Zykbyk/VACLAV/1. Zawieszenie/11. Kinematyka/Informacje/Zalety i wady większych felg i opon.jpg

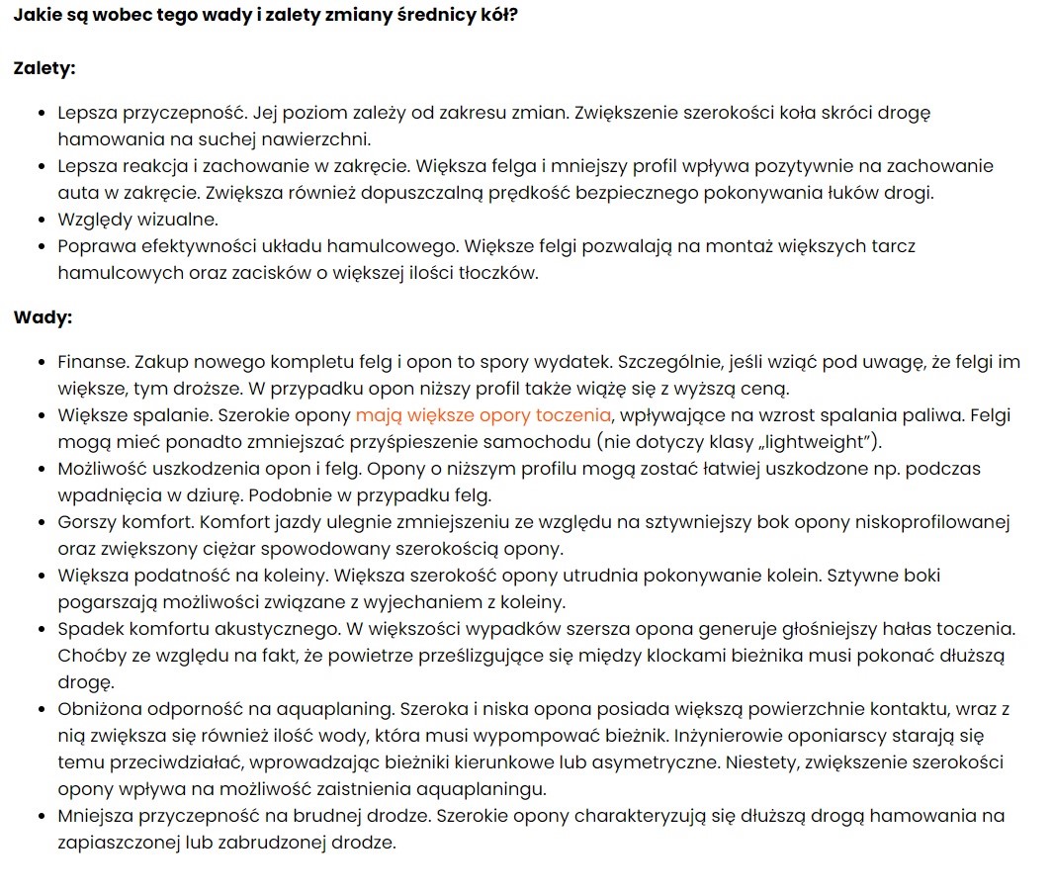
1. Zawieszenie/11. Kinematyka/Informacje/Zalety i wady większych felg i opon.jpg
