Zykbyk/VACLAV/1. Zawieszenie/11. Kinematyka/Informacje/Zbieżność.jpg

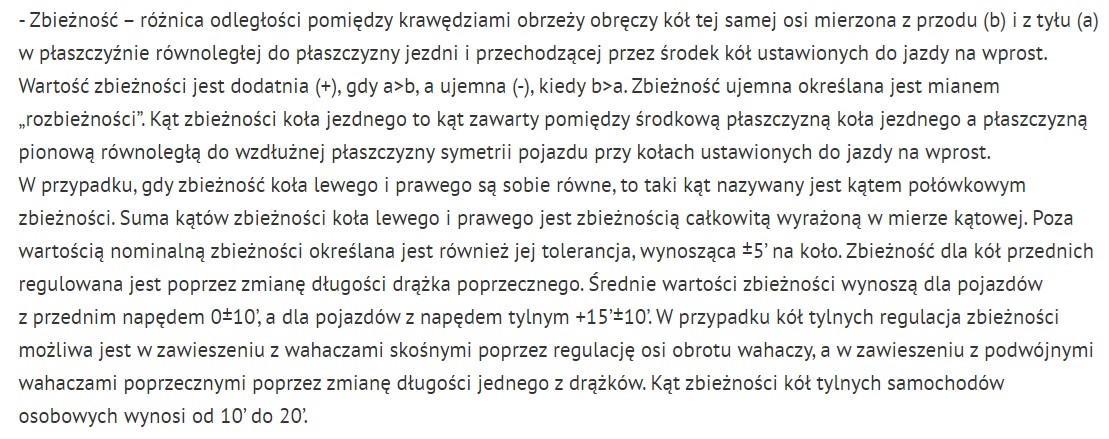
1. Zawieszenie/11. Kinematyka/Informacje/Zbieżność.jpg
