Zykbyk/VACLAV/10. Zgredek/_Archiwum/stara wersja (wahacze)/2023_10_04_Zawieszenie przód/Zawieszenie/Notatka.docx

https://allegro.pl/oferta/wahacz-przedni-dolny-gorny-prawy-lewy-quad-bashan-11277689814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

https://maxmoto.pl/produkt/61777-amortyzator-do-quada-atv-110cc-270mm-7mm
