Zykbyk/VACLAV/0. Instrukcje i inne ważne pliki/Dokumentacja KLARA/Załączniki/Podzespoły elektryczne/BatteryTechReport.pdf

# Battery Technical Report

Manufacturer’s battery specification sheet and Material Safety Data Sheet are in document: samsung-35e-datasheet-inr18650-35e.pdf

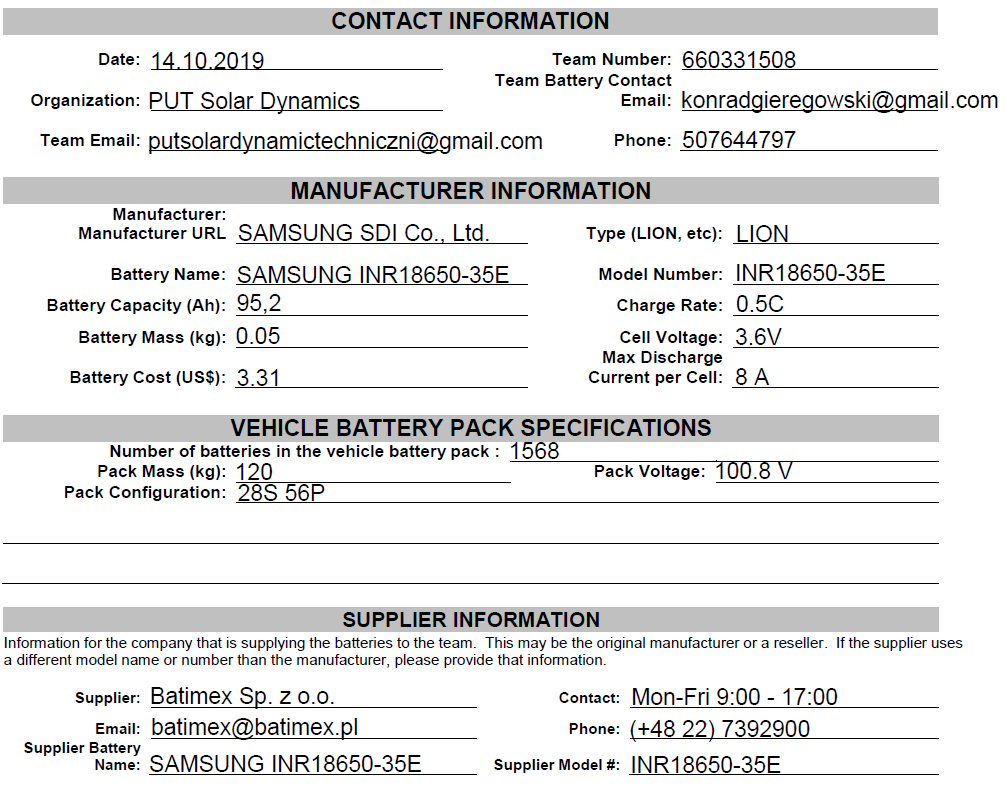
[picture p7: figure]

External layer made of steel, inner layer is a 1,5 cm thickness non-flammable and chemical resistive rubber protecting battery from each side. This rubber is hard material and will not flex under the pressure of the battery.

Car body is made from composite which is insulator so mounting metal battery enclosure to it with screws and nuts is safe.

Supplemental Battery is 12 V VRLA battery.

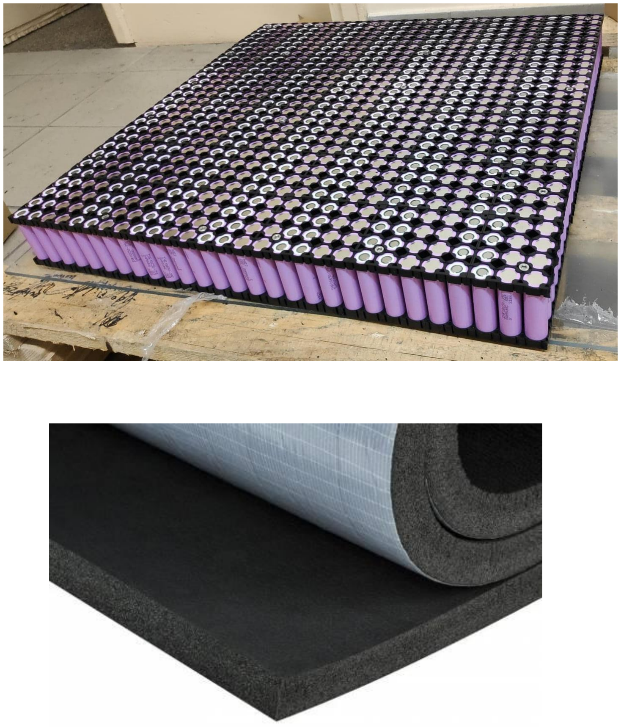
[picture p8: page 2]

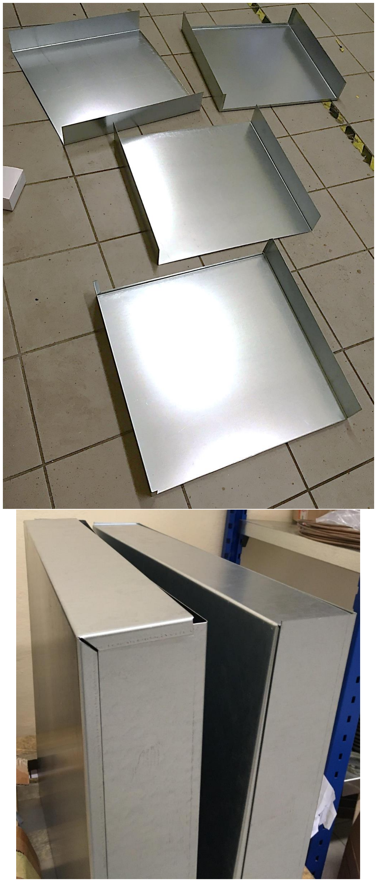
[picture p9: figure]
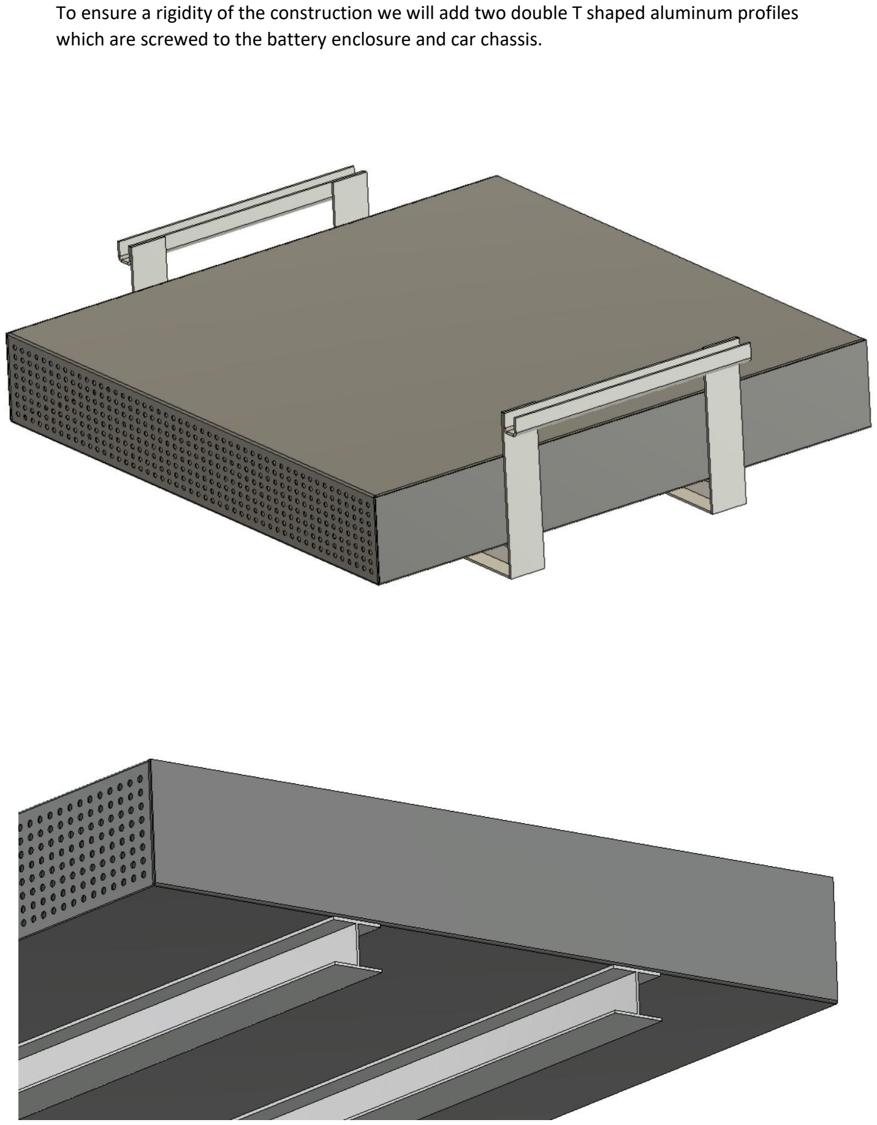
[picture p10: page 4]

To ensure a rigidity of the construction we will add two double T shaped aluminum profiles which are screwed to the battery enclosure and car chassis.
