Zykbyk/VACLAV/0. Instrukcje i inne ważne pliki/Tematy na prezentacje.pdf

Tematy do opracowania:

- Racing car basics:
- Środek masy
- Przeniesienie obciążenia
- Przypadek hamowania
- Omówić jakiś przykład obliczeń
- Skręcanie, siła dośrodkowa
- Racing car design issues
- Tyres:
- Rodzaje opon
- Budowa opony
- Nadsterowność
- Podsterowność
- Co to camber
- Brakes:
- Budowa układu hamulcowego
- Działanie układu hamulcowego
- Procedura projektowania
- Omówić przykład obliczeń
- Co to dive
