Zykbyk/VACLAV/1. Zawieszenie/11. Kinematyka/Kinematyka - obliczenia 31.xlsx

Sheet: 40%-60%
 | DANE
 | MASA AUTA [kg] | ROZSTAW OSI [m] | DŁUGOŚĆ AUTA [m] | ROZSTAW KÓŁ [m] | SZEROKOŚĆ AUTA [m] | PROMIEŃ SKRĘTU [m] | PRZEŚWIT MIĘDZY BRZUCHEM A ZIEMIĄ [m]
 | 400 | 2.6 | 4.2 | 1.5 | 1.75 | 7 | 0.125
 | KĄT ACKERMANA
Promień zawracania | R s [m] | 7 |  | 7.5 | 6.5 | 6 | 5.5 | 5
Średnica zawracania | D s [m] | 14 |  | 15 | 13 | 12 | 11 | 10
Promień zataczania -10mm | rσ [m] | -0.01 |  | -0.01 | -0.01 | -0.01 | -0.01 | -0.01
 | R s - rσ [m] | 7.01 |  | 7.51 | 6.51 | 6.01 | 5.51 | 5.01
 | sin δA,o | 0.37 |  | 0.35 | 0.40 | 0.43 | 0.47 | 0.52
 | δA,o [rad] | 0.38 |  | 0.35 | 0.41 | 0.45 | 0.49 | 0.55
Kąt Ackermana | δA,o [st] | 21.77 |  | 20.26 | 23.54 | 25.63 | 28.16 | 31.26
 | ctg δA,o | 2.50 |  | 2.71 | 2.30 | 2.08 | 1.87 | 1.65
 | ctg δi | 1.92 |  | 2.13 | 1.71 | 1.50 | 1.28 | 1.06
 | δi [rad] | 0.48 |  | 0.44 | 0.53 | 0.59 | 0.66 | 0.76
Kąt skrętu koła wewnętrznego | δi [st] | 27.52 |  | 25.20 | 30.31 | 33.70 | 37.92 | 43.26
Różnica kątów | ΔδA [st] | 5.75 |  | 4.94 | 6.77 | 8.07 | 9.76 | 12.00
Szerokość opony | B [m] | 0.185 |  | 0.185 | 0.185 | 0.185 | 0.185 | 0.185
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
