Zykbyk/VACLAV/1. Zawieszenie/11. Kinematyka/Informacje/Zużycie opon.pdf

# ZUŻYCIE OPON

NORMALNE

Występuje, gdy guma zużywa się w sposób jednolity, na całej szerokości i obwodzie.

NIESYMETRYCZNE (JEDNOSTRONNE)

Obserwuje się, gdy jedna strona bieżnika ściera się bardziej od drugiej, co wynika z nieprawidłowej zbieżności kół. Z biegiem czasu mogą narastać odchylenia od standardowych wartości, na przykład na skutek agresywnego wjeżdżania na krawężniki.

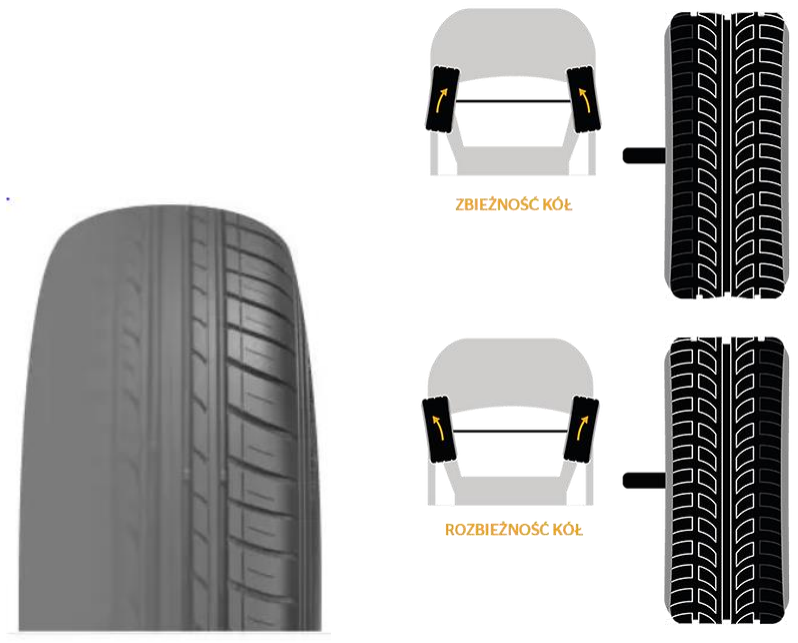
[picture p21: figure]

WKLĘSŁE

Dotyczy środka bieżnika, jest efektem jazdy na oponach ze zbyt dużym ciśnieniem. (https://www.opony.com.pl/artykul/zbyt-wysokie-cisnienie-w-oponach-szkodzi/?id=1139) Strefa kontaktu ograniczona jest do środkowej części bieżnika, co powoduje szybkie zużycie tej strefy. Może być to spowodowane np. nagłym hamowaniem na zablokowanych kołach w przypadku samochodów niewyposażonych w ABS (https://www.oponeo.pl/artykul/co-to-jest-abs) lub problemami z jakością danej opony. Taką postać zużycia spotyka się w kołach osi napędowej samochodów z mocnym silnikiem. Objawia się często przy energicznym przyspieszaniu i agresywnym stylu jazdy.

OKRĄGŁE

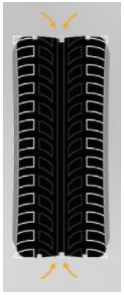
[picture p22: figure]
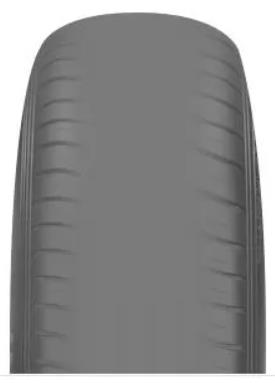
[picture p23: figure]

Okrągłe zużycie dotyczy barków i zachodzi, gdy wysokość bieżnika na środku jest wyższa, niż na barkach. Ten rodzaj zużycia wynika zazwyczaj z długiego czasu użytkowania opony, która posiadała zbyt niskie ciśnienie przy zbyt dużym obciążeniu. W takim przypadku ugina się czoło opony, a barki zaczynają przejmować obciążenie, co prowadzi do ich szybkiego starcia. Powodem takiego stanu rzeczy może być też zbyt agresywny styl jazdy, szczególnie szybkie pokonywanie zakrętów.

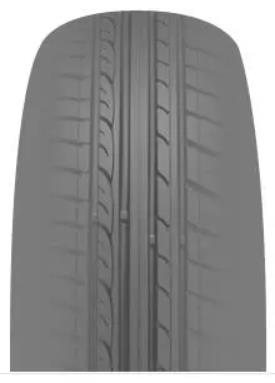
[picture p24: figure]

### Ciśnienie a zużycie opony

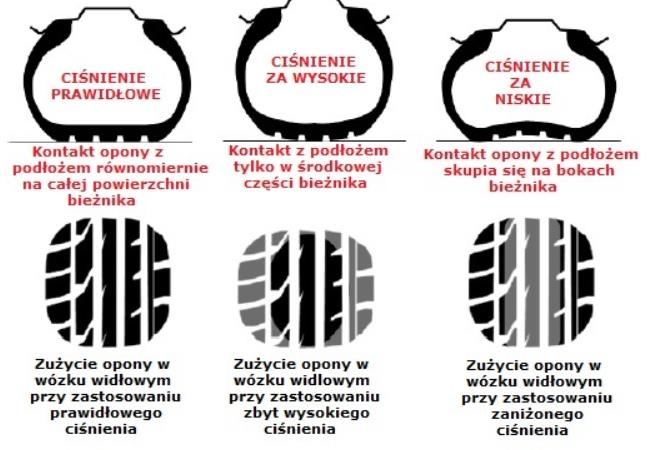
[picture p25: figure]

MIEJSCOWE

Miejscowe zużycie opony często jest efektem gwałtownych manewrów np. hamowania. W takich przypadkach szybko zużywa się fragment obwodu opony.

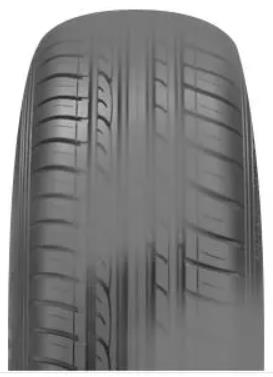
[picture p26: figure]

ZĄBKOWANE

Wiele opon nosi ślady zużycia ząbkowanego, wynikającego z nierównomiernego ścierania się klocków bieżnika. Ten rodzaj zużycia jest charakterystyczny dla tylnej osi samochodów a wynika ze zmian nacisków i pracy bieżnika w czasie jazdy oraz pokonywania zakrętów. Zajście zużycia ząbkowanego jest w zasadzie nieuniknione, ale jego natężenie zależy od kilku czynników:

- Od dopasowania opony do danego modelu samochodu o konkretnym typie zawieszenia
- Od obciążenia pojazdu i ciśnienia w oponach
- Od niekompatybilnych indeksów nośności i prędkości
- Od stanu technicznego zawieszenia
- Zbieżność i kąt pochylenia kół

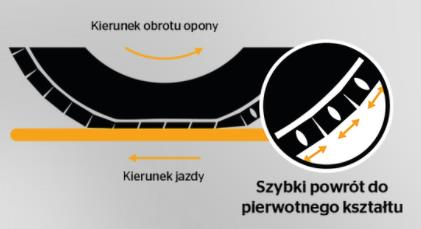
[picture p27: figure]
