Zykbyk/VACLAV/1. Zawieszenie/11. Kinematyka/Informacje/Prezentacja 2 Slip.pdf

# Vehicle Dynamics

# Modelling and Simulation

## CHAPTER 10.1

# Liniowy model jednośladowy

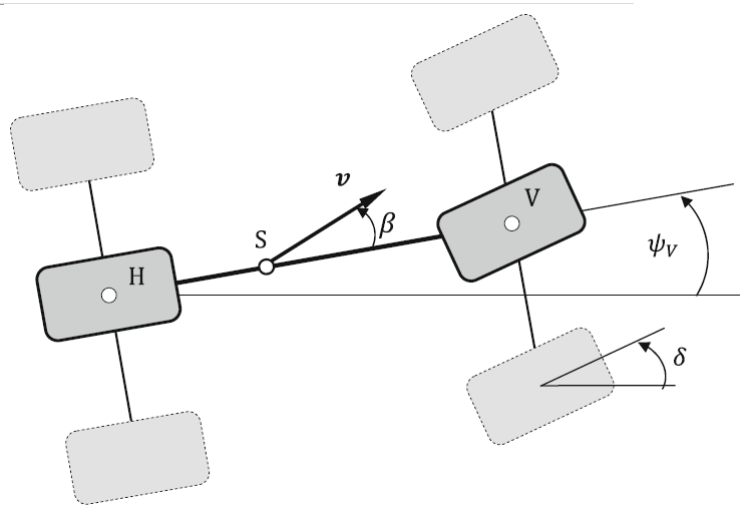
[picture p33: figure]

Stała prędkość środka ciężkości

Ruch toczny pominięty

Masa w środku ciężkości

Przednie i tyle opony jako jedna opona na środku każdej z osi

Moment obrotowy wynikający z kąta poślizgu pominięty

Siły wzdłużne w oponach pominięte

# Zależności

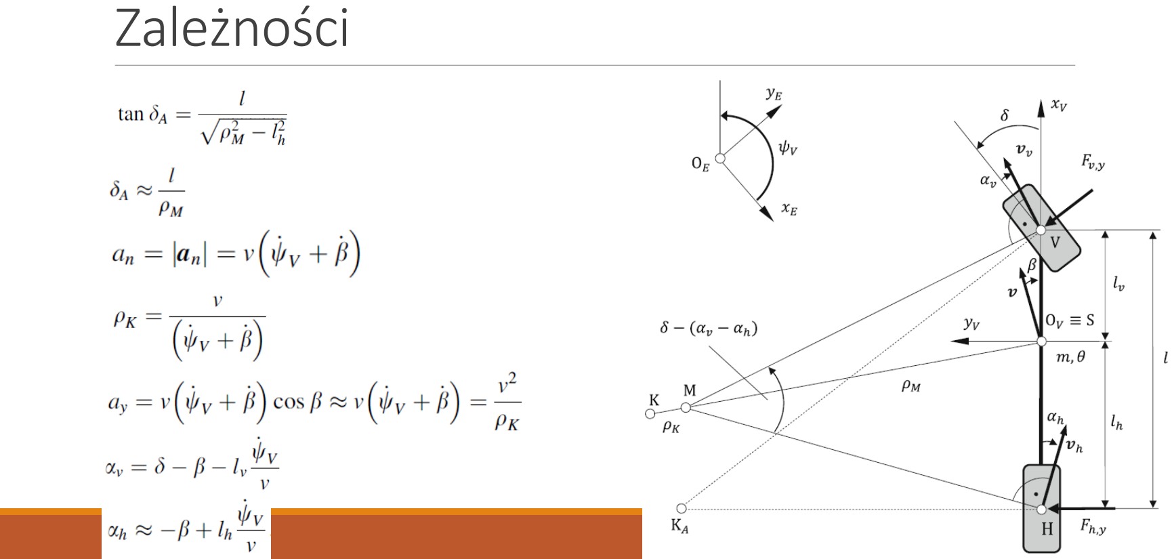
[picture p34: page 3]

# Obciążenia opon

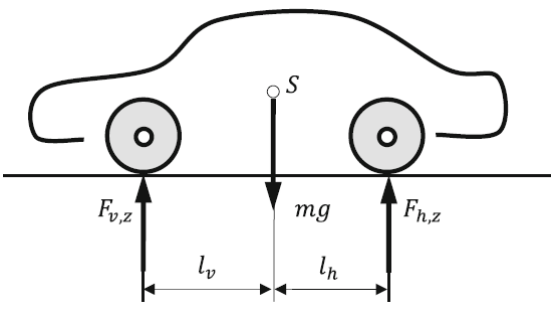
[picture p35: figure]

# Równania ruchu modelu

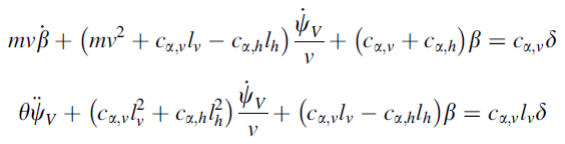
[picture p36: figure]

# Pokonywanie zakrętów

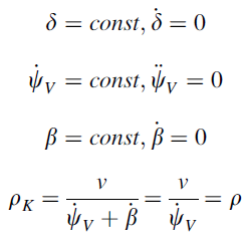
[picture p37: figure]

# Sterowność

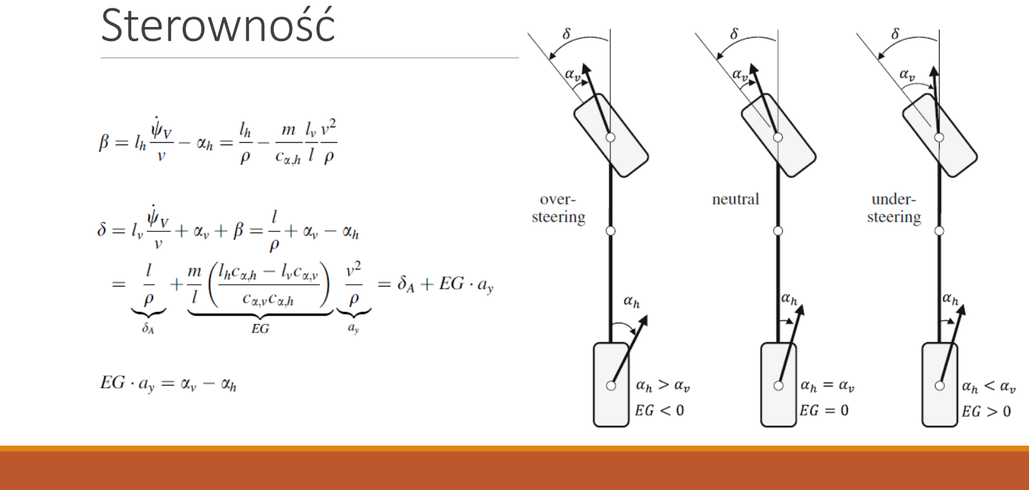
[picture p38: page 7]

# Zależności

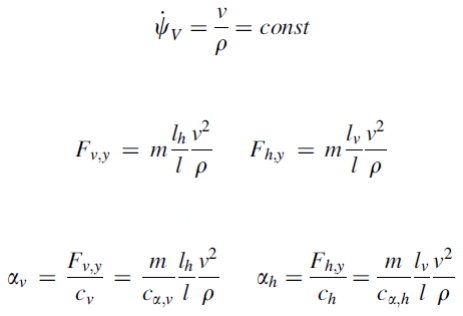
[picture p39: figure]
