Zykbyk/VACLAV/1. Zawieszenie/11. Kinematyka/Informacje/Racing car basics Prezentacja 1.pdf

# Kinematyka

Autorzy:
Tomasz Cichowski
Piotr Dzioba

# Rozstaw osi

- Mierzony od środka osi przedniej do środka osi tylnej
- Większy rozstaw osi w stosunku do długości pojazdu:

☐ więcej miejsca dla pasażerów

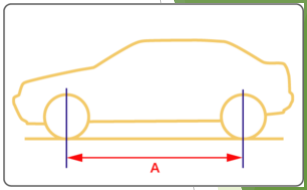
[picture p40: figure]

☐ mniejszy jest przy tym wpływ zmian obciążenia na rozkład masy przypadającej na
| poszczególne osie

☐ mniejszy jest przedni i tylny zwis nadwozia

☐ mniejsza tendencja do przechyłów wzdłużnych

☐ możliwe zastosowanie bardziej miękkiego zawieszenia w celu zwiększenia
| komfortu jazdy
- Mniejszy rozstaw osi poprawia zwrotność – przy takim samym kącie skrętu kół uzyskuje się mniejszy promień skrętu

# Rozstaw osi

- Dąży się do uzyskania większego rozstawu osi
- Zależne jest to od formy nadwozia
- Samochód o nadwoziu kombilimuzyny z pochyłą ścianą tylną – bardziej zwarta budowa i może mieć większy rozstaw osi w stosunku do swej długości niż samochód o nadwoziu sedan lub pochodnym od niego kombi
- Parametr porównawczy il

il =

rozstaw osi
długość pojazdu
- Powinien być jak największy i wynosić:

☐ 0,57 do 0,67 dla samochodów typu kombilimuzyna

☐ 0,56 do 0,61 dla samochodów typu sedan
- Dla nadwozia typu coupé il może być nawet mniejsze od 0,56
- Dla samochodów małych il osiąga wartości do 0,72
- Wartości rozstawu osi mieszczą się zwykle w przedziale l = 2160 do 3040 mm

# Rozstaw kół

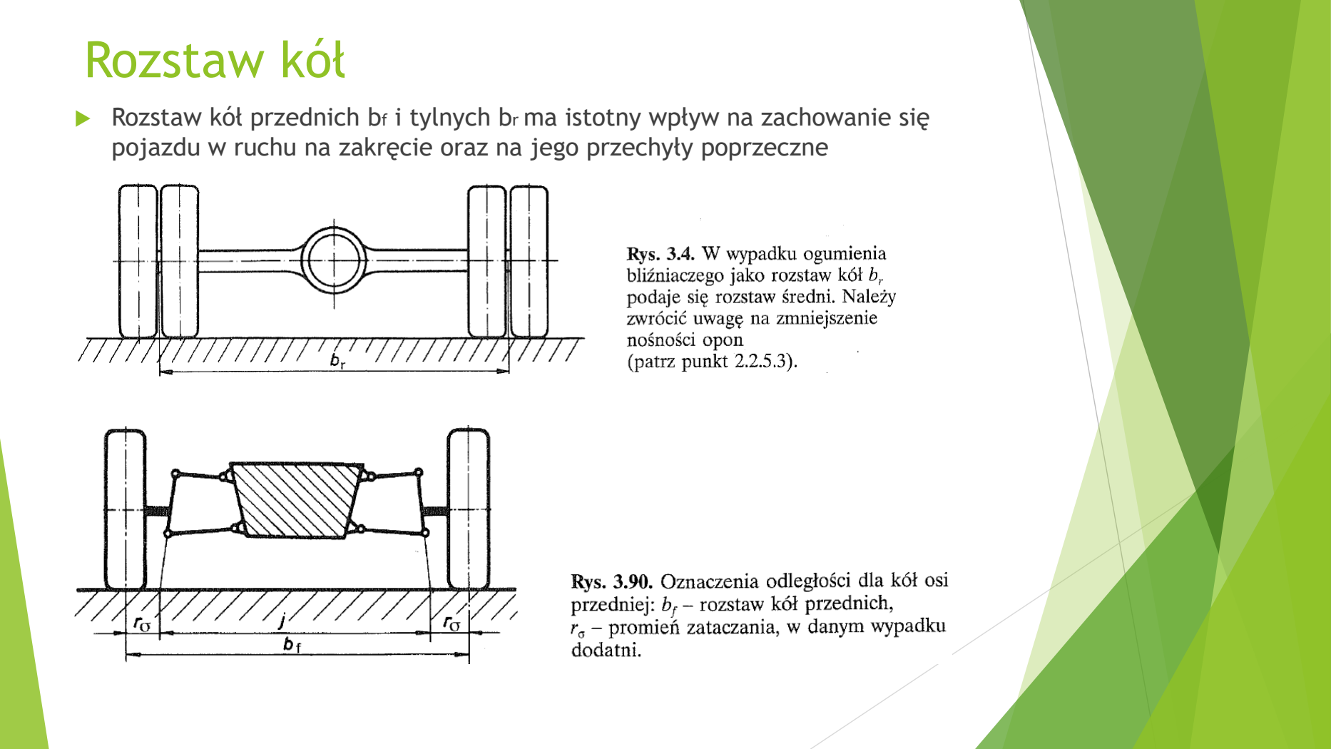
[picture p41: page 4]

- Rozstaw kół przednich bf i tylnych br ma istotny wpływ na zachowanie się pojazdu w ruchu na zakręcie oraz na jego przechyły poprzeczne

# Rozstaw kół

- Powinien być jak największy, jednak w stosunku do szerokości pojazdu nie powinien przekraczać pewnej określonej wartości
- Jeśli chodzi o koła przednie, to przy pełnym ugięciu zawieszenia i maksymalnym skręcie nie powinny one wchodzić w kolizję z błotnikami
- Rozstaw kół w samochodach osobowych wynosi zwykle bf lub r = 1210 do 1602mm
- Jako wskaźnik wykorzystania szerokości służy współczynnik ib, który powinien być jak największy

ib =

rozstaw kół
szerokość pojazdu

= 0,84 do 0,87

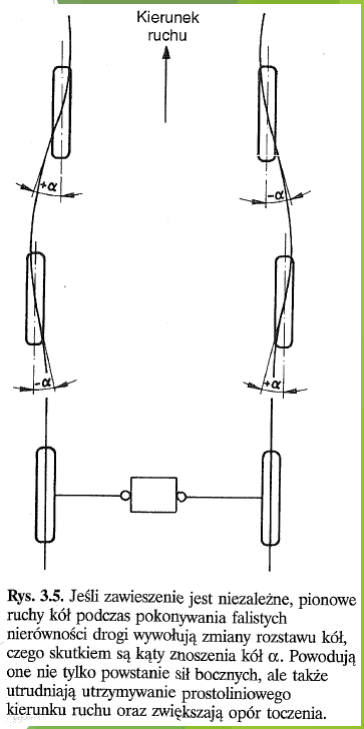
[picture p42: figure]

# Rozstaw kół

- Pionowe ruchy kół wywołują zmiany rozstawu kół w zawieszeniach niezależnych
- Zmiany te prowadzą do:

☐ bocznego znoszenia opon

☐ powstania sił bocznych, zwiększających opór toczenia, utrudniających utrzymanie prostoliniowego kierunku ruchu i wpływających na pracę układu kierowniczego

# Rozstaw kół

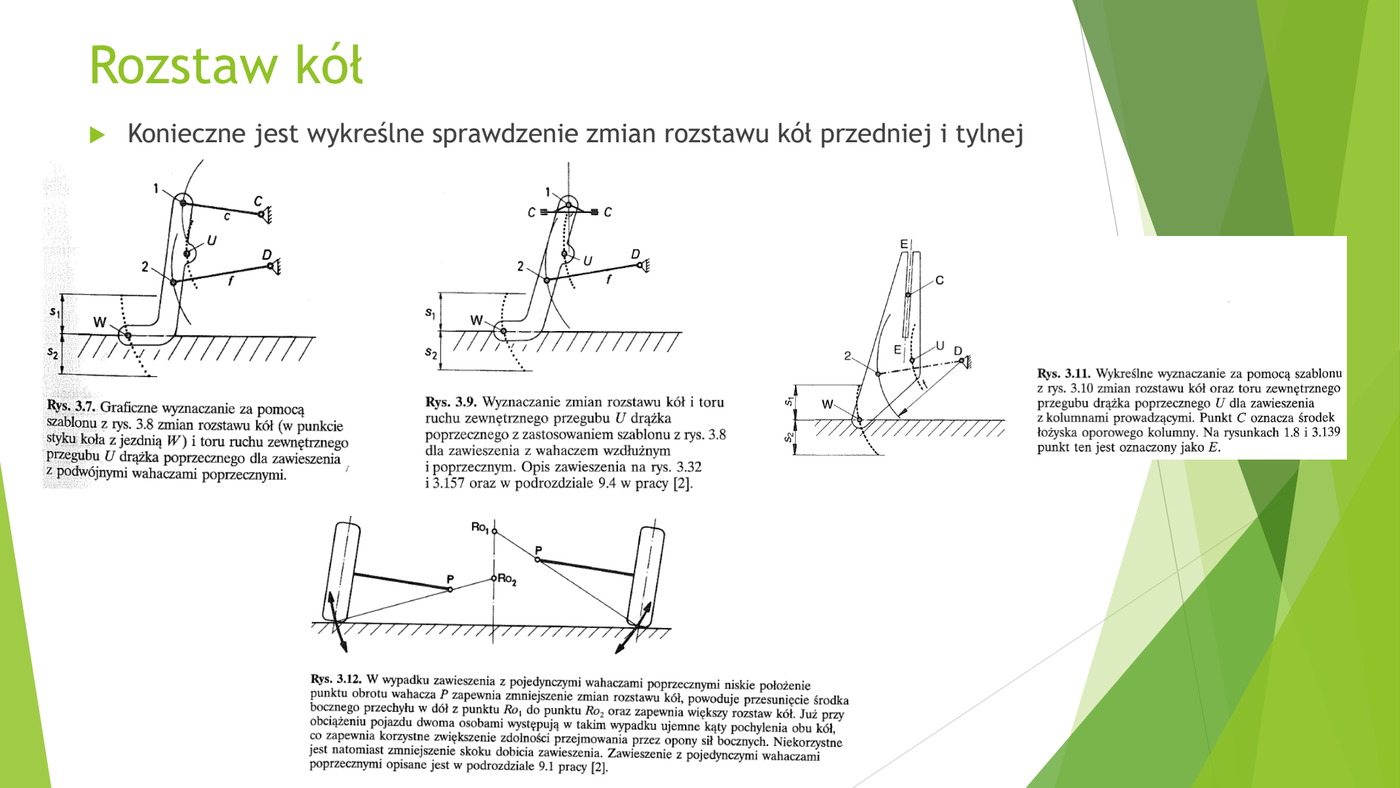
[picture p43: page 7]

- Konieczne jest wykreślne sprawdzenie zmian rozstawu kół przedniej i tylnej

# Kąt pochylenia kół

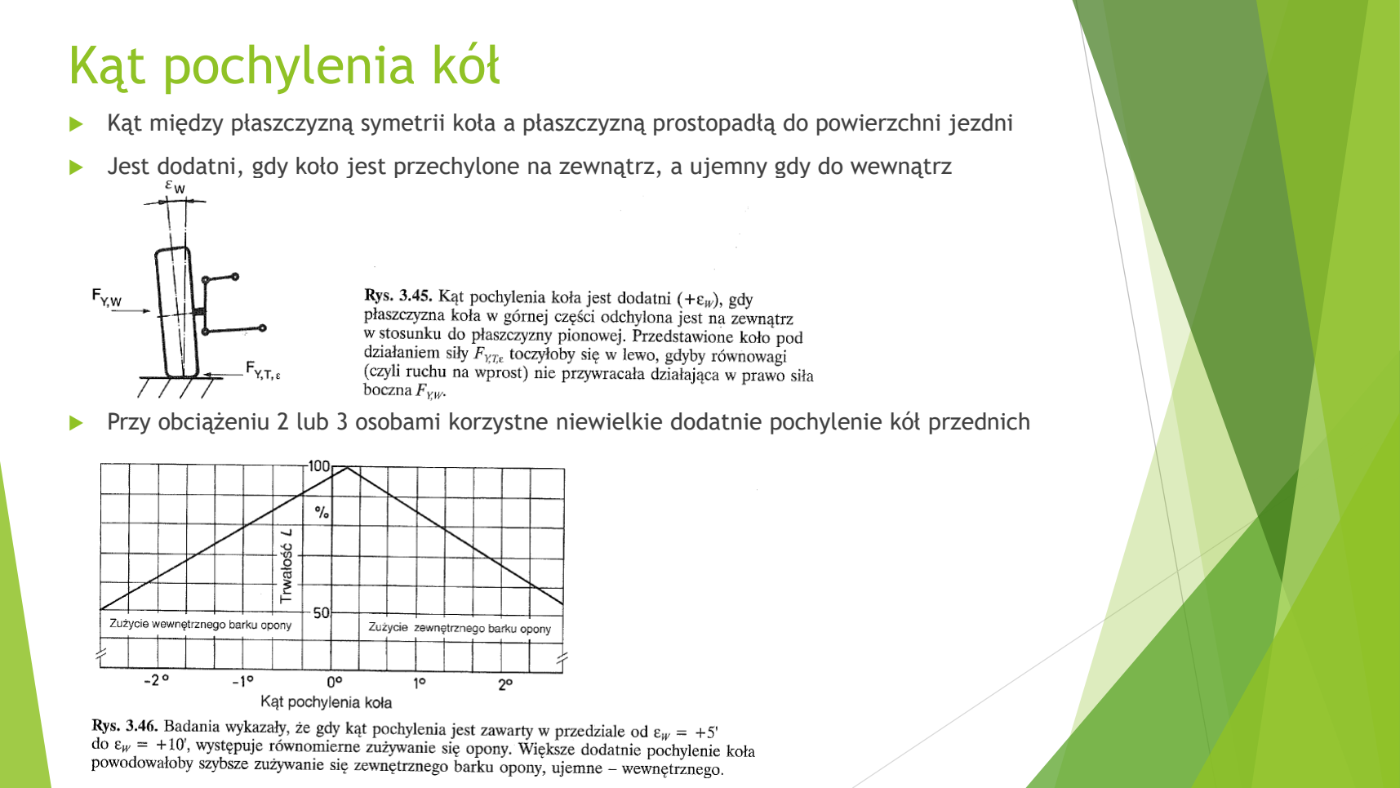
[picture p44: page 8]

- Kąt między płaszczyzną symetrii koła a płaszczyzną prostopadłą do powierzchni jezdni
- Jest dodatni, gdy koło jest przechylone na zewnątrz, a ujemny gdy do wewnątrz
- Przy obciążeniu 2 lub 3 osobami korzystne niewielkie dodatnie pochylenie kół przednich

# Kąt pochylenia koła

- W celu lepszych własności prowadzących opon na zakręcie (poprawa kierowalności) zwykle odchodzi się od tych wartości
- W samochodach osobowych nie obciążonych przewiduje się ujemne kąty pochylenia kół
- Podaje się wartość nominalną kąta pochylenia koła oraz tolerancję (dopuszczalne odchyłki od zalecanej wartości, dopuszczalna różnica między kątem pochylenia koła prawego i lewego)
- Zwykle przyjmuje się odchyłki ±30’ (pozwala na ekonomiczną produkcję części zawieszenia przedniego)
- Różnica kątów pochylenia osi zwrotnic koła lewego i prawego nie powinna być większa niż Δσ=30’ (uniknięcie ściągania w bok podczas jazdy na wprost)
- Różnica katów pochylenia kół nie powinna przekraczać 30’
- Na rysunku zespołu przedniego zawieszenia może być przykładowo podane:

kąt pochylenia koła -40’ ± 30’

maksymalna różnica między lewym i prawym kołem 30’

# Kąt pochylenia koła

- W zawieszeniach tylnych niezależnych oraz z wahaczami sprzężonymi stosuje się ujemne kąty pochylenia kół (poprawa własności prowadzących opon)
- Jako średnie wartości tych kątów w stanie nie obciążonym przyjmuje się:

kąt pochylenia koła -1º30’ ± 20’

maksymalna różnica pomiędzy lewym i prawym kołem 20’

- W tym wypadku istnieje możliwość regulacji, co pozwala na stosowanie węższych tolerancji
- W przypadku zawieszenia z wahaczami skośnymi istnieje niebezpieczeństwo wystąpienia zbyt dużych ujemnych kątów pochylenia kół w pojeździe całkowicie obciążonym
- Prowadzi to do nadmiernego nagrzewania się opon i zużywania bieżnika
- Producenci starają się zmniejszyć zmiany kątów pochylenia kół wynikające z kinematyki poprzez zmianę kątów α i β osi obrotu wahaczy

# Kąt skrętu kół

- Kąty skrętu koła przedniego wewnętrznego δi i zewnętrznego δA,o powinny być różne
- | Kąt Ackermanna: | ctgδA,o = ctgδi + j/l
| l – rozstaw osi

j – mierzona na powierzchni jezdni odległość linii będących przedłużeniami osi obrotu
| zwrotnic:
j = bf − 2rσ | (jeżeli rσ ujemne to we wzorze jest +)

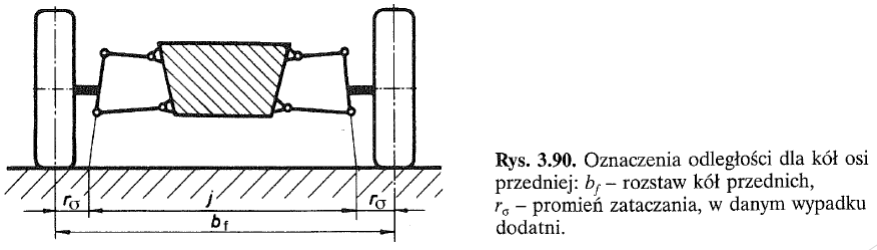
[picture p45: figure]

# Kąt skrętu kół

- Różnica kątów skrętu kół ΔδA powinna być zawsze dodatnia

ΔδA = δi − δA,o

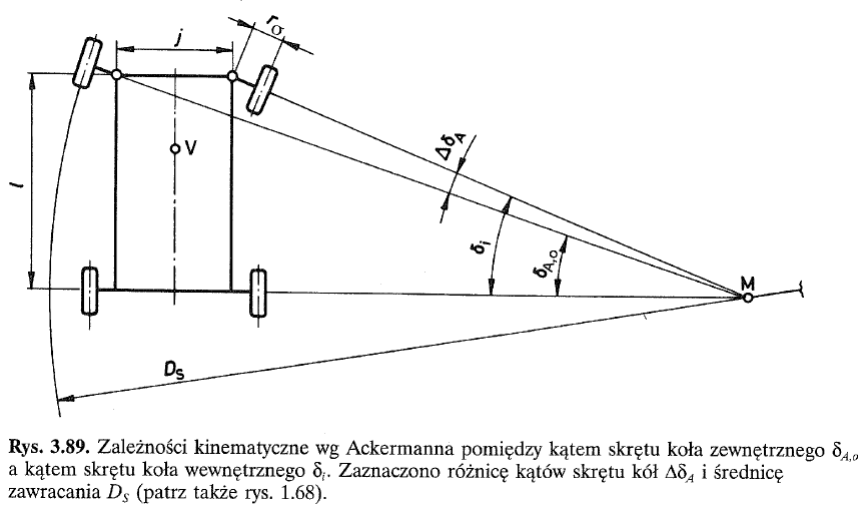
[picture p46: figure]

- Teoretyczna średnica zawracania

Ds = 2

1
sinδA,o

+ rσ

- Mniejszy okrąg zawracania – lepsza zwrotność i łatwiejsze parkowanie

# Środek przechyłu bocznego

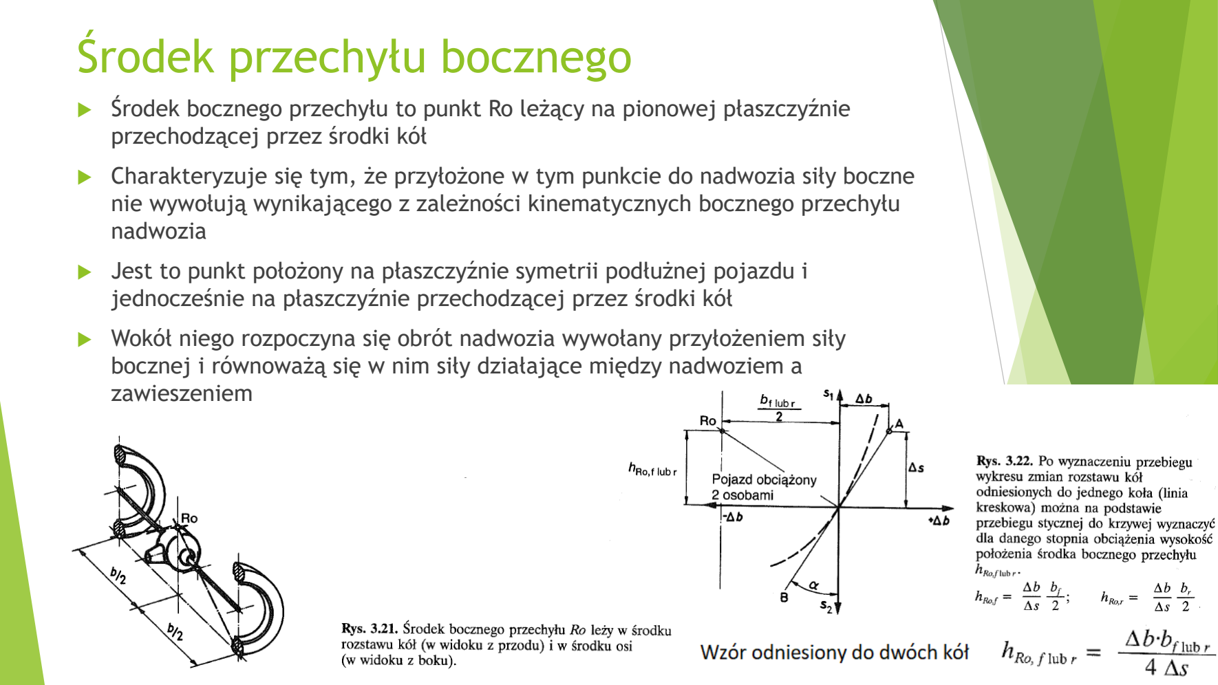
[picture p47: page 13]

- Środek bocznego przechyłu to punkt Ro leżący na pionowej płaszczyźnie przechodzącej przez środki kół
- Charakteryzuje się tym, że przyłożone w tym punkcie do nadwozia siły boczne nie wywołują wynikającego z zależności kinematycznych bocznego przechyłu nadwozia
- Jest to punkt położony na płaszczyźnie symetrii podłużnej pojazdu i jednocześnie na płaszczyźnie przechodzącej przez środki kół
- Wokół niego rozpoczyna się obrót nadwozia wywołany przyłożeniem siły bocznej i równoważą się w nim siły działające między nadwoziem a zawieszeniem

# Oś przechyłu bocznego

- Linia łącząca środki bocznego przechyłu przedniego i tylnego zawieszenia

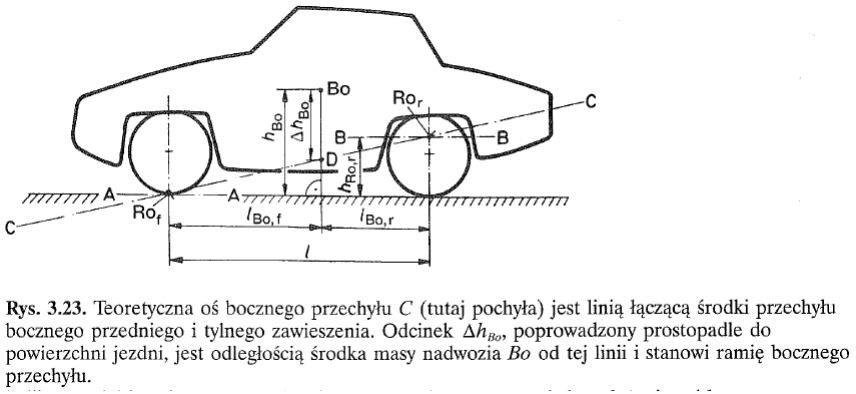
[picture p48: figure]

# Wysokość położenia środków bocznego przechyłu

- Wysokość położenia środków bocznego przechyłu i zmiany położenia tych punktów w zależności od pionowych przemieszczeń kół jest wynikiem następujących wymagań:

☐ założonych zmian pionowych obciążeń kół przy jeździe po zakręcie (uzyskanie korzystnej charakterystyki sterowności)

☐ nie wpływających niekorzystnie na dynamikę ruchu zmian rozstawu kół przy ich przemieszczeniach pionowych
☐ nie pogarszającej komfortu sztywności kątowej zawieszenia

☐ korzystnych zmian kątów pochylenia kół

☐ możliwie małych sił przekazywanych na nadwozie

☐ położenia osi bocznego przechyłu
- Oś przechyłu bocznego powinna unosić się ku tyłowi, co pozwala wykorzystać część tłumienia zawieszenia do tłumienia ruchu obrotowego pojazdu
- Wysokości położenia środków bocznego przechyłu zawieszeń niezależnych:

☐ z przodu h = 30 do 100 mm

☐ z tyłu h = 60 do 130 mm

# Skok zawieszenia

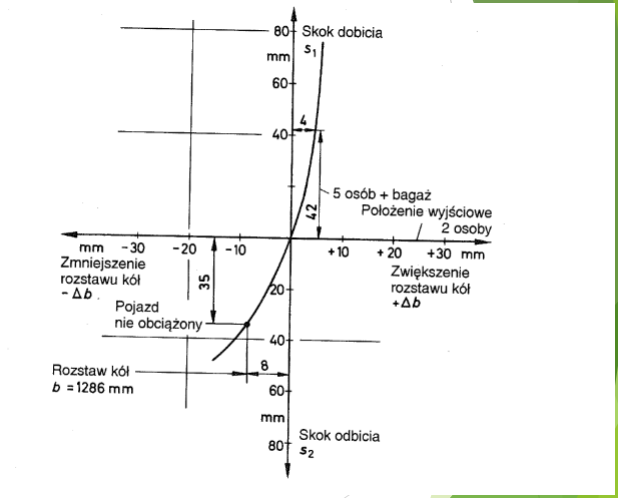
[picture p49: figure]

- Skok zawieszenia charakteryzujemy poprzez skok odbicia oraz skok dobicia zawieszenia.
- Wartości zależne są od rozstawu kół oraz od obciążenia pojazdu.
- Położenie zerowe wyznacza się dla obciążenia konstrukcyjnego.

# Kąt pochylenia osi zwrotnicy, a promień

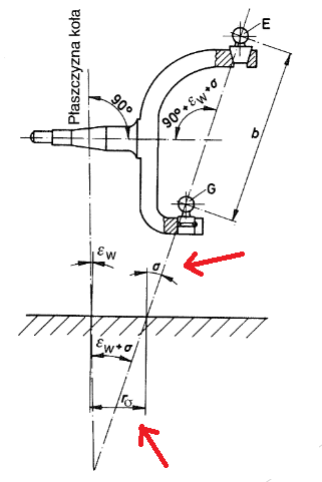
[picture p50: figure]

# zataczania

- Według normy DIN 70 000 kąt pochylenia osi zwrotnicy to kąt, który oś zwrotnicy EG tworzy z płaszczyzną prostopadłą do powierzchni jezdni.
- Promień zataczania – odległość punktu przecięcia powierzchni jezdni przez oś zwrotnicy od linii przecięcia płaszczyzny symetrii koła z powierzchnią jezdni.
- Dla nowoczesnych samochodów kąt pochylenia osi zwrotnicy wynosi od 11° do 15°30’.
- Promień oscyluje od -18 do +20mm.

# Kąt wyprzedzenia osi zwrotnicy oraz odcinek wyprzedzenia

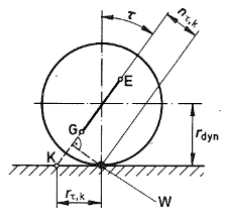
[picture p51: figure]

- Według normy DIN 70 020 oraz DIN 70 000 jest to kąt pomiędzy rzutem osi zwrotnicy EG na płaszczyznę xz oraz linią pionową poprowadzoną przez oś koła.
- Odcinek wyprzedzenia osi zwrotnicy – odcinek między punktami K oraz W na powierzchni jezdni.

# Położenie środka ciężkości

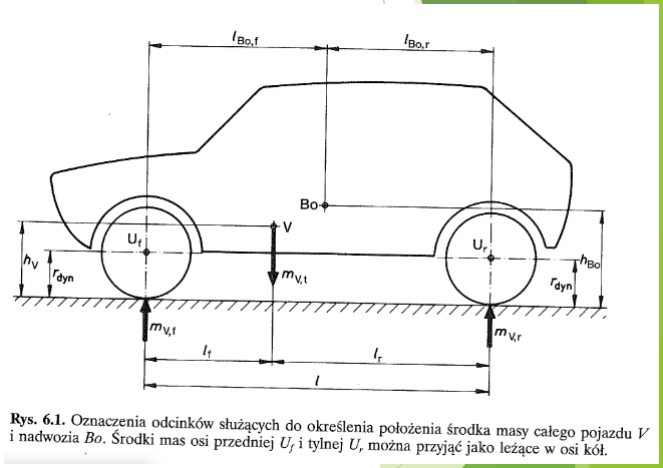
[picture p52: figure]

- Wyróżniamy: położenia środka masy pojazdu (V) oraz środka masy nadwozia (Bo).
- Obie wartości w głównej mierze zależą od obciążenia pojazdu, a ich położenie zmienia się wzdłuż pojazdu (oś x) oraz w górę (oś z).
- Przykład: zwiększenie obciążenia powoduje ugięcie zawieszenia (obniżenie położenia środka masy nadwozia Bo), natomiast środki mas pasażerów leżą znacznie wyżej niż środek masy nadwozia (zwiększenie wysokości położenia środka masy całego pojazdu - ℎv).

# Po co znać środek masy?

Znajomość odległości położenia środków masy V oraz Bo od przedniej i tylnej osi oraz ich wysokości nad powierzchnią jezdni jest konieczne do:

- oceny zachowania pojazdu podczas hamowania i przyspieszenia,
- obliczenia zdolności pokonywania wzniesień,
- projektowania układów hamulcowych i układów napędu czterech kół,
- projektowaniu zawieszeń i analizowaniu drgań,
- badaniu stateczności ruchu,
- wyznaczaniu masowych momentów bezwładności.

# Droga hamowania

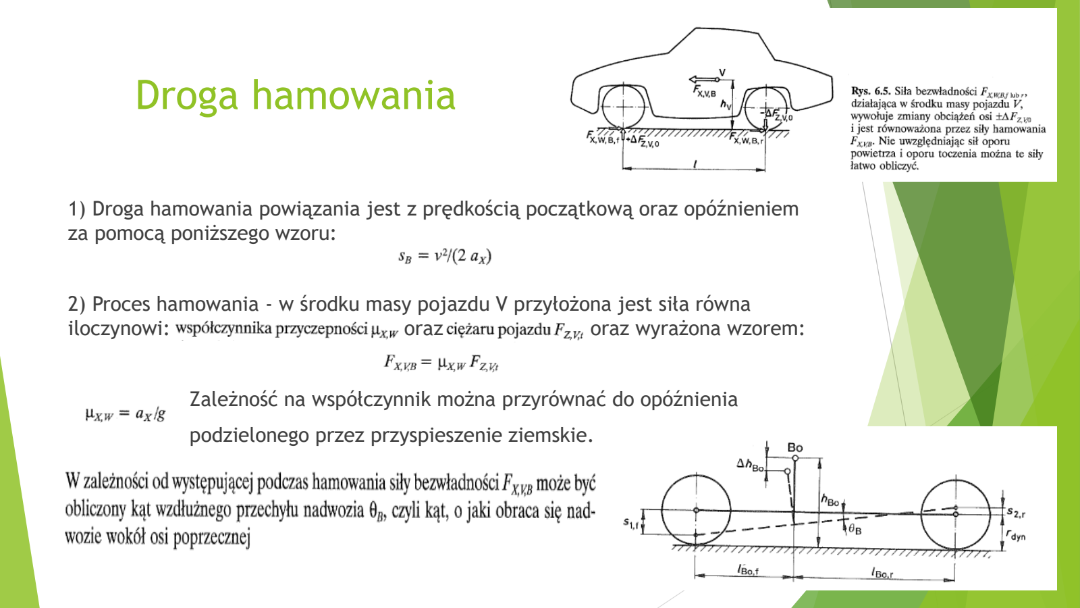
[picture p53: page 21]

1) Droga hamowania powiązania jest z prędkością początkową oraz opóźnieniem za pomocą poniższego wzoru:
2) Proces hamowania - w środku masy pojazdu V przyłożona jest siła równa
iloczynowi: | oraz | oraz wyrażona wzorem:

Zależność na współczynnik można przyrównać do opóźnienia

podzielonego przez przyspieszenie ziemskie.
