Zykbyk/VACLAV/1. Zawieszenie/11. Kinematyka/Informacje/Racing car basics Prezentacja 2.pdf

Siła tarcia

- Trakcja, przyczepność
- Siła tarcia = obciążenie normalne ∗ współczynnik tarcia

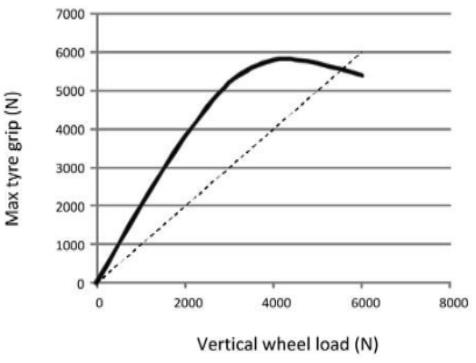
[picture p54: figure]
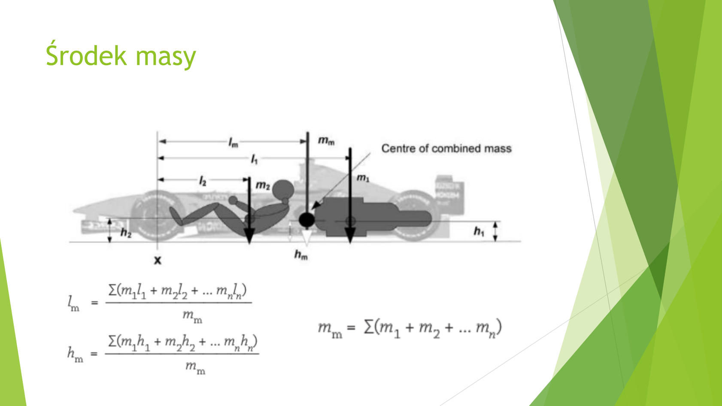
[picture p55: page 2]

Środek masy

Obciążenia statyczne kół

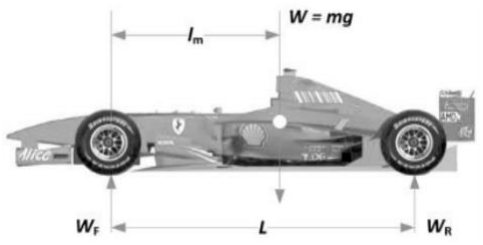
[picture p56: figure]
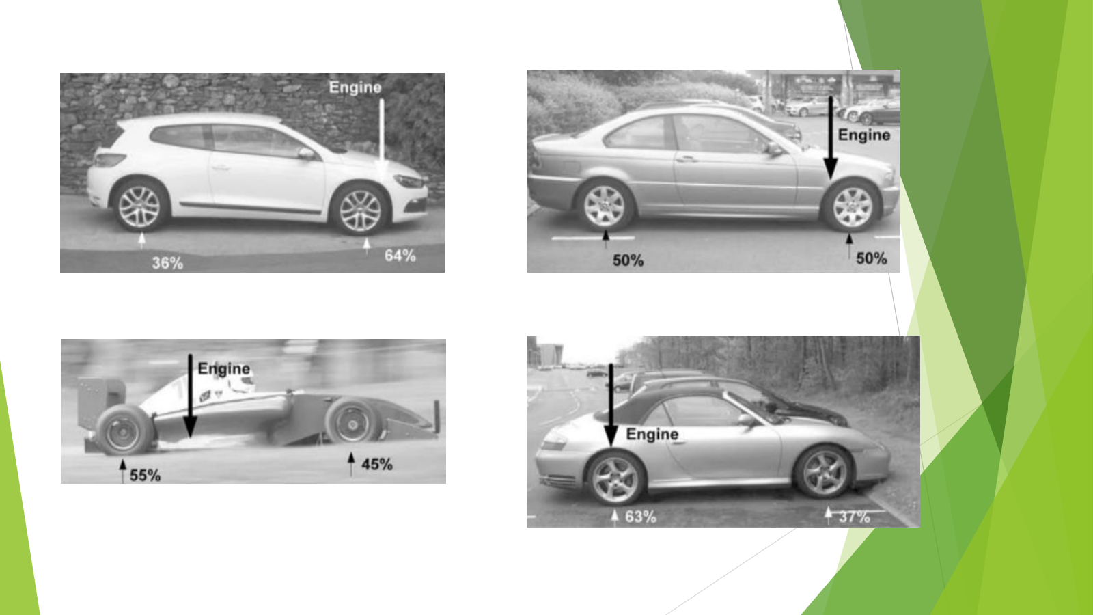
[picture p57: page 4]

Przyspieszenie liniowe i przenoszenie obciążenia wzdłużnego

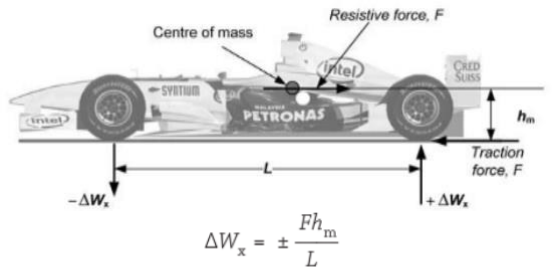
[picture p58: figure]

Przyspieszenie ograniczone przez tarcie

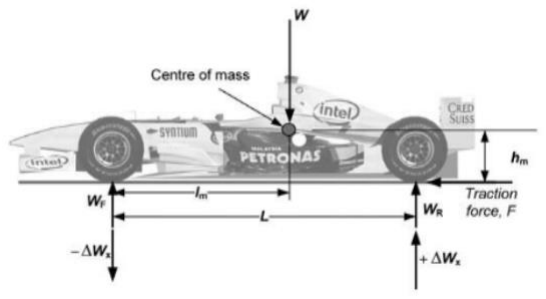
[picture p59: figure]

Przyspieszenie ograniczone mocą silnika

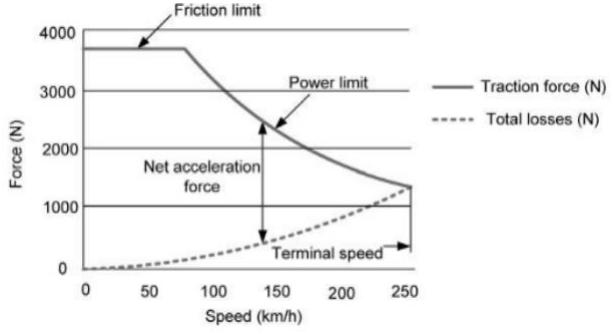
[picture p60: figure]

Hamowanie i obciążenia wzdłużne

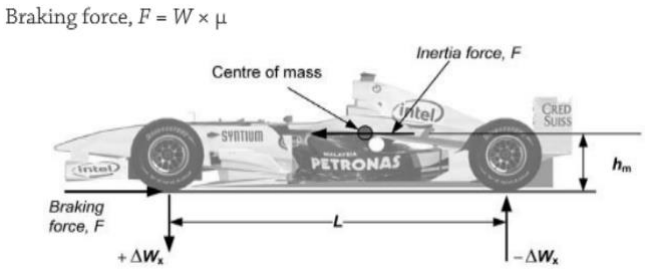
[picture p61: figure]

Pokonywanie zakrętów i obciążenia poprzeczne

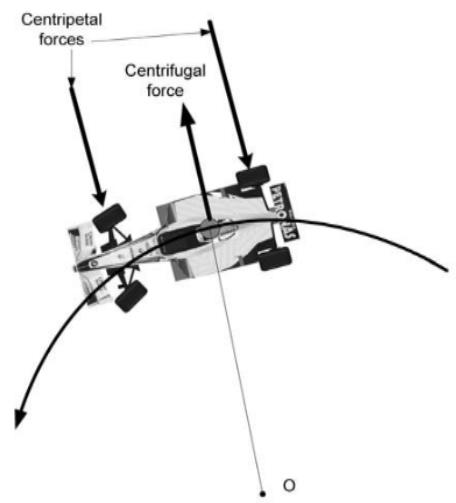
[picture p62: figure]

Pokonywanie zakrętów i obciążenia poprzeczne

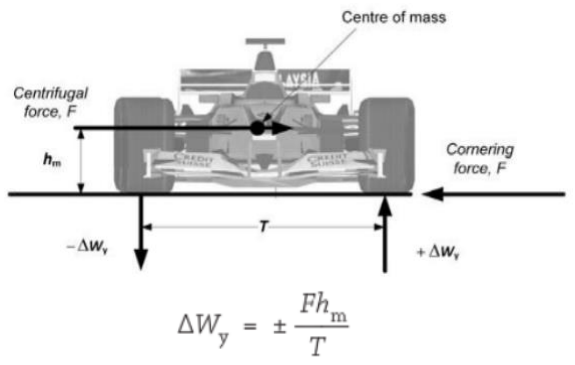
[picture p63: figure]

Docisk aerodynamiczny

- Hamowanie:

☐ Pozwala na szybsze hamowanie z dużych prędkości

☐ Powoduje większe obciążenia na kołach

- Pokonywanie zakrętów:

☐ Pozwala pokonać zakręt z większą prędkością

☐ Powoduje większe obciążenia

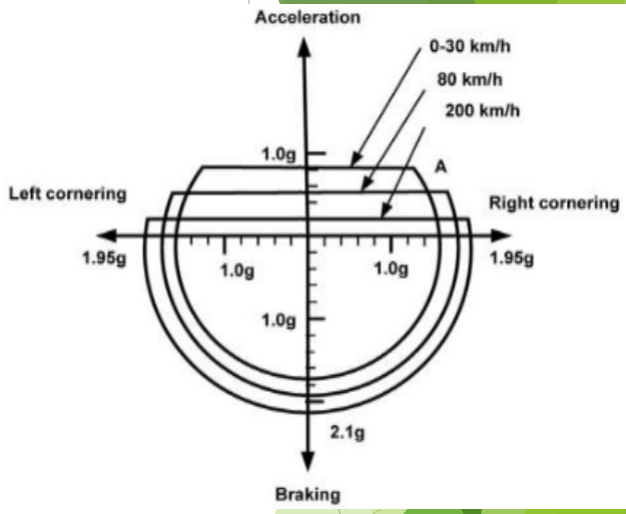
[picture p64: figure]

- Siła docisku rośnie wraz ze wzrostem prędkości, co prowadzi do powstania siły oporu, która ogranicza możliwości silnika do rozpędzania pojazdu
