Zykbyk/VACLAV/1. Zawieszenie/11. Kinematyka/Aktualne ustawienie/Anti-geometries 30.06.21.jpg

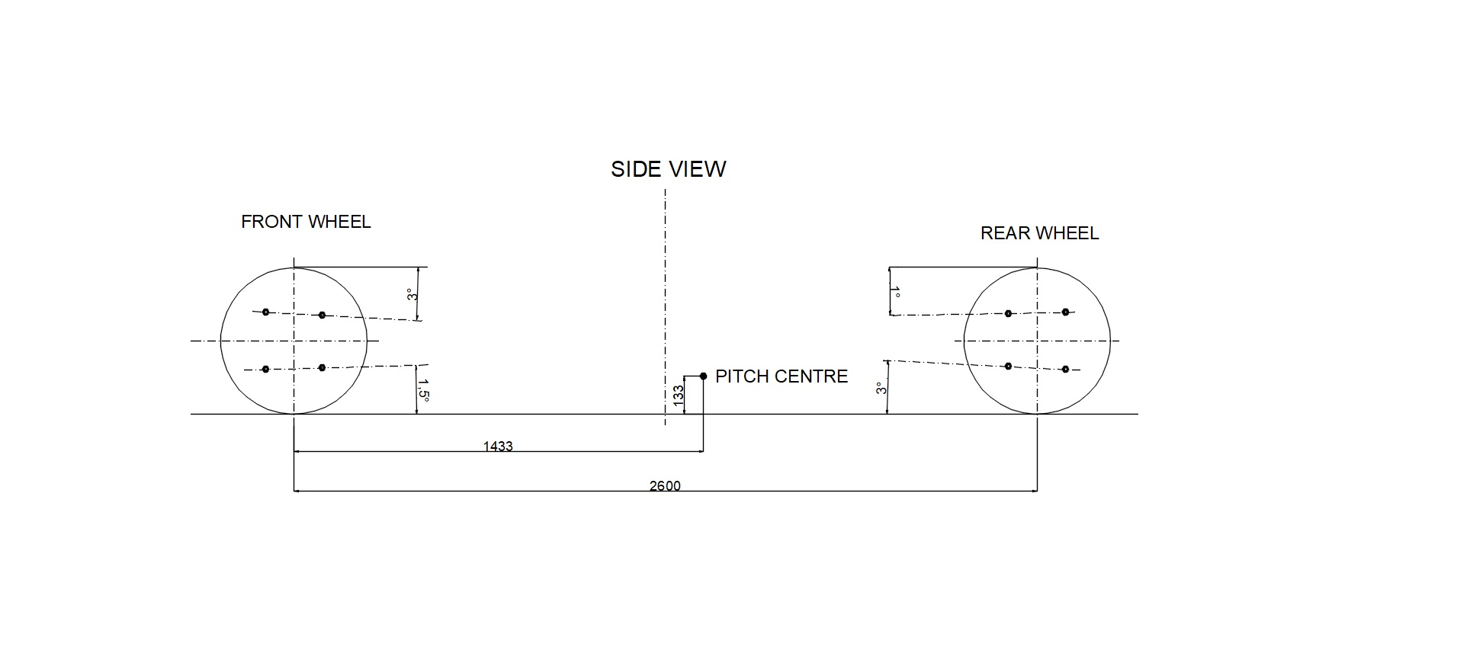
1. Zawieszenie/11. Kinematyka/Aktualne ustawienie/Anti-geometries 30.06.21.jpg
