Zykbyk/VACLAV/1. Zawieszenie/11. Kinematyka/Aktualne ustawienie/Caster angle 07.07.21.jpg

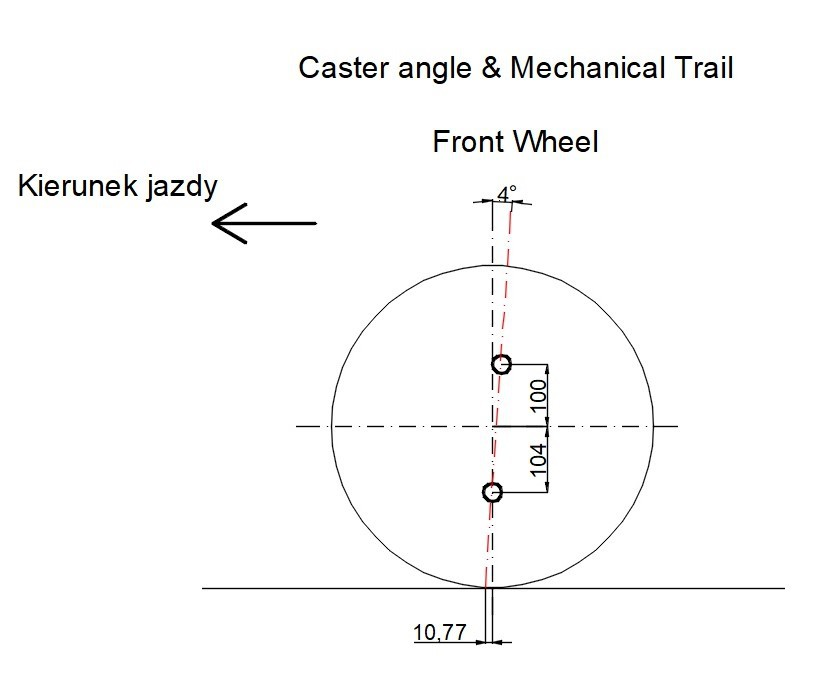
1. Zawieszenie/11. Kinematyka/Aktualne ustawienie/Caster angle 07.07.21.jpg
