Zykbyk/VACLAV/1. Zawieszenie/11. Kinematyka/Aktualne ustawienie/Front roll centre 09.06.21.jpg

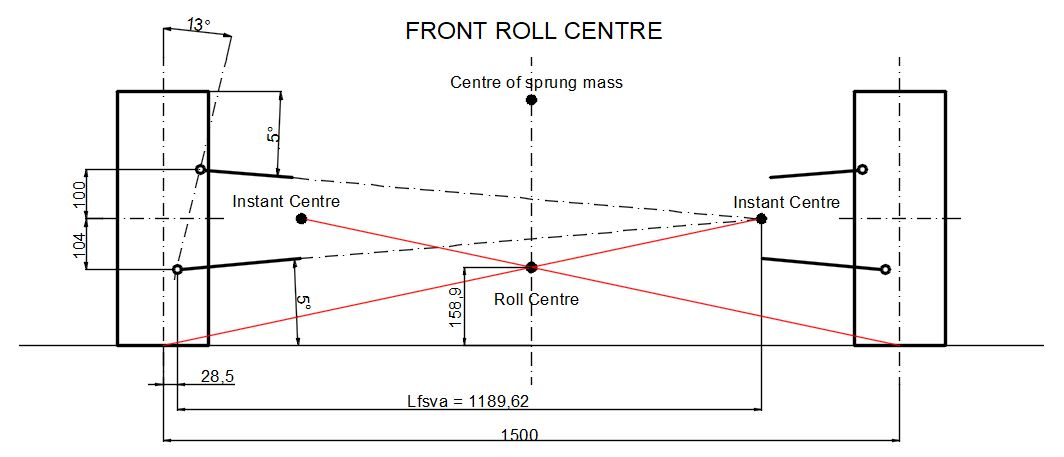
1. Zawieszenie/11. Kinematyka/Aktualne ustawienie/Front roll centre 09.06.21.jpg
