Zykbyk/VACLAV/1. Zawieszenie/11. Kinematyka/Aktualne ustawienie/Parametry 13.10.21.jpg

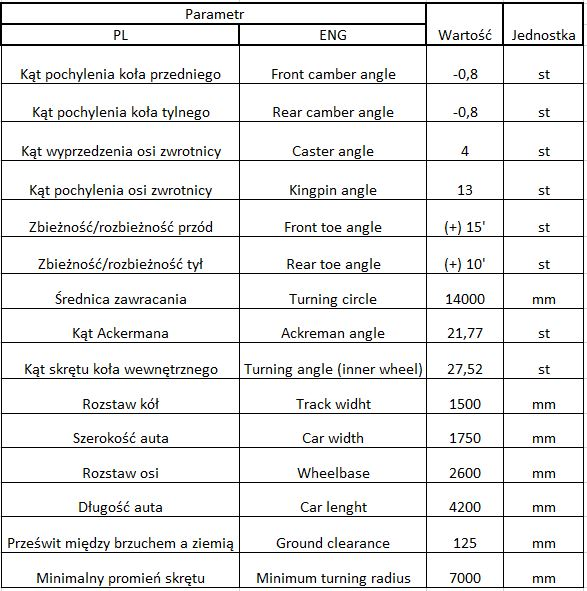
1. Zawieszenie/11. Kinematyka/Aktualne ustawienie/Parametry 13.10.21.jpg
