Zykbyk/VACLAV/1. Zawieszenie/11. Kinematyka/Informacje/Korygowanie nadsterowności i podsterwności.JPG

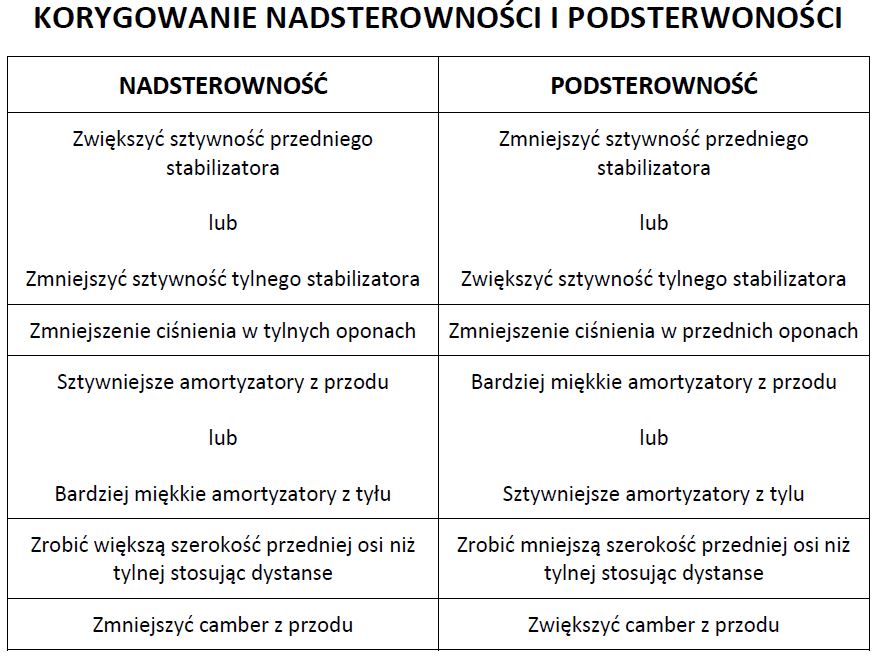
1. Zawieszenie/11. Kinematyka/Informacje/Korygowanie nadsterowności i podsterwności.JPG
