Zykbyk/VACLAV/1. Zawieszenie/11. Kinematyka/Informacje/Positive Caster.JPG

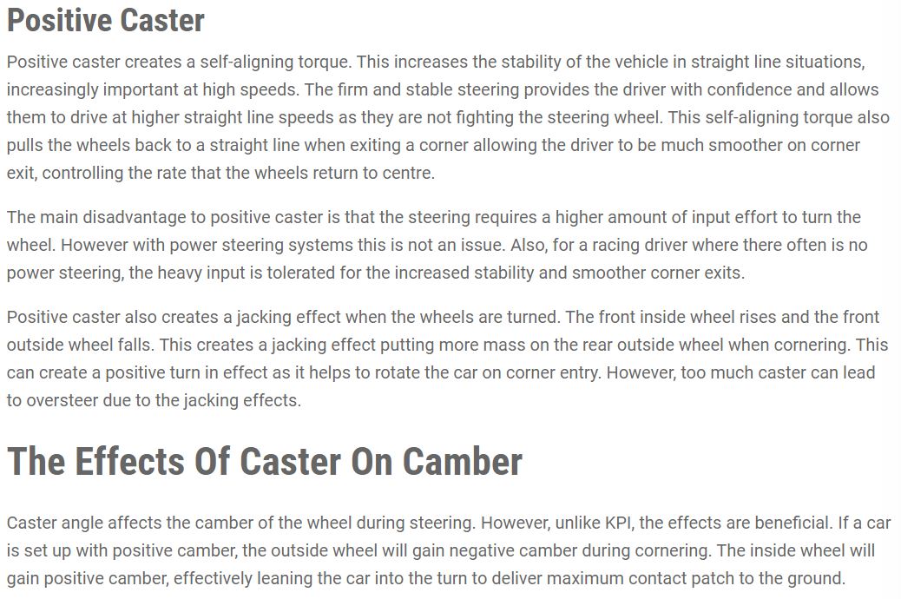
1. Zawieszenie/11. Kinematyka/Informacje/Positive Caster.JPG
