Zykbyk/VACLAV/1. Zawieszenie/11. Kinematyka/Parametry/Camber gain.jpg

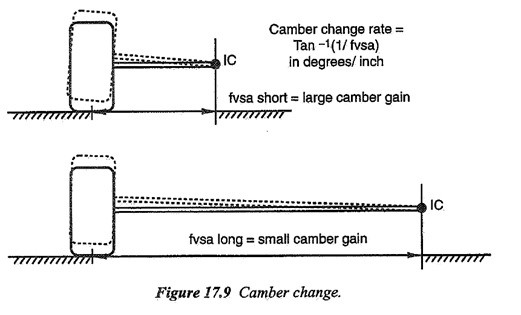
1. Zawieszenie/11. Kinematyka/Parametry/Camber gain.jpg
