Zykbyk/VACLAV/1. Zawieszenie/11. Kinematyka/Parametry/Camber thrust.JPG

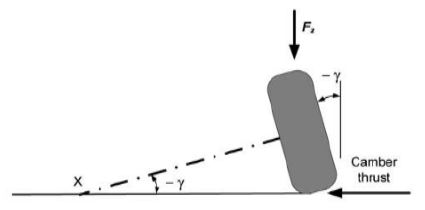
1. Zawieszenie/11. Kinematyka/Parametry/Camber thrust.JPG
