Zykbyk/VACLAV/1. Zawieszenie/11. Kinematyka/Parametry/Geometria do promienia zataczania.png

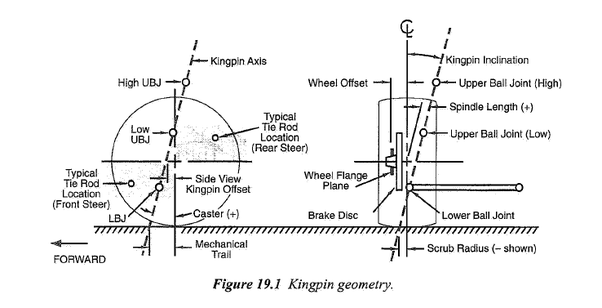
1. Zawieszenie/11. Kinematyka/Parametry/Geometria do promienia zataczania.png
