Zykbyk/VACLAV/1. Zawieszenie/11. Kinematyka/Parametry/Jacking.JPG

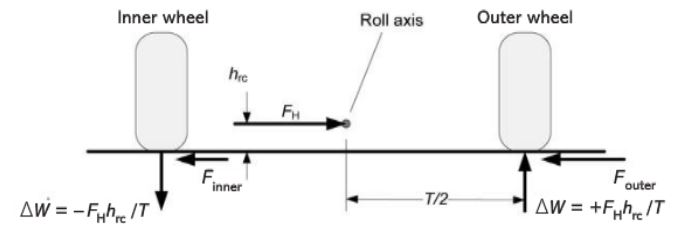
1. Zawieszenie/11. Kinematyka/Parametry/Jacking.JPG
