Zykbyk/VACLAV/1. Zawieszenie/11. Kinematyka/Parametry/Wyznaczanie Pitch Centre.jpg

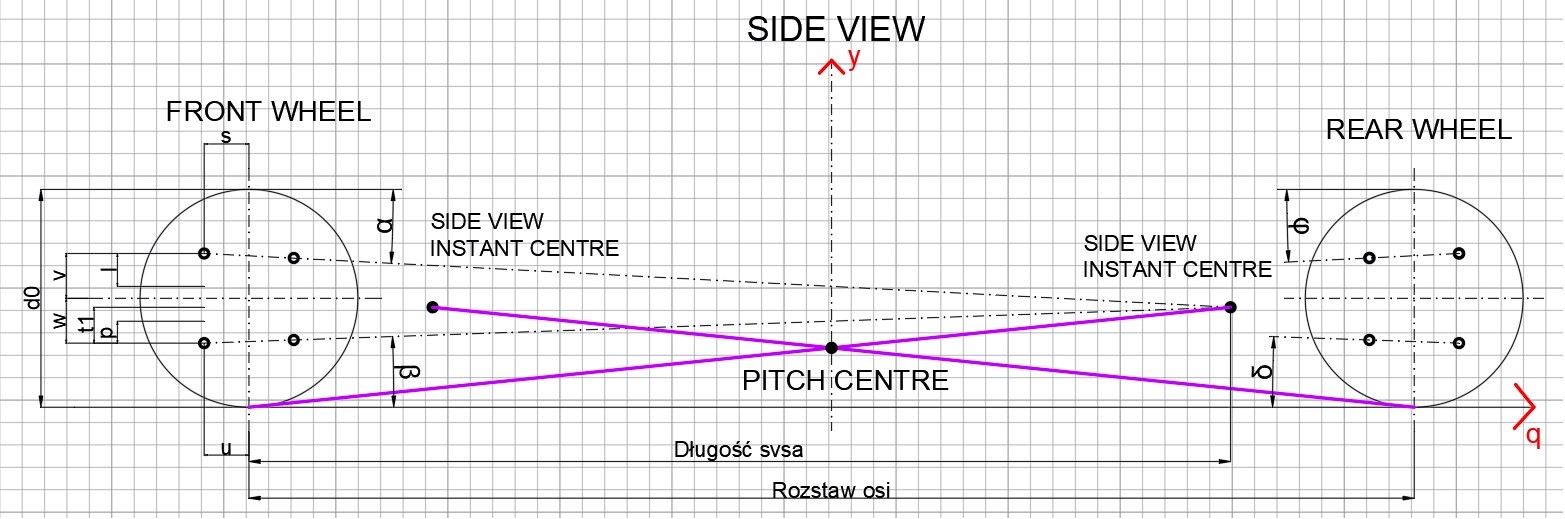
1. Zawieszenie/11. Kinematyka/Parametry/Wyznaczanie Pitch Centre.jpg
