Zykbyk/VACLAV/1. Zawieszenie/11. Kinematyka/Parametry/Wyznaczanie Roll Centre.jpg

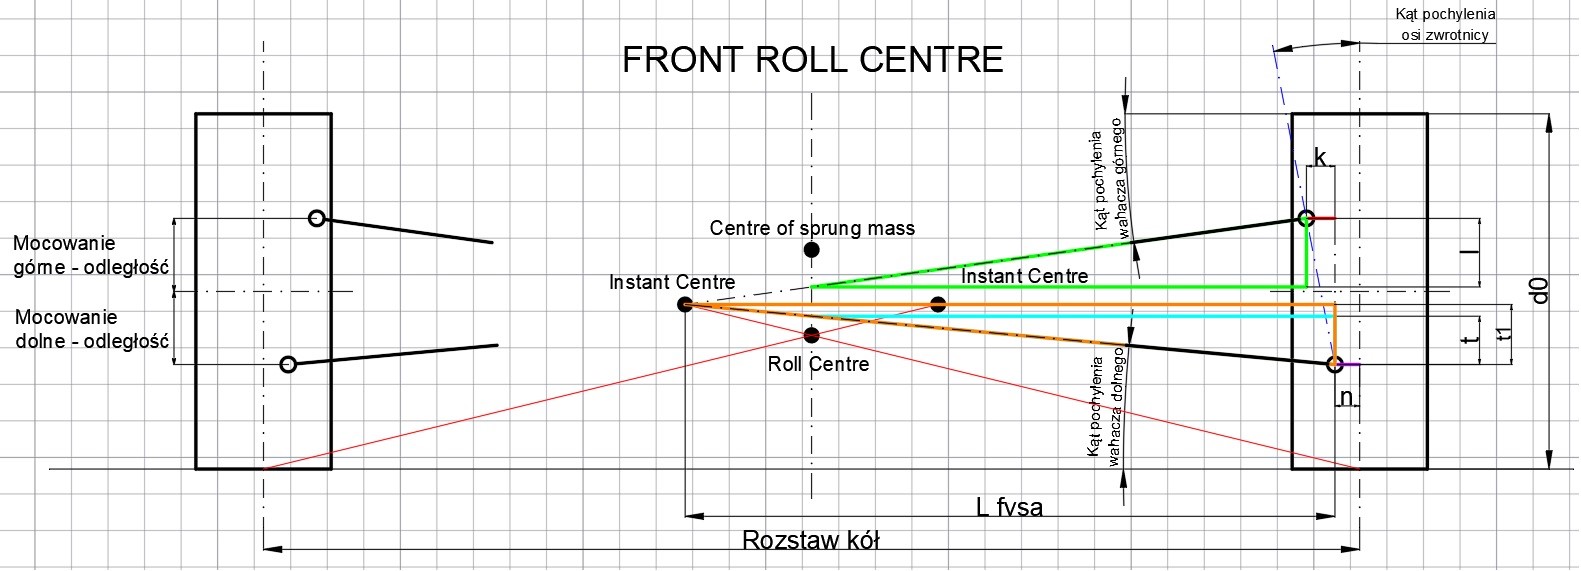
1. Zawieszenie/11. Kinematyka/Parametry/Wyznaczanie Roll Centre.jpg
