Zykbyk/VACLAV/1. Zawieszenie/11. Kinematyka/Parametry/Zależność camber thrust od camber angle.JPG

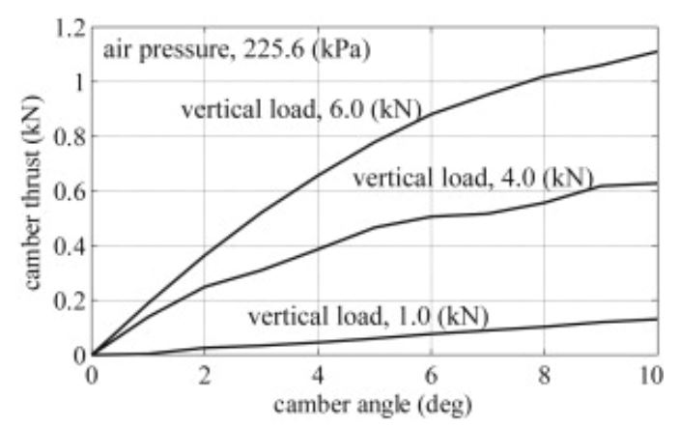
1. Zawieszenie/11. Kinematyka/Parametry/Zależność camber thrust od camber angle.JPG
