Zykbyk/VACLAV/1. Zawieszenie/MEM.jpg

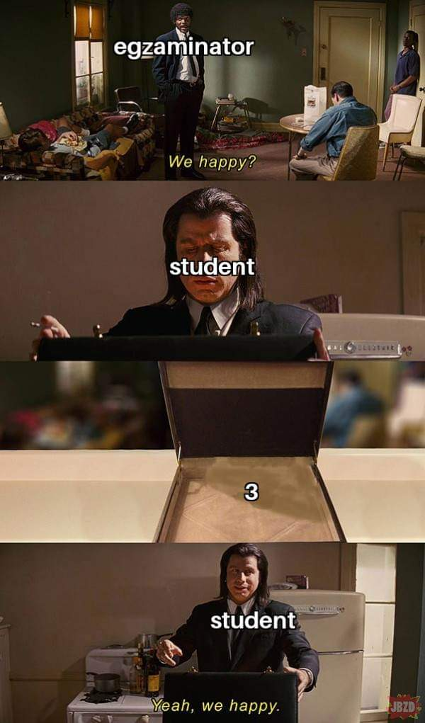
1. Zawieszenie/MEM.jpg
