Zykbyk/VACLAV/10. Zgredek/0. Podwozie-rama/wstępne wymiary z czapy.PNG

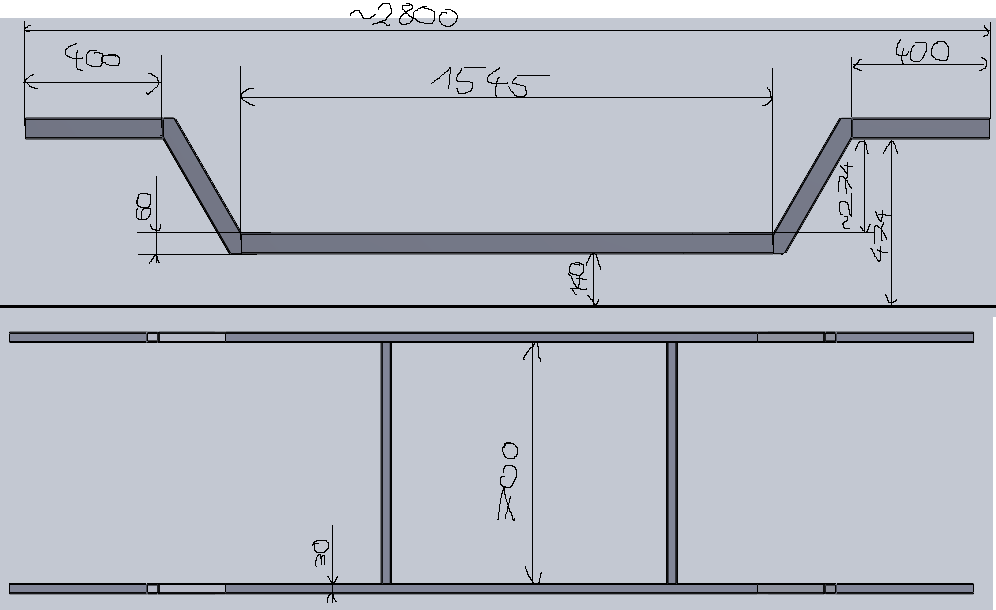
10. Zgredek/0. Podwozie-rama/wstępne wymiary z czapy.PNG
