Zykbyk/VACLAV/10. Zgredek/Wytłumaczenie nazywania.png

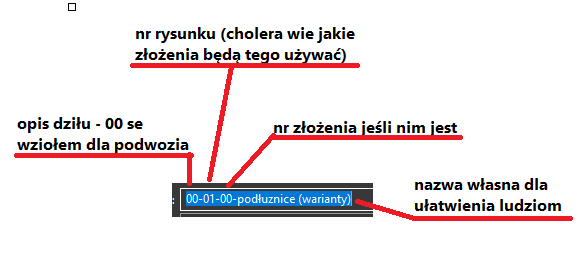
10. Zgredek/Wytłumaczenie nazywania.png
