Zykbyk/VACLAV/00.ELEMENTY ZNORMALIZOWANE/Główka przegubowa_GN 648.8/Główka przegubowa_GN 648.8_6.SLDASM

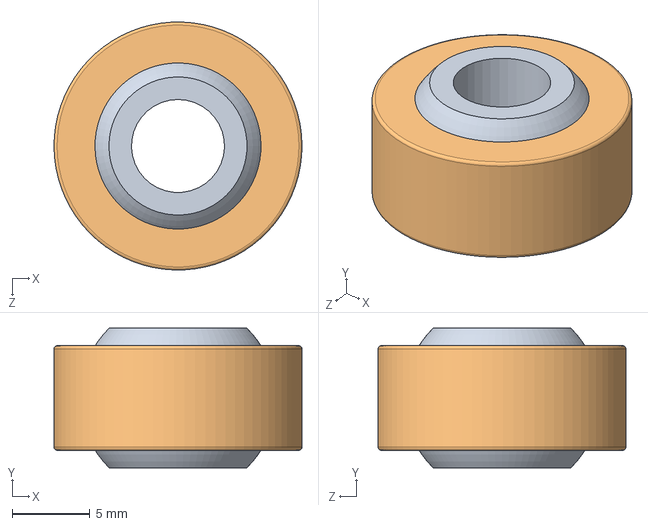
[picture p84: CAD file, 2021-10-13]
00.ELEMENTY ZNORMALIZOWANE/Główka przegubowa_GN 648.8/Główka przegubowa_GN 648.8_6.SLDASM
16.0 x 9.00 x 16.0 mm
BALL-JOINT-GN-648.8-1-6
BALL-JOINT-GN-648.8-2-6
