Zykbyk/VACLAV/1. Zawieszenie/99. Pozostałe/Bobcat/Assem3.SLDASM

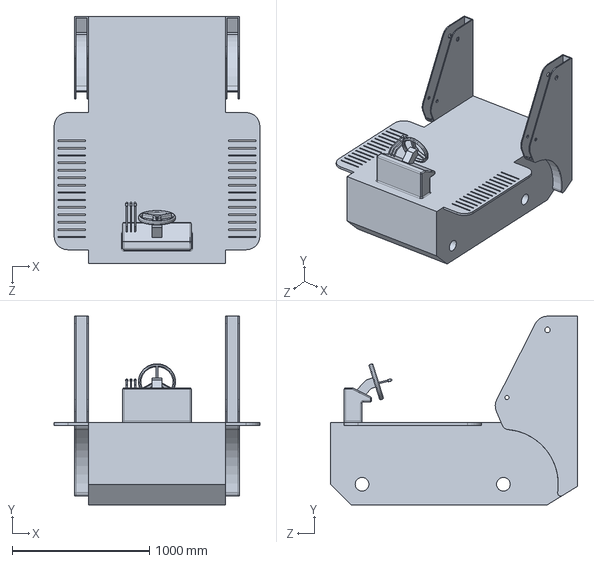
[picture p85: CAD file, 2025-03-02]
1. Zawieszenie/99. Pozostałe/Bobcat/Assem3.SLDASM
1500.0 x 1375.0 x 1800.0 mm
