Zykbyk/VACLAV/10. Zgredek/_Archiwum/stara wersja (wahacze)/2023_10_04_Zawieszenie przód/2023_08_27.SLDASM

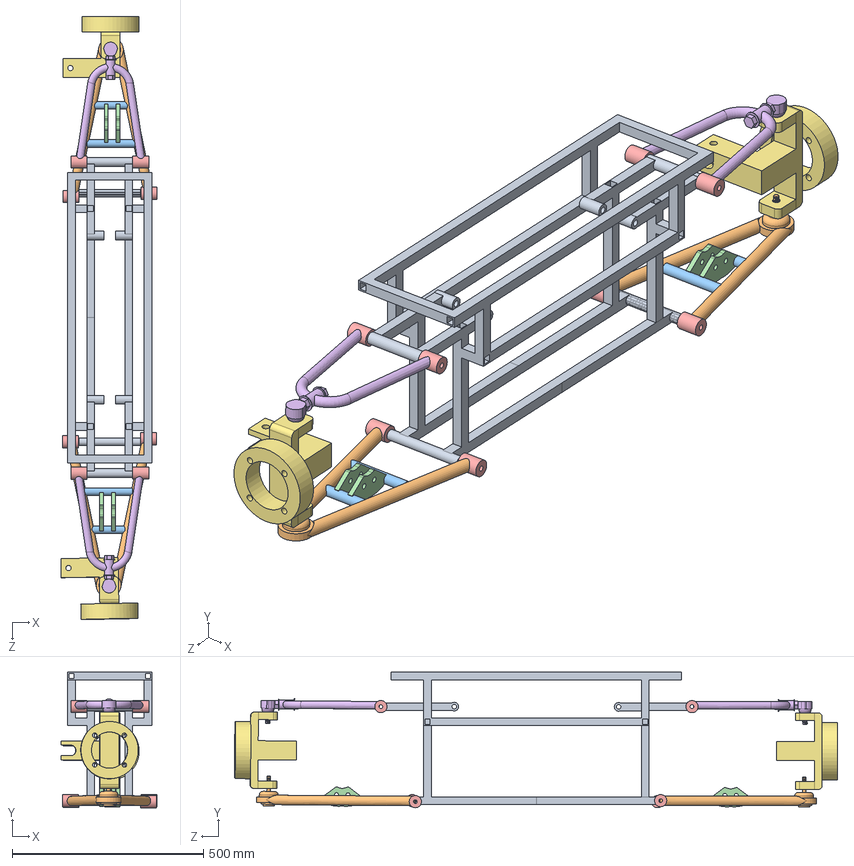
[picture p86: CAD file, 2025-03-02]
10. Zgredek/_Archiwum/stara wersja (wahacze)/2023_10_04_Zawieszenie przód/2023_08_27.SLDASM
252.4 x 354.6 x 1577.6 mm
korpus
wahaczgornycz1 x 2
wahaczgornycz2 x 2
wahaczgornycz3 x 4
Cz1dowahacza x 8
Cz2dowahacza x 2
zwrotnica x 2
