Zykbyk/VACLAV/10. Zgredek/_Archiwum/stara wersja (wahacze)/Wahacz/Wahaczprawie.sldasm

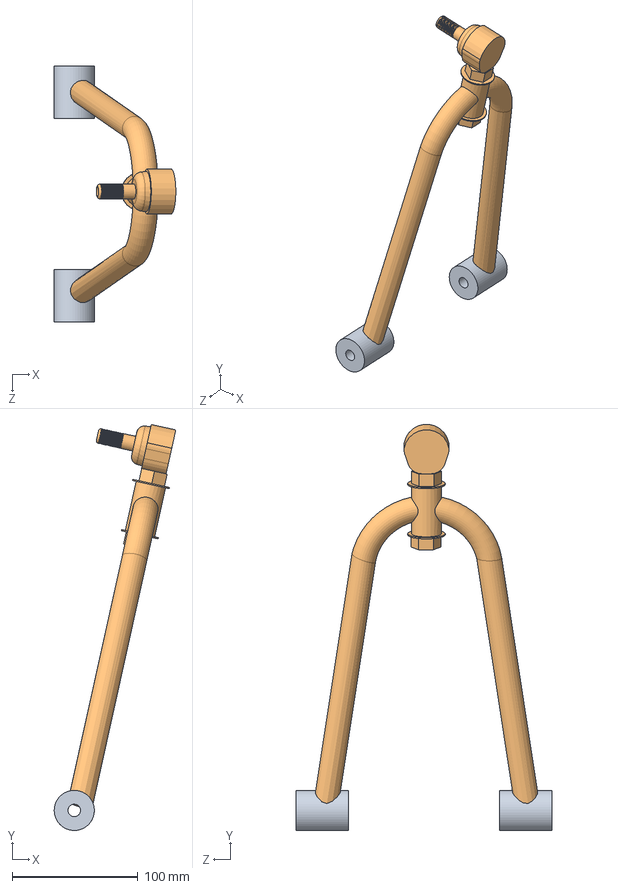
[picture p87: CAD file, 2025-03-02]
10. Zgredek/_Archiwum/stara wersja (wahacze)/Wahacz/Wahaczprawie.sldasm
96.9 x 323.5 x 204.0 mm
Cz1dowahacza x 2
Cz2dowahacza
