Zykbyk/VACLAV/Jacku zadecyduj/klara/UCPA 206/SKF_UCPA 206.sldasm

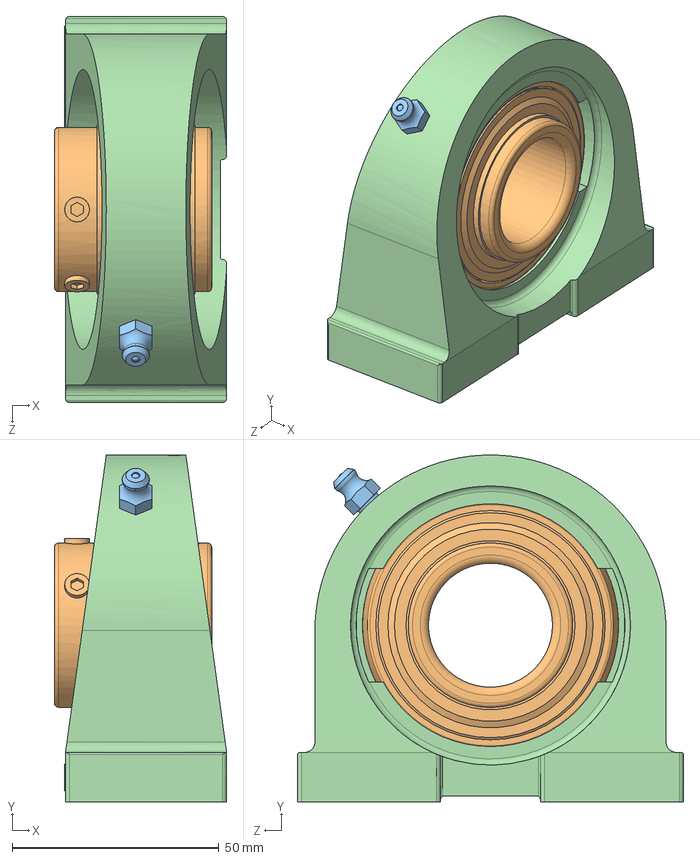
[picture p88: CAD file, 2025-03-02]
Jacku zadecyduj/klara/UCPA 206/SKF_UCPA 206.sldasm
41.7 x 84.0 x 93.5 mm
30-62-38.1-18-ucpa--9.525-46.5 x 8
UC 206-39.862-b
1_4-28 UNF
PA 206 -h
