Zykbyk/VACLAV/00.ELEMENTY ZNORMALIZOWANE/Przegub kulowy_GN 648.2/Przegub kulowy_GN 648.2_6.SLDASM

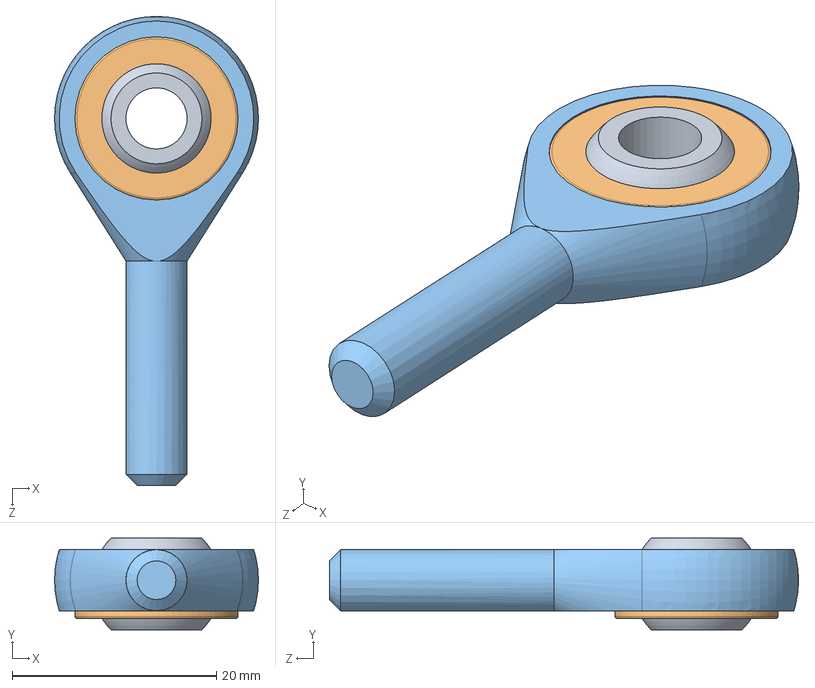
[picture p89: CAD file, 2021-10-13]
00.ELEMENTY ZNORMALIZOWANE/Przegub kulowy_GN 648.2/Przegub kulowy_GN 648.2_6.SLDASM
20.0 x 9.00 x 46.0 mm
ROD-END-GN-648.2-1-6
ROD-END-GN-648.2-2-6
ROD-END-GN-648.2-3-6
