Zykbyk/VACLAV/1. Zawieszenie/13. Motorsport/PUTM-G-Assembly/PUTM-G-TM-PCB.SLDASM

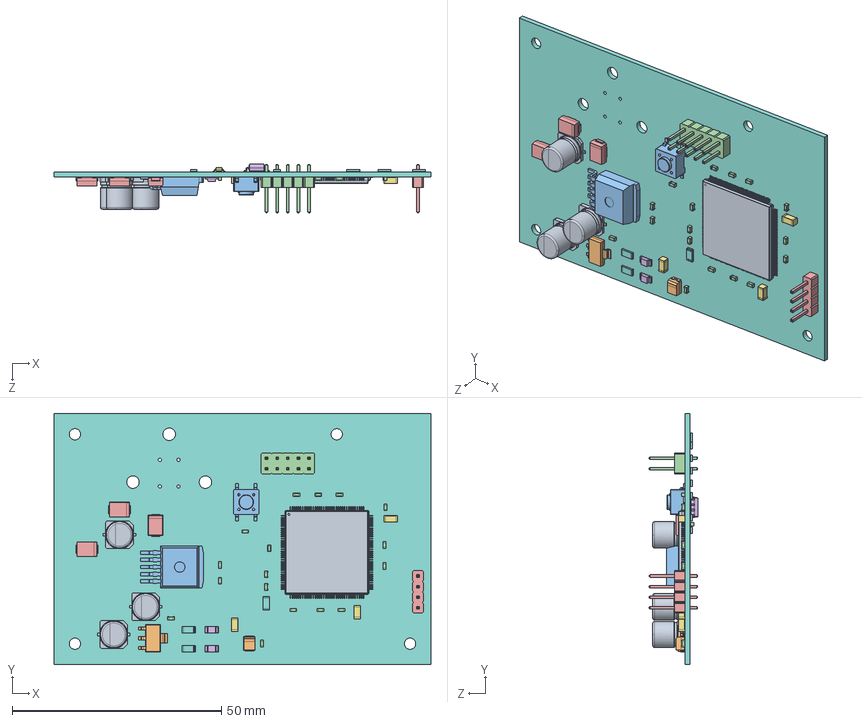
[picture p90: CAD file, 2021-10-25]
1. Zawieszenie/13. Motorsport/PUTM-G-Assembly/PUTM-G-TM-PCB.SLDASM
90.0 x 60.0 x 11.6 mm
SOLID.step x 3
SOLID-0.step
SOLID-1.step
SOLID-2.step x 18
SOLID-3.step
SOLID-4.step
SOLID-5.step
SOLID-6.step x 12
SOLID-7.step
SOLID-8.step
SOLID-9.step
SOLID-10.step
SOLID-12.step x 3
SOLID-13.step x 2
SOLID-14.step x 3
COMPOUND.step
