Zykbyk/VACLAV/10. Zgredek/0. Podwozie-rama/00-00-02- Wachacz lewy.SLDASM

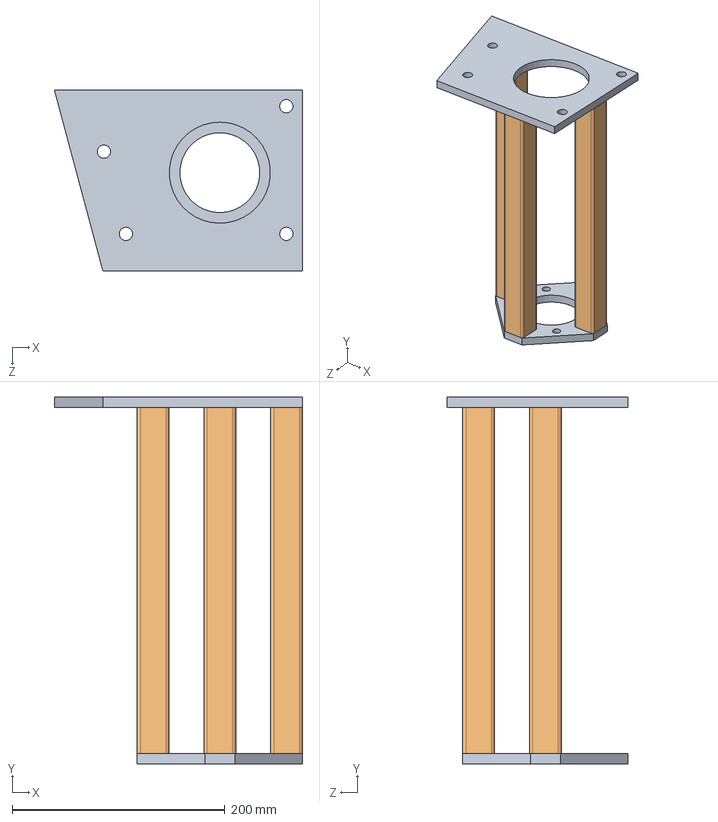
[picture p91: CAD file, 2025-03-02]
10. Zgredek/0. Podwozie-rama/00-00-02- Wachacz lewy.SLDASM
233.3 x 345.0 x 170.3 mm
00-07-00- Blacha 10mm x 2
00-04-00- Profile 30x30x3 x 3
