Zykbyk/VACLAV/10. Zgredek/2. Klatka Bezpieczeństwa/02-00-01 - Klatka Bezpieczenstwa.SLDASM

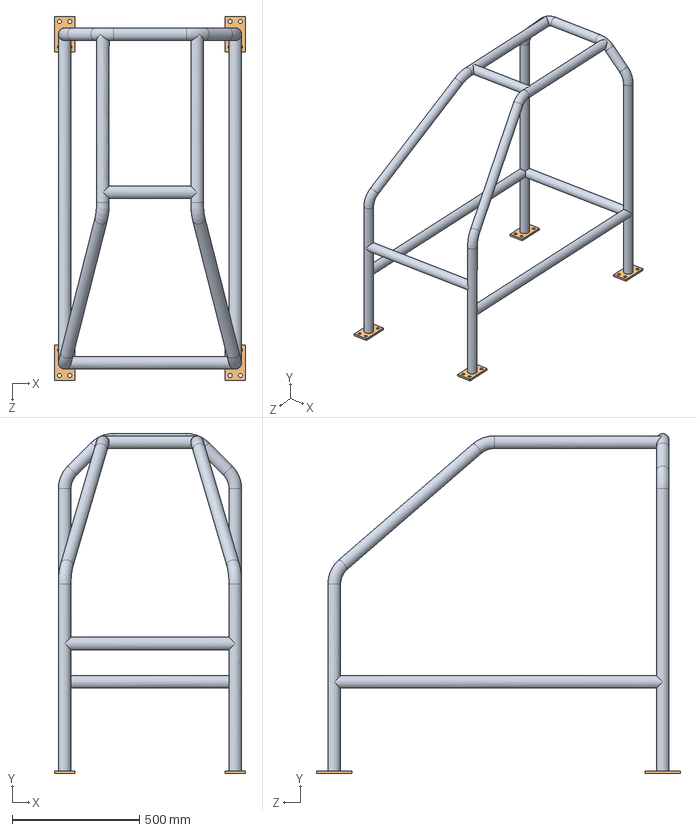
[picture p92: CAD file, 2025-03-02]
10. Zgredek/2. Klatka Bezpieczeństwa/02-00-01 - Klatka Bezpieczenstwa.SLDASM
750.0 x 1335.0 x 1430.0 mm
02-01-00 - Klatka Bezpieczenstwa
02-02-00 - Element montazowy x 4
