Zykbyk/VACLAV/10. Zgredek/4. Zawieszenie/2024_01_10/prototyp zawieszenie.SLDASM

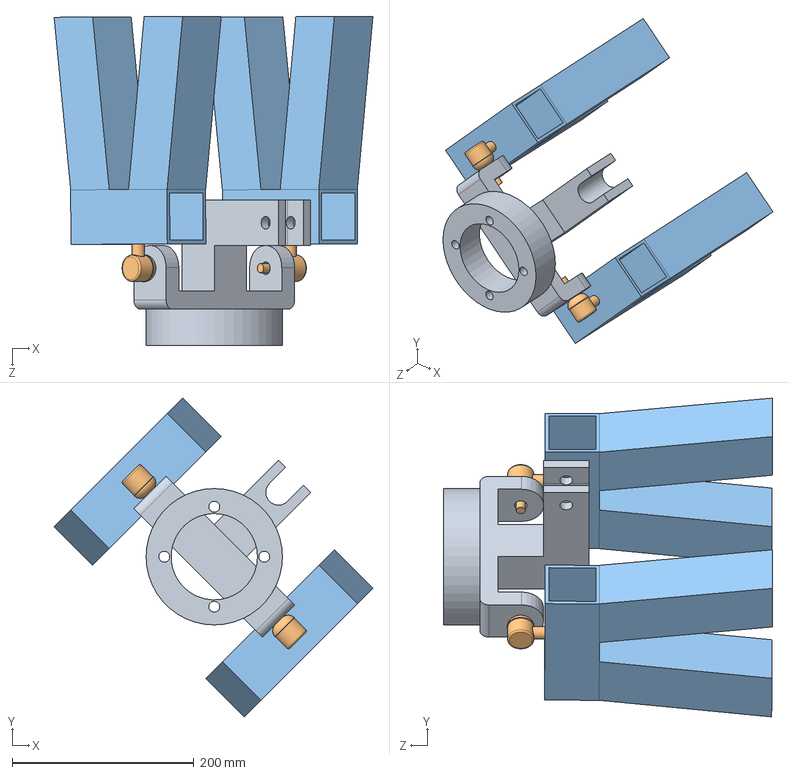
[picture p93: CAD file, 2025-03-02]
10. Zgredek/4. Zawieszenie/2024_01_10/prototyp zawieszenie.SLDASM
350.7 x 350.7 x 361.9 mm
zwrotnica1
Sworzeń x 2
Wahacz x 2
