Zykbyk/VACLAV/10. Zgredek/4. Zawieszenie/2024_02_19/00-01-00-wahacz.SLDASM

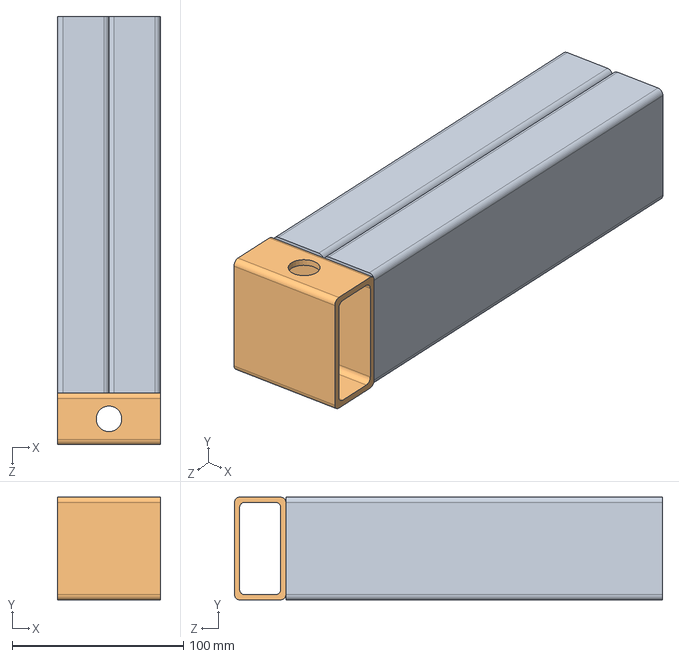
[picture p94: CAD file, 2025-03-02]
10. Zgredek/4. Zawieszenie/2024_02_19/00-01-00-wahacz.SLDASM
60.0 x 60.0 x 250.0 mm
00-01-00-profil x 2
