Zykbyk/VACLAV/2. Nadwozie/7. Klamka nowa klamka/7. Klamka/całość.SLDASM

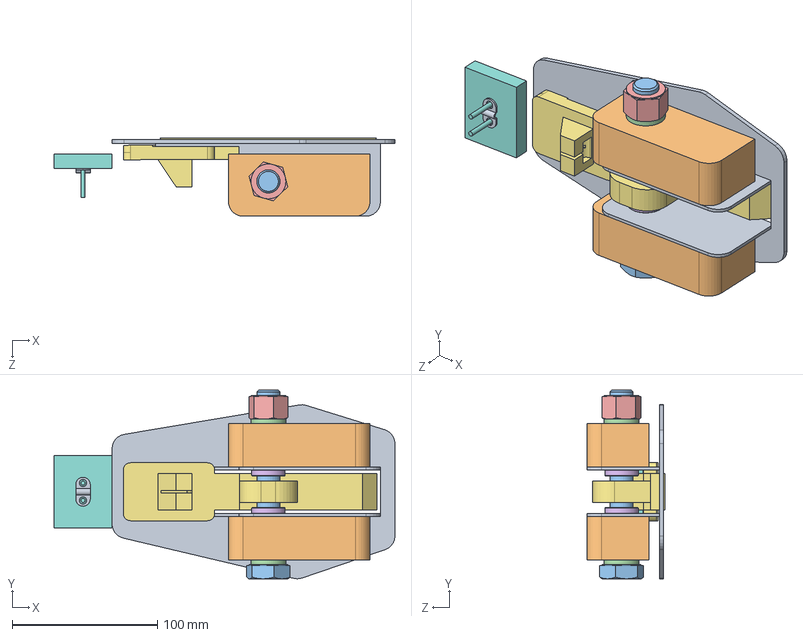
[picture p95: CAD file, 2025-03-02]
2. Nadwozie/7. Klamka nowa klamka/7. Klamka/całość.SLDASM
235.0 x 130.0 x 54.1 mm
Nakładka
Mocowanie x 2
hex structural bolt gradec_iso
plain washer clevis pin grade a_iso x 2
hex nut style 2 fine gradeab_iso
angular contact ball bearing_68_iso x 2
Klamka
podkładka
Mocowanie 2
