Zykbyk/VACLAV/1. Zawieszenie/1. Wahacze/ELEMENTY ZNORMALIZOWANE/Główka przegubowa_GN 648.8/Główka przegubowa_GN 648.8_12.SLDASM

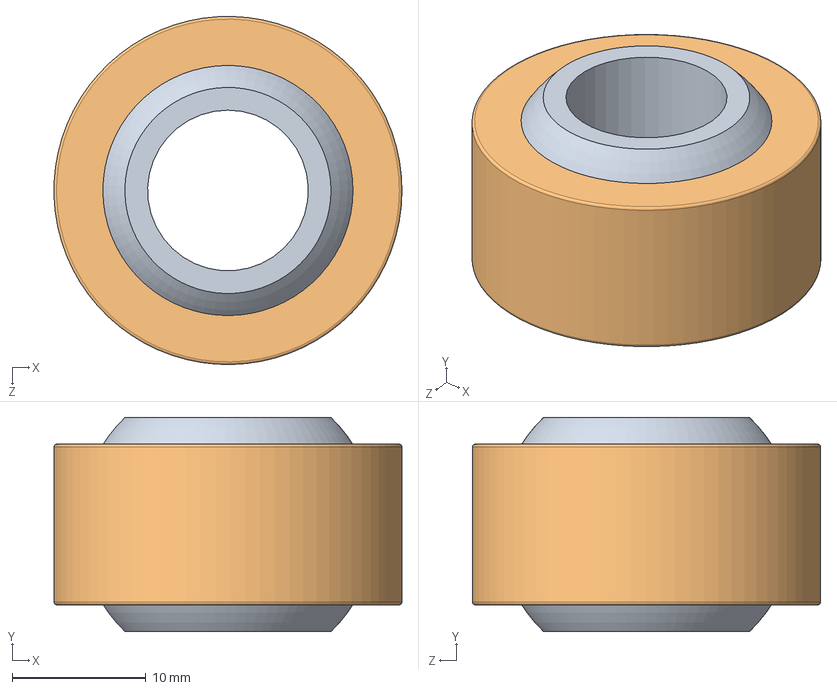
[picture p96: CAD file, 2023-01-11]
1. Zawieszenie/1. Wahacze/ELEMENTY ZNORMALIZOWANE/Główka przegubowa_GN 648.8/Główka przegubowa_GN 648.8_12.SLDASM
26.0 x 16.0 x 26.0 mm
BALL-JOINT-GN-648.8-1-12
BALL-JOINT-GN-648.8-2-12
