Zykbyk/VACLAV/10. Zgredek/4. Zawieszenie/04-01-00-Nowy przód 1/Wahaczprawie3.sldasm

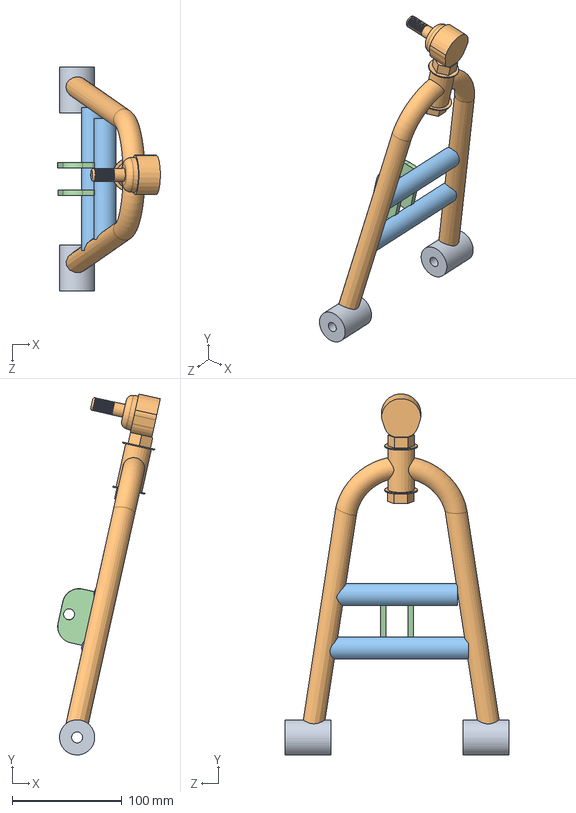
[picture p97: CAD file, 2025-03-02]
10. Zgredek/4. Zawieszenie/04-01-00-Nowy przód 1/Wahaczprawie3.sldasm
93.4 x 328.3 x 204.0 mm
Cz1dowahacza x 2
Cz2dowahacza
Część1
Część2 x 2
