Zykbyk/VACLAV/10. Zgredek/_Archiwum/stara wersja (wahacze)/2023_10_04_Zawieszenie przód/Spreżyna.SLDASM

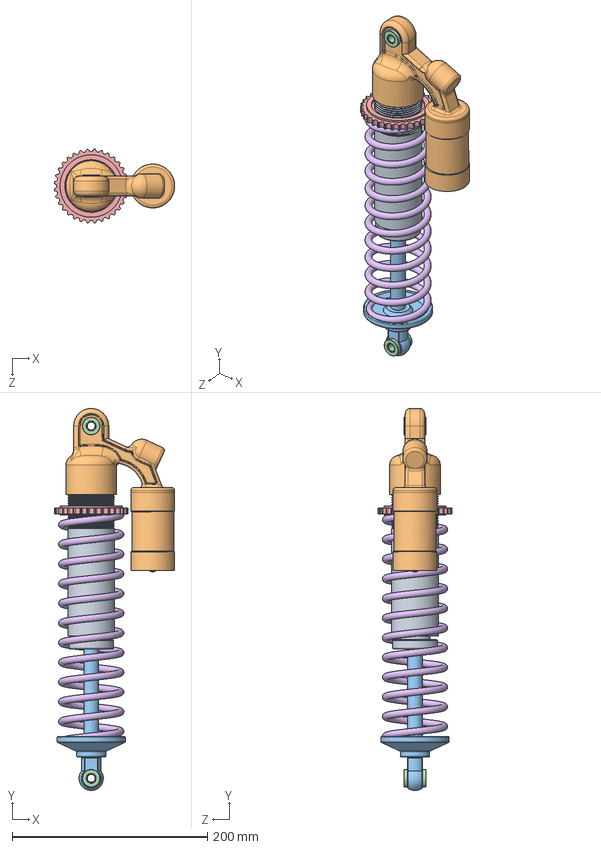
[picture p98: CAD file, 2025-03-02]
10. Zgredek/_Archiwum/stara wersja (wahacze)/2023_10_04_Zawieszenie przód/Spreżyna.SLDASM
123.4 x 391.5 x 75.7 mm
journal bearing x 2
spring nut1
Part2^shock absorber1
