Zykbyk/VACLAV/10. Zgredek/_Archiwum/stara wersja (wahacze)/2023_10_04_Zawieszenie przód/Zawieszenie/Dolny wahacz/Wahacz2.sldasm

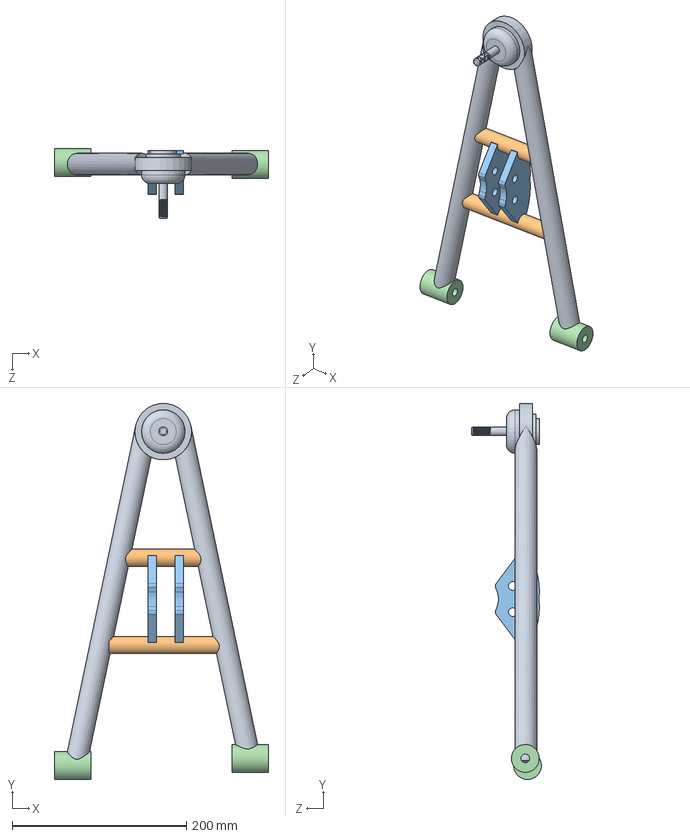
[picture p99: CAD file, 2025-03-02]
10. Zgredek/_Archiwum/stara wersja (wahacze)/2023_10_04_Zawieszenie przód/Zawieszenie/Dolny wahacz/Wahacz2.sldasm
246.1 x 431.8 x 80.3 mm
wahaczgornycz1
wahaczgornycz2
wahaczgornycz3 x 2
Cz1dowahacza x 2
