Zykbyk/VACLAV/00.ELEMENTY ZNORMALIZOWANE/Główka przegubowa_GN 648.8/Główka przegubowa_GN 648.8_16.SLDASM

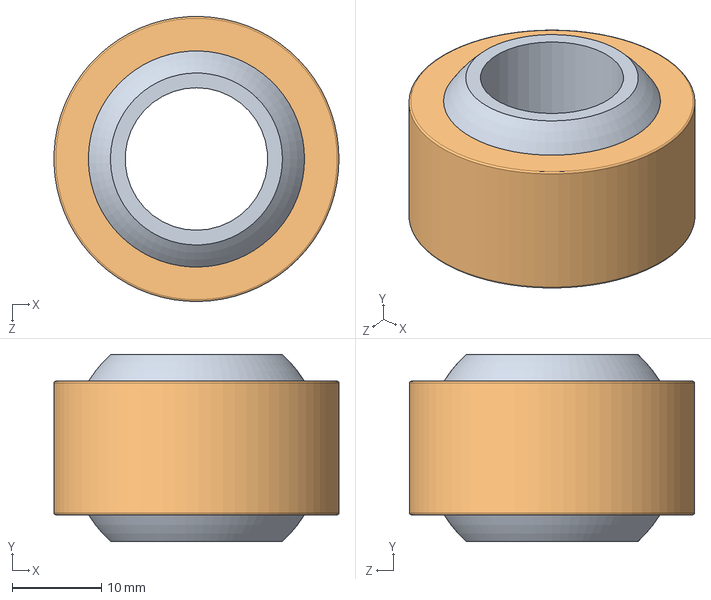
[picture p100: CAD file, 2021-10-13]
00.ELEMENTY ZNORMALIZOWANE/Główka przegubowa_GN 648.8/Główka przegubowa_GN 648.8_16.SLDASM
32.0 x 21.0 x 32.0 mm
BALL-JOINT-GN-648.8-1-16
BALL-JOINT-GN-648.8-2-16
