Zykbyk/VACLAV/1. Zawieszenie/1. Wahacze/ELEMENTY ZNORMALIZOWANE/Przegub kulowy_GN 648.2/Przegub kulowy_GN 648.2_12.SLDASM

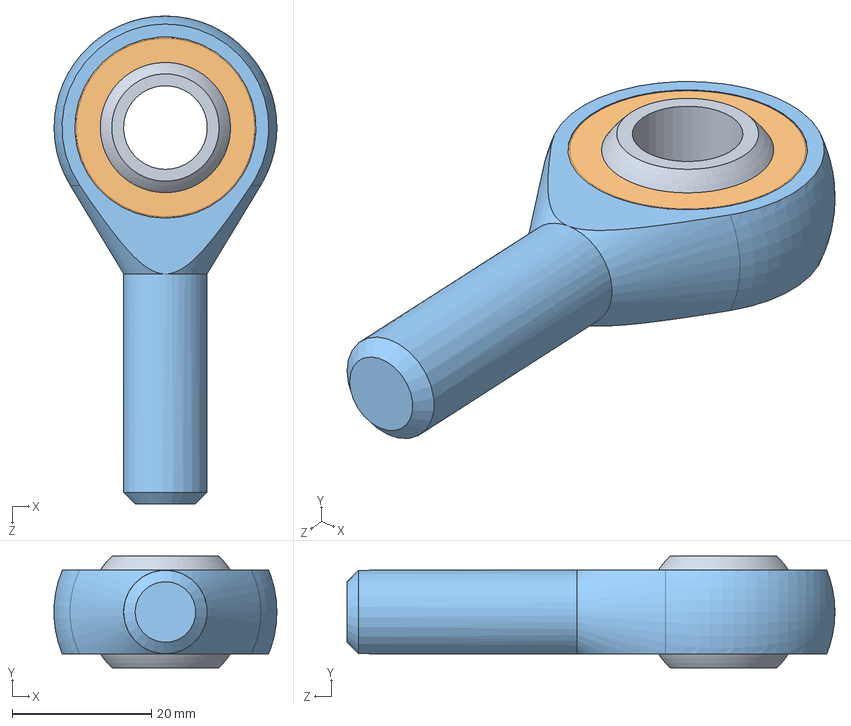
[picture p101: CAD file, 2023-01-11]
1. Zawieszenie/1. Wahacze/ELEMENTY ZNORMALIZOWANE/Przegub kulowy_GN 648.2/Przegub kulowy_GN 648.2_12.SLDASM
32.0 x 16.0 x 70.0 mm
ROD-END-GN-648.2-1-12
ROD-END-GN-648.2-2-12
ROD-END-GN-648.2-3-12
