Zykbyk/VACLAV/1. Zawieszenie/99. Pozostałe/Łukasz Golec/Assem1.SLDASM

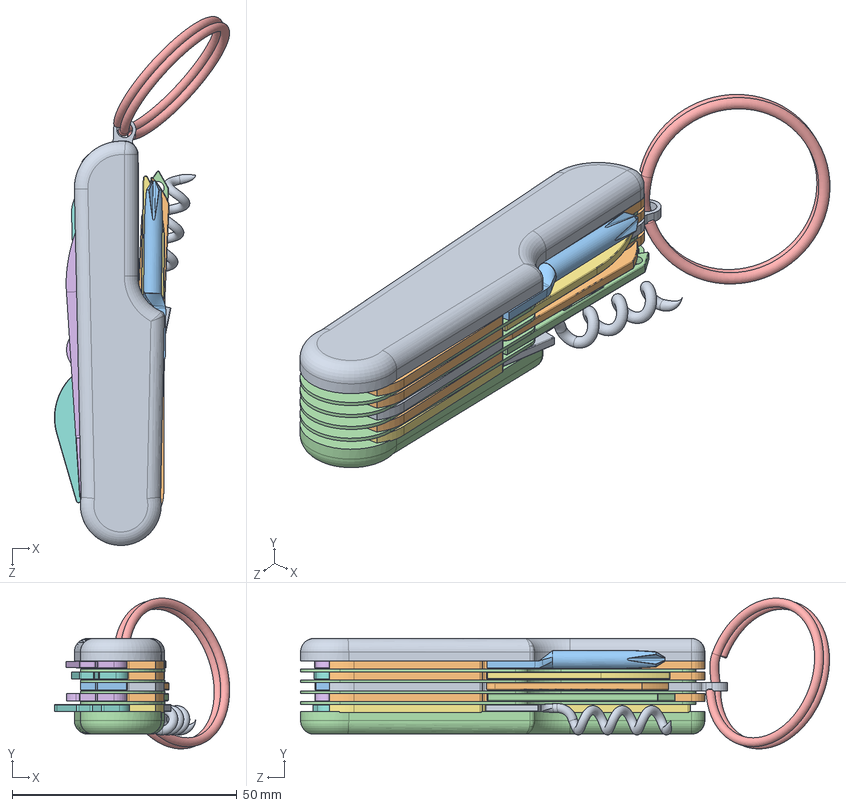
[picture p102: CAD file, 2025-03-02]
1. Zawieszenie/99. Pozostałe/Łukasz Golec/Assem1.SLDASM
38.9 x 33.5 x 117.6 mm
first cover
plate1 x 3
screwdriver
main plate x 4
pin1 x 2
knife2
knife
saw
plate2
nail polisher
saw knife
bender point
scissors arm
scissors arm2
plate3
can opener
bottle cork opener
bottle opener
pin2
second cover
holder
