Zykbyk/VACLAV/10. Zgredek/4. Zawieszenie/04-01-00 - Tył/Tylzloz.SLDASM

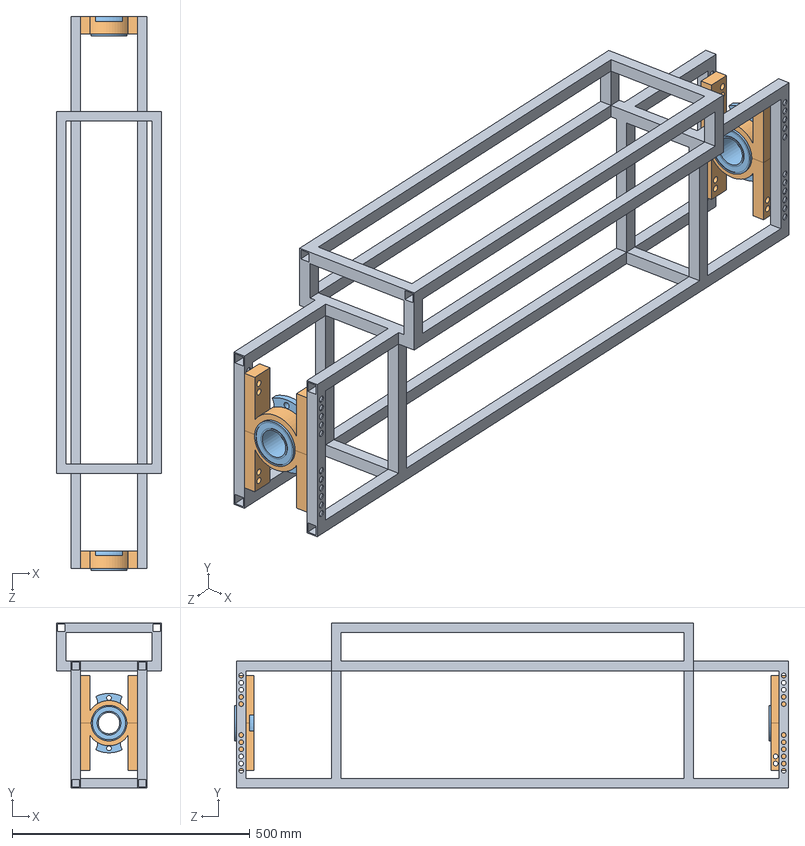
[picture p103: CAD file, 2025-03-02]
10. Zgredek/4. Zawieszenie/04-01-00 - Tył/Tylzloz.SLDASM
220.0 x 346.0 x 1164.0 mm
Baza
mocowanie x 4
04-04-00 - łozysko piasty x 2
