Zykbyk/VACLAV/2. Nadwozie/5. Zawiasy drzwi bocznych/Koncepcja zawias/Zawias Koncepcja Złożenie.SLDASM

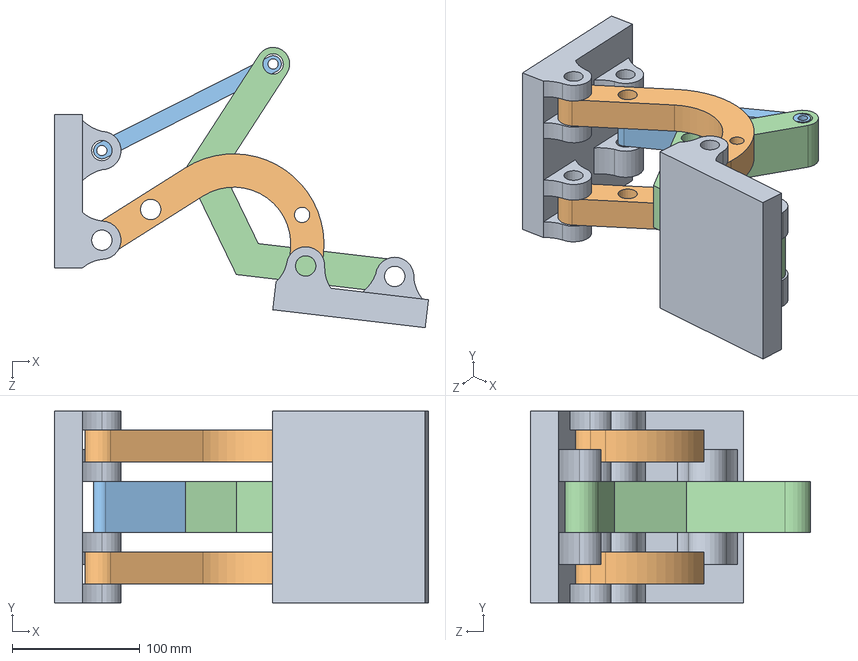
[picture p104: CAD file, 2022-12-07]
2. Nadwozie/5. Zawiasy drzwi bocznych/Koncepcja zawias/Zawias Koncepcja Złożenie.SLDASM
292.3 x 150.0 x 219.1 mm
Koncepcja Zawias x 2
Koncepcja Zawias 2 x 2
Koncepcja zawias 5
Koncepcja zawias 4
