Zykbyk/VACLAV/00.ELEMENTY ZNORMALIZOWANE/Przegub kulowy_GN 648.2/Przegub kulowy_GN 648.2_5.SLDASM

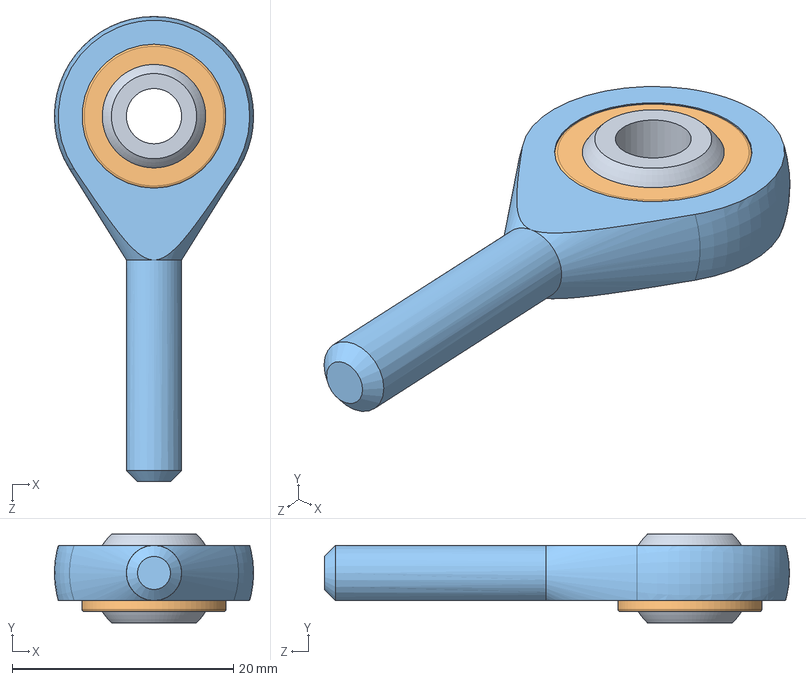
[picture p105: CAD file, 2021-10-13]
00.ELEMENTY ZNORMALIZOWANE/Przegub kulowy_GN 648.2/Przegub kulowy_GN 648.2_5.SLDASM
18.0 x 8.00 x 42.0 mm
ROD-END-GN-648.2-1-5
ROD-END-GN-648.2-2-5
ROD-END-GN-648.2-3-5
