Zykbyk/VACLAV/1. Zawieszenie/1. Wahacze/ELEMENTY ZNORMALIZOWANE/Przegub kulowy_GN 648.2/Przegub kulowy_GN 648.2_16.SLDASM

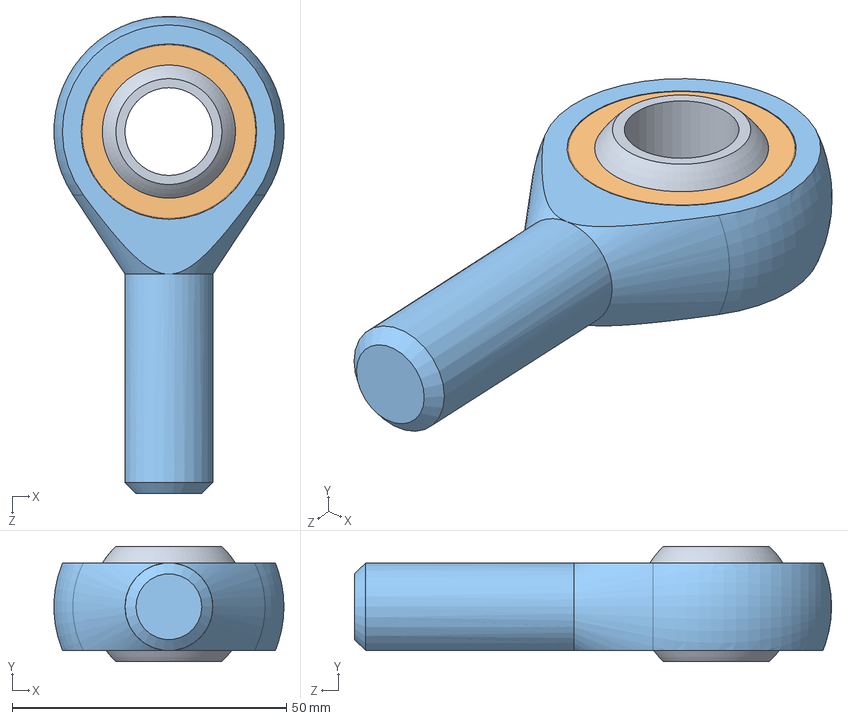
[picture p106: CAD file, 2023-01-11]
1. Zawieszenie/1. Wahacze/ELEMENTY ZNORMALIZOWANE/Przegub kulowy_GN 648.2/Przegub kulowy_GN 648.2_16.SLDASM
41.9 x 21.0 x 87.0 mm
ROD-END-GN-648.2-1-16
ROD-END-GN-648.2-2-16
ROD-END-GN-648.2-3-16
