Zykbyk/VACLAV/1. Zawieszenie/95. Hamownia silnika Kisielewski/1. Hamownia silnika Kisielweski.SLDASM

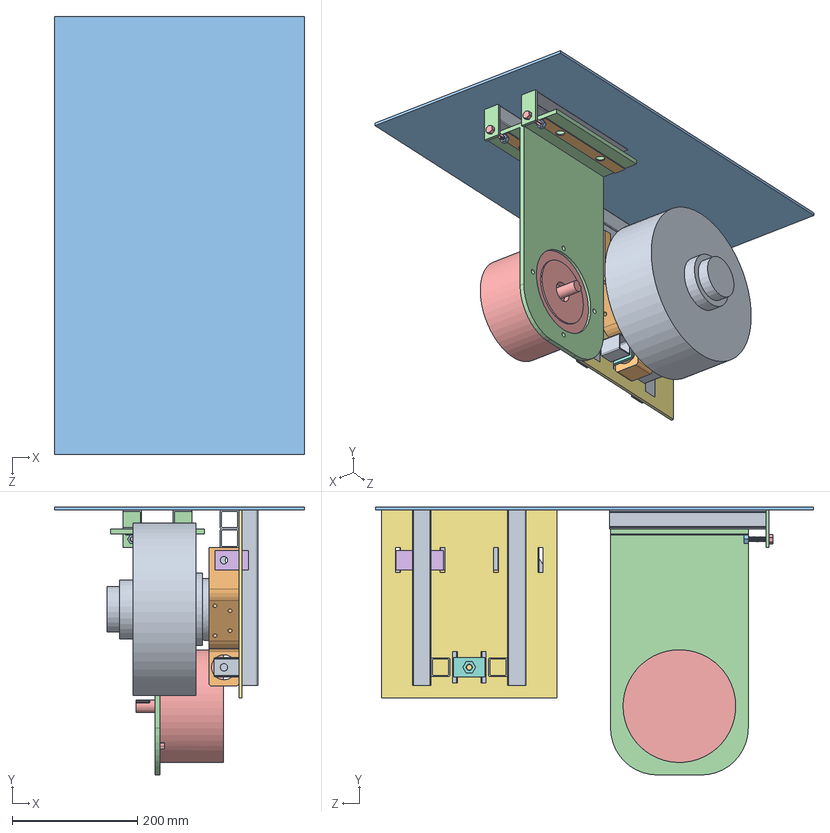
[picture p107: CAD file, 2025-03-02]
1. Zawieszenie/95. Hamownia silnika Kisielewski/1. Hamownia silnika Kisielweski.SLDASM
400.0 x 428.0 x 700.0 mm
silnik Kisielewski
Silnik Kisielewski adapter
podstawa hamowni
MAŁY SILNICZEK stojak
MAŁY SILNICZEK
Profile 30x30x2 x 10
listwa dociągacza x 2
nakrętka M8x1.25 x 2
blaha dociągacza x 2
śruba M8x1.25 x 2
