Zykbyk/VACLAV/10. Zgredek/4. Zawieszenie/04-01-00-Nowy przód 1/04-01-03_Złożenie.SLDASM

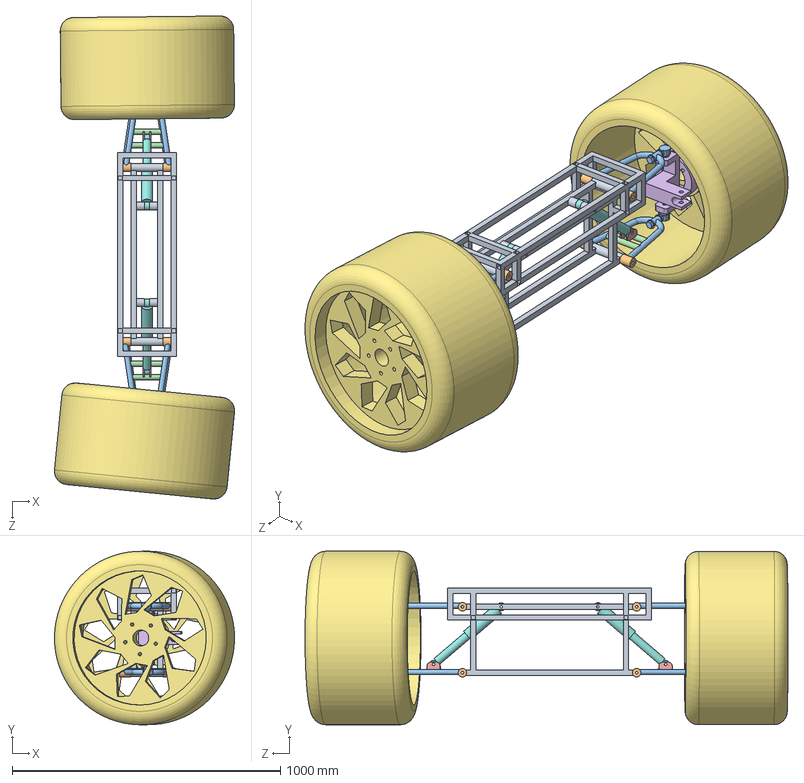
[picture p108: CAD file, 2025-03-02]
10. Zgredek/4. Zawieszenie/04-01-00-Nowy przód 1/04-01-03_Złożenie.SLDASM
671.9 x 647.4 x 1801.6 mm
korpus2
Cz1dowahacza x 8
Cz2dowahacza x 4
Część1 x 2
Część2 x 4
zwrotnica2 x 2
Koło e39v2 x 2
siłownik x 2
