Zykbyk/VACLAV/10. Zgredek/4. Zawieszenie/2024_02_19/00-01-02-wahacz.SLDASM

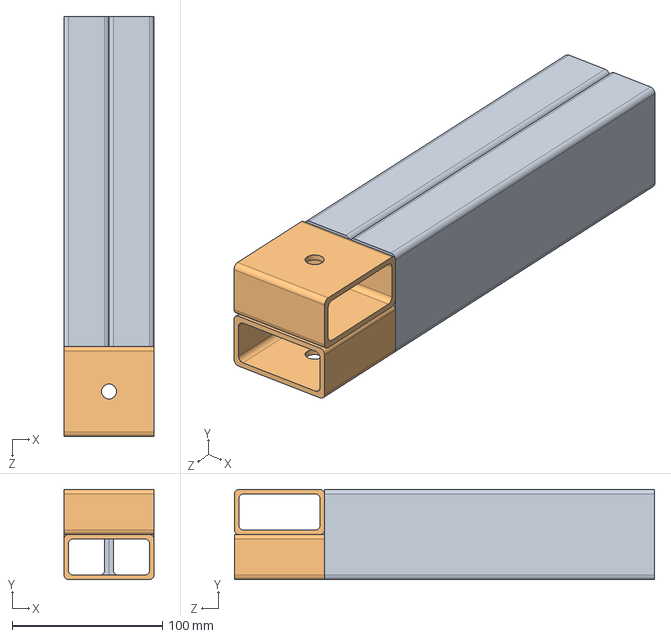
[picture p109: CAD file, 2025-03-02]
10. Zgredek/4. Zawieszenie/2024_02_19/00-01-02-wahacz.SLDASM
60.0 x 60.0 x 280.0 mm
00-01-00-profil x 2
