Zykbyk/VACLAV/1. Zawieszenie/1. Wahacze/ELEMENTY ZNORMALIZOWANE/Główka przegubowa_GN 648.8/Główka przegubowa_GN 648.8_10.SLDASM

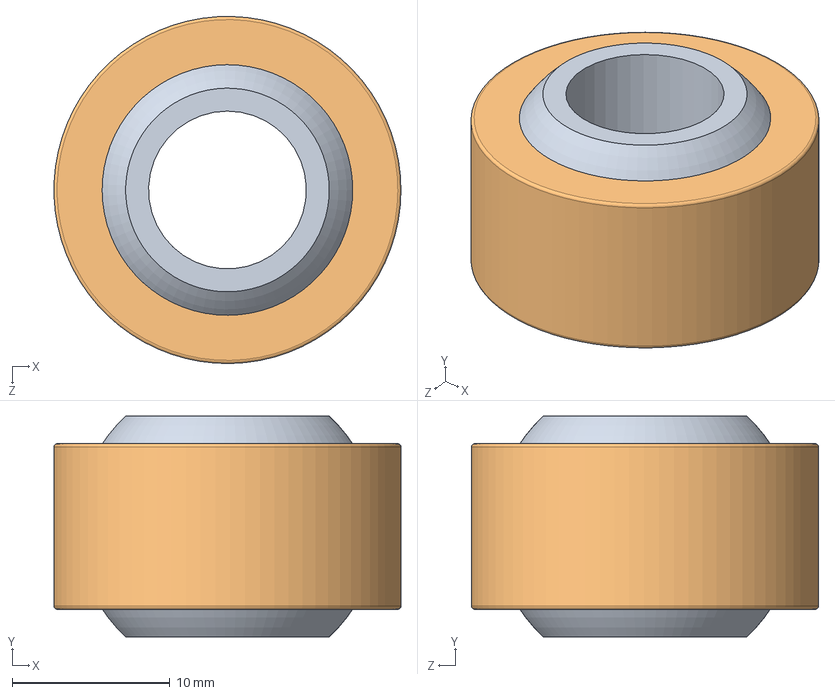
[picture p110: CAD file, 2021-10-13]
1. Zawieszenie/1. Wahacze/ELEMENTY ZNORMALIZOWANE/Główka przegubowa_GN 648.8/Główka przegubowa_GN 648.8_10.SLDASM
22.0 x 14.0 x 22.0 mm
BALL-JOINT-GN-648.8-1-10
BALL-JOINT-GN-648.8-2-10
