Zykbyk/VACLAV/1. Zawieszenie/13. Motorsport/PUTM-H-Assembly/PUTM-H-EB-Cable_Clams-Assembly.SLDASM

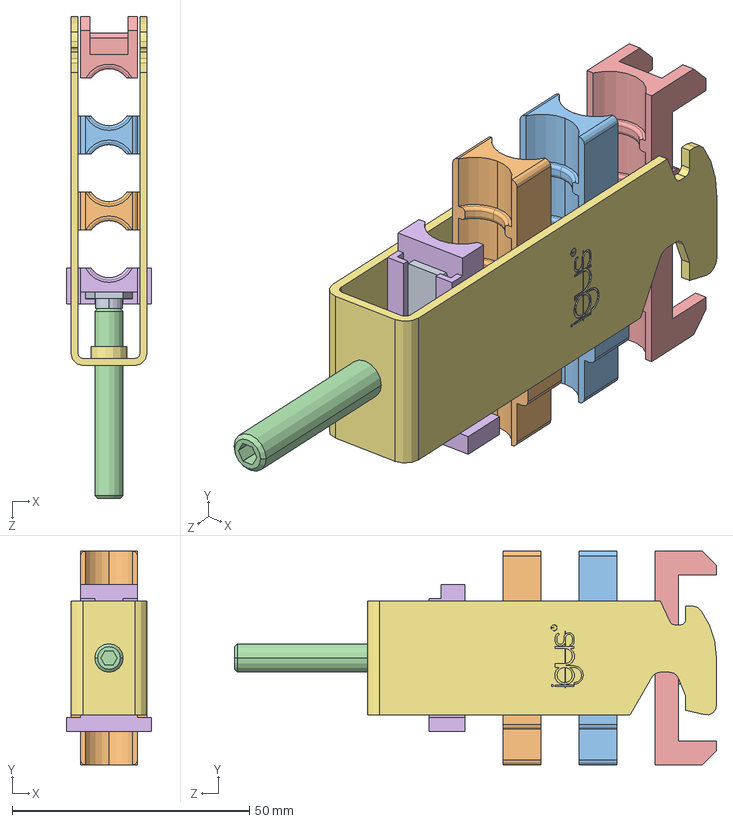
[picture p111: CAD file, 2021-10-25]
1. Zawieszenie/13. Motorsport/PUTM-H-Assembly/PUTM-H-EB-Cable_Clams-Assembly.SLDASM
18.0 x 45.0 x 101.5 mm
CFXL12.3.stp
CFXL12.3-0.stp
CFXL12.3-1.stp
CFXL12.3-2.stp
CFXL12.3-3.stp
CFXL12.3-4.stp
CFXL12.3-5.stp
