Zykbyk/VACLAV/1. Zawieszenie/13. Motorsport/PUTM-S-Assembly/PUTM-S-SF-BS.sldasm

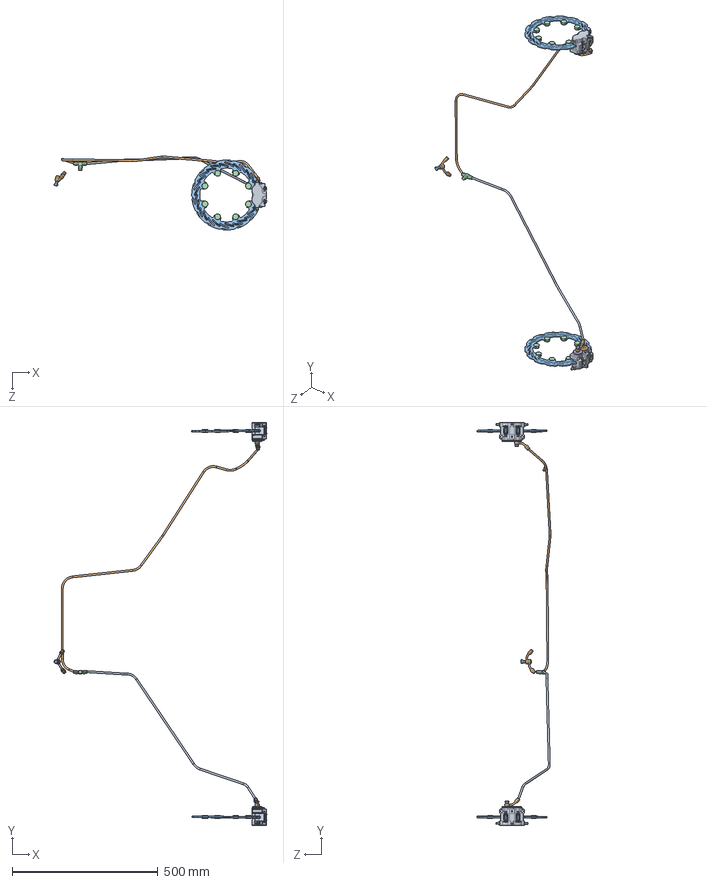
[picture p112: CAD file, 2021-10-25]
1. Zawieszenie/13. Motorsport/PUTM-S-Assembly/PUTM-S-SF-BS.sldasm
729.7 x 1380.6 x 253.8 mm
PUTM-S-SR-BS-Hose_FrontLeft
PUTM-S-SR-BS-Hose_Front_Right
PUTM-S-SF-BS-ROTORS x 2
PUTM-S-SR-BR-ISR_Brake Button x 16
PUTM-S-SF-BS-waMygga_11 x 4
PUTM-S-SF-BS-waKlosspinne_21 x 4
PUTM-S-SF-BS-waKlossplatta_301 x 8
PUTM-S-SF-BS-waKlossbelgg_311 x 8
PUTM-S-SF-BS-waKolv_41 x 8
PUTM-S-SF-BS-waLock upphjt_51 x 2
PUTM-S-SF-BS-waKula_71 x 6
PUTM-S-SF-BS-waLuftnippel_81 x 4
PUTM-S-SF-BS-waTtring_101 x 8
PUTM-S-SF-BS-waLock m nippel_171 x 2
PUTM-S-SF-BS-waM6_plugg_181 x 6
PUTM-S-SF-BS-waOring_evo2_211 x 4
PUTM-S-SF-BS-ISR 22-048-OB_241 x 2
PUTM-S-SR-BS-Banjo_end_45 x 4
PUTM-S-SR-BS-BANJO-BOLT x 3
PUTM-S-SR-BS-Triple
