Zykbyk/VACLAV/1. Zawieszenie/5. Przeniesienie wymuszeń przód/ROD-END-GN-648.2-10.SLDASM

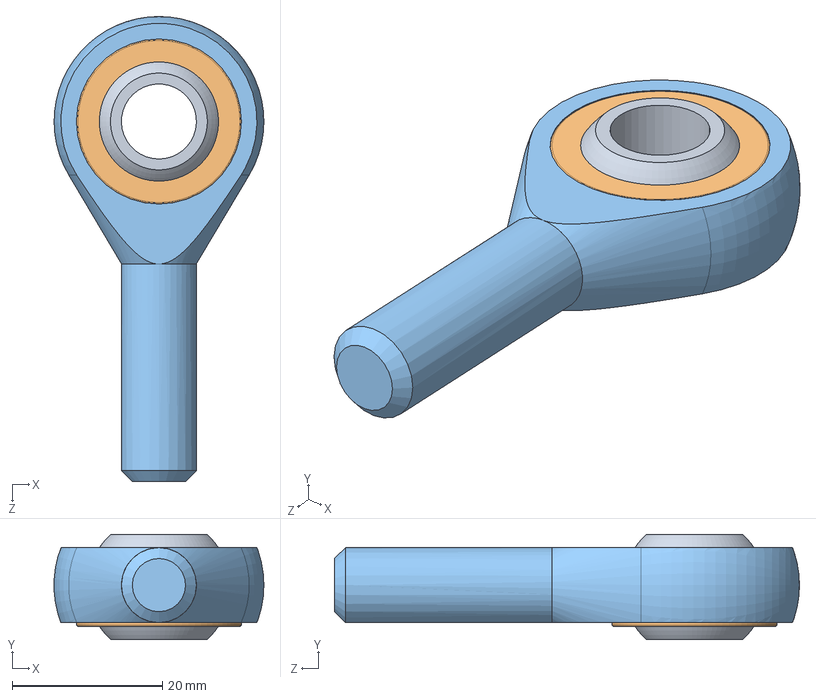
[picture p113: CAD file, 2023-01-11]
1. Zawieszenie/5. Przeniesienie wymuszeń przód/ROD-END-GN-648.2-10.SLDASM
28.0 x 14.0 x 62.0 mm
ROD-END-GN-648.2-1-10
ROD-END-GN-648.2-2-10
ROD-END-GN-648.2-3-10
