Zykbyk/VACLAV/10. Zgredek/3. Układ przeniesienia napędu/03-00-04 całość przeniesienia napędu.SLDASM

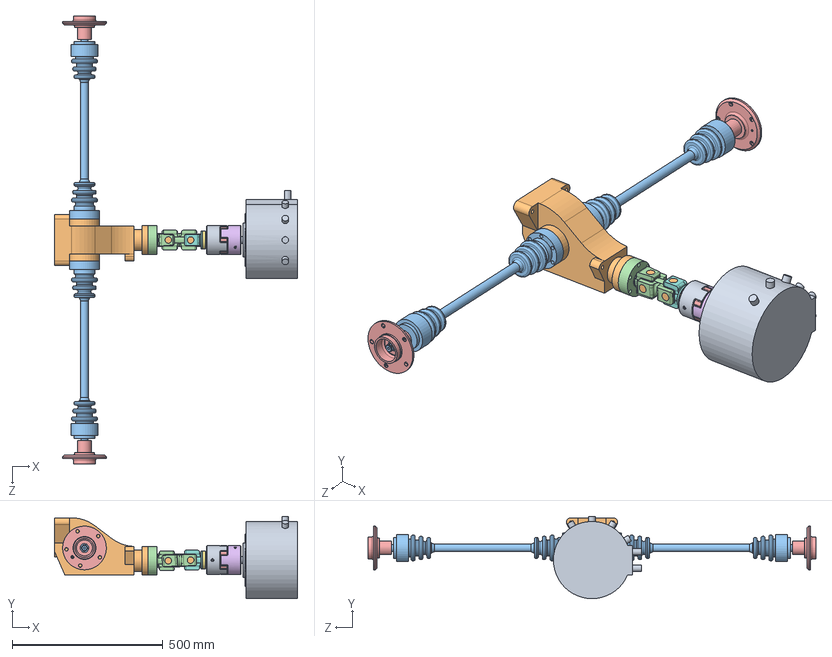
[picture p114: CAD file, 2025-03-02]
10. Zgredek/3. Układ przeniesienia napędu/03-00-04 całość przeniesienia napędu.SLDASM
807.1 x 273.0 x 1486.0 mm
03-03-00 silnik ME1616
03-06-00 krzyżak na kardan x 2
03-07-00 wpust na wałek silnika x 2
03-05-00 kardan
03-08-00 pająk
03-09-00 piasta sprzęgła
03-10-00 wałek przejściowy
03-11-00 nakładka kardanowska
03-13-00 piasta sprzęgła 2
03-01-00 dyfer e39
03-02-00 półoś e39 x 2
03-04-00 wał napędowy e39 1229144
03-12-00 piasta na koła tylne E39 x 2
