Zykbyk/VACLAV/Jacku zadecyduj/klara/KLARA W SZCZEGÓLE/mocowaniekierownicy.SLDPRT.SLDASM

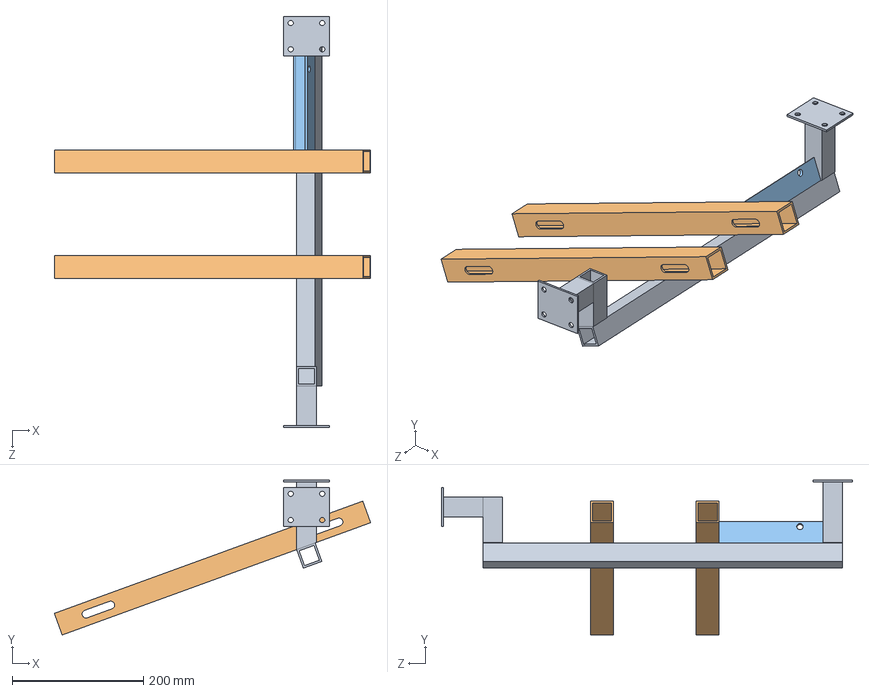
[picture p115: CAD file, 2025-03-02]
Jacku zadecyduj/klara/KLARA W SZCZEGÓLE/mocowaniekierownicy.SLDPRT.SLDASM
481.8 x 236.0 x 626.0 mm
mocowaniekierownicy
prowadnica x 2
katownikkieronica
