Zykbyk/VACLAV/Jacku zadecyduj/klara/Złożenie łańcucha 1.SLDASM

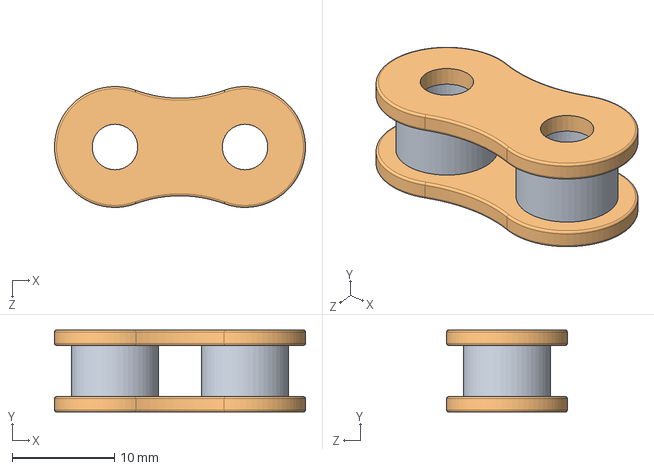
[picture p116: CAD file, 2025-03-02]
Jacku zadecyduj/klara/Złożenie łańcucha 1.SLDASM
24.5 x 8.00 x 11.8 mm
roller x 2
Łańcuch zew. x 2
