Zykbyk/VACLAV/1. Zawieszenie/13. Motorsport/PUTM-H-Assembly/PUTM-H-TS-EB-Main_Connector.SLDPRT

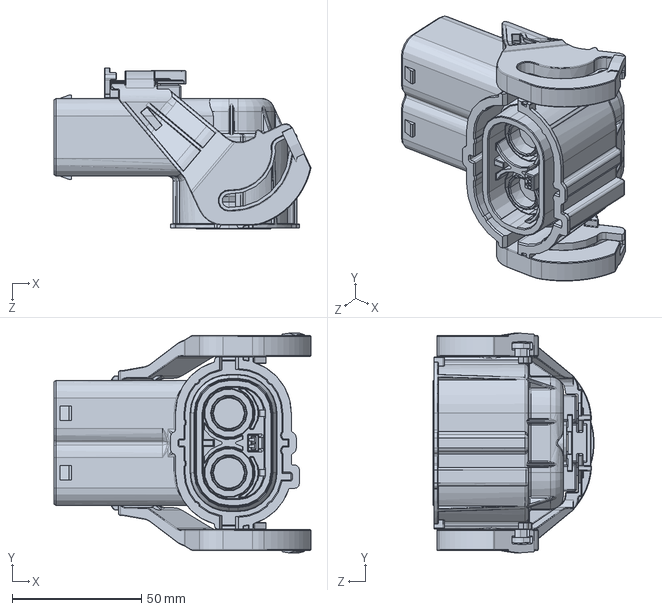
[picture p117: CAD file, 2021-10-25]
1. Zawieszenie/13. Motorsport/PUTM-H-Assembly/PUTM-H-TS-EB-Main_Connector.SLDPRT
99.3 x 85.0 x 62.3 mm
