Zykbyk/VACLAV/10. Zgredek/99. Inne/fotel nowy/ASS Siège conducteur.SLDASM

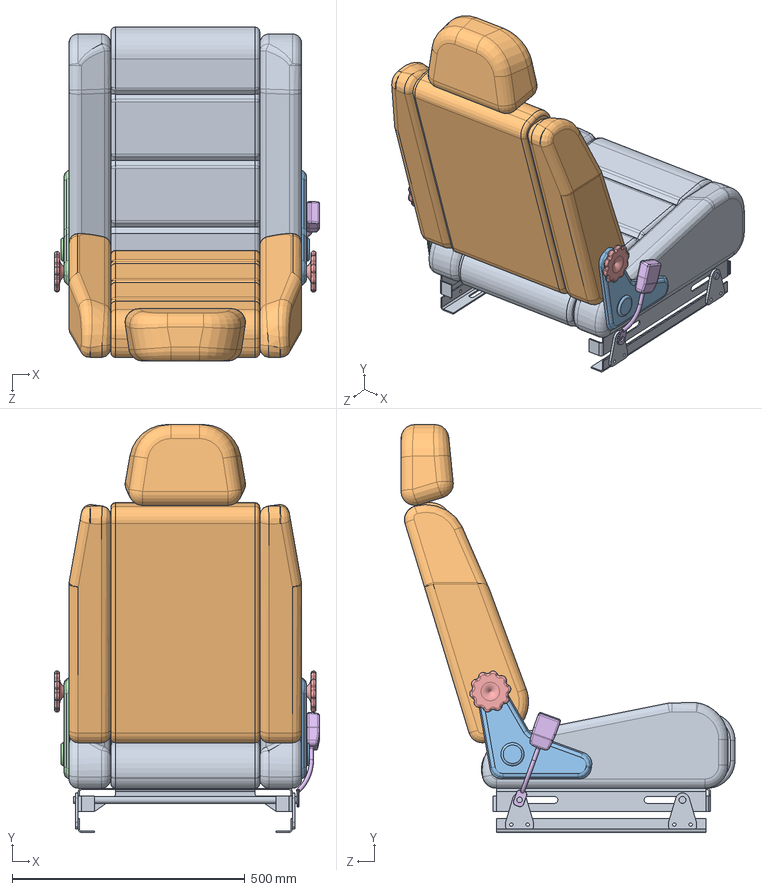
[picture p118: CAD file, 2025-03-02]
10. Zgredek/99. Inne/fotel nowy/ASS Siège conducteur.SLDASM
569.3 x 876.2 x 717.5 mm
Base siège conducteur
Dossier siège conducteur
Pivot
Pivot G
Verrouillage x 2
Boucle d ceinture
