Zykbyk/VACLAV/00.ELEMENTY ZNORMALIZOWANE/Główka przegubowa_GN 648.8/Główka przegubowa_GN 648.8_5.SLDASM

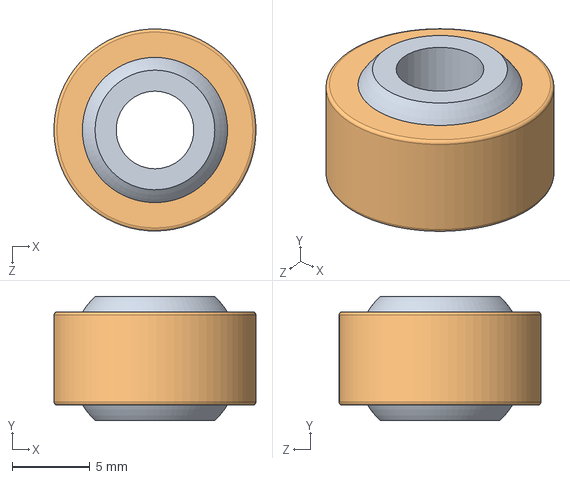
[picture p119: CAD file, 2021-10-13]
00.ELEMENTY ZNORMALIZOWANE/Główka przegubowa_GN 648.8/Główka przegubowa_GN 648.8_5.SLDASM
13.0 x 8.00 x 13.0 mm
BALL-JOINT-GN-648.8-1-5
BALL-JOINT-GN-648.8-2-5
