Zykbyk/VACLAV/1. Zawieszenie/13. Motorsport/PUTM-H-Assembly/PUTM-H-BT-BB-Fan-Assembly.SLDASM

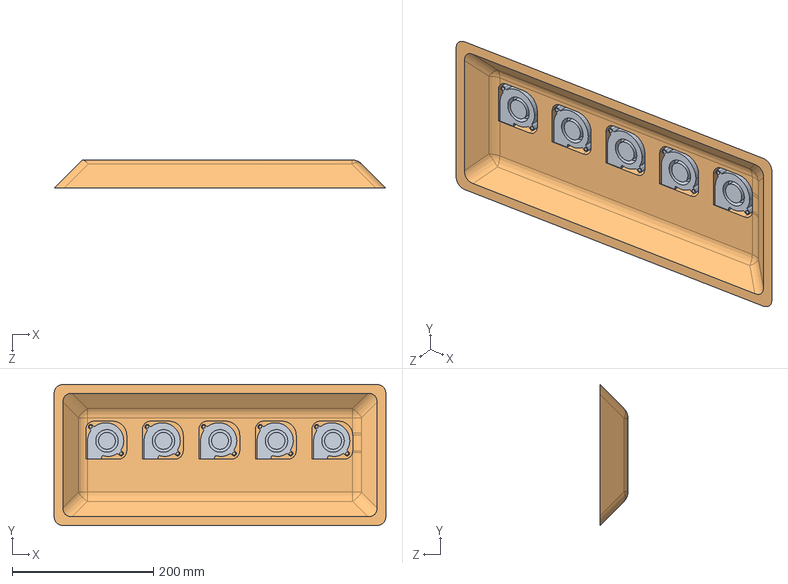
[picture p120: CAD file, 2021-10-25]
1. Zawieszenie/13. Motorsport/PUTM-H-Assembly/PUTM-H-BT-BB-Fan-Assembly.SLDASM
470.0 x 200.0 x 40.0 mm
PUTM-H-BT-BB-Fan x 5
PUTM-BT-BB-Fan_cover
