Zykbyk/VACLAV/10. Zgredek/3. Układ przeniesienia napędu/03-00-02 przeniesienie napędu 2.SLDASM

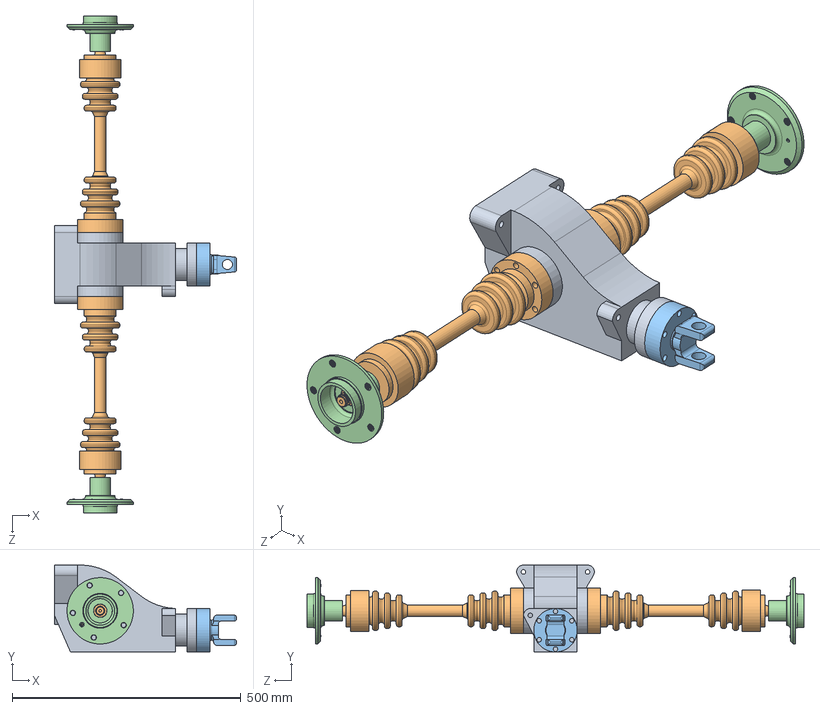
[picture p121: CAD file, 2025-03-02]
10. Zgredek/3. Układ przeniesienia napędu/03-00-02 przeniesienie napędu 2.SLDASM
398.0 x 190.0 x 1086.0 mm
03-01-00 dyfer e39
03-02-00 półoś e39 x 2
03-04-00 wał napędowy e39 1229144
03-12-00 piasta na koła tylne E39 x 2
