Zykbyk/VACLAV/1. Zawieszenie/13. Motorsport/PUTM-S-Assembly/PUTM-S-SF-DS-Pushrod.SLDASM

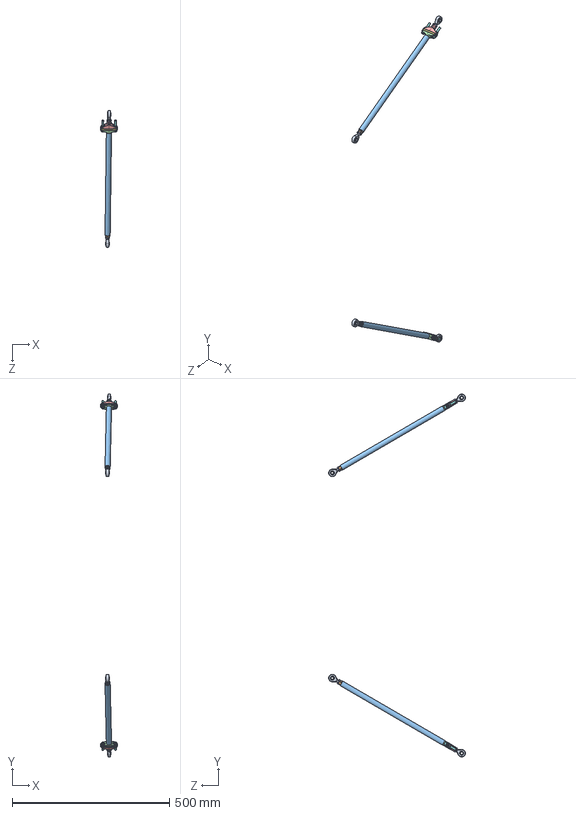
[picture p122: CAD file, 2021-10-25]
1. Zawieszenie/13. Motorsport/PUTM-S-Assembly/PUTM-S-SF-DS-Pushrod.SLDASM
54.1 x 1155.4 x 435.5 mm
PUTM-S-rodend x 4
PUTM-S-Insert-M8 x 2
PUTM-S-SF-DS x 2
PUTM-S-SF-DS-Insert-shims x 2
PUTM-S-SF-DS-Insert-shims-2 x 2
PUTM-S-DS-DIN-EN-ISO-4035 x 4
PUTM-S-SF-DS-Shims x 6
PUTM-FT-FABORY_ISO912 x 4
PUTM-FT-FABORY_DIN985 x 4
