Zykbyk/VACLAV/Jacku zadecyduj/klara/Łańcuch do złożenia v2.SLDASM

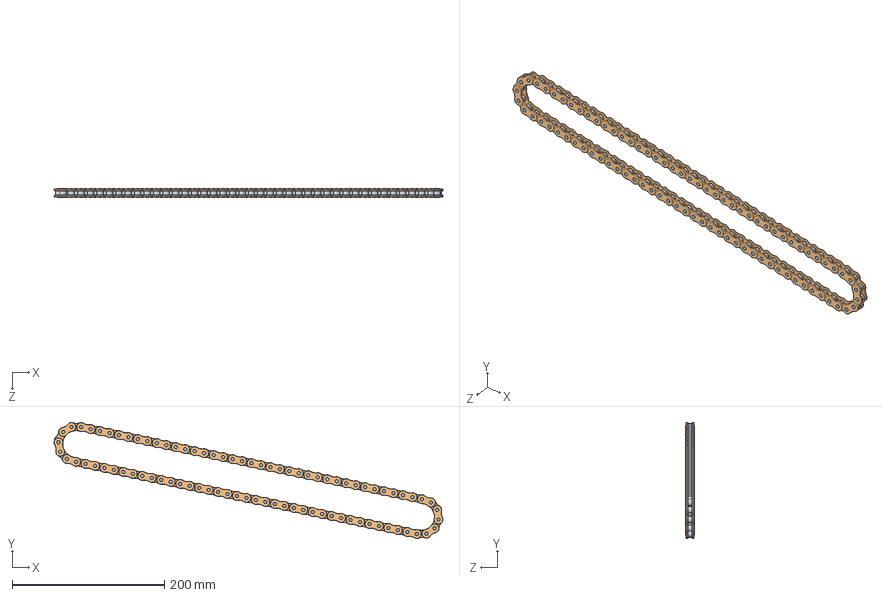
[picture p123: CAD file, 2025-03-02]
Jacku zadecyduj/klara/Łańcuch do złożenia v2.SLDASM
510.6 x 152.3 x 11.2 mm
roller x 84
Łańcuch zew. x 168
sworzeń x 84
