Zykbyk/VACLAV/00.ELEMENTY ZNORMALIZOWANE/Przegub kulowy_GN 648.2/Przegub kulowy_GN 648.2_14.SLDASM

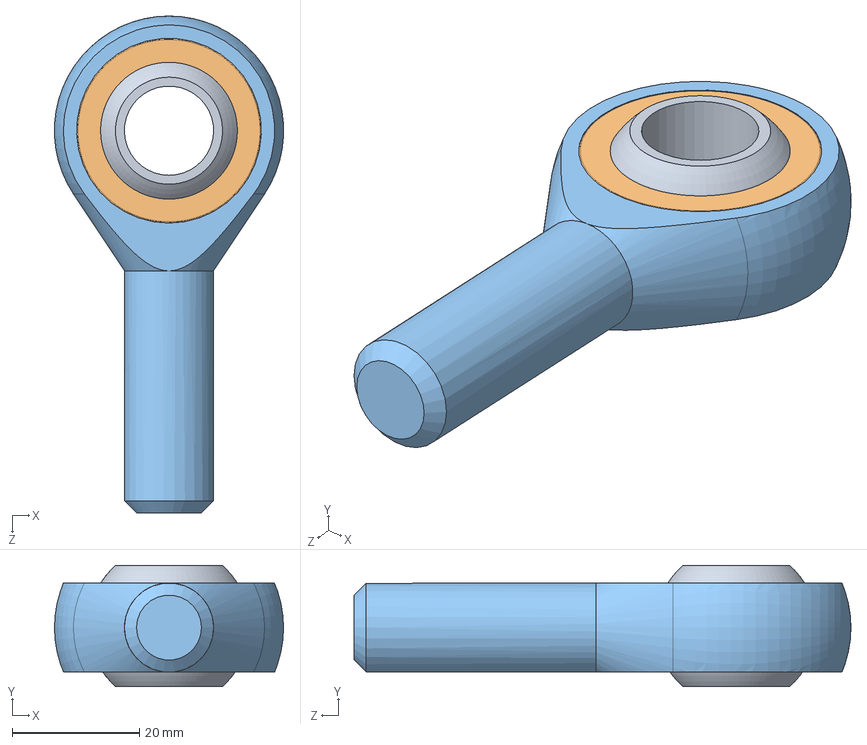
[picture p124: CAD file, 2021-10-13]
00.ELEMENTY ZNORMALIZOWANE/Przegub kulowy_GN 648.2/Przegub kulowy_GN 648.2_14.SLDASM
36.0 x 19.0 x 78.0 mm
ROD-END-GN-648.2-1-14
ROD-END-GN-648.2-2-14
ROD-END-GN-648.2-3-14
