Zykbyk/VACLAV/1. Zawieszenie/13. Motorsport/PUTM-S-Assembly/PUTM-S-SF-AB.SLDASM

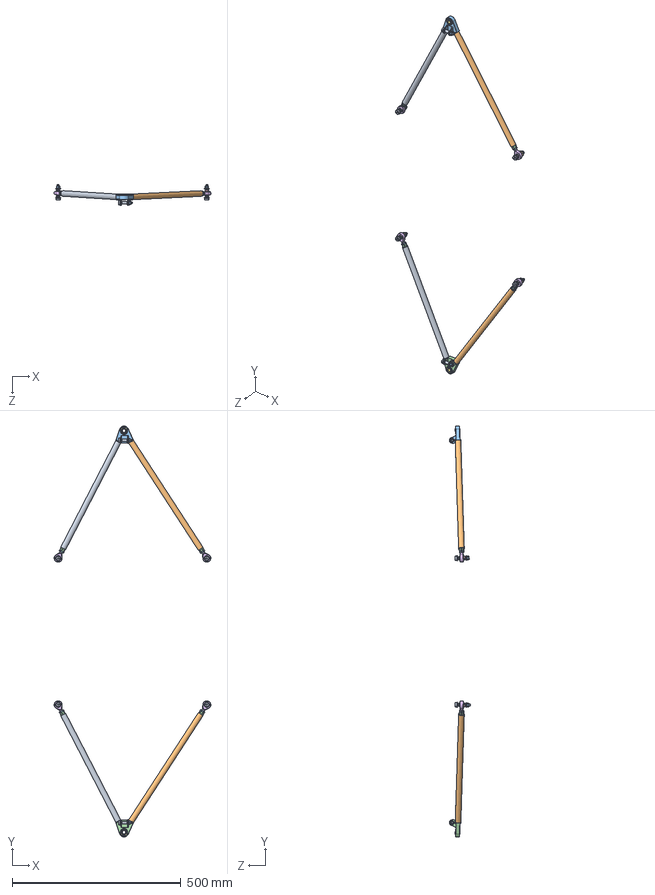
[picture p125: CAD file, 2021-10-25]
1. Zawieszenie/13. Motorsport/PUTM-S-Assembly/PUTM-S-SF-AB.SLDASM
464.0 x 1216.4 x 63.2 mm
PUTM-S-SF-AB-Tube-R x 2
PUTM-S-SF-AB-Tube-F x 2
PUTM-S-SF-AB-Connector
PUTM-S-Insert-M8 x 4
PUTM-S-Mush x 12
PUTM-S-rodend x 4
PUTM-S-GXSW-10-22-MS x 2
PUTM-S-DIN-EN-ISO-4035 x 4
PUTM-FT-ELESA_ISO7379 x 6
PUTM-FT-FABORY_ISO7089 x 16
PUTM-FT-FABORY_DIN985 x 6
LustroPUTM-S-SF-AB
