Zykbyk/VACLAV/Jacku zadecyduj/klara/Kolumna kierownicza.SLDASM

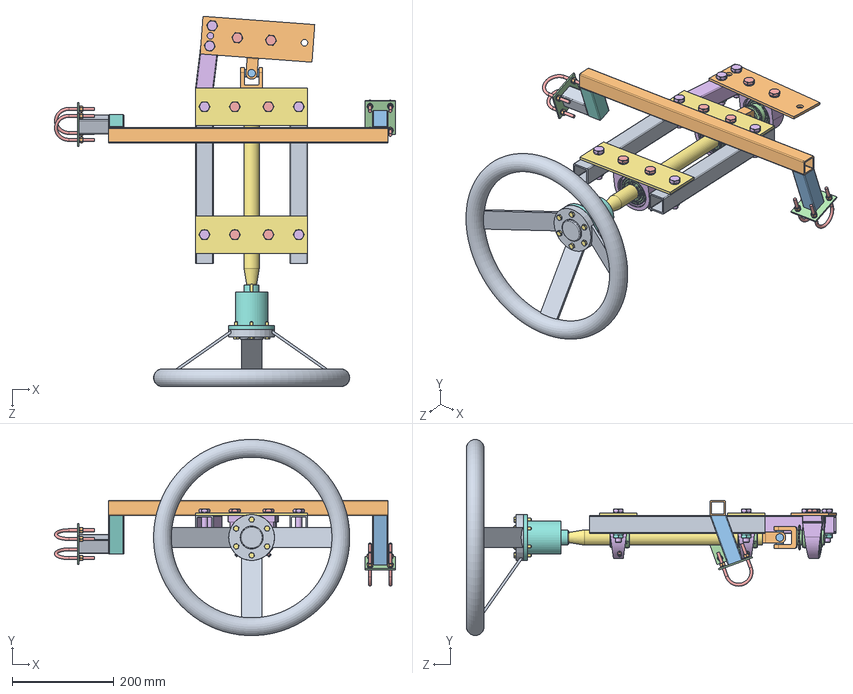
[picture p126: CAD file, 2025-03-02]
Jacku zadecyduj/klara/Kolumna kierownicza.SLDASM
669.0 x 384.7 x 726.6 mm
belka nośna wzdłóżna x 2
belka nośna poprzeczna
belka wspornikowa pionowa
blacha mocująca x 2
obejma gwintowana x 4
brlka nośna skośna
blacha nośna x 2
belka wspornikowa pionowa mała
belka poprzeczna mała
blacha nośna wachliwa
30-62-38.1-18-ucpa--9.525-46.5 x 24
UC 206-39.862-b x 3
1_4-28 UNF x 3
PA 206 -h x 3
Wał kierownicy
Naba
kierownica
widelec kardana x 2
krzyżak kardana
koło z18
śruba m12 l23 x 6
śruba m12 l50 x 6
śruba m6 l20 x 6
nakrętka m12 x 6
nordlock m12 x 6
nakrętka m6 + nordlock x 8
