Zykbyk/VACLAV/1. Zawieszenie/13. Motorsport/PUTM-F-Assembly/PUTM-F-FR-MT-Box-Mountings.sldasm

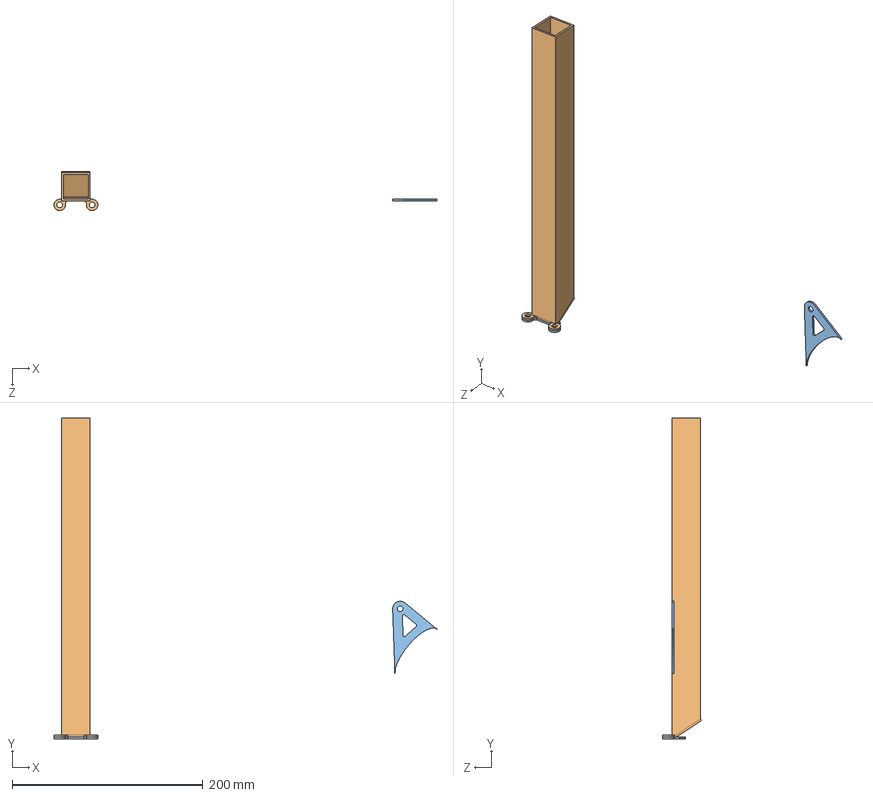
[picture p127: CAD file, 2021-10-25]
1. Zawieszenie/13. Motorsport/PUTM-F-Assembly/PUTM-F-FR-MT-Box-Mountings.sldasm
401.5 x 336.4 x 41.1 mm
PUTM-F-FR-MT-Box-Bar-Fixing
PUTM-F-FR-MT-Box-Mounting-Bar
PUTM-F-FR-MT-Rear-Box-Fixing
