Zykbyk/VACLAV/Jacku zadecyduj/klara/KLARA W SZCZEGÓLE/uchwyt pedału.SLDASM

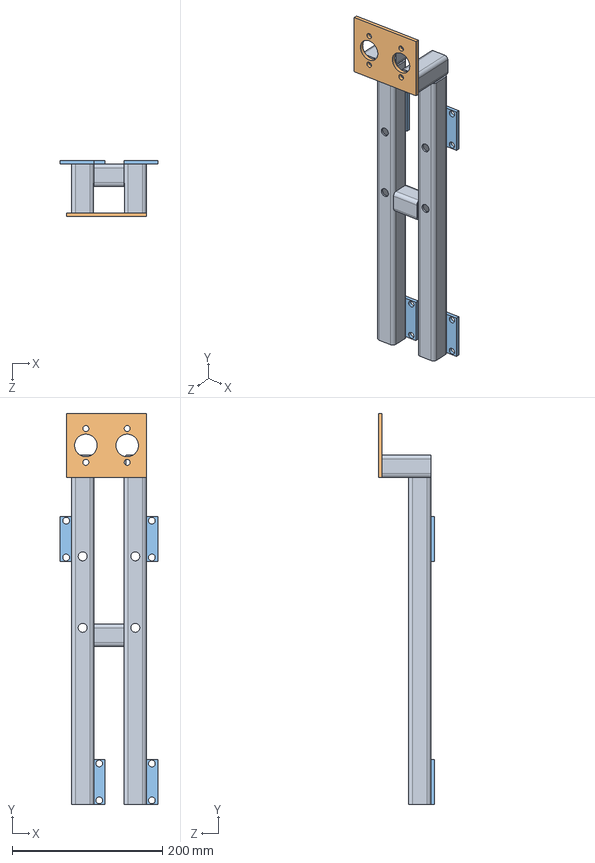
[picture p128: CAD file, 2025-03-02]
Jacku zadecyduj/klara/KLARA W SZCZEGÓLE/uchwyt pedału.SLDASM
130.0 x 520.0 x 75.0 mm
rama pedału
plytapompapedał
płytkahamulca2 x 4
