Zykbyk/VACLAV/1. Zawieszenie/1. Wahacze/ELEMENTY ZNORMALIZOWANE/Główka przegubowa_GN 648.8/Główka przegubowa_GN 648.8_8.SLDASM

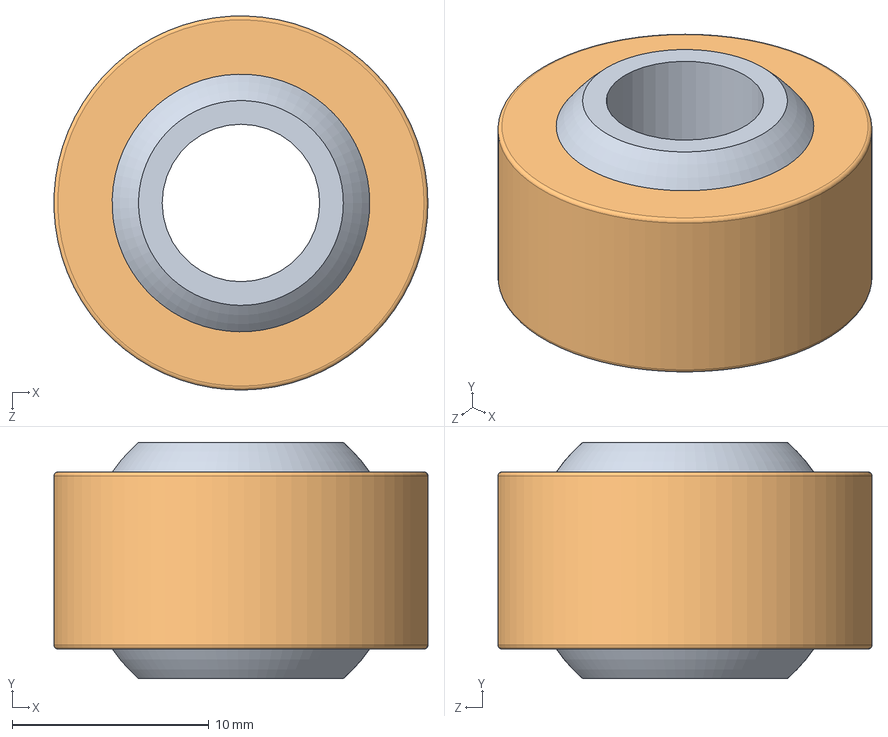
[picture p129: CAD file, 2021-10-13]
1. Zawieszenie/1. Wahacze/ELEMENTY ZNORMALIZOWANE/Główka przegubowa_GN 648.8/Główka przegubowa_GN 648.8_8.SLDASM
19.0 x 12.0 x 19.0 mm
BALL-JOINT-GN-648.8-1-8
BALL-JOINT-GN-648.8-2-8
