Zykbyk/VACLAV/1. Zawieszenie/13. Motorsport/PUTM-A-assembly/PUTM-A-MT-assembly.SLDASM

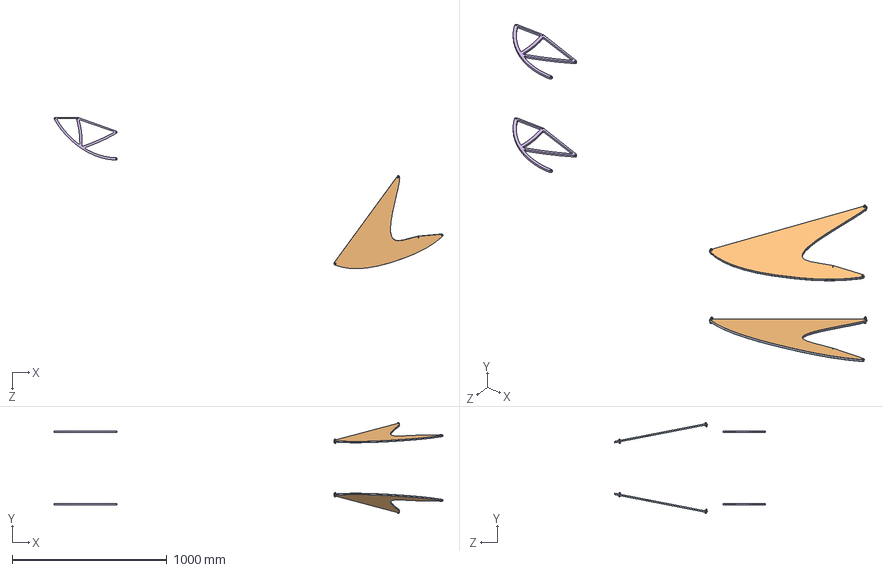
[picture p130: CAD file, 2021-10-25]
1. Zawieszenie/13. Motorsport/PUTM-A-assembly/PUTM-A-MT-assembly.SLDASM
2510.5 x 589.9 x 977.0 mm
PUTM-A-MT-RWswanneck
PUTM-A-MT-RWswanneck_c
PUTM-FT-FABORY_ISO7089 x 8
PUTM-FT-FABORY_DIN7984 x 4
PUTM-FT-FABORY_DIN985 x 4
PUTM-A-MT-FWswanneck
