Zykbyk/VACLAV/1. Zawieszenie/13. Motorsport/PUTM-S-Assembly/PUTM-S-TR-GR-Motor-Attachment-Assembly.sldasm

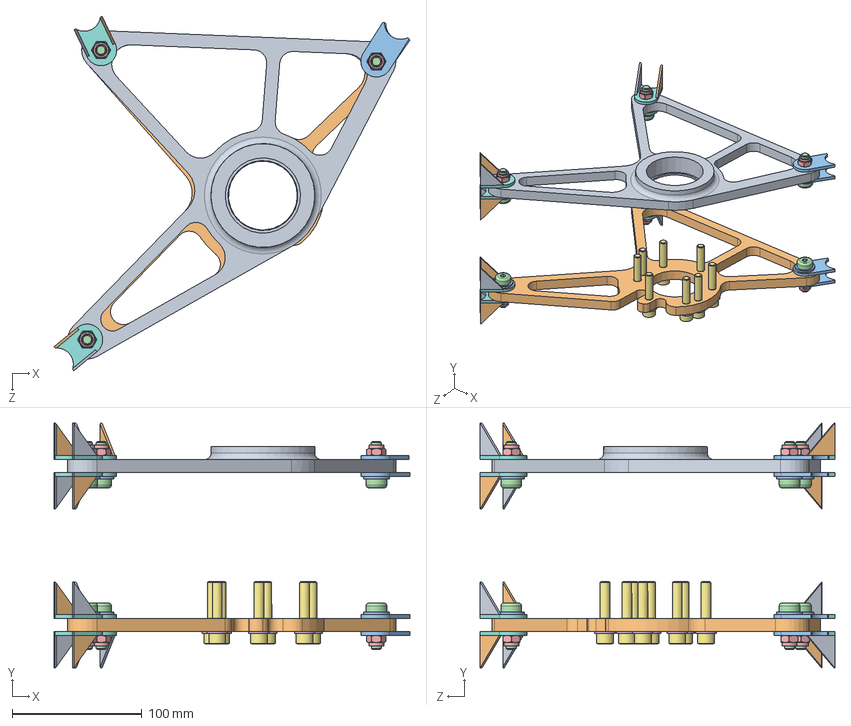
[picture p131: CAD file, 2021-10-25]
1. Zawieszenie/13. Motorsport/PUTM-S-Assembly/PUTM-S-TR-GR-Motor-Attachment-Assembly.sldasm
274.3 x 188.5 x 273.2 mm
PUTM-S-TR-GR-Motor-Attachment-Left
PUTM-S-TR-GR-Motor-Attachment-Right
PUTM-S-TR-GR-DIN-125-A2 x 6
PUTM-S-TR-GR-ISO-7379-10-M8x16 x 6
PUTM-S-TR-GR-DIN 985-M8 x 6
PUTM-S-TR-GR-DIN-125-M8-A x 8
PUTM-S-TR-GR-ISO-4762-M8x40-A2 x 8
PUTM-S-TR-GR-Motor-Attachment-1 x 8
PUTM-S-TR-GR-Motor-Attachment-2 x 7
PUTM-S-TR-GR-Motor-Attachment-3 x 7
PUTM-S-TR-GR-Motor-Attachment-1-35 x 4
