Zykbyk/VACLAV/00.ELEMENTY ZNORMALIZOWANE/Główka przegubowa_GN 648.8/Główka przegubowa_GN 648.8_14.SLDASM

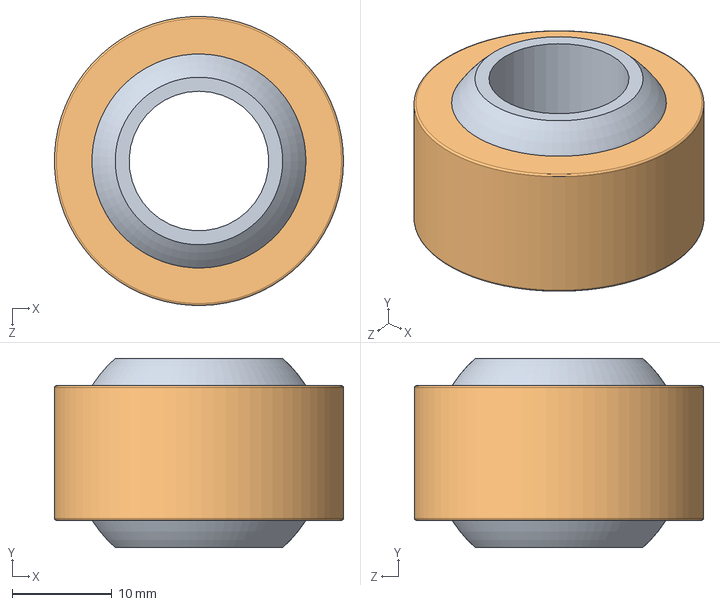
[picture p132: CAD file, 2021-10-13]
00.ELEMENTY ZNORMALIZOWANE/Główka przegubowa_GN 648.8/Główka przegubowa_GN 648.8_14.SLDASM
29.0 x 19.0 x 29.0 mm
BALL-JOINT-GN-648.8-1-14
BALL-JOINT-GN-648.8-2-14
