Zykbyk/VACLAV/1. Zawieszenie/13. Motorsport/PUTM-G-Assembly/PUTM-G-AM-LV_Battery-Basket-Assembly(29.10.2019).SLDASM

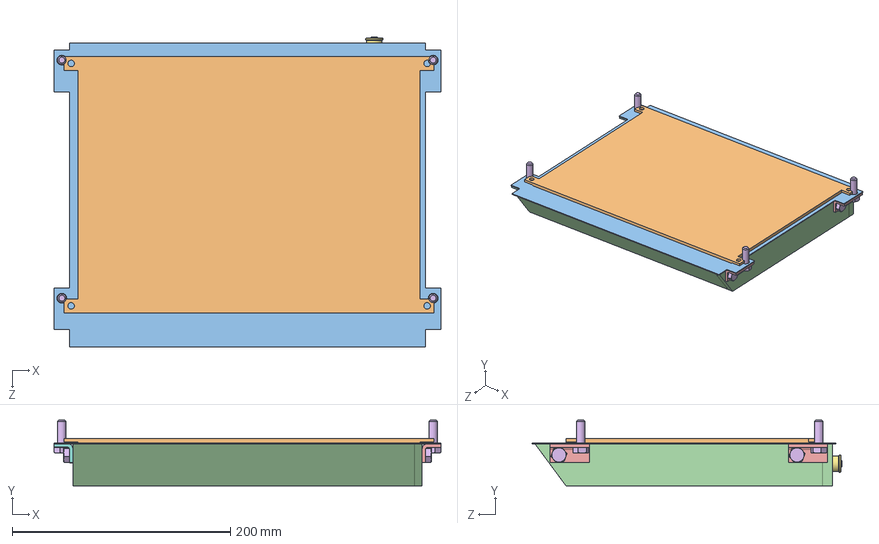
[picture p133: CAD file, 2021-10-25]
1. Zawieszenie/13. Motorsport/PUTM-G-Assembly/PUTM-G-AM-LV_Battery-Basket-Assembly(29.10.2019).SLDASM
354.4 x 60.4 x 284.3 mm
PUTM-H-BT-BB-Cell x 8
PUTM-G-AM-Connector
PUTM-G-AM-BMS-Base
PUTM-G-AM-BMS
PUTM-G-AM-LV-Basket
PUTM-G-AM-LV-Box
PUTM-G-AM-LV-Box-Mounting x 2
PUTM-FT-FABORY_DIN933 x 8
PUTM-FT-FABORY_DIN98 x 4
PUTM-G-AM-LV-Box-Mounting-L x 2
