Zykbyk/VACLAV/Jacku zadecyduj/klara/Łańcuch do złożenia.SLDASM

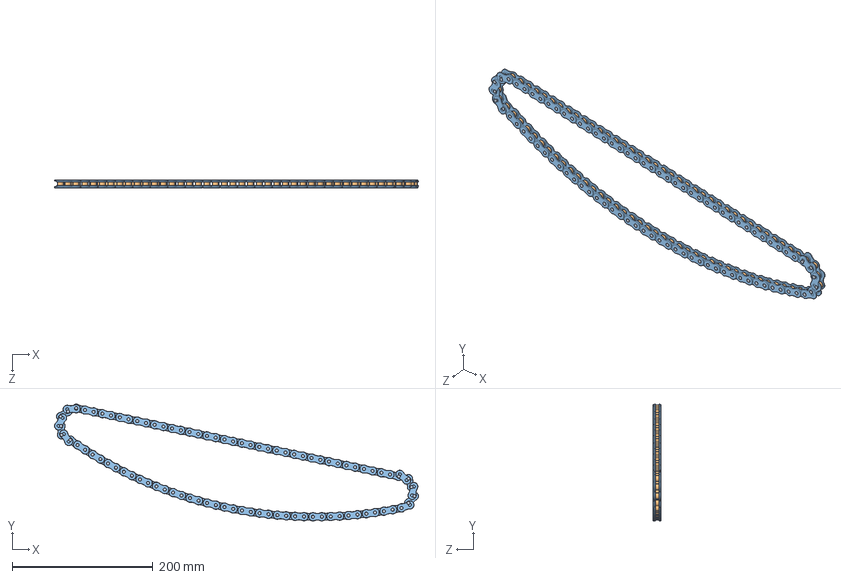
[picture p134: CAD file, 2025-03-02]
Jacku zadecyduj/klara/Łańcuch do złożenia.SLDASM
516.9 x 166.1 x 11.2 mm
sworzeń x 86
roller x 86
Łańcuch zew. x 172
