Zykbyk/VACLAV/1. Zawieszenie/13. Motorsport/PUTM-D-Driver/PUTM-D-Driver.SLDASM

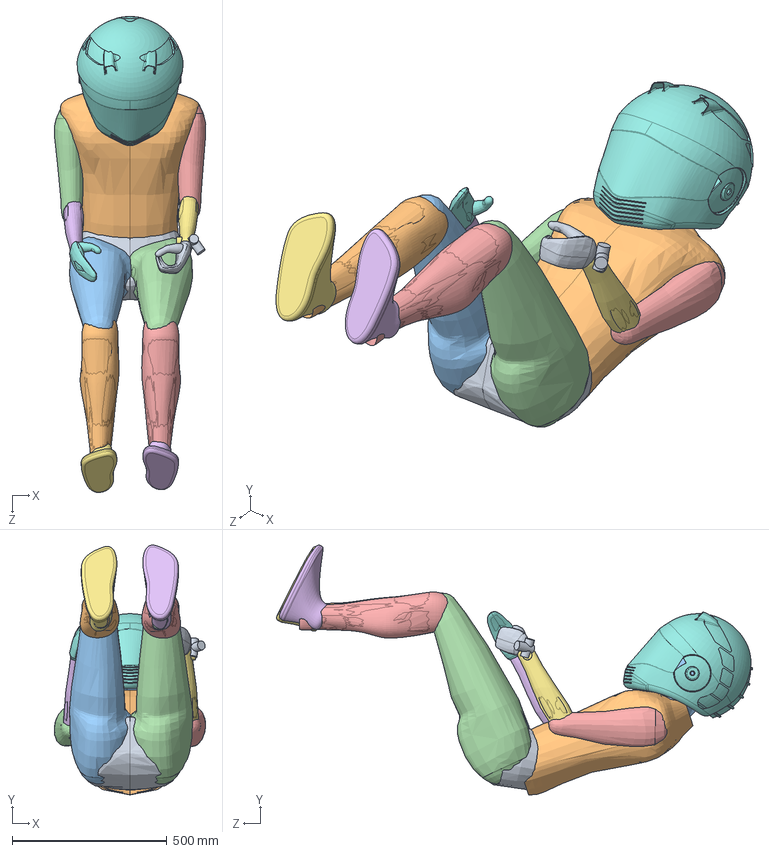
[picture p135: CAD file, 2021-10-25]
1. Zawieszenie/13. Motorsport/PUTM-D-Driver/PUTM-D-Driver.SLDASM
490.3 x 808.7 x 1540.5 mm
PUTM-D-Miednica
PUTM-D-Korpus
PUTM-D-Głowa
PUTM-D-Prawe_ramie
PUTM-D-Lewe_ramie
PUTM-D-Prawe_przedramie
PUTM-D-Lewe_przedramie
PUTM-D-Prawa_dlon
PUTM-D-Lewa_dlon
PUTM-D-Prawa_lydka
PUTM-D-Prawe_udo
PUTM-D-Lewe_udo
PUTM-D-Lewa_lydka
PUTM-D-Lewa_stopa
PUTM-D-Prawa_stopa
PUTM-D-Kask
