Zykbyk/VACLAV/1. Zawieszenie/13. Motorsport/PUTM-S-Assembly/PUTM-S-SR-WT-Upright_Assembly.SLDASM

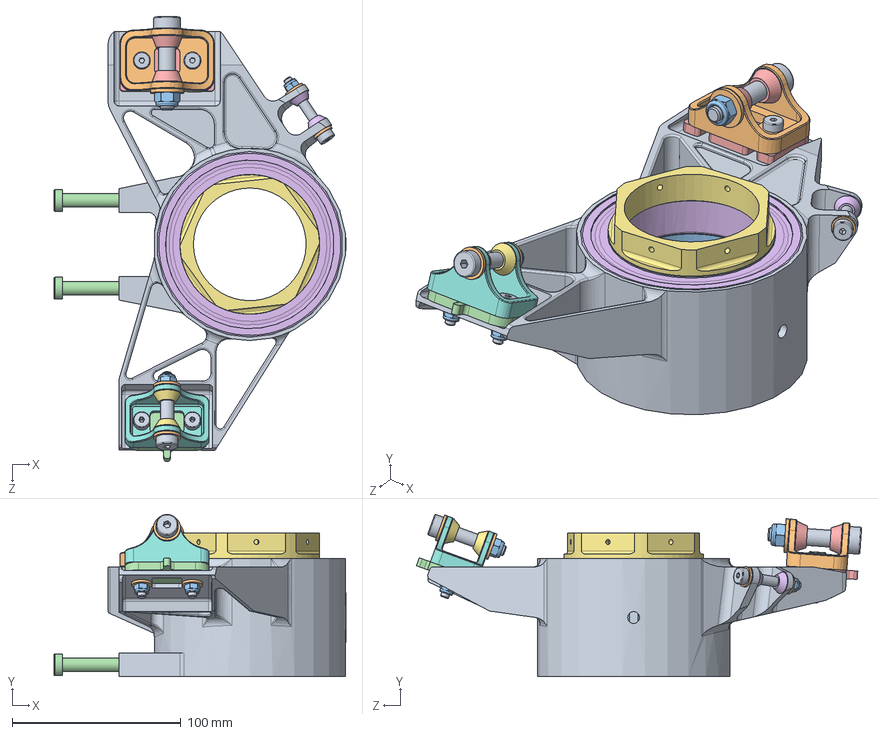
[picture p136: CAD file, 2021-10-25]
1. Zawieszenie/13. Motorsport/PUTM-S-Assembly/PUTM-S-SR-WT-Upright_Assembly.SLDASM
173.0 x 96.1 x 263.8 mm
PUTM-FT-ELESA_ISO7379 x 7
PUTM-FT-FABORY_ISO7089 x 9
PUTM-FT-FABORY_DIN985 x 7
PUTM-FT-FABORY_DIN7984 x 2
PUTM-S-Grzybek_10mm_wyzszy x 2
PUTM-S-Grzybek_6mm x 2
PUTM-S-Grzybek_8mm x 2
PUTM-S-SR-WT-U-Clevis_Upper_10mm
PUTM-S-SR-WT-Upright
PUTM-S-SR-WT-U-Clevis_bottom
PUTM-S-SR-WT-U-RearDistanceRing
PUTM-S-SR-WT-U-Shim_5mm
PUTM-S-SR-WT-U-Shim_5mm_wiekszy
PUTM-S-SR-WT-Bearing x 2
PUTM-S-SR-WT-U-Hubnut
