Zykbyk/VACLAV/00.ELEMENTY ZNORMALIZOWANE/Przegub kulowy_GN 648.2/Przegub kulowy_GN 648.2_8.SLDASM

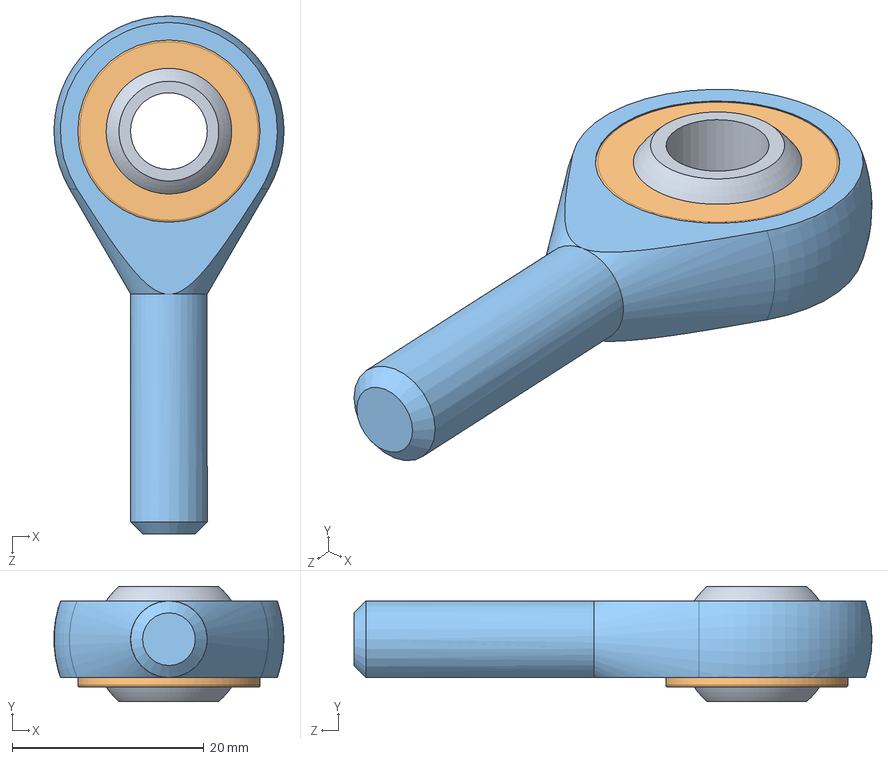
[picture p137: CAD file, 2021-10-13]
00.ELEMENTY ZNORMALIZOWANE/Przegub kulowy_GN 648.2/Przegub kulowy_GN 648.2_8.SLDASM
24.0 x 12.0 x 54.0 mm
ROD-END-GN-648.2-1-8
ROD-END-GN-648.2-2-8
ROD-END-GN-648.2-3-8
