Zykbyk/VACLAV/1. Zawieszenie/99. Pozostałe/Łukasz Golec/main plate.SLDPRT

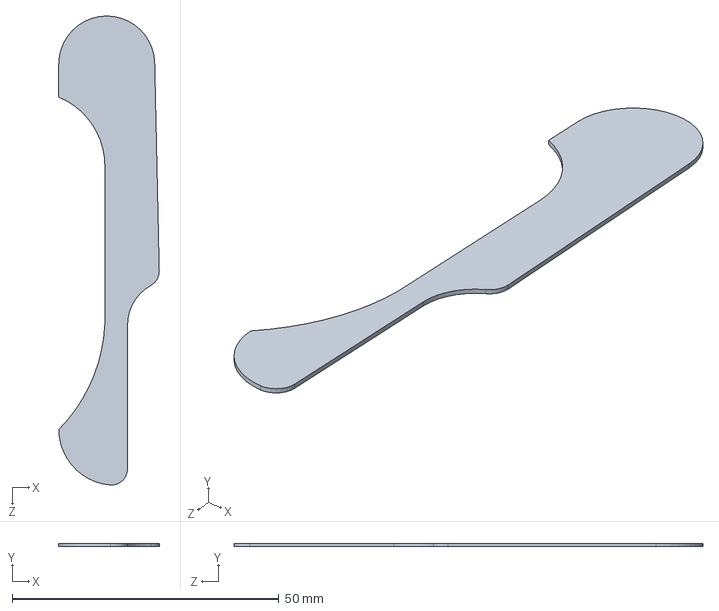
[picture p138: CAD file, 2025-03-02]
1. Zawieszenie/99. Pozostałe/Łukasz Golec/main plate.SLDPRT
18.8 x 0.625 x 87.9 mm
