Zykbyk/VACLAV/1. Zawieszenie/13. Motorsport/PUTM-F-Assembly/PUTM-F-MS-PB-Pedal_Box_Assembly.SLDASM

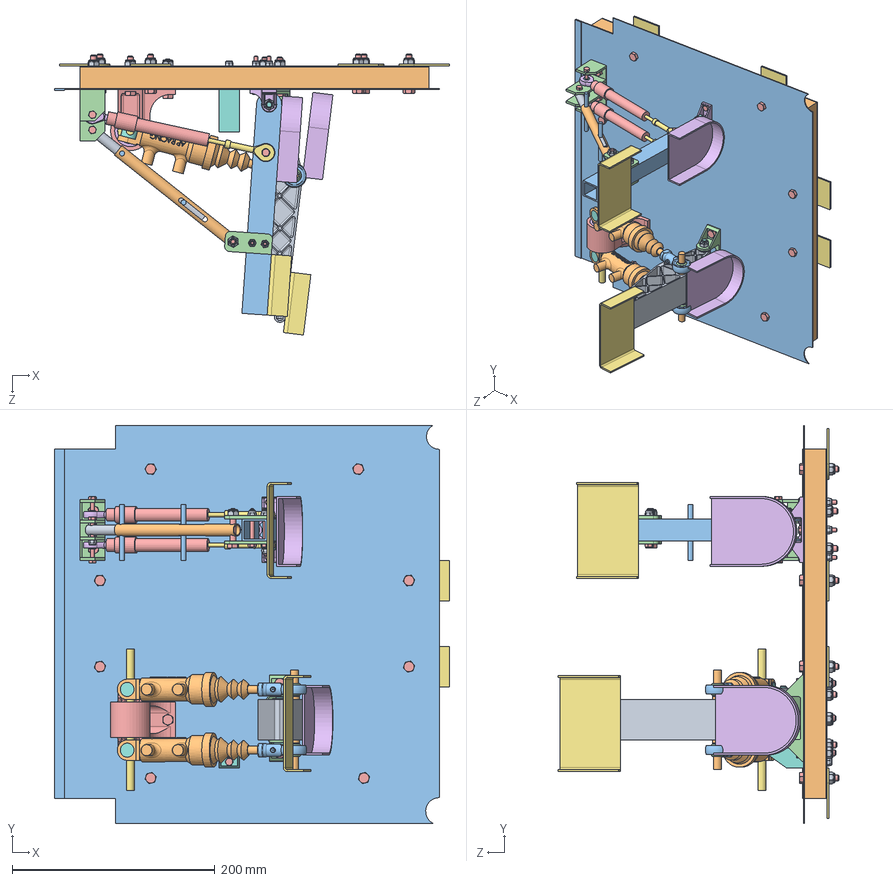
[picture p139: CAD file, 2021-10-25]
1. Zawieszenie/13. Motorsport/PUTM-F-Assembly/PUTM-F-MS-PB-Pedal_Box_Assembly.SLDASM
390.0 x 393.2 x 277.5 mm
PUTM-F-MS-PB-Floor2
PUTM-F-MS-PB-Floor1
PUTM-F-MS-PB-Floor3
PUTM-F-MS-PB-Suport_Brake_Pedal
PUTM-F-MS-PB-Bearing x 4
PUTM-F-MS-PB-Footcatcher2 x 2
PUTM-F-MS-PB-Footcatcher x 2
PUTM-FT-ELESA_ISO7379 x 2
PUTM-FT-FABORY_DIN985 x 30
PUTM-F-MS-PB-AP_Racing_CP7854_Body x 2
_Ball joint with female thread GN 648.1-8-M8-N-1.stp x 2
_Ball joint with female thread GN 648.1-8-M8-N-2.stp x 2
PUTM-F-MS-PB-Brake_Pedal_Suport
PUTM-F-MS-PB-Balance_bar_1
PUTM-F-MS-PB-Balance_bar_2
PUTM-F-MS-PB-Clevis_Pivot2 x 2
PUTM-F-MS-PB-Brake_Pedal
PUTM-F-MS-PB-Pump_Pivot
PUTM-F-MS-PB-AccelerationPedal
PUTM-F-MS-PB-Suport2AccelerationPedal
PUTM-F-MS-PB-Linear_Sensor_RC13_3 x 2
PUTM-F-MS-PB-Linear_Sensor_RC13 x 2
PUTM-F-MS-PB-Linear_Sensor_RC13_4 x 4
PUTM-F-MS-PB-Linear_Sensor_RC13_2
PUTM-F-MS-PB-Stop1
PUTM-F-MS-PB-Stop2
PUTM-F-MS-PB-Stop_Sleeve2 x 2
PUTM-F-MS-PB-Suport_Acceleration_3
PUTM-FT-FABORY_DIN933 x 28
PUTM-F-MS-PB-SuportAccelerationPedal
PUTM-F-MS-PB-PedalBox_Mounting x 8
PUTM-F-MS-PB-Suport_Overtravel
