Zykbyk/VACLAV/1. Zawieszenie/13. Motorsport/PUTM-H-Assembly/PUTM-H-CS- assembly.SLDASM

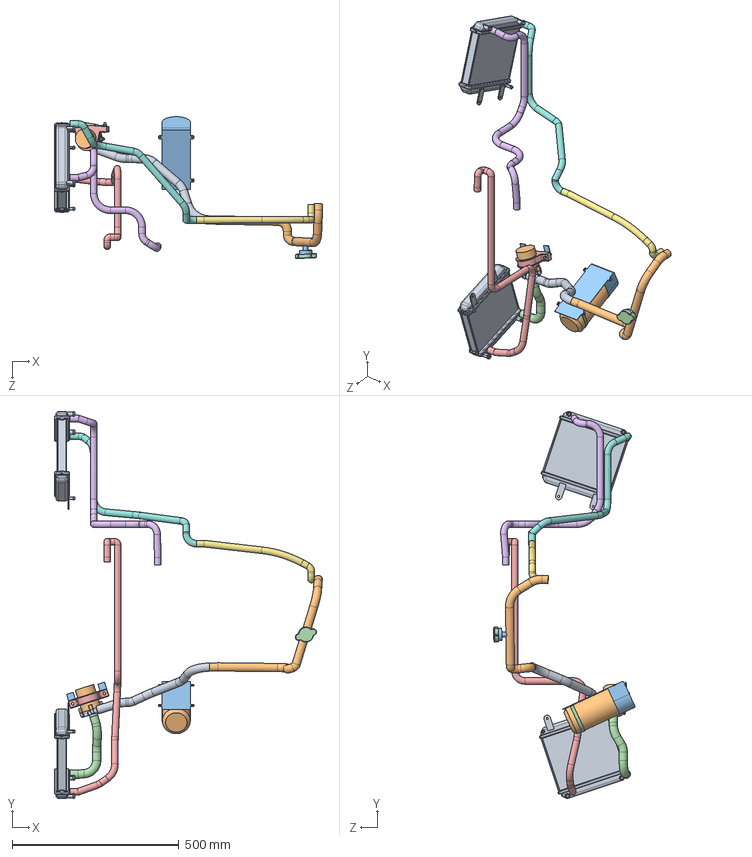
[picture p140: CAD file, 2021-10-25]
1. Zawieszenie/13. Motorsport/PUTM-H-Assembly/PUTM-H-CS- assembly.SLDASM
804.1 x 1160.6 x 425.1 mm
PUTM-H-CS-Radiator x 2
PUTM-H-CS-Catch Tank
PUTM-H-CS-Catch Tank Mount
PUTM-H-CS-Catch Tank Ring Mount
PUTM-H-CS-Controller Radiator Pipe
PUTM-H-CS-Engine Controller Pipe
PUTM-H-CS-Engine Radiator Pipe 1
PUTM-H-CS-Engine Radiator Pipe 2
PUTM-H-CS-Pump Engine Pipe 1
PUTM-H-CS-Pump Engine Pipe 2
PUTM-H-CS-Sproe
PUTM-H-CS-Valve
PUTM-H-CS-Mouting Water Pump
PUTM-H-CS-Bolt M4 Water Pump x 4
PUTM-H-CS-Bolt M6-12 x 2
PUTM-H-CS-Nut M6 x 2
PUTM-H-CS-Cover Water Pump
PUTM-H-CS-Housing Water Pump
PUTM-H-CS-Water Pump-Mouns
PUTM-H-CS-Water Pump Radiator Pipe
