Zykbyk/VACLAV/10. Zgredek/3. Układ przeniesienia napędu/03-00-01 przeniesienie napędu.SLDASM

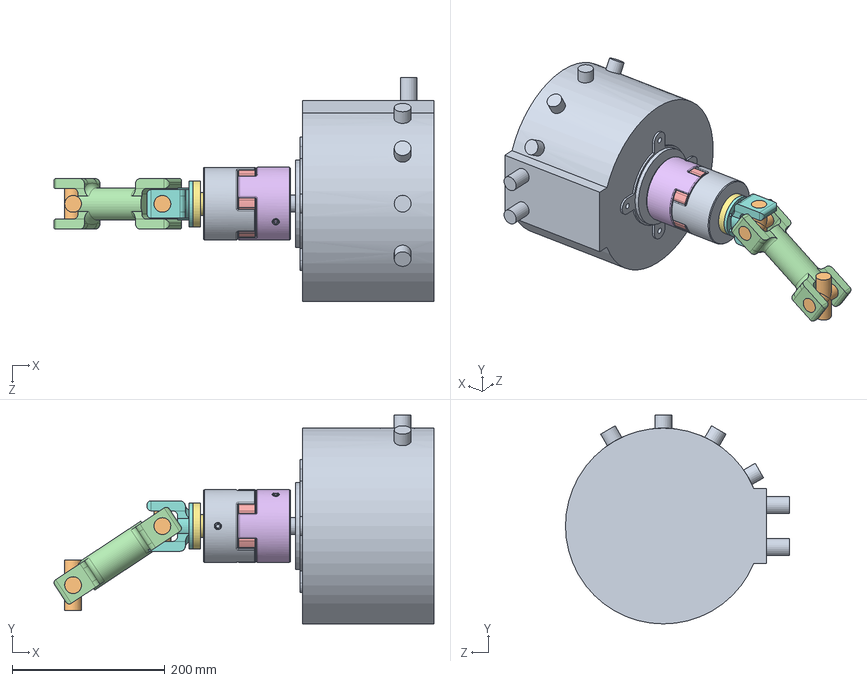
[picture p141: CAD file, 2025-03-02]
10. Zgredek/3. Układ przeniesienia napędu/03-00-01 przeniesienie napędu.SLDASM
496.8 x 273.0 x 293.0 mm
03-03-00 silnik ME1616
03-06-00 krzyżak na kardan x 2
03-07-00 wpust na wałek silnika x 2
03-05-00 kardan
03-08-00 pająk
03-09-00 piasta sprzęgła
03-10-00 wałek przejściowy
03-11-00 nakładka kardanowska
03-13-00 piasta sprzęgła 2
