Zykbyk/VACLAV/1. Zawieszenie/13. Motorsport/PUTM-G-Assembly/PUTM-G-MS-Assembly.SLDASM

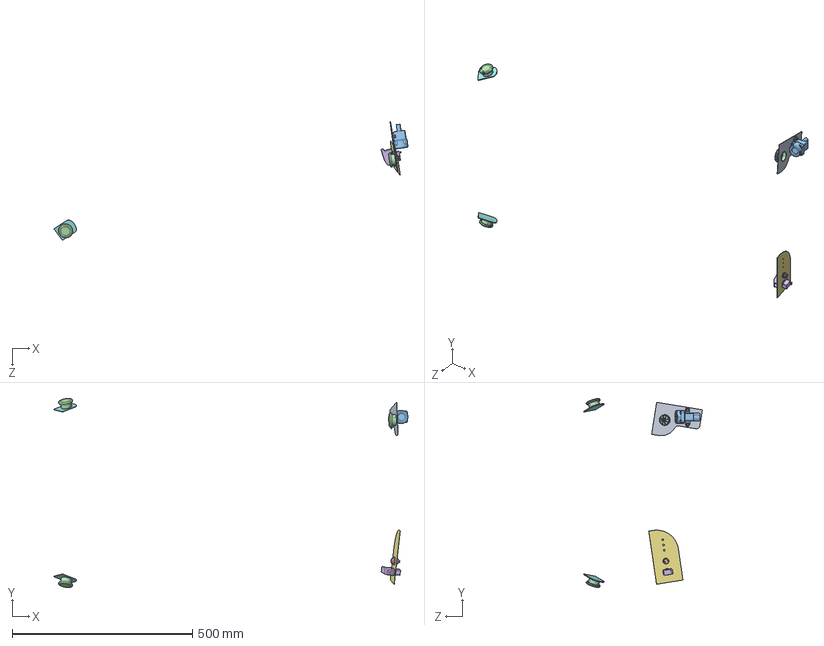
[picture p142: CAD file, 2021-10-25]
1. Zawieszenie/13. Motorsport/PUTM-G-Assembly/PUTM-G-MS-Assembly.SLDASM
982.8 x 525.0 x 330.0 mm
PUTM-G-MS-Kill-Inertia
PUTM-FT-FABORY_DIN985 x 2
PUTM-G-EB-Inertia
PUTM-G-EB-Shutdown-Button-Cockpit x 3
PUTM-G-DS-Button_Drucktaster R13-507 rot v7
PUTM-G-DS-Toggle Switch
PUTM-G-DS-Right_plate_leds
PUTM-G-EB-Kill-Switch-Mounting-Right x 2
