Zykbyk/VACLAV/1. Zawieszenie/13. Motorsport/PUTM-H-Assembly/PUTM-H-TS-BOX-Battery_Master_Switch.SLDASM

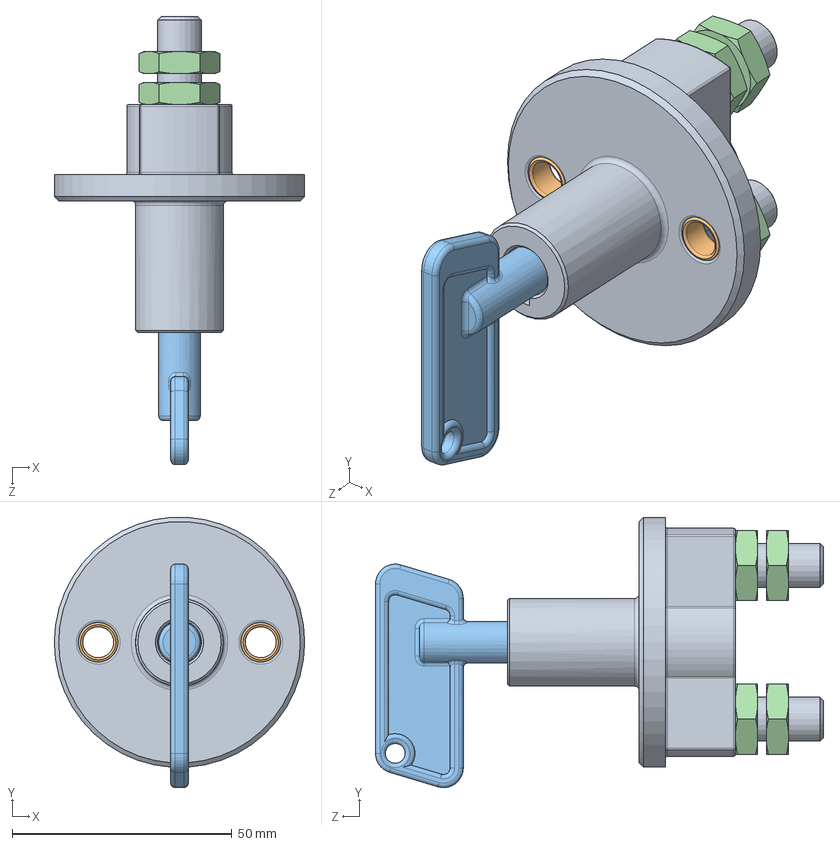
[picture p143: CAD file, 2021-10-25]
1. Zawieszenie/13. Motorsport/PUTM-H-Assembly/PUTM-H-TS-BOX-Battery_Master_Switch.SLDASM
57.0 x 61.5 x 102.0 mm
BMS Body
BMS Insert x 2
BMS Key
ISO 4035 M10 thin nut x 4
