Zykbyk/VACLAV/10. Zgredek/3. Układ przeniesienia napędu/03-00-03-Pedal_gazu.SLDASM

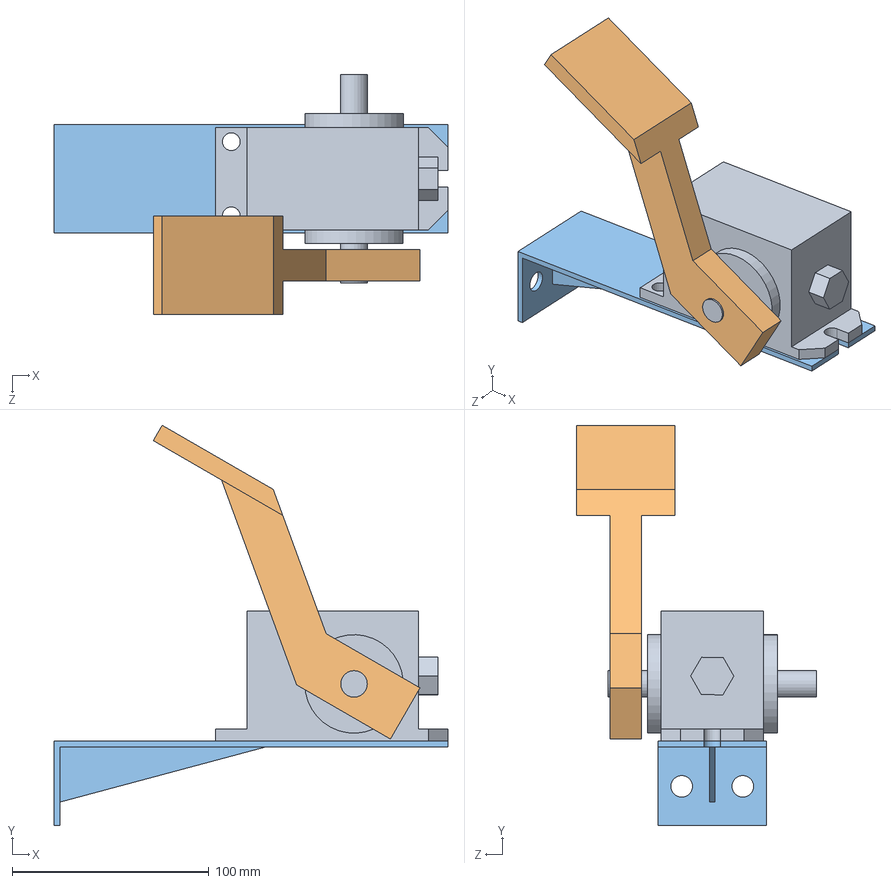
[picture p144: CAD file, 2025-03-02]
10. Zgredek/3. Układ przeniesienia napędu/03-00-03-Pedal_gazu.SLDASM
200.0 x 203.3 x 122.0 mm
03-14-00-Pedal_gazu_01
03-14-00-Pedal_gazu_02
03-14-00-Pedal_gazu_03
