Zykbyk/VACLAV/Jacku zadecyduj/klara/Złożenie łańcuszka 2.SLDASM

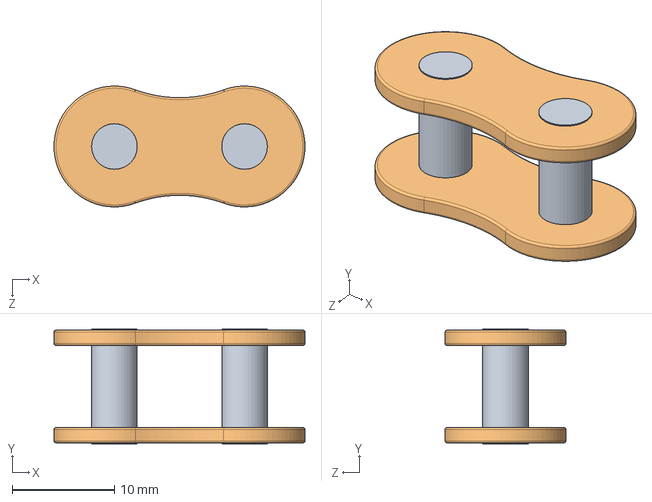
[picture p145: CAD file, 2025-03-02]
Jacku zadecyduj/klara/Złożenie łańcuszka 2.SLDASM
24.5 x 11.2 x 11.8 mm
sworzeń x 2
Łańcuch zew. x 2
