Zykbyk/VACLAV/1. Zawieszenie/13. Motorsport/PUTM-S-Assembly/PUTM-S-TR-DI-Left-Axle-Without-Tripods-Assembly.SLDASM

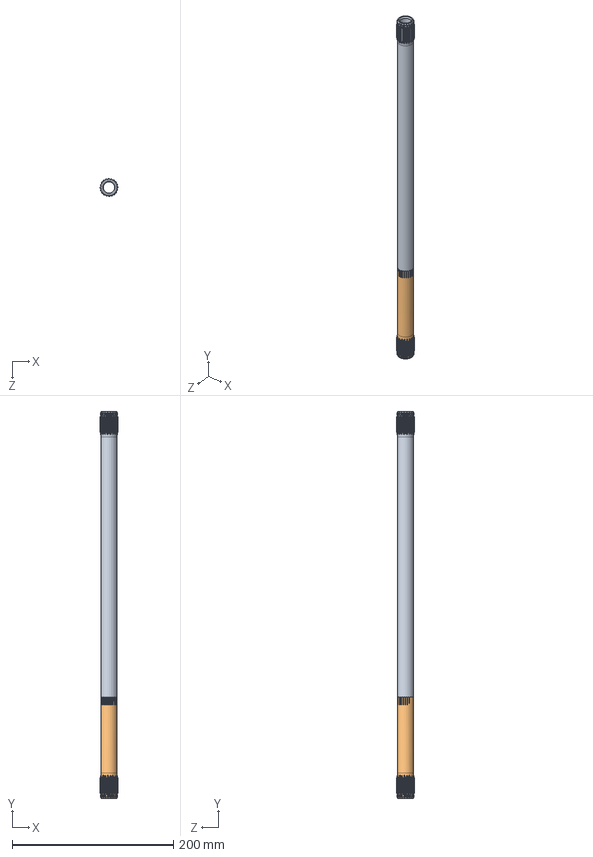
[picture p146: CAD file, 2021-10-25]
1. Zawieszenie/13. Motorsport/PUTM-S-Assembly/PUTM-S-TR-DI-Left-Axle-Without-Tripods-Assembly.SLDASM
22.3 x 480.0 x 22.3 mm
PUTM-S-TR-DI-Right-Axle-Left
PUTM-S-TR-DI-Right-Axle-Right-75mm
