Zykbyk/VACLAV/1. Zawieszenie/13. Motorsport/PUTM-F-Assembly/LustroPUTM-F-MT-RockersMountings.sldasm

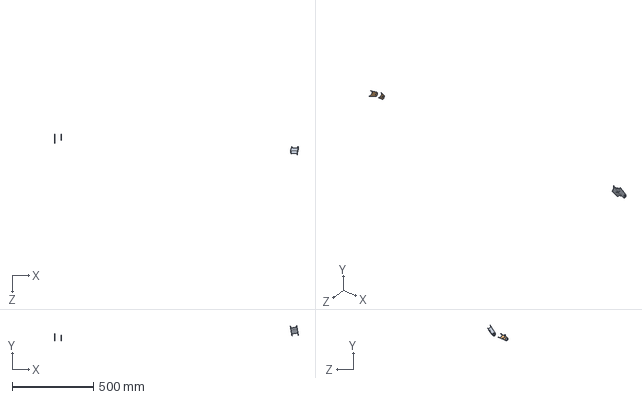
[picture p147: CAD file, 2021-10-25]
1. Zawieszenie/13. Motorsport/PUTM-F-Assembly/LustroPUTM-F-MT-RockersMountings.sldasm
1503.9 x 95.6 x 129.4 mm
LustroPUTM-F-FR-MT-LR-RockerMounting
LustroPUTM-F-FR-MT-LF-RockerMounting
