Zykbyk/VACLAV/1. Zawieszenie/13. Motorsport/PUTM-H-Assembly/PUTM-H-TS-EB-ENGINE_POWER_CABLE-Assembly.SLDASM

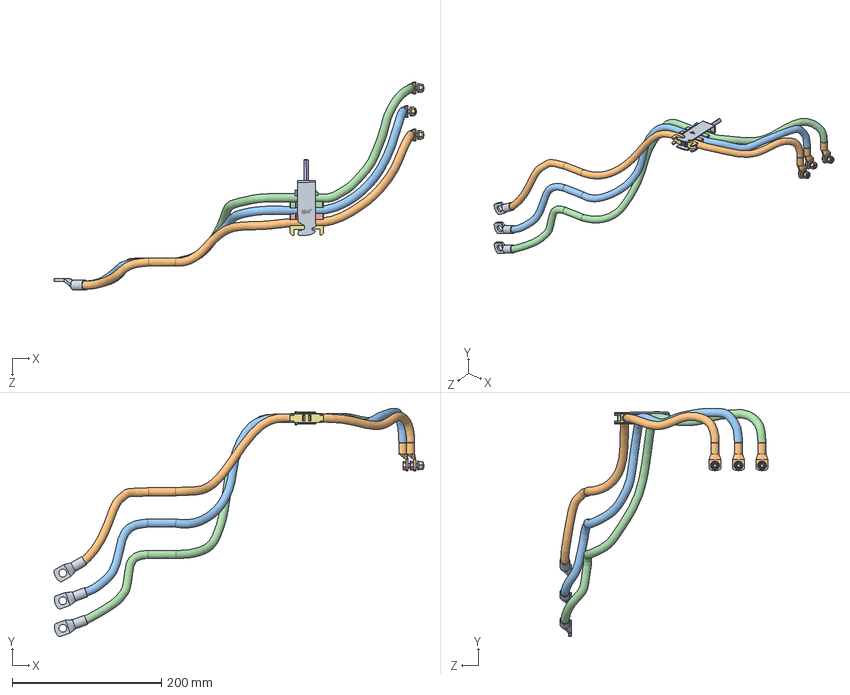
[picture p148: CAD file, 2021-10-25]
1. Zawieszenie/13. Motorsport/PUTM-H-Assembly/PUTM-H-TS-EB-ENGINE_POWER_CABLE-Assembly.SLDASM
495.6 x 305.7 x 278.4 mm
PUTM-H-TS-Cable-Lug-PK-35-10 x 3
PUTM-H-TS-Cable-Lug-PK-25-6 x 3
CFXL12.3.stp
CFXL12.3-0.stp
CFXL12.3-1.stp
CFXL12.3-2.stp
CFXL12.3-3.stp
CFXL12.3-4.stp
CFXL12.3-5.stp
PUTM-H-TS-EB-ENGINE_POWER_CABLE-Cable_U1
PUTM-H-TS-EB-ENGINE_POWER_CABLE-Cable_V2
PUTM-H-TS-EB-ENGINE_POWER_CABLE-Cable_W3
PUTM-FT-FABORY_ISO7089 x 3
PUTM-FT-FABORY_DIN933 x 3
PUTM-FT-FABORY_DIN985 x 3
