Zykbyk/VACLAV/1. Zawieszenie/13. Motorsport/PUTM-S-Assembly/PUTM-S-SF-WT-Hub-Assembly.SLDASM

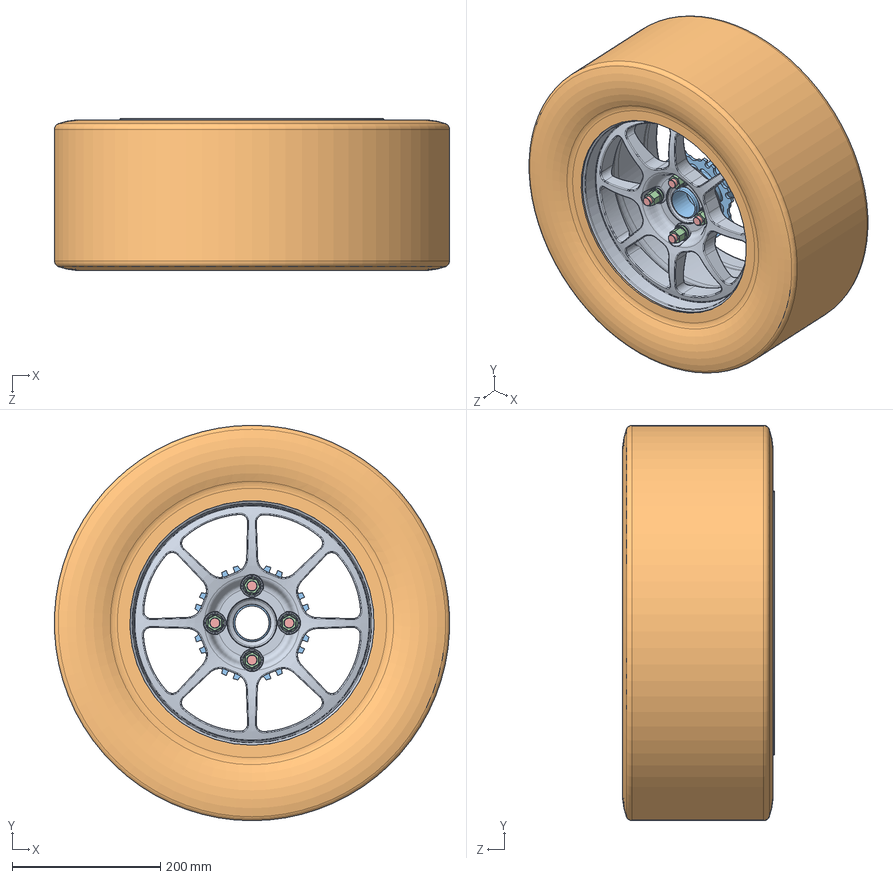
[picture p149: CAD file, 2021-10-25]
1. Zawieszenie/13. Motorsport/PUTM-S-Assembly/PUTM-S-SF-WT-Hub-Assembly.SLDASM
532.9 x 533.4 x 204.7 mm
PUTM-S-WT-Wheel_Rim
PUTM-S-SF-WT-Tire
PUTM-S-SF-WT-Hub-v2
PUTM-S-WT-WheelNut x 4
PUTM-S-SF-WT-WH-wheel_stud x 4
