Zykbyk/VACLAV/1. Zawieszenie/13. Motorsport/PUTM-A-assembly/PUTM-A-RW-assembly.SLDASM

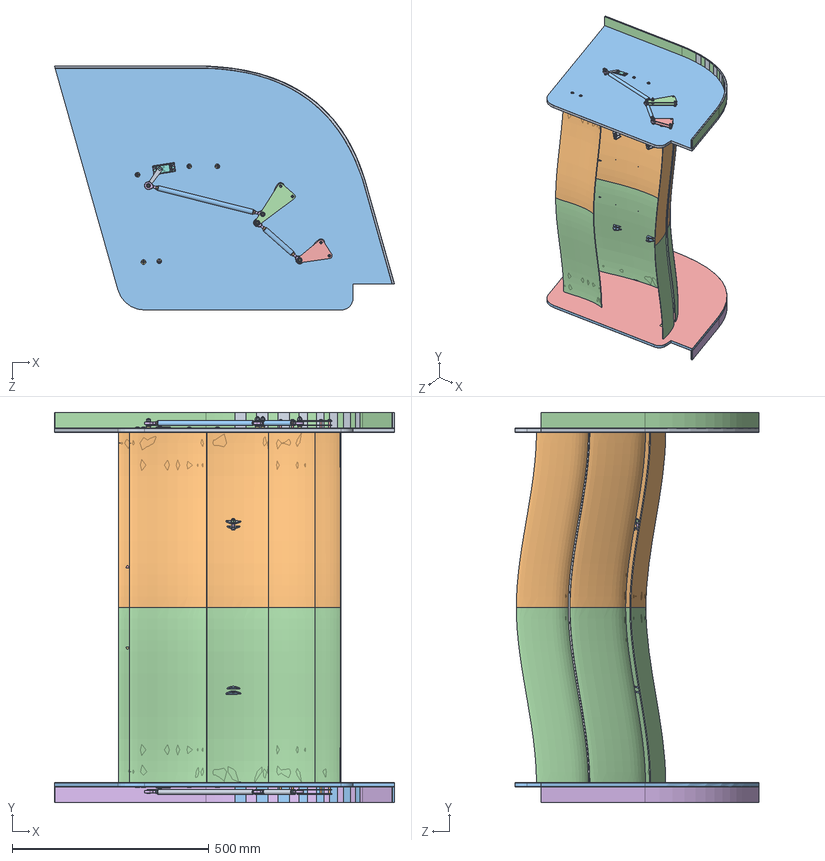
[picture p151: CAD file, 2021-10-25]
1. Zawieszenie/13. Motorsport/PUTM-A-assembly/PUTM-A-RW-assembly.SLDASM
863.5 x 990.0 x 619.5 mm
PUTM-A-RW-endplate
PUTM-A-RW-Selig
PUTM-A-RW-Endplate_carbon
PUTM-A-RW-Endplate_vortex
PUTM-A-RW-skeleton2
PUTM-A-RW-skeleton200
PUTM-A-RW-skeleton200_2
PUTM-A-RW-skeleton150
PUTM-A-RW-mounting_swan
PUTM-A-RW-mounting_swan1
PUTM-A-RW-insert_a
PUTM-A-RW-Insert_p
PUTM-A-RW-insert_DRS
PUTM-FT-FABORY_DIN7984 x 15
PUTM-A-M4_DIN9021_pads x 5
PUTM-A-RW-servo
PUTM-A-RW-DRS_Orczyk
PUTM-A-RW-Servo_insert x 4
LustroPUTM-A-RW-Endplate
LustroPUTM-A-RW-Selig
LustroPUTM-A-RW-Endplate_carbon
LustroPUTM-A-RW-Endplate_vortex
LustroPUTM-A-RW-skeleton2
LustroPUTM-A-RW-skeleton200
LustroPUTM-A-RW-skeleton200_2
LustroPUTM-A-RW-skeleton150
LustroPUTM-A-RW-mounting_swan
LustroPUTM-A-RW-mounting_swan1
LustroPUTM-A-RW-insert_a
LustroPUTM-A-RW-Insert_p
LustroPUTM-A-RW-insert_DRS
LustroPUTM-A-M4_DIN9021_pads x 5
LustroPUTM-A-RW-servo
LustroPUTM-A-RW-DRS_Orczyk
LustroPUTM-A-RW-Servo_insert x 4
PUTM-A-RW-DRS1 x 2
PUTM-A-RW-DRS2 x 2
PUTM-A-RW-DRS_igus x 8
PUTM-FT-ELESA_ISO7379 x 4
PUTM-FT-FABORY_ISO7089 x 7
PUTM-FT-FABORY_DIN985 x 4
PUTM-A-RW-Insert_tube x 4
PUTM-A-RW-DRS_tubes
PUTM-FT-FABORY_ISO7040 x 2
PUTM-A-RW-insert_mechanism
LustroPUTM-A-RW-DRS1 x 2
LustroPUTM-A-RW-DRS2 x 2
LustroPUTM-A-RW-Insert_tube x 4
LustroPUTM-A-RW-DRS_tubes
LustroPUTM-A-RW-insert_mechanism
