Zykbyk/VACLAV/1. Zawieszenie/13. Motorsport/PUTM-G-Assembly/PUTM-G-DS-Right-Plate-Ass.sldasm

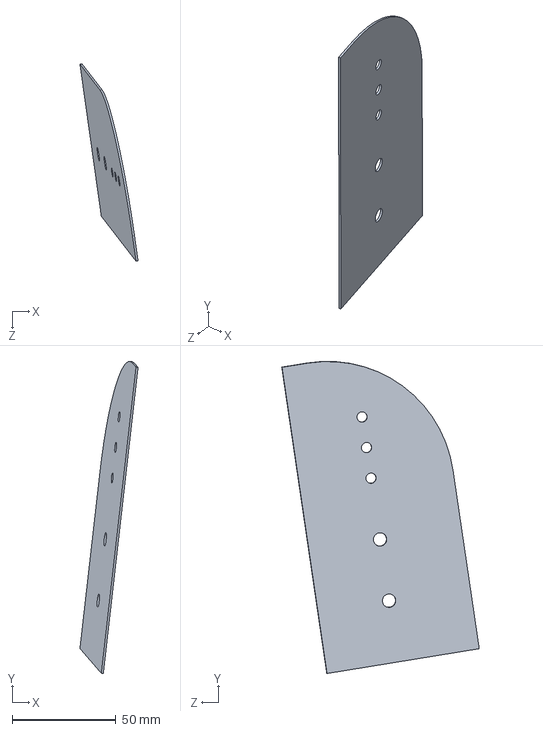
[picture p152: CAD file, 2021-10-25]
1. Zawieszenie/13. Motorsport/PUTM-G-Assembly/PUTM-G-DS-Right-Plate-Ass.sldasm
28.0 x 150.3 x 95.2 mm
