Zykbyk/VACLAV/Jacku zadecyduj/klara/KLARA W SZCZEGÓLE/pedałcały.SLDASM

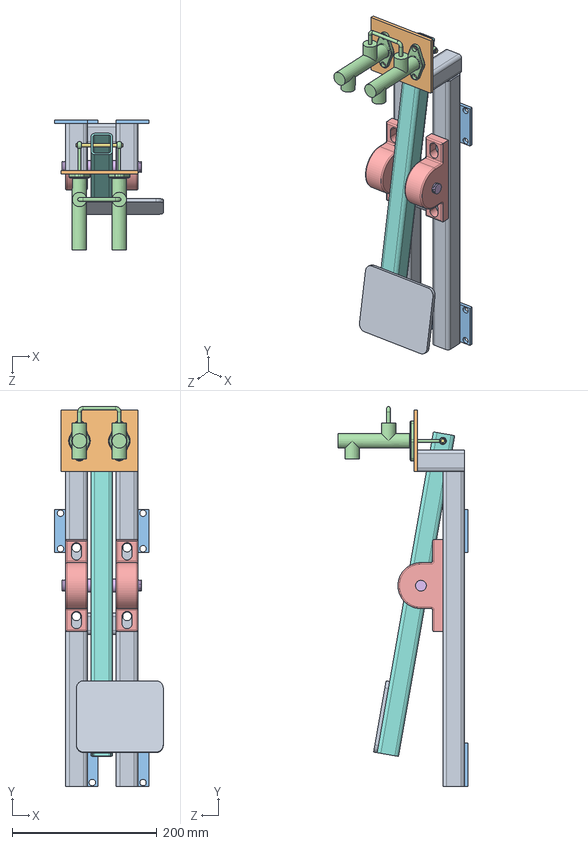
[picture p153: CAD file, 2025-03-02]
Jacku zadecyduj/klara/KLARA W SZCZEGÓLE/pedałcały.SLDASM
150.0 x 525.0 x 180.0 mm
rama pedału
plytapompapedał
płytkahamulca2 x 4
pompa
łożysko x 2
wałpedału
wałek pompy
pedalramie
płytapedał
