Zykbyk/VACLAV/1. Zawieszenie/13. Motorsport/PUTM-H-Assembly/PUTM-H-TS-Acc-Inv-Beam.sldasm

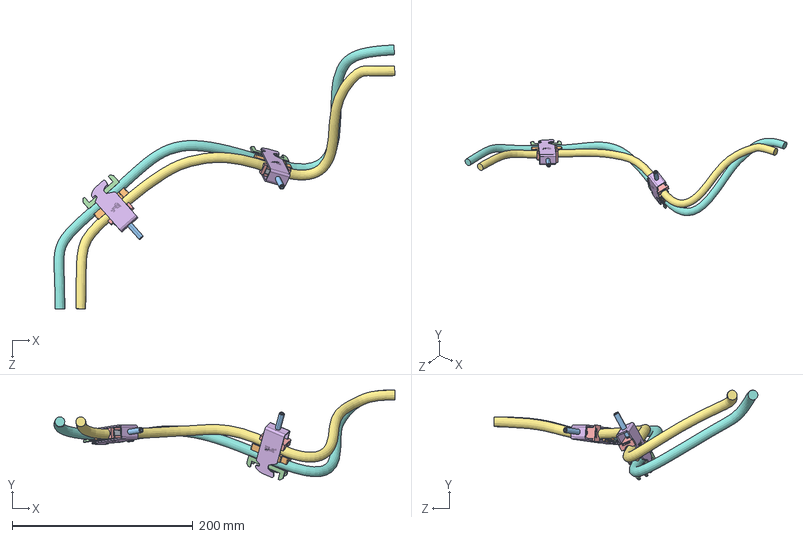
[picture p154: CAD file, 2021-10-25]
1. Zawieszenie/13. Motorsport/PUTM-H-Assembly/PUTM-H-TS-Acc-Inv-Beam.sldasm
377.7 x 99.6 x 292.4 mm
2019_12_01__16-47-46-942.stp x 2
2019_12_01__16-47-46-911.stp x 2
2019_12_01__16-47-46-880.stp x 2
2019_12_01__16-47-46-848.stp x 2
2019_12_01__16-47-46-817.stp x 2
2019_12_01__16-47-46-786.stp x 2
PUTM-H-TS-Acc-Power-Cable1
PUTM-H-TS-Acc-Power-Cable2
