Zykbyk/VACLAV/1. Zawieszenie/13. Motorsport/PUTM-F-Assembly/PUTM-F-MS-PB-Floor_Assembly.SLDASM

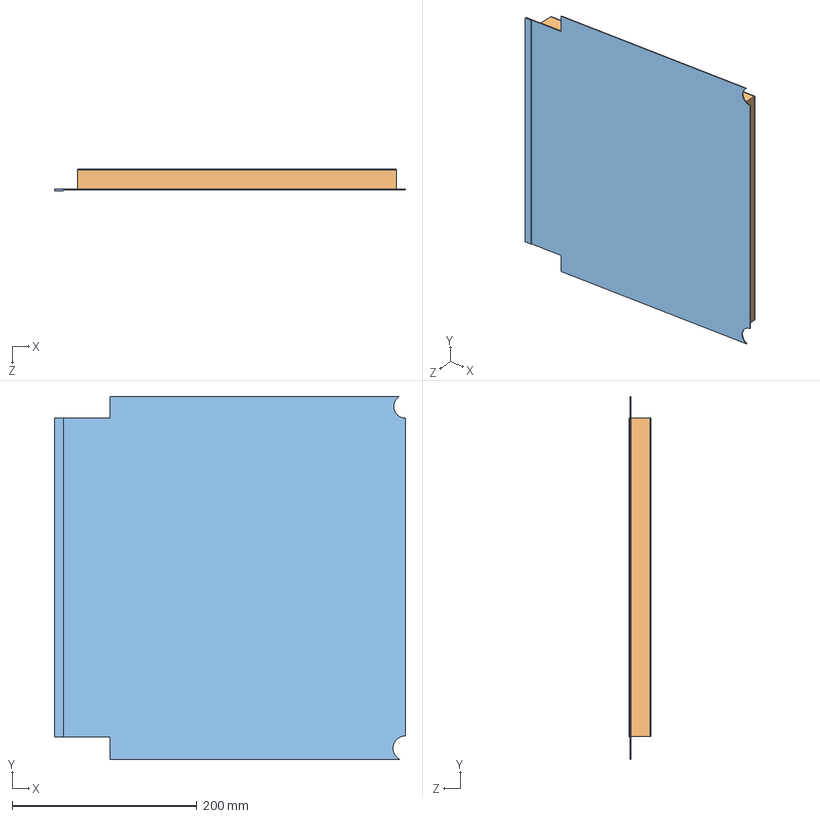
[picture p155: CAD file, 2021-10-25]
1. Zawieszenie/13. Motorsport/PUTM-F-Assembly/PUTM-F-MS-PB-Floor_Assembly.SLDASM
380.0 x 393.2 x 24.0 mm
PUTM-F-MS-PB-Floor2
PUTM-F-MS-PB-Floor1
PUTM-F-MS-PB-Floor3
