Zykbyk/VACLAV/1. Zawieszenie/13. Motorsport/PUTM-F-Assembly/PUTM-F-FR-MT-L-DynamicToeMounting.SLDASM

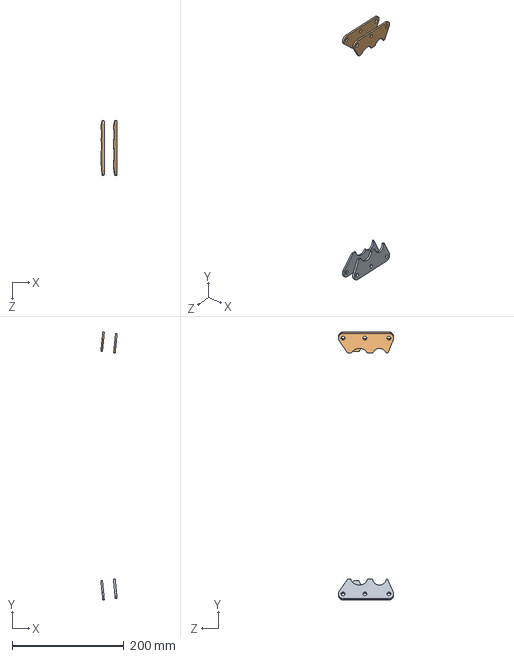
[picture p156: CAD file, 2021-10-25]
1. Zawieszenie/13. Motorsport/PUTM-F-Assembly/PUTM-F-FR-MT-L-DynamicToeMounting.SLDASM
29.3 x 479.5 x 99.0 mm
PUTM-F-FR-MT-L-Mounting
PUTM-F-FR-MT-R-Mounting
