Zykbyk/VACLAV/1. Zawieszenie/13. Motorsport/PUTM-H-Assembly/PUTM-H-BT-BB-Mounting-Rear.SLDASM

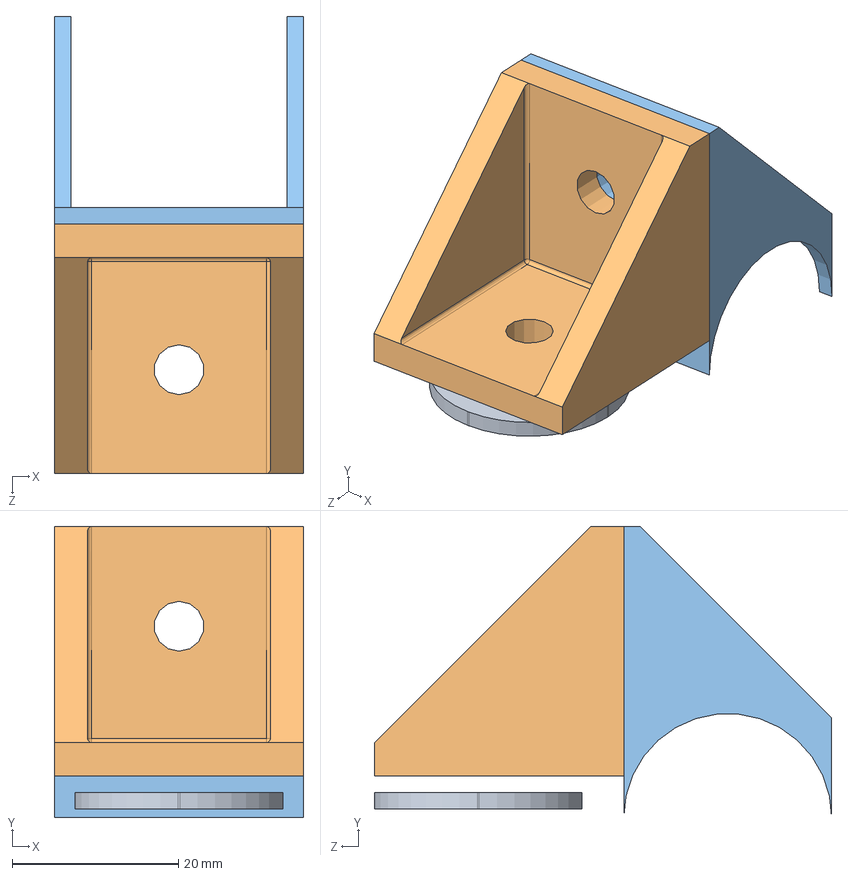
[picture p157: CAD file, 2021-10-25]
1. Zawieszenie/13. Motorsport/PUTM-H-Assembly/PUTM-H-BT-BB-Mounting-Rear.SLDASM
30.0 x 35.0 x 55.0 mm
PUTM-H-BT-BB-Backing-Plate
PUTM-H-BT-BB-Mounting-Accu-Rear
PUTM-H-BT-BB-Mounting-Frame-Rear
