Zykbyk/VACLAV/1. Zawieszenie/13. Motorsport/PUTM-G-Assembly/PUTM-G-TM-Assembly.SLDASM

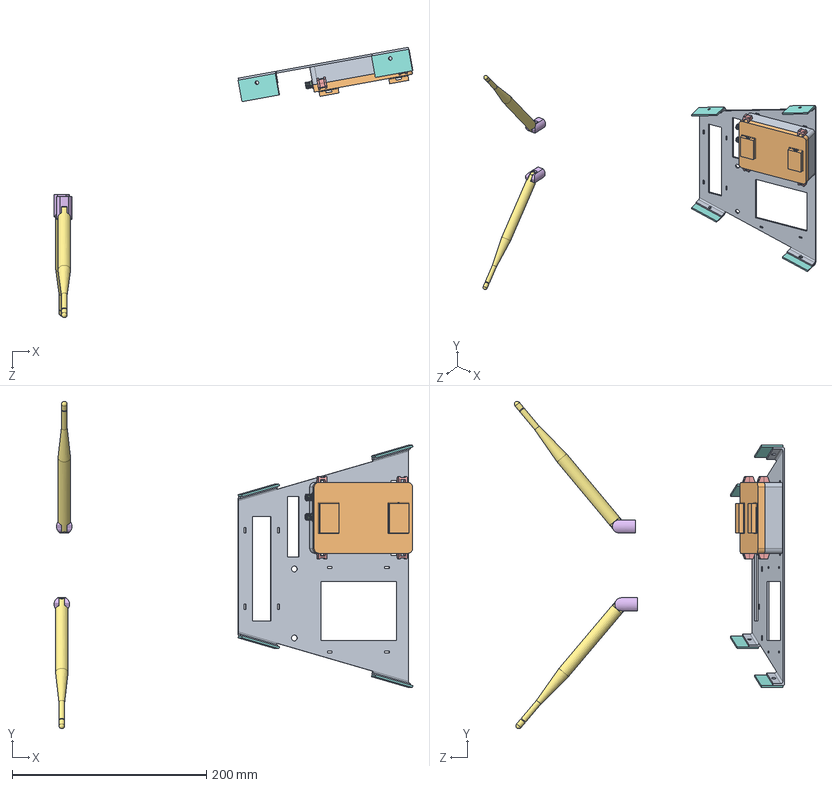
[picture p158: CAD file, 2021-10-25]
1. Zawieszenie/13. Motorsport/PUTM-G-Assembly/PUTM-G-TM-Assembly.SLDASM
369.5 x 337.0 x 278.3 mm
PUTM-G-TM-obudowa
SOLID.step x 3
SOLID-0.step
SOLID-1.step
SOLID-2.step x 18
SOLID-3.step
SOLID-4.step
SOLID-5.step
SOLID-6.step x 12
SOLID-7.step
SOLID-8.step
SOLID-9.step
SOLID-10.step
SOLID-12.step x 3
SOLID-13.step x 2
SOLID-14.step x 3
COMPOUND.step
PUTM-G-TM-Cover
PUTM-G-TM-mount x 4
PUTM-G-TM-Radio modem RFD 900x
PUTM-G-TM-MocowaniePokrywy x 8
PUTM-G-TM-Antenne-Mounting x 2
PUTM-G-TM-Antenne x 2
PUTM-G-MS-Mounting-Mounting x 4
PUTM-G-MS-Boxes-Mounting
