Zykbyk/VACLAV/1. Zawieszenie/13. Motorsport/PUTM-S-Assembly/PUTM-S-SR-WT-Hub_Assembly.SLDASM

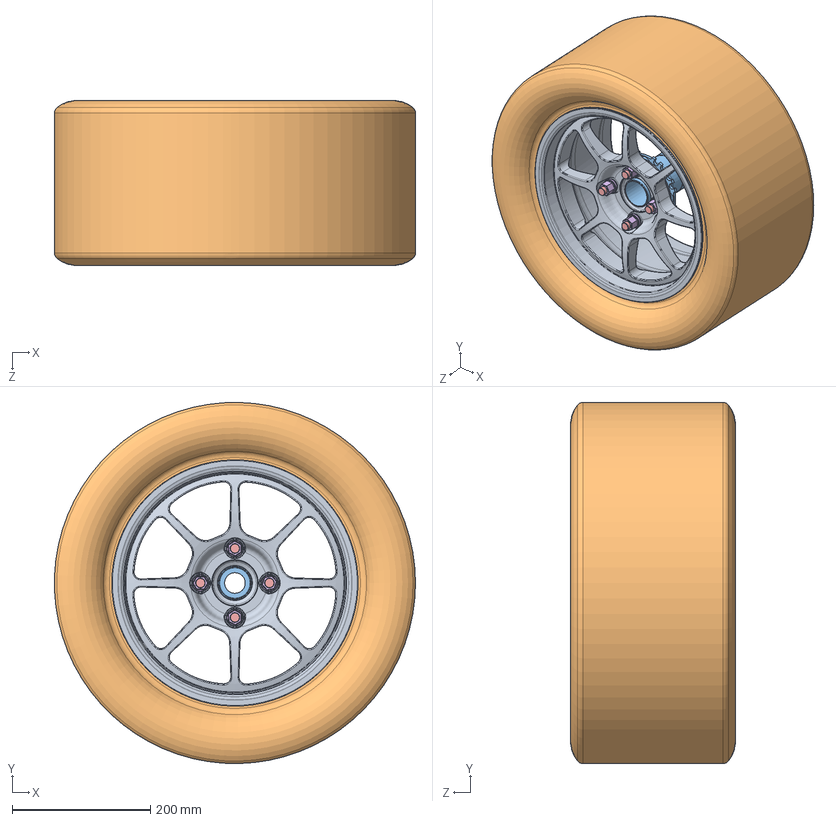
[picture p160: CAD file, 2021-10-25]
1. Zawieszenie/13. Motorsport/PUTM-S-Assembly/PUTM-S-SR-WT-Hub_Assembly.SLDASM
523.0 x 523.1 x 238.4 mm
PUTM-S-WT-Wheel_Rim
PUTM-S-SR-WT-Tire
PUTM-S-SR-WT-Hub
PUTM-S-SR-WT-WH-tripod_housing_2mm
PUTM-S-SF-WT-WH-wheel_stud x 4
PUTM-S-WT-WheelNut x 4
