Zykbyk/VACLAV/Jacku zadecyduj/klara/Łańcuch.SLDASM

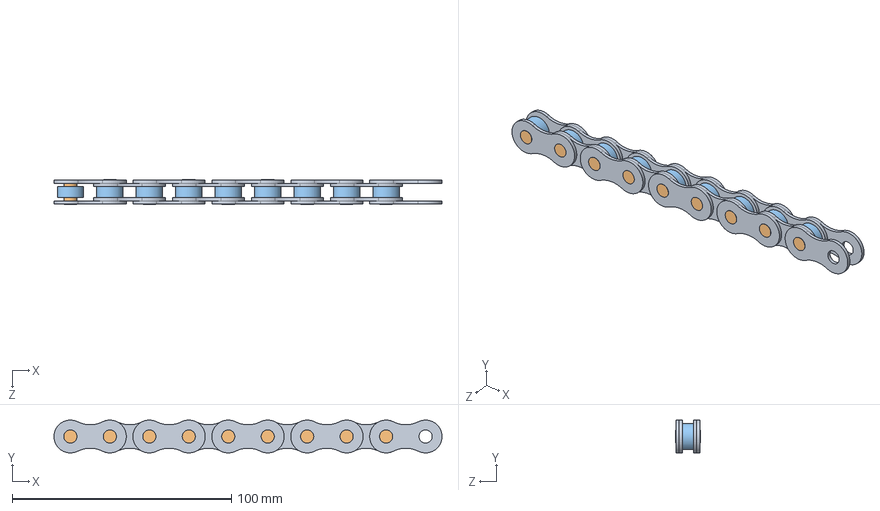
[picture p161: CAD file, 2025-03-02]
Jacku zadecyduj/klara/Łańcuch.SLDASM
177.0 x 15.0 x 11.3 mm
Łańcuch zew. x 18
sworzeń x 9
roller x 9
