Zykbyk/VACLAV/1. Zawieszenie/13. Motorsport/PUTM-F-Assembly/LustroPUTM-F-FR-MT-Aero-FW- Upper-Mounting.SLDASM

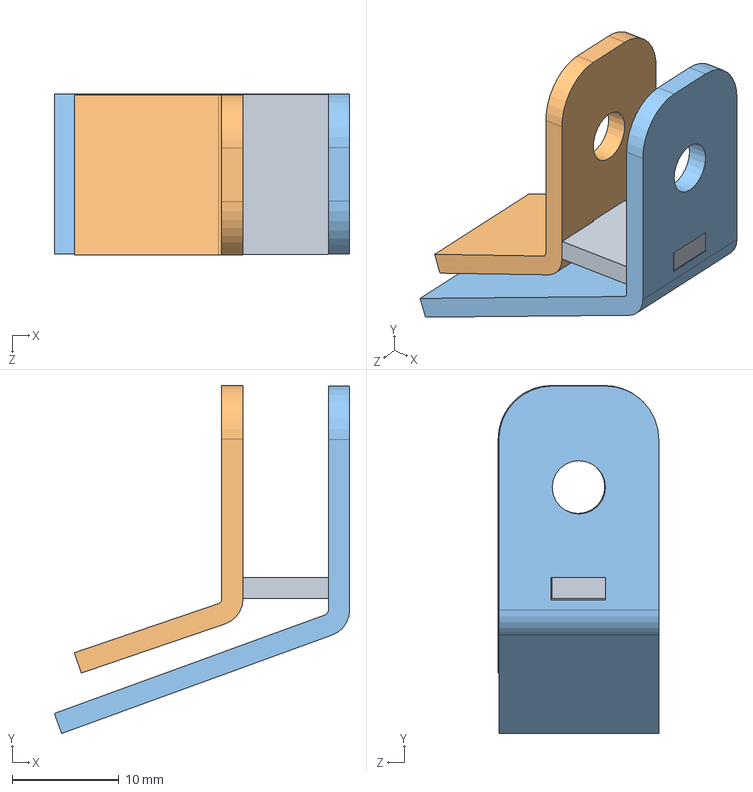
[picture p162: CAD file, 2021-10-25]
1. Zawieszenie/13. Motorsport/PUTM-F-Assembly/LustroPUTM-F-FR-MT-Aero-FW- Upper-Mounting.SLDASM
27.7 x 32.6 x 15.1 mm
LustroPUTM-F-FR-MT-Aero-FW- Upper-Mounting-Part 3
LustroPUTM-F-FR-MT-Aero-FW- Upper-Mounting.Part2
LustroPUTM-F-FR-MT-Aero-FW- Upper-Mounting-Part1
