Zykbyk/VACLAV/1. Zawieszenie/13. Motorsport/PUTM-H-Assembly/PUTM-H-TS-BOX-data_logger.SLDASM

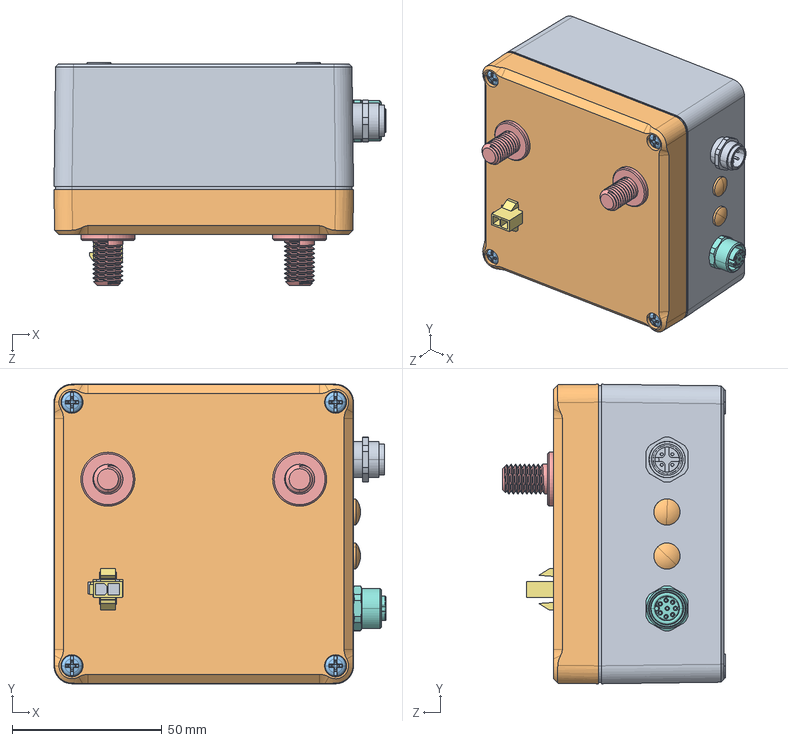
[picture p163: CAD file, 2021-10-25]
1. Zawieszenie/13. Motorsport/PUTM-H-Assembly/PUTM-H-TS-BOX-data_logger.SLDASM
110.8 x 100.0 x 74.5 mm
212 UT_1002700_3DSYM.STEP
212 OT_1002699_3DSYM.STEP
SHR Z KAL40X25X10 WN 1412 MG_3DSYM.STEP x 4
IVTModul.STEP
Kupferkontakt.STEP x 2
GFK-Verdrehschutz.STEP
Molex Stecker.STEP
Stecker 8 pol.STEP
Stecker 4 pol.STEP
LED.STEP x 2
