Zykbyk/VACLAV/1. Zawieszenie/13. Motorsport/PUTM-H-Assembly/PUTM-H-TS-Cable-Clamp2.SLDASM

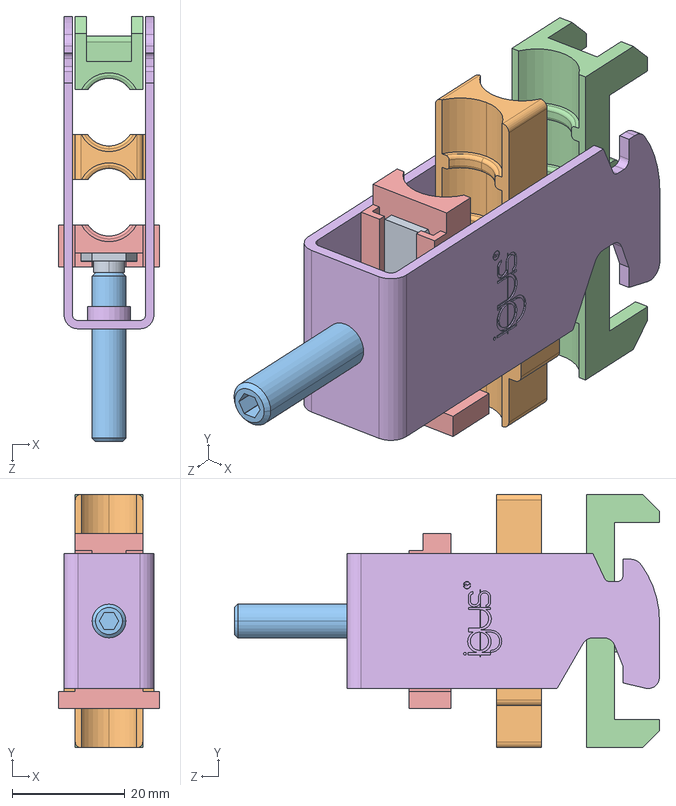
[picture p164: CAD file, 2021-10-25]
1. Zawieszenie/13. Motorsport/PUTM-H-Assembly/PUTM-H-TS-Cable-Clamp2.SLDASM
18.0 x 45.0 x 75.5 mm
2019_12_01__16-47-46-942.stp
2019_12_01__16-47-46-911.stp
2019_12_01__16-47-46-880.stp
2019_12_01__16-47-46-848.stp
2019_12_01__16-47-46-817.stp
2019_12_01__16-47-46-786.stp
