Zykbyk/VACLAV/1. Zawieszenie/13. Motorsport/PUTM-S-Assembly/PUTM-S-SR-AB.SLDASM

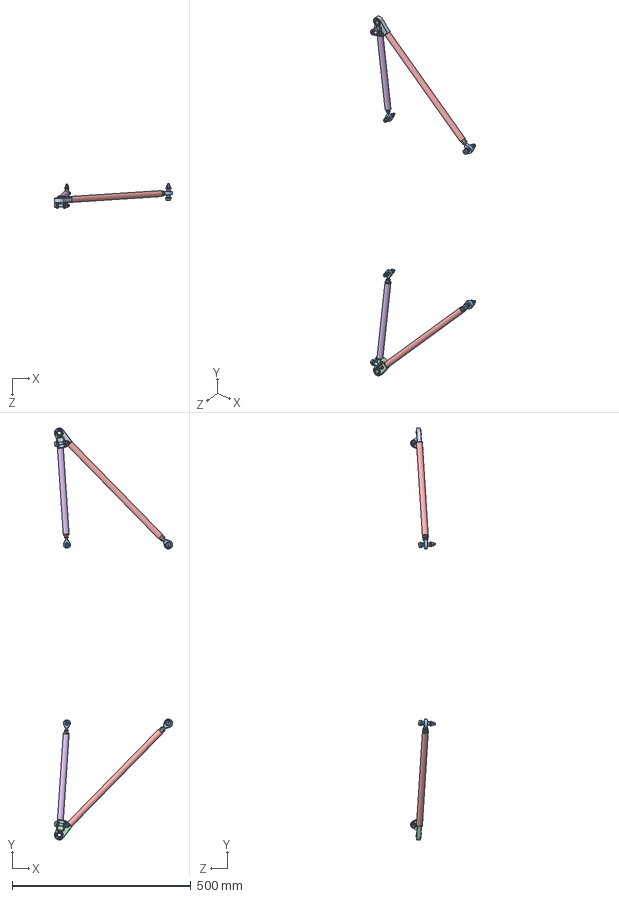
[picture p165: CAD file, 2021-10-25]
1. Zawieszenie/13. Motorsport/PUTM-S-Assembly/PUTM-S-SR-AB.SLDASM
331.2 x 1152.6 x 69.2 mm
PUTM-S-SR-AB-Connector
PUTM-S-Insert-M8 x 4
PUTM-S-rodend x 4
PUTM-S-GXSW-10-22-MS x 2
PUTM-S-SR-AB-Tube-F x 2
PUTM-S-SR-AB-Tube-R x 2
PUTM-S-Mush x 12
PUTM-S-DS-DIN-EN-ISO-4035 x 4
PUTM-FT-FABORY_DIN985 x 6
PUTM-FT-FABORY_ISO7089 x 18
PUTM-FT-ELESA_ISO7379 x 6
LustroPUTM-S-SR-AB
