Zykbyk/VACLAV/1. Zawieszenie/13. Motorsport/PUTM-A-assembly/PUTM-A-UT-Front mountings.SLDASM

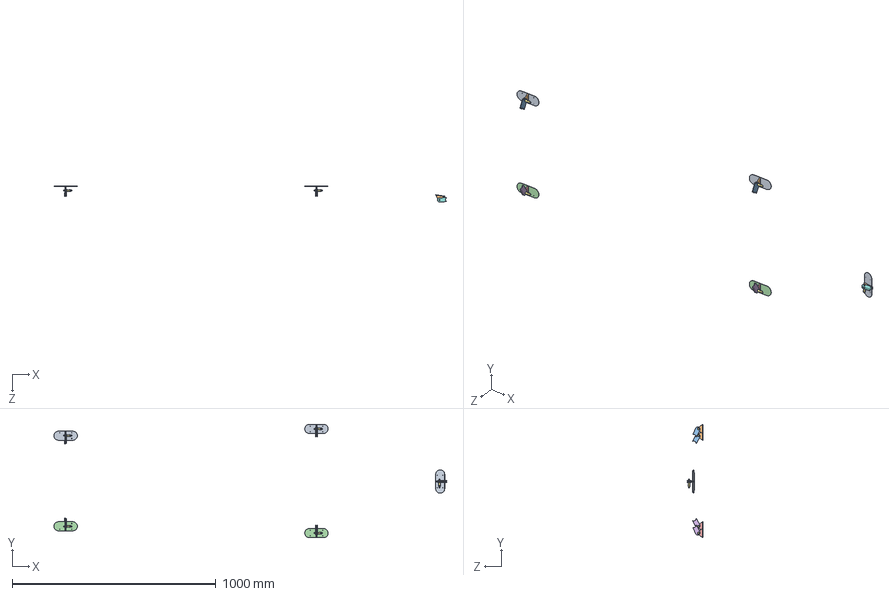
[picture p166: CAD file, 2021-10-25]
1. Zawieszenie/13. Motorsport/PUTM-A-assembly/PUTM-A-UT-Front mountings.SLDASM
1927.6 x 556.0 x 78.2 mm
PUTM-A-UT-MNT1 x 3
PUTM-A-UT-MNT2 x 3
PUTM-A-UT-Frame mounting2 x 2
LustroPUTM-A-UT-MNT1 x 2
LustroPUTM-A-UT-MNT2 x 2
LustroPUTM-A-UT-Frame mounting2 x 2
Stainless Steel-Ball lock pin GN 113.4-5-10 (deactivated) x 5
PUTM-A-UT-Frame rear mounting^PUTM-A-UT-Front mountings
