Zykbyk/VACLAV/1. Zawieszenie/13. Motorsport/PUTM-F-Assembly/Left sidePUTM-F-FR-MT-Aero-RW-Mountings.sldasm

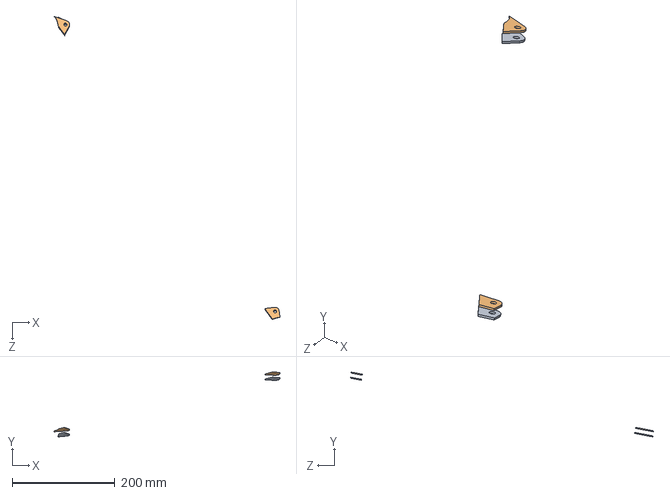
[picture p167: CAD file, 2021-10-25]
1. Zawieszenie/13. Motorsport/PUTM-F-Assembly/Left sidePUTM-F-FR-MT-Aero-RW-Mountings.sldasm
441.0 x 126.8 x 591.7 mm
Left sidePUTM-F-FR-MT-Aero-RW-Inside-Mounting
Left sidePUTM-F-FR-MT-Aero-RW-Outside-Mounting
