Zykbyk/VACLAV/1. Zawieszenie/13. Motorsport/PUTM-H-Assembly/PUTM-H-TS-BOX-main_connector.SLDASM

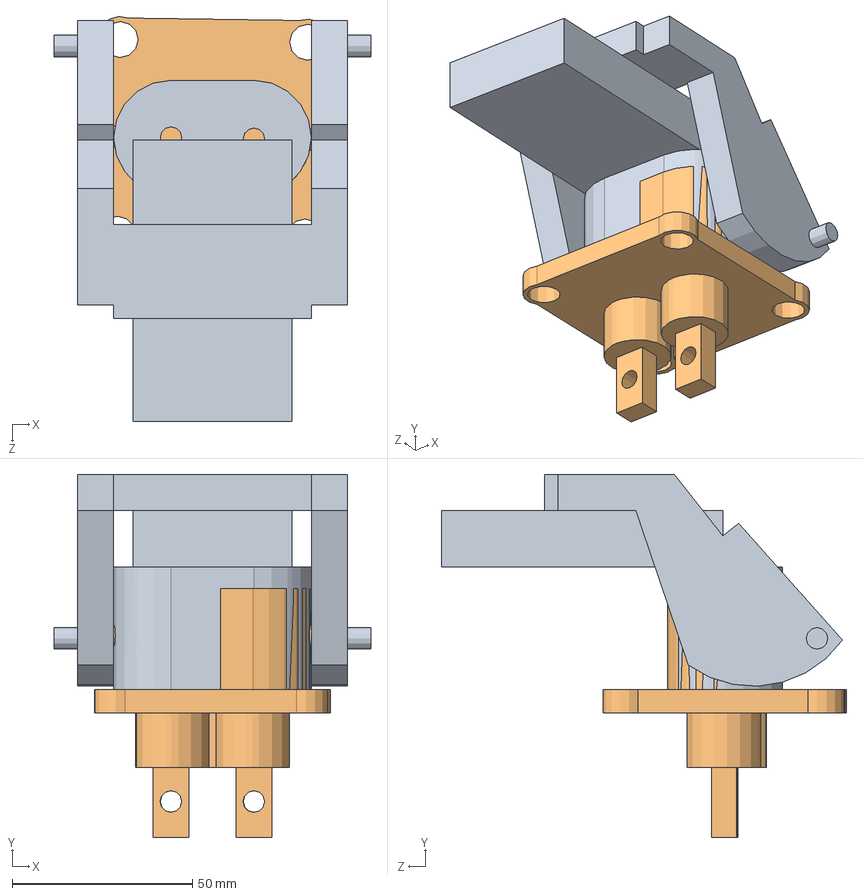
[picture p168: CAD file, 2021-10-25]
1. Zawieszenie/13. Motorsport/PUTM-H-Assembly/PUTM-H-TS-BOX-main_connector.SLDASM
87.9 x 100.7 x 112.3 mm
PUTM-H-connector_female
PUTM-H-connector_male
