Zykbyk/VACLAV/1. Zawieszenie/13. Motorsport/PUTM-S-Assembly/PUTM-S-SF-DS-WObit_RC13-75.SLDASM

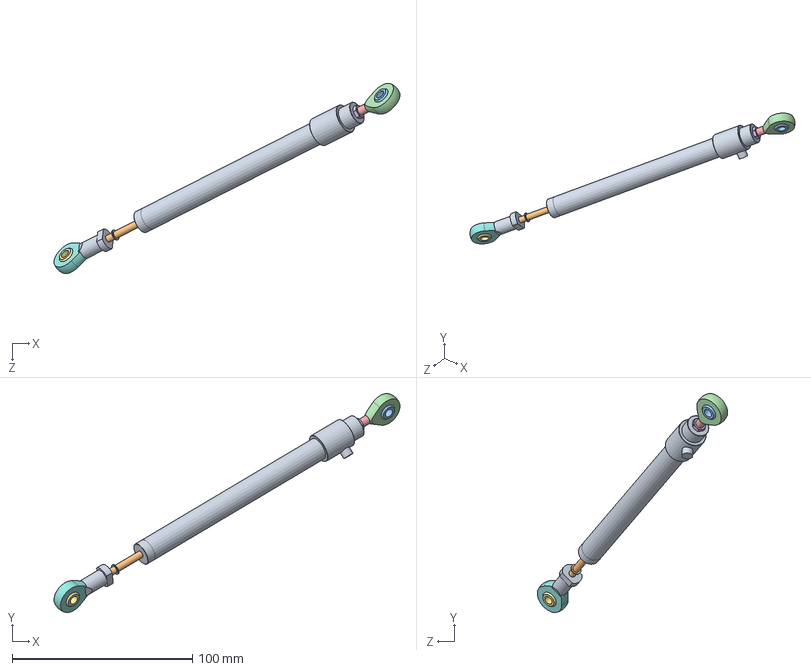
[picture p169: CAD file, 2021-10-25]
1. Zawieszenie/13. Motorsport/PUTM-S-Assembly/PUTM-S-SF-DS-WObit_RC13-75.SLDASM
191.8 x 121.5 x 105.5 mm
PUTM-S-SR-DS-WObit_RC13-75_housing
PUTM-S-SR-DS-WObit_RC13-75_rod
PUTM-S-SR-DS-KARM-05_1
PUTM-S-SR-DS-KARM-05_2
PUTM-S-SR-DS-KARM-05
PUTM-S-SR-DS-DIN EN ISO 4035
PUTM-S-SR-DS-KBRM-05 M4_1
PUTM-S-SR-DS-KBRM-05 M4_2
PUTM-S-SR-DS-KBRM-05 M4
