Zykbyk/VACLAV/1. Zawieszenie/13. Motorsport/PUTM-A-assembly/PUTM-A-FW-assembly.SLDASM

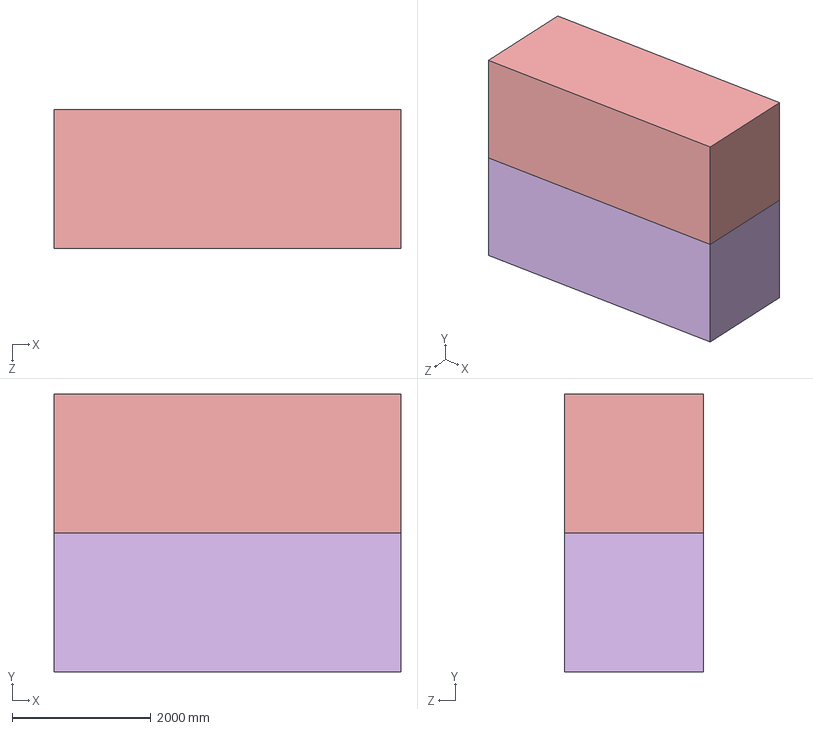
[picture p170: CAD file, 2021-10-25]
1. Zawieszenie/13. Motorsport/PUTM-A-assembly/PUTM-A-FW-assembly.SLDASM
5000.0 x 4000.0 x 2000.0 mm
PUTM-A-FW-Endplate-carbon
PUTM-A-FW-Vortex
PUTM-A-FW-Vortex2
PUTM-A-FW-Endplate-c
PUTM-A-FW-profiles
PUTM-A-FW-skeleton_main
PUTM-A-FW-middleplate_c
PUTM-A-FW-Endplate2
PUTM-A-FW-skeleton3
PUTM-A-FW-skeleton3_c
PUTM-A-FW-skeleton2
PUTM-A-FW-skeleton2_c
PUTM-A-FW-skeleton_c
PUTM-A-FW-skeleton
LustroPUTM-A-FW-Endplate-carbon
LustroPUTM-A-FW-Vortex2
LustroPUTM-A-FW-Vortex
LustroPUTM-A-FW-Endplate-c
LustroPUTM-A-FW-profiles
LustroPUTM-A-FW-skeleton_main
LustroPUTM-A-FW-middleplate_c
LustroPUTM-A-FW-Endplate2
LustroPUTM-A-FW-skeleton3
LustroPUTM-A-FW-skeleton3_c
LustroPUTM-A-FW-skeleton2
LustroPUTM-A-FW-skeleton2_c
LustroPUTM-A-FW-skeleton_c
LustroPUTM-A-FW-skeleton
PUTM-A-FW-swan_mounting
LustroPUTM-A-FW-swan_mounting
PUTM-A-FW-insert_a
PUTM-A-FW-insert_p
PUTM-A-FW-M4_pads
PUTM-A-FW-M3_pads
PUTM-FT-FABORY_DIN7984 x 14
PUTM-FT-FABORY_ISO7089 x 4
PUTM-FT-FABORY_DIN985 x 2
LustroPUTM-A-FW-insert_a
LustroPUTM-A-FW-M4_pads
LustroPUTM-A-FW-insert_p
LustroPUTM-A-FW-M3_pads
