Zykbyk/VACLAV/1. Zawieszenie/13. Motorsport/PUTM-F-Assembly/PUTM-F-MS-IA.SLDASM

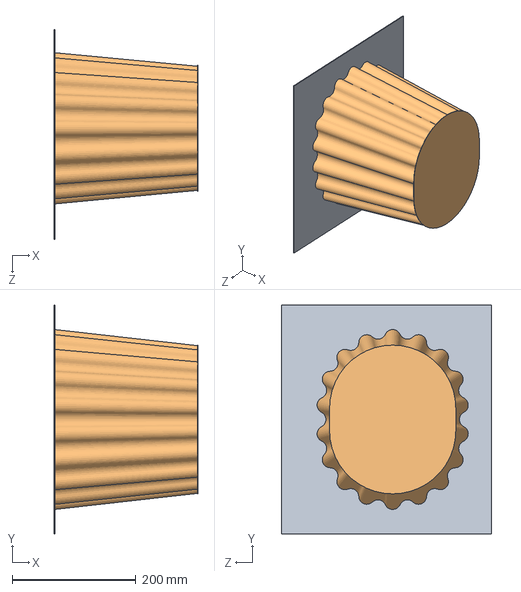
[picture p171: CAD file, 2021-10-25]
1. Zawieszenie/13. Motorsport/PUTM-F-Assembly/PUTM-F-MS-IA.SLDASM
232.1 x 370.0 x 340.0 mm
PUTM-F-MS-IA-Anti_Intrusion_Plate
PUTM-F-MS-IA-Impact_Attenuator
