Zykbyk/VACLAV/Jacku zadecyduj/klara/KLARA W SZCZEGÓLE/pedał.SLDASM

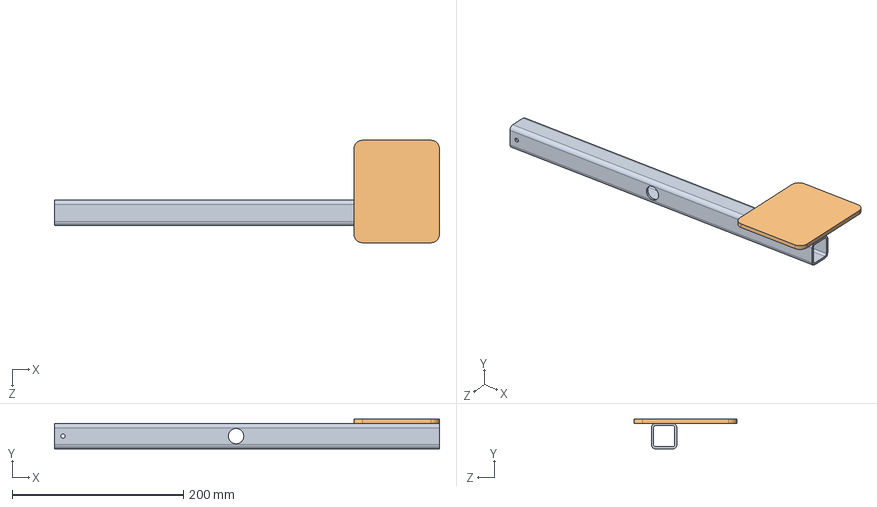
[picture p172: CAD file, 2025-03-02]
Jacku zadecyduj/klara/KLARA W SZCZEGÓLE/pedał.SLDASM
450.0 x 35.0 x 120.0 mm
pedalramie
płytapedał
