Zykbyk/VACLAV/1. Zawieszenie/13. Motorsport/PUTM-G-Assembly/PUTM-G-AM-BB-PCB-Connector-v2.SLDASM

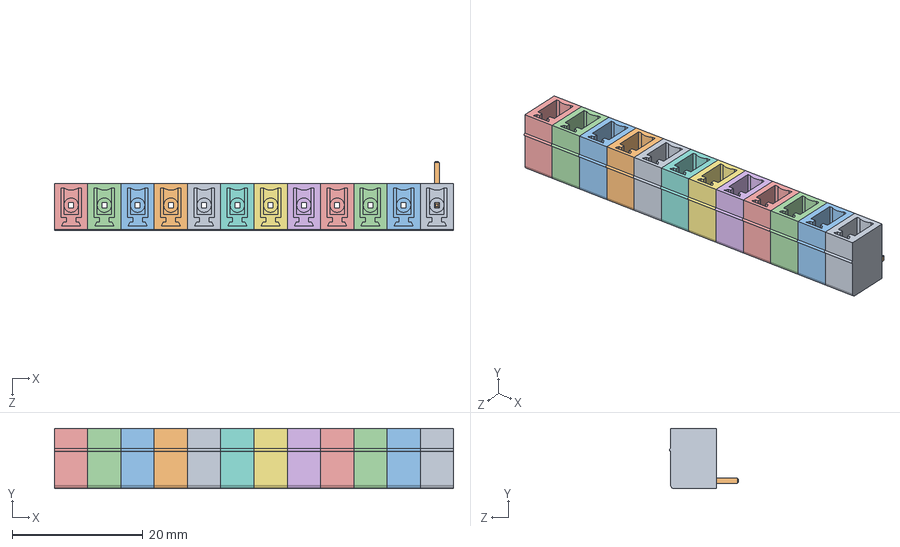
[picture p173: CAD file, 2021-10-25]
1. Zawieszenie/13. Motorsport/PUTM-G-Assembly/PUTM-G-AM-BB-PCB-Connector-v2.SLDASM
61.0 x 9.20 x 10.6 mm
body_1pc.stp
body_1pc_1.stp
body_1pc_2.stp
body_1pc_3.stp
body_1pc_4.stp
body_1pc_5.stp
body_1pc_6.stp
body_1pc_7.stp
body_1pc_8.stp
body_1pc_9.stp
body_1pc_10.stp
body_1pc_11.stp
