Zykbyk/VACLAV/1. Zawieszenie/13. Motorsport/PUTM-F-Assembly/PUTM-F-MS-PB-Acceleration_Stop_Assembly.SLDASM

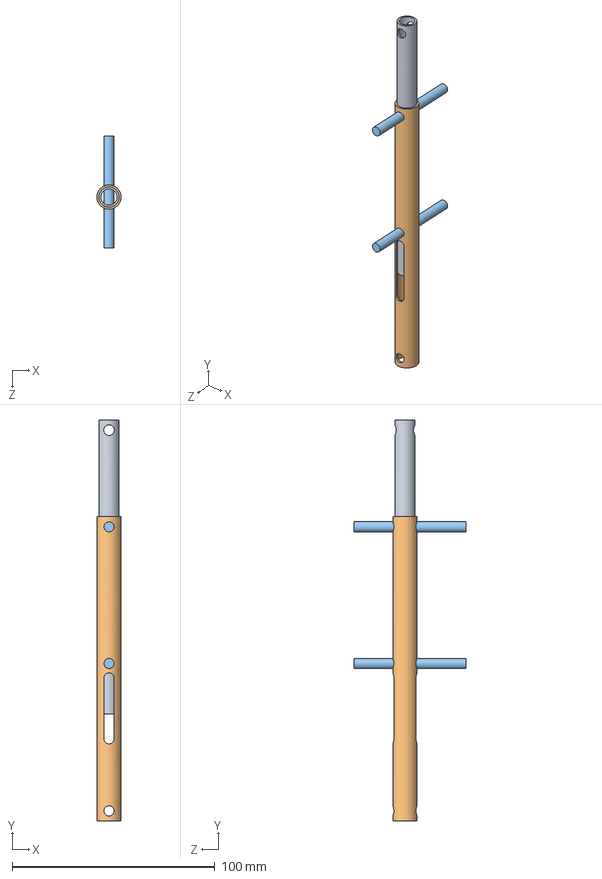
[picture p174: CAD file, 2021-10-25]
1. Zawieszenie/13. Motorsport/PUTM-F-Assembly/PUTM-F-MS-PB-Acceleration_Stop_Assembly.SLDASM
12.0 x 197.6 x 55.0 mm
PUTM-F-MS-PB-Stop1
PUTM-F-MS-PB-Stop2
PUTM-F-MS-PB-Stop_Sleeve2 x 2
