Zykbyk/VACLAV/1. Zawieszenie/13. Motorsport/PUTM-F-Assembly/PUTM-F-MS-CO.sldasm

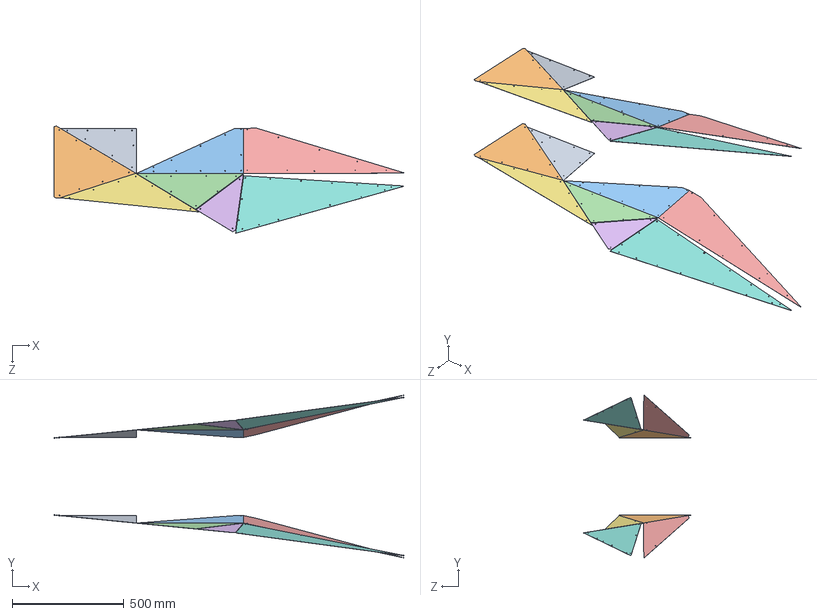
[picture p175: CAD file, 2021-10-25]
1. Zawieszenie/13. Motorsport/PUTM-F-Assembly/PUTM-F-MS-CO.sldasm
1567.5 x 729.7 x 481.8 mm
PUTM-F-MS-CO-1^PUTM-F-MS-CO
PUTM-F-MS-CO-2^PUTM-F-MS-CO
PUTM-F-MS-CO-3^PUTM-F-MS-CO
PUTM-F-MS-CO-4^PUTM-F-MS-CO
PUTM-F-MS-CO-7^PUTM-F-MS-CO
PUTM-F-MS-CO-8^PUTM-F-MS-CO
PUTM-F-MS-CO-10^PUTM-F-MS-CO
putm-f-ms-co-6^PUTM-F-MS-CO
MirrorPUTM-F-MS-CO-1^PUTM-F-MS-CO
MirrorPUTM-F-MS-CO-2^PUTM-F-MS-CO
MirrorPUTM-F-MS-CO-3^PUTM-F-MS-CO
MirrorPUTM-F-MS-CO-4^PUTM-F-MS-CO
MirrorPUTM-F-MS-CO-7^PUTM-F-MS-CO
MirrorPUTM-F-MS-CO-8^PUTM-F-MS-CO
MirrorPUTM-F-MS-CO-10^PUTM-F-MS-CO
MirrorPUTM-F-MS-CO-6^PUTM-F-MS-CO
