Zykbyk/VACLAV/1. Zawieszenie/13. Motorsport/PUTM-H-Assembly/PUTM-H-TS-BOX-INVERTER-Assembly.SLDASM

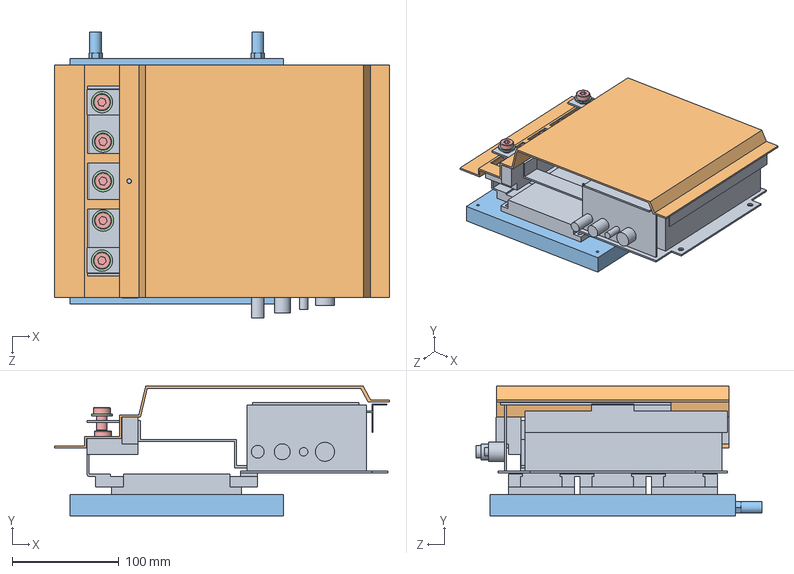
[picture p176: CAD file, 2021-10-25]
1. Zawieszenie/13. Motorsport/PUTM-H-Assembly/PUTM-H-TS-BOX-INVERTER-Assembly.SLDASM
314.0 x 121.5 x 268.5 mm
PUTM-H-TS-BOX-INVERTER-Inv-Body
PUTM-H-TS-BOX-INVERTER-Inv-Cover
PUTM-H-TS-BOX-INVERTER-Cooling-Plate
PUTM-FT-FABORY_ISO7089 x 5
PUTM-FT-FABORY_DIN7984 x 5
