Zykbyk/VACLAV/1. Zawieszenie/13. Motorsport/PUTM-F-Assembly/PUTM-F-MS-PB-Linear_sensor_RC13_Assembly.SLDASM

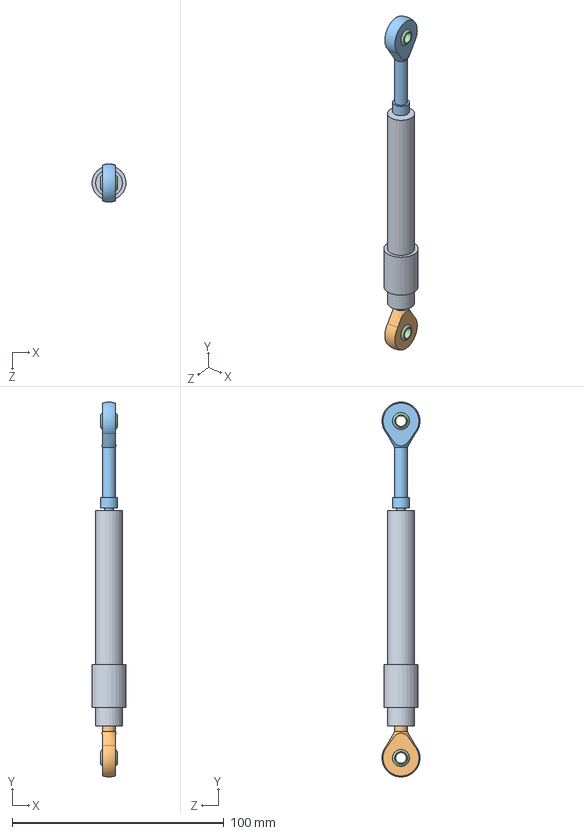
[picture p177: CAD file, 2021-10-25]
1. Zawieszenie/13. Motorsport/PUTM-F-Assembly/PUTM-F-MS-PB-Linear_sensor_RC13_Assembly.SLDASM
16.1 x 177.1 x 18.0 mm
PUTM-F-MS-PB-Linear_Sensor_RC13_2
PUTM-F-MS-PB-Linear_Sensor_RC13_3
PUTM-F-MS-PB-Linear_Sensor_RC13
PUTM-F-MS-PB-Linear_Sensor_RC13_4 x 2
