Zykbyk/VACLAV/1. Zawieszenie/13. Motorsport/PUTM-A-assembly/PUTM-A-UT-assembly.SLDASM

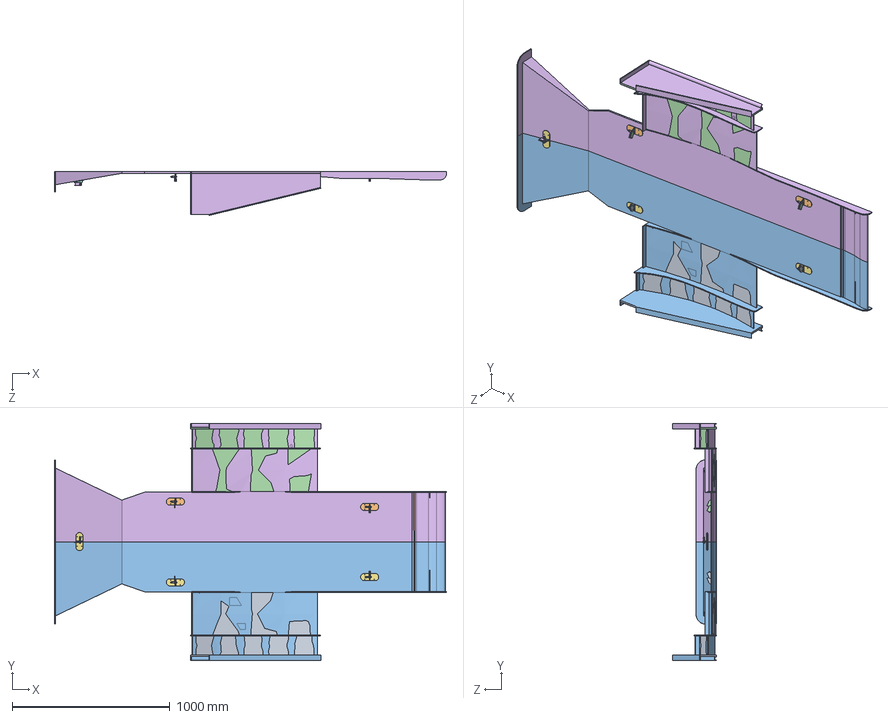
[picture p178: CAD file, 2021-10-25]
1. Zawieszenie/13. Motorsport/PUTM-A-assembly/PUTM-A-UT-assembly.SLDASM
2481.3 x 1500.8 x 277.0 mm
PUTM-A-UT-undertray
PUTM-A-UT-undertrayfront
PUTM-A-UT-undertray_c
LustroPUTM-A-UT-undertray
LustroPUTM-A-UT-undertrayfront
LustroPUTM-A-UT-undertray_c
PUTM-A-UT-MNT1 x 3
PUTM-A-UT-MNT2 x 3
PUTM-A-UT-Frame mounting2 x 2
LustroPUTM-A-UT-MNT1 x 2
LustroPUTM-A-UT-MNT2 x 2
LustroPUTM-A-UT-Frame mounting2 x 2
Stainless Steel-Ball lock pin GN 113.4-5-10 (deactivated) x 5
PUTM-A-UT-Frame rear mounting^PUTM-A-UT-Front mountings
