Zykbyk/VACLAV/1. Zawieszenie/13. Motorsport/PUTM-F-Assembly/PUTM-F-MS-CO-Floor.SLDASM

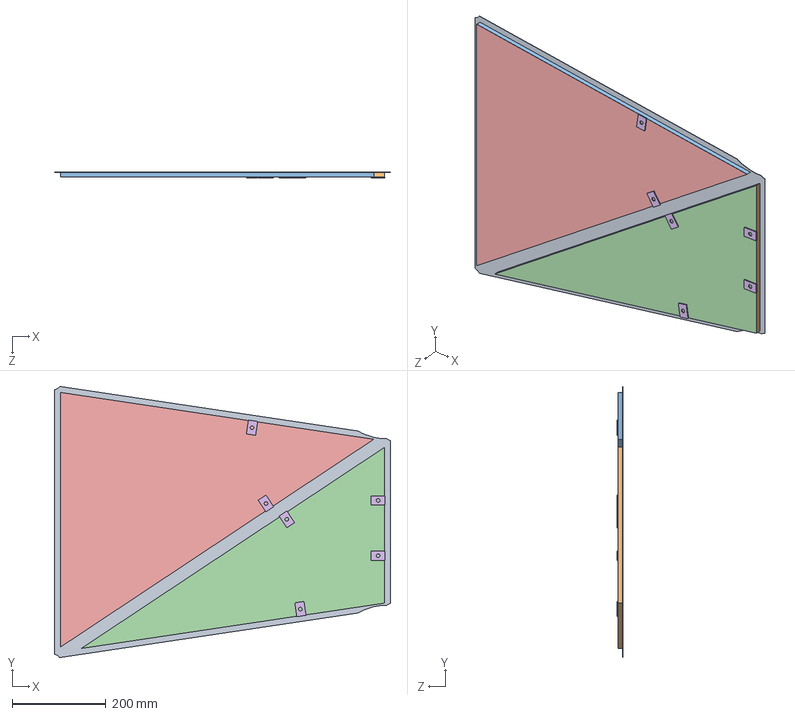
[picture p179: CAD file, 2021-10-25]
1. Zawieszenie/13. Motorsport/PUTM-F-Assembly/PUTM-F-MS-CO-Floor.SLDASM
718.2 x 579.8 x 13.2 mm
PUTM-F-MS-CO-Highercarbon
PUTM-F-MS-CO-Lefr_Honeycomb
PUTM-F-MS-CO-Right_Honeycomb
PUTM-F-MS-CO-Left_Carbon
PUTM-F-MS-CO-Right_Carbon
PUTM-F-MS-CO-Flat_bar x 6
