Zykbyk/VACLAV/1. Zawieszenie/13. Motorsport/PUTM-F-Assembly/LustroPUTM-F-MT-DampersMountings.sldasm

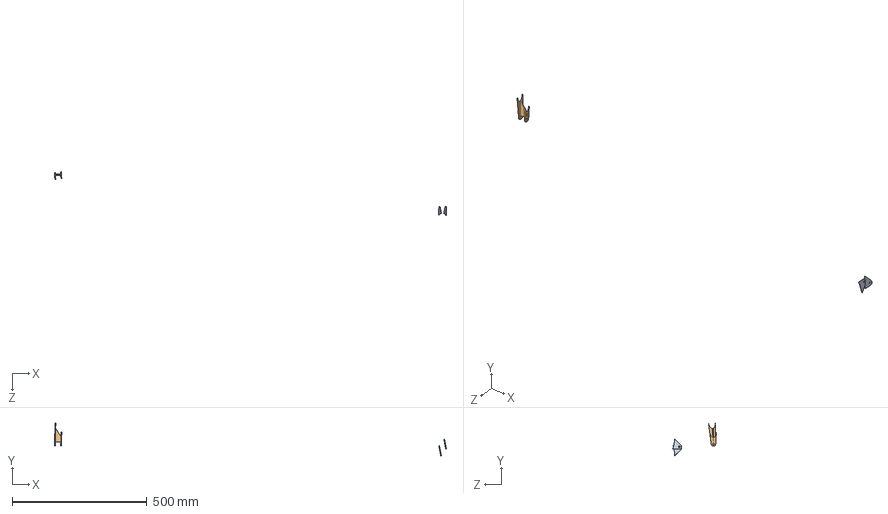
[picture p180: CAD file, 2021-10-25]
1. Zawieszenie/13. Motorsport/PUTM-F-Assembly/LustroPUTM-F-MT-DampersMountings.sldasm
1455.5 x 121.7 x 162.6 mm
LustroPUTM-F-FR-MT-LR-DamperMounting
LustroPUTM-F-FR-MT-LF-DamperMounting
