Zykbyk/VACLAV/1. Zawieszenie/13. Motorsport/PUTM-S-Assembly/PUTM-S-SF-WT-Upright-Assembly.SLDASM

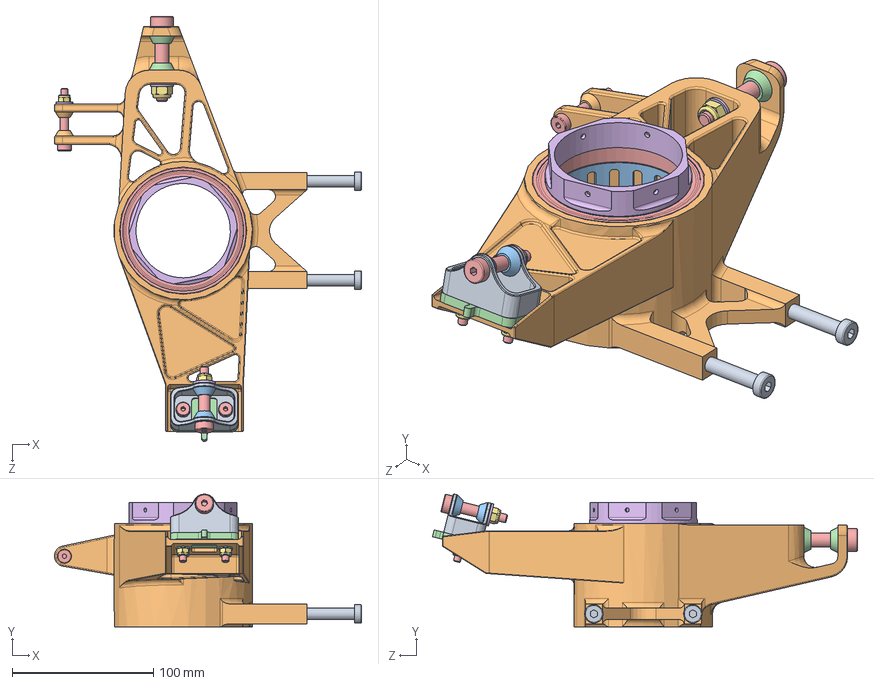
[picture p181: CAD file, 2021-10-25]
1. Zawieszenie/13. Motorsport/PUTM-S-Assembly/PUTM-S-SF-WT-Upright-Assembly.SLDASM
217.1 x 94.0 x 300.7 mm
PUTM-S-SF-WT-U-Clevis_Upper
PUTM-S-SF-WT-Upright_new
PUTM-S-SF-WT-U-RearDistanceRing
PUTM-S-SF-WT-U-Shim
PUTM-FT-ELESA_ISO7379 x 5
PUTM-FT-FABORY_ISO7089 x 3
PUTM-FT-FABORY_DIN985 x 5
Washer-5mm x 2
PUTM-FT-FABORY_DIN7984 x 2
PUTM-S-Grzybek_6mm x 2
PUTM-S-Grzybek_8mm x 2
PUTM-S-Grzybek_10mm x 2
PUTM-S-SF-WT-Bearing x 2
PUTM-S-SF-WT-Hubnut
