Zykbyk/VACLAV/Jacku zadecyduj/klara/KLARA W SZCZEGÓLE/Płyta przednia.SLDASM

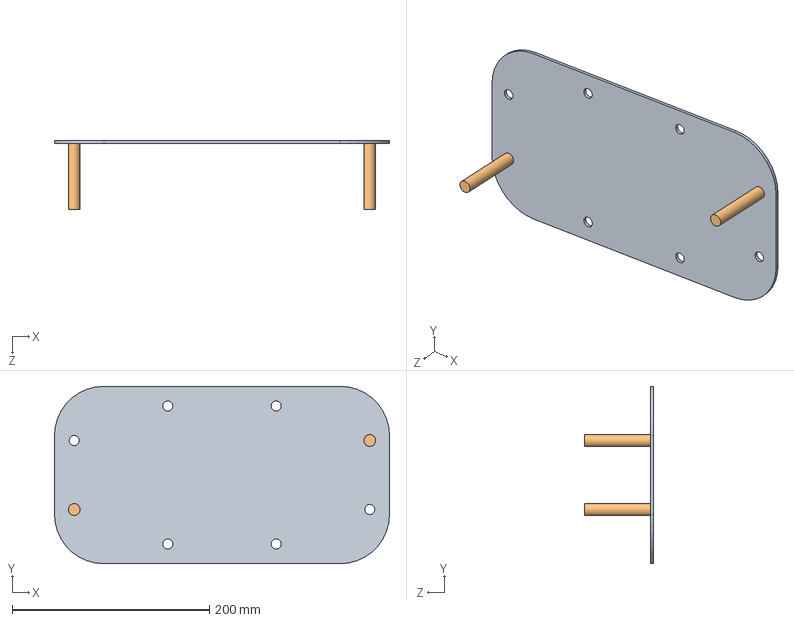
[picture p182: CAD file, 2025-03-02]
Jacku zadecyduj/klara/KLARA W SZCZEGÓLE/Płyta przednia.SLDASM
340.0 x 180.0 x 70.0 mm
aYy3004_płyta_pod_ramę_przod
pręt gwintowany m12 x 2
