Zykbyk/VACLAV/1. Zawieszenie/13. Motorsport/PUTM-S-Assembly/PUTM-S-SR-BS-Hose_Rear_Main.SLDPRT

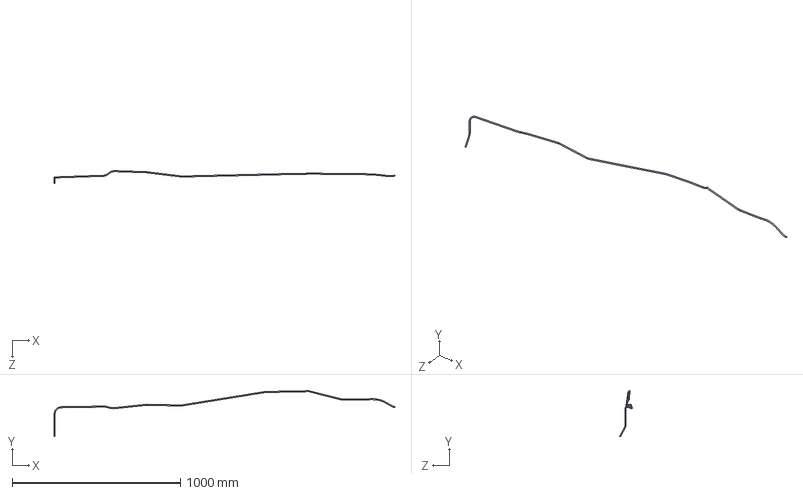
[picture p183: CAD file, 2021-10-25]
1. Zawieszenie/13. Motorsport/PUTM-S-Assembly/PUTM-S-SR-BS-Hose_Rear_Main.SLDPRT
2024.9 x 276.1 x 76.0 mm
