Zykbyk/VACLAV/1. Zawieszenie/13. Motorsport/PUTM-S-Assembly/PUTM-S-TR-GR-Chain.SLDASM

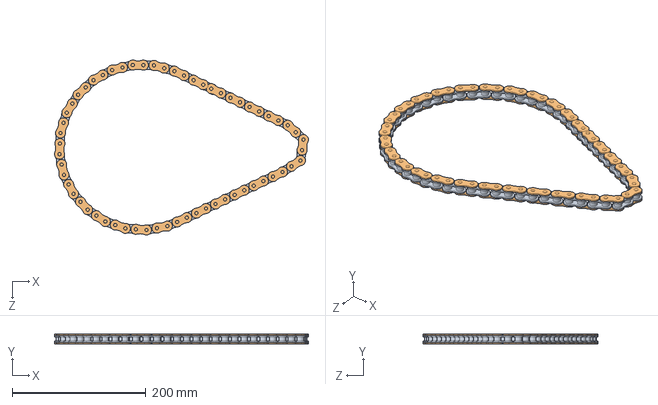
[picture p184: CAD file, 2021-10-25]
1. Zawieszenie/13. Motorsport/PUTM-S-Assembly/PUTM-S-TR-GR-Chain.SLDASM
380.2 x 15.4 x 261.9 mm
PUTM-S-TR-GR-Chain-Links-Inner x 30
PUTM-S-TR-GR-Chain-Links-Outer x 30
