Zykbyk/VACLAV/Jacku zadecyduj/klara/KLARA W SZCZEGÓLE/mocowaniemagiel.SLDASM

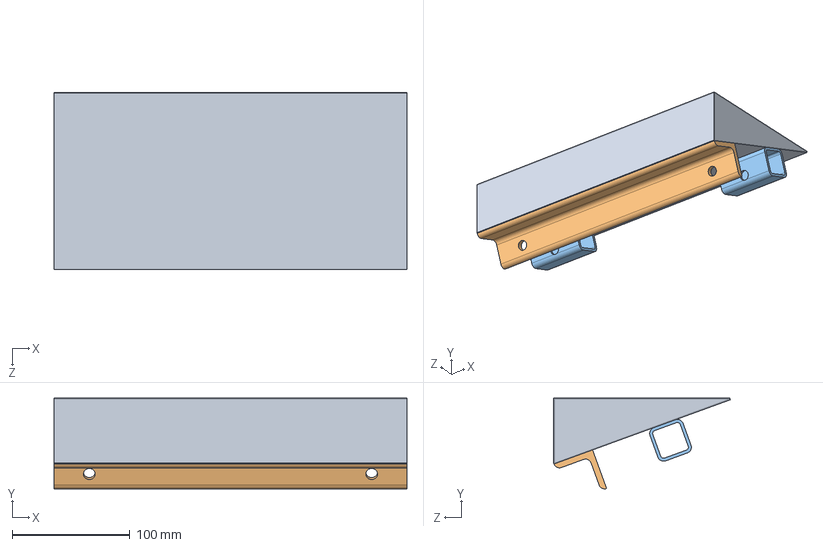
[picture p185: CAD file, 2025-03-02]
Jacku zadecyduj/klara/KLARA W SZCZEGÓLE/mocowaniemagiel.SLDASM
300.0 x 77.2 x 150.3 mm
mocowaniekolumny
kątownik mocowoaniamagla
profilmagla x 2
