Zykbyk/VACLAV/1. Zawieszenie/13. Motorsport/PUTM-F-Assembly/PUTM-F-FR-MT-Chain_cover_mounting.sldasm

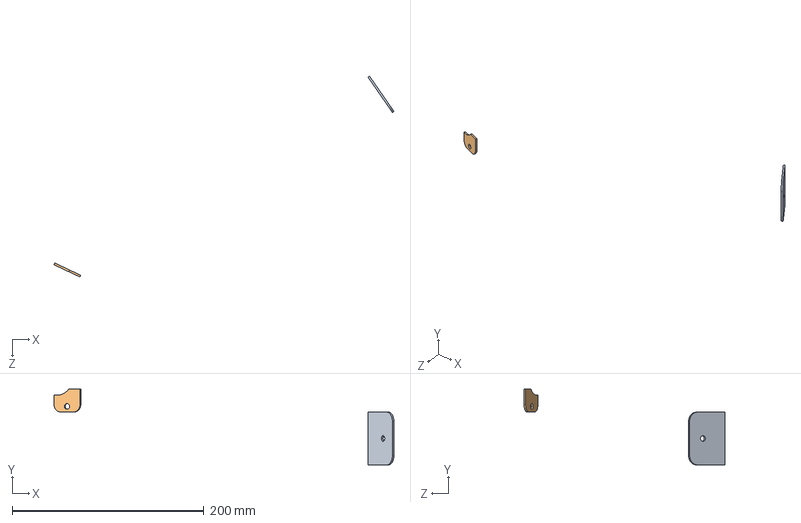
[picture p186: CAD file, 2021-10-25]
1. Zawieszenie/13. Motorsport/PUTM-F-Assembly/PUTM-F-FR-MT-Chain_cover_mounting.sldasm
354.6 x 79.0 x 209.7 mm
PUTM-F-FR-MT-Front
PUTM-F-FR-MT-Rear
