Zykbyk/VACLAV/1. Zawieszenie/13. Motorsport/PUTM-S-Assembly/PUTM-S-TR-DI-Bearing-Right-W61810-2RS1.SLDASM

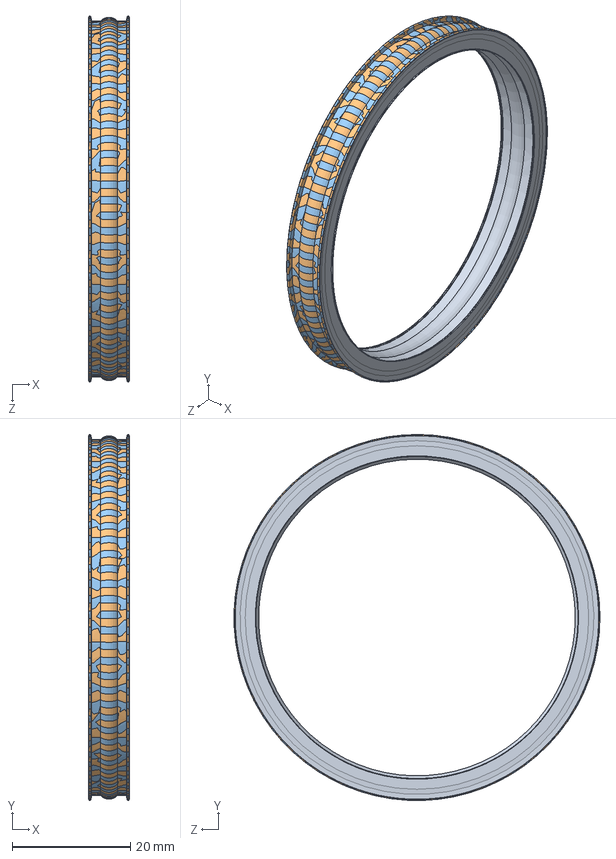
[picture p187: CAD file, 2021-10-25]
1. Zawieszenie/13. Motorsport/PUTM-S-Assembly/PUTM-S-TR-DI-Bearing-Right-W61810-2RS1.SLDASM
7.00 x 61.9 x 61.9 mm
_W 61810-2RS1_PART1 x 2
_W 61810-2RS1_PART2 x 2
_W 61810-2RS1_PART3 x 23
