Zykbyk/VACLAV/1. Zawieszenie/99. Pozostałe/Bobcat/Assem4.SLDASM

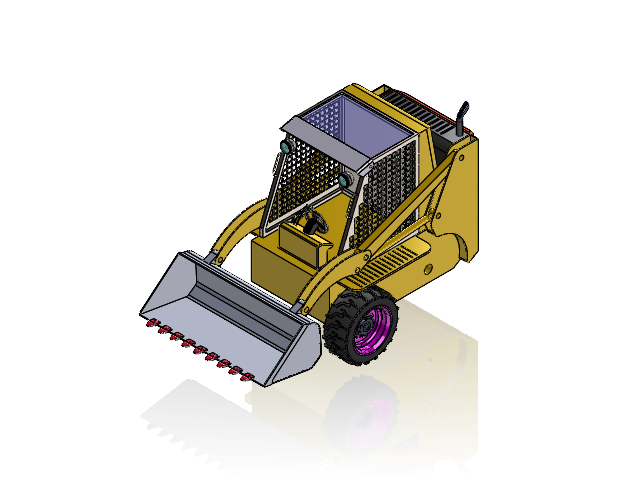
[picture p188: CAD file, 2025-03-02]
1. Zawieszenie/99. Pozostałe/Bobcat/Assem4.SLDASM
Main Body
Cabin
Back Support
Back Cover
Exhaust Pipe
Back
Cylinder body x 2
Lifting arm 2 x 2
Arm pin x 10
Lifting arm x 4
Cylinder Rod x 2
Bucket
Cabin Cap
Cabin Pin x 2
Bulb Cover x 2
Light Bulb x 2
Front light case x 2
Front Light Glass x 2
Axle
Rim
Tire
hex flange nut_am x 10
