Zykbyk/VACLAV/10. Zgredek/98. Stanowisko pomiarowe (badania klatki bezpieczeństwa)/Support/C-H-032-0100.SLDASM

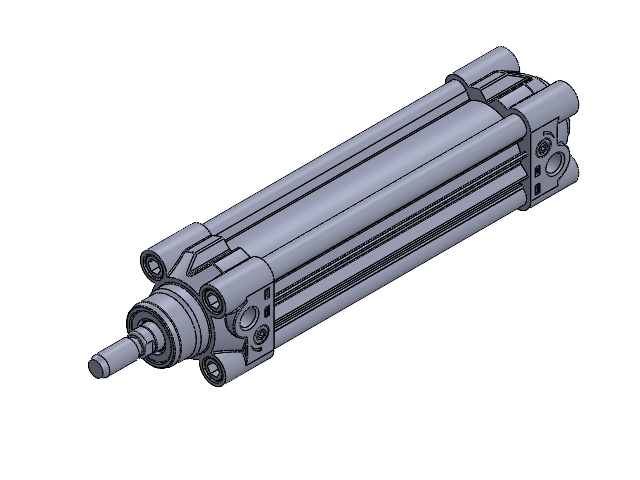
[picture p189: CAD file, 2025-03-02]
10. Zgredek/98. Stanowisko pomiarowe (badania klatki bezpieczeństwa)/Support/C-H-032-0100.SLDASM
TP.stp
STELO-100.stp
TA.stp
CORPO-100.stp
