Zykbyk/VACLAV/10. Zgredek/Złożenie całości.SLDASM

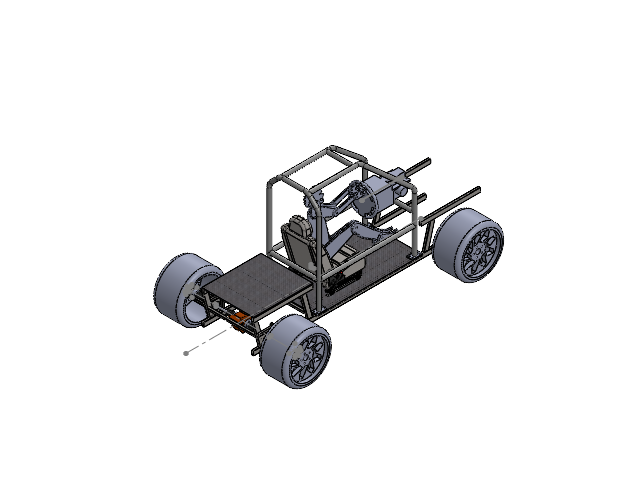
[picture p190: CAD file, 2025-03-02]
10. Zgredek/Złożenie całości.SLDASM
00-01-00-profile 60x30x3 x 14
00-04-00- Profile 30x30x3 x 17
00-06-00- Blacha 5mm
Część1^00-00-01 (rama podwozia v2)
04-03-00-Koło e39 x 3
00-05-00- laminowane płyty mdf x 2
03-03-00 silnik ME1616
03-06-00 krzyżak na kardan x 2
03-07-00 wpust na wałek silnika x 2
03-05-00 kardan
03-08-00 pająk
03-09-00 piasta sprzęgła
03-10-00 wałek przejściowy
03-11-00 nakładka kardanowska
03-13-00 piasta sprzęgła 2
03-01-00 dyfer e39
03-02-00 półoś e39 x 2
03-04-00 wał napędowy e39 1229144
03-12-00 piasta na koła tylne E39 x 2
02-01-00 - Klatka Bezpieczenstwa
02-02-00 - Element montazowy x 4
Rury aluminiowe
04-04-00 - łozysko piasty
00-07-00- Blacha 10mm x 4
Base siège conducteur
Dossier siège conducteur
Pivot
Pivot G
Verrouillage x 2
Boucle d ceinture
01-01-00- Kolumna kierownicza
ra_body
ra_head
ra_leg x 2
ra_lower thigh x 2
ra_lowerarm x 2
ra_neck
ra_palm x 2
ra_thigh x 2
ra_upperarm x 2
