Zykbyk/VACLAV/10. Zgredek/0. Podwozie-rama/00-00-01 (rama podwozia v2).SLDASM

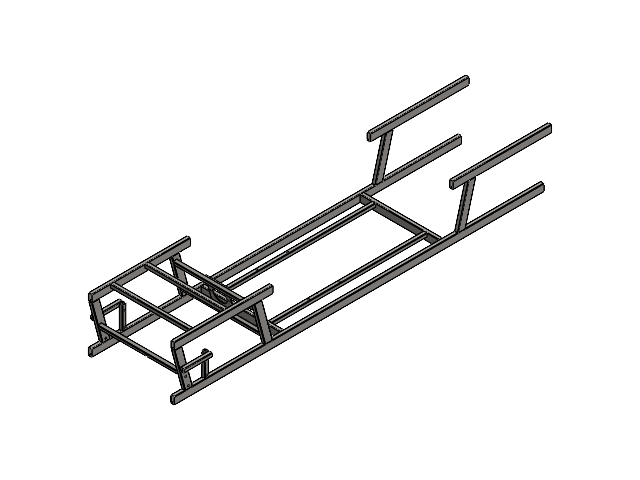
[picture p192: CAD file, 2025-03-02]
10. Zgredek/0. Podwozie-rama/00-00-01 (rama podwozia v2).SLDASM
00-01-00-profile 60x30x3 x 14
00-04-00- Profile 30x30x3 x 11
00-06-00- Blacha 5mm
Część1^00-00-01 (rama podwozia v2)
