Zykbyk/VACLAV/10. Zgredek/2. Klatka Bezpieczeństwa/02-00-01 - Klatka Bezpieczenstwa test.SLDASM

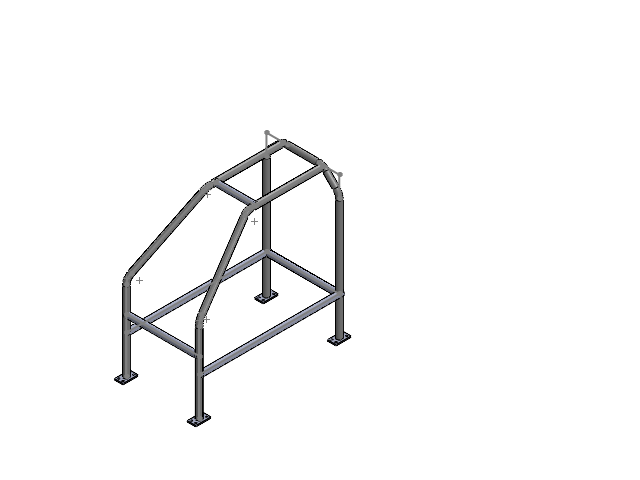
[picture p193: CAD file, 2025-03-02]
10. Zgredek/2. Klatka Bezpieczeństwa/02-00-01 - Klatka Bezpieczenstwa test.SLDASM
02-01-00 - Klatka Bezpieczenstwa
02-02-00 - Element montazowy x 4
Rury aluminiowe
