Zykbyk/VACLAV/11. Model człowieka/ra_human body.SLDASM

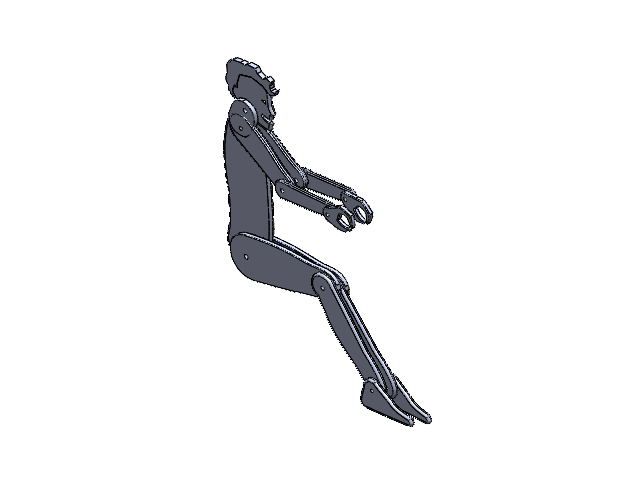
[picture p194: CAD file, 2025-03-02]
11. Model człowieka/ra_human body.SLDASM
ra_body
ra_head
ra_leg x 2
ra_lower thigh x 2
ra_lowerarm x 2
ra_neck
ra_palm x 2
ra_thigh x 2
ra_upperarm x 2
