Zykbyk/VACLAV/ESM/01_ESM - Rama/Zwrotnica_Zlozenie.SLDASM

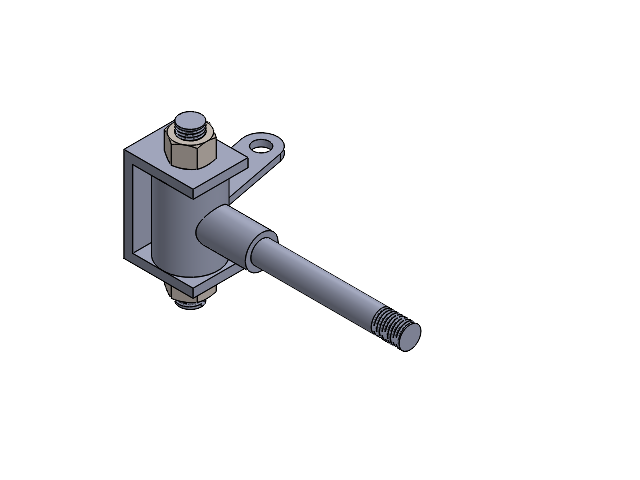
[picture p195: CAD file, 2025-05-25]
ESM/01_ESM - Rama/Zwrotnica_Zlozenie.SLDASM
Zwrotnica_Os
Os_Przod_Ceownik
Zwrotnica
hex nut gradec_iso x 2
