Zykbyk/VACLAV/10. Zgredek/98. Stanowisko pomiarowe (badania klatki bezpieczeństwa)/Kratownica/98.00.01- Kratownica.SLDASM

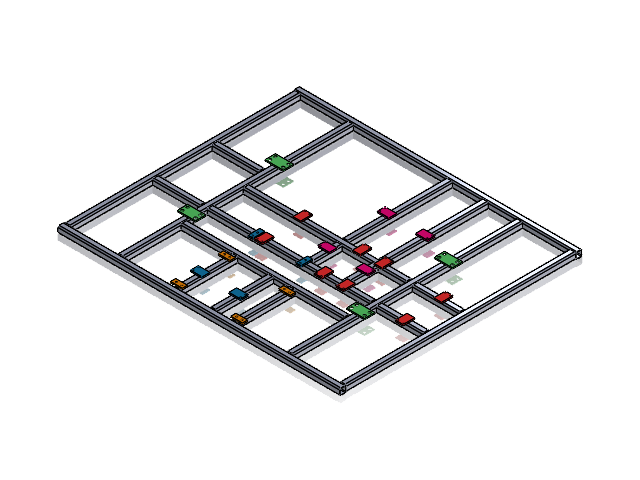
[picture p196: CAD file, 2025-03-02]
10. Zgredek/98. Stanowisko pomiarowe (badania klatki bezpieczeństwa)/Kratownica/98.00.01- Kratownica.SLDASM
98.01.00-profil(1749.2mm) x 4
98.02.00-profil(2150.8mm) x 2
98.04.00-profil(354.2mm) x 4
98.06.00-profil(790.2mm) x 2
98.05.00-profil(1239.2mm) x 3
98.07.00-profil(223.2mm) x 2
98.03.00-profil(434.2mm) x 3
98.08.00-płytka z czterema otworami (zielona) x 4
98.09.00-płytka z dwoma otworami (czerwona) x 8
98.10.00-płytka z dwoma otworami (różowa) x 4
98.11.00-płytka z dwoma otworami (pomarańczowa) x 4
98.13.00-płytka z dwoma otworami (niebieska większa) x 2
98.12.00-płytka z dwoma otworami (niebieska mniejsza) x 2
Spoina1_2- a3
Spoina pachwinowa a3
Spoina czołowa I
