Zykbyk/VACLAV/1. Zawieszenie/99. Pozostałe/Bobcat/sub assembly light.SLDASM

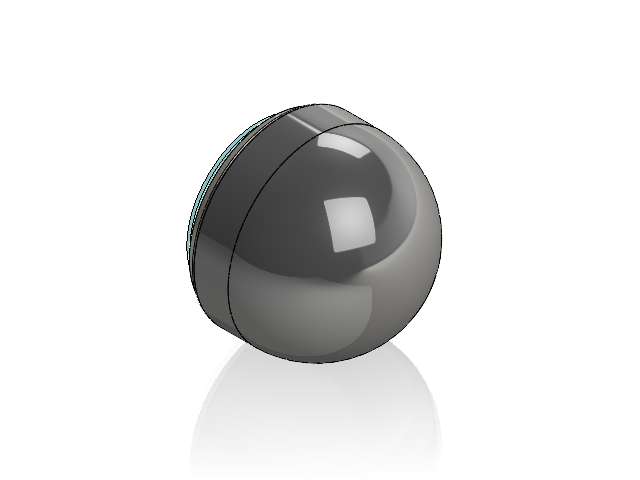
[picture p197: CAD file, 2025-03-02]
1. Zawieszenie/99. Pozostałe/Bobcat/sub assembly light.SLDASM
Bulb Cover
Light Bulb
Front light case
Front Light Glass
