Zykbyk/VACLAV/1. Zawieszenie/99. Pozostałe/Bobcat/tire assembly.SLDASM

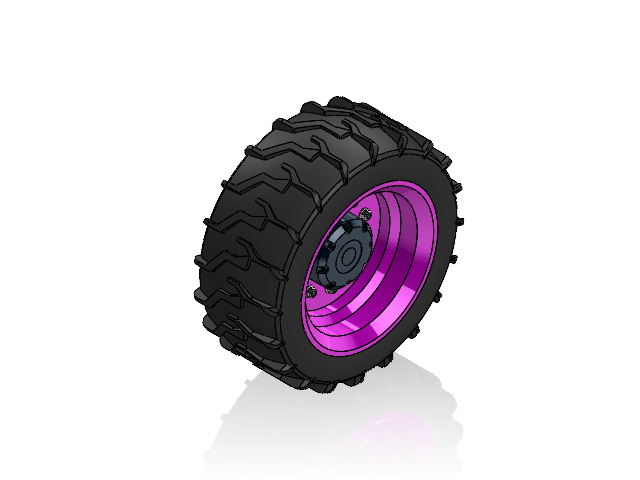
[picture p198: CAD file, 2025-03-02]
1. Zawieszenie/99. Pozostałe/Bobcat/tire assembly.SLDASM
Axle
Rim
Tire
hex flange nut_am x 10
