Zykbyk/VACLAV/Jacku zadecyduj/klara/KLARA W SZCZEGÓLE/aZłożenie1.SLDASM

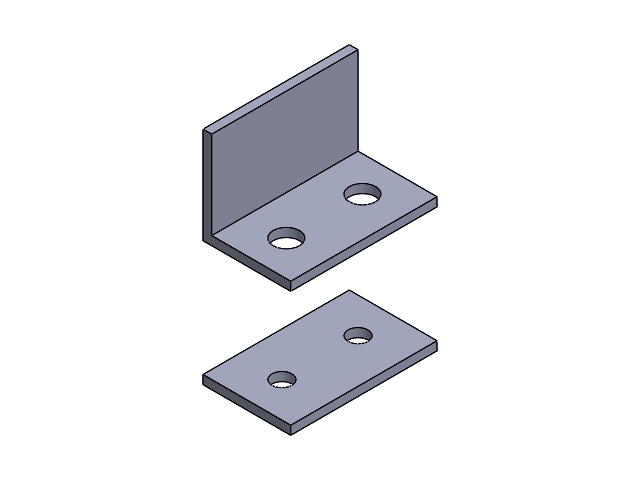
[picture p199: CAD file, 2025-03-02]
Jacku zadecyduj/klara/KLARA W SZCZEGÓLE/aZłożenie1.SLDASM
aucho
ablaszka
