Zykbyk/VACLAV/1. Zawieszenie/13. Motorsport/PUTM-G-Assembly/PUTM-G-BX-BSPD.SLDASM

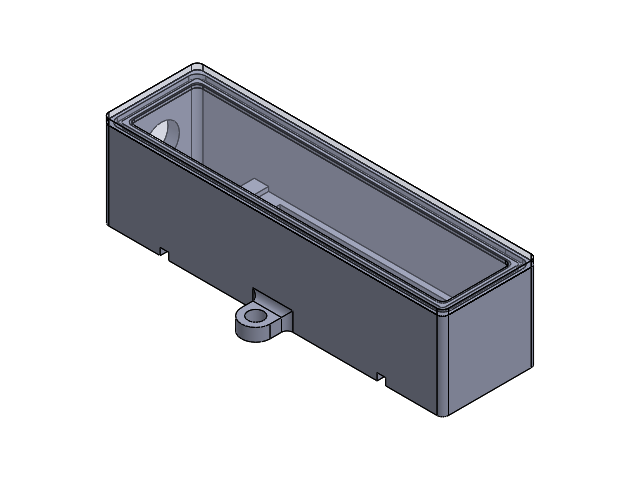
[picture p200: CAD file, 2021-10-25]
1. Zawieszenie/13. Motorsport/PUTM-G-Assembly/PUTM-G-BX-BSPD.SLDASM
PUTM-G-BX-BSPD_pojemnik
PUTM-G-BX-BSPD_Cover
