Zykbyk/VACLAV/(list of files, cad)

Other CAD files:
1. Zawieszenie/3. Układ koła przód/Zwrotnica prawa/Lustro01031100-2-00.SLDASM
10. Zgredek/0. Podwozie-rama/00-00-02- Wachacz prawy.SLDASM
00.ELEMENTY ZNORMALIZOWANE/Przegub kulowy_GN 648.2/Przegub kulowy_GN 648.2_10.SLDASM
1. Zawieszenie/1. Wahacze/ELEMENTY ZNORMALIZOWANE/Przegub kulowy_GN 648.2/Przegub kulowy_GN 648.2_10.SLDASM
1. Zawieszenie/13. Motorsport/PUTM-G-Assembly/PUTM-G-EB-Assembly.SLDASM
1. Zawieszenie/99. Pozostałe/Bobcat/Main Body.SLDPRT
00.ELEMENTY ZNORMALIZOWANE/Przegub kulowy_GN 648.2/Przegub kulowy_GN 648.2_16.SLDASM
00.ELEMENTY ZNORMALIZOWANE/Główka przegubowa_GN 648.8/Główka przegubowa_GN 648.8_12.SLDASM
00.ELEMENTY ZNORMALIZOWANE/Przegub kulowy_GN 648.2/Przegub kulowy_GN 648.2_12.SLDASM
1. Zawieszenie/13. Motorsport/PUTM-A-assembly/LustroPUTM-A-FW-skeleton_main.sldprt
1. Zawieszenie/13. Motorsport/PUTM-G-Assembly/PUTM-G-DS-Assembly.SLDASM
1. Zawieszenie/13. Motorsport/PUTM-G-Assembly/PUTM-G-BL-Assembly.SLDASM
1. Zawieszenie/13. Motorsport/PUTM-G-Assembly/PUTM-G-BX-Assembly.SLDASM
1. Zawieszenie/13. Motorsport/PUTM-G-Assembly/PUTM-G-AM-Assembly.SLDASM
1. Zawieszenie/13. Motorsport/PUTM-F-Assembly/PUTM-F-FR-MT-Aero-RW-Mountings.sldasm
1. Zawieszenie/13. Motorsport/PUTM-S-Assembly/LustroPUTM-S-SF-WT-Hub-Assembly.SLDASM
Jacku zadecyduj/klara/KLARA W SZCZEGÓLE/aYy3015_maglownica.SLDASM
1. Zawieszenie/13. Motorsport/PUTM-F-Assembly/PUTM-F-FR-MT-DampersMountings.sldasm
00.ELEMENTY ZNORMALIZOWANE/Główka przegubowa_GN 648.8/BALL-JOINT-GN-648.8-1-10.SLDPRT
00.ELEMENTY ZNORMALIZOWANE/Główka przegubowa_GN 648.8/BALL-JOINT-GN-648.8-1-12.SLDPRT
00.ELEMENTY ZNORMALIZOWANE/Główka przegubowa_GN 648.8/BALL-JOINT-GN-648.8-1-14.SLDPRT
00.ELEMENTY ZNORMALIZOWANE/Główka przegubowa_GN 648.8/BALL-JOINT-GN-648.8-1-16.SLDPRT
00.ELEMENTY ZNORMALIZOWANE/Główka przegubowa_GN 648.8/BALL-JOINT-GN-648.8-1-5.SLDPRT
00.ELEMENTY ZNORMALIZOWANE/Główka przegubowa_GN 648.8/BALL-JOINT-GN-648.8-1-6.SLDPRT
00.ELEMENTY ZNORMALIZOWANE/Główka przegubowa_GN 648.8/BALL-JOINT-GN-648.8-1-8.SLDPRT
00.ELEMENTY ZNORMALIZOWANE/Główka przegubowa_GN 648.8/BALL-JOINT-GN-648.8-2-10.SLDPRT
00.ELEMENTY ZNORMALIZOWANE/Główka przegubowa_GN 648.8/BALL-JOINT-GN-648.8-2-12.SLDPRT
00.ELEMENTY ZNORMALIZOWANE/Główka przegubowa_GN 648.8/BALL-JOINT-GN-648.8-2-14.SLDPRT
00.ELEMENTY ZNORMALIZOWANE/Główka przegubowa_GN 648.8/BALL-JOINT-GN-648.8-2-16.SLDPRT
00.ELEMENTY ZNORMALIZOWANE/Główka przegubowa_GN 648.8/BALL-JOINT-GN-648.8-2-5.SLDPRT
00.ELEMENTY ZNORMALIZOWANE/Główka przegubowa_GN 648.8/BALL-JOINT-GN-648.8-2-6.SLDPRT
00.ELEMENTY ZNORMALIZOWANE/Główka przegubowa_GN 648.8/BALL-JOINT-GN-648.8-2-8.SLDPRT
00.ELEMENTY ZNORMALIZOWANE/Nakrętka sześciokątna niska_DIN 439/Nakrętka sześciokątna niska_DIN 439_M10.SLDPRT
00.ELEMENTY ZNORMALIZOWANE/Nakrętka sześciokątna niska_DIN 439/Nakrętka sześciokątna niska_DIN 439_M12.SLDPRT
00.ELEMENTY ZNORMALIZOWANE/Nakrętka sześciokątna niska_DIN 439/Nakrętka sześciokątna niska_DIN 439_M14.SLDPRT
00.ELEMENTY ZNORMALIZOWANE/Nakrętka sześciokątna niska_DIN 439/Nakrętka sześciokątna niska_DIN 439_M16.SLDPRT
00.ELEMENTY ZNORMALIZOWANE/Nakrętka sześciokątna niska_DIN 439/Nakrętka sześciokątna niska_DIN 439_M18.SLDPRT
00.ELEMENTY ZNORMALIZOWANE/Nakrętka sześciokątna niska_DIN 439/Nakrętka sześciokątna niska_DIN 439_M2.SLDPRT
00.ELEMENTY ZNORMALIZOWANE/Nakrętka sześciokątna niska_DIN 439/Nakrętka sześciokątna niska_DIN 439_M20.SLDPRT
00.ELEMENTY ZNORMALIZOWANE/Nakrętka sześciokątna niska_DIN 439/Nakrętka sześciokątna niska_DIN 439_M22.SLDPRT
00.ELEMENTY ZNORMALIZOWANE/Nakrętka sześciokątna niska_DIN 439/Nakrętka sześciokątna niska_DIN 439_M24.SLDPRT
00.ELEMENTY ZNORMALIZOWANE/Nakrętka sześciokątna niska_DIN 439/Nakrętka sześciokątna niska_DIN 439_M3,5.SLDPRT
00.ELEMENTY ZNORMALIZOWANE/Nakrętka sześciokątna niska_DIN 439/Nakrętka sześciokątna niska_DIN 439_M3.SLDPRT
00.ELEMENTY ZNORMALIZOWANE/Nakrętka sześciokątna niska_DIN 439/Nakrętka sześciokątna niska_DIN 439_M4.SLDPRT
00.ELEMENTY ZNORMALIZOWANE/Nakrętka sześciokątna niska_DIN 439/Nakrętka sześciokątna niska_DIN 439_M5.SLDPRT
00.ELEMENTY ZNORMALIZOWANE/Nakrętka sześciokątna niska_DIN 439/Nakrętka sześciokątna niska_DIN 439_M6.SLDPRT
00.ELEMENTY ZNORMALIZOWANE/Nakrętka sześciokątna niska_DIN 439/Nakrętka sześciokątna niska_DIN 439_M8.SLDPRT
00.ELEMENTY ZNORMALIZOWANE/Podkładka stożkowa/Podkładka stożkowa_12-9.SLDPRT
00.ELEMENTY ZNORMALIZOWANE/Podkładka stożkowa/Podkładka stożkowa_16-8.SLDPRT
00.ELEMENTY ZNORMALIZOWANE/Przegub kulowy_GN 648.2/ROD-END-GN-648.2-1-10.SLDPRT
00.ELEMENTY ZNORMALIZOWANE/Przegub kulowy_GN 648.2/ROD-END-GN-648.2-1-12.SLDPRT
00.ELEMENTY ZNORMALIZOWANE/Przegub kulowy_GN 648.2/ROD-END-GN-648.2-1-14.SLDPRT
00.ELEMENTY ZNORMALIZOWANE/Przegub kulowy_GN 648.2/ROD-END-GN-648.2-1-16.SLDPRT
00.ELEMENTY ZNORMALIZOWANE/Przegub kulowy_GN 648.2/ROD-END-GN-648.2-1-5.SLDPRT
00.ELEMENTY ZNORMALIZOWANE/Przegub kulowy_GN 648.2/ROD-END-GN-648.2-1-6.SLDPRT
00.ELEMENTY ZNORMALIZOWANE/Przegub kulowy_GN 648.2/ROD-END-GN-648.2-1-8.SLDPRT
00.ELEMENTY ZNORMALIZOWANE/Przegub kulowy_GN 648.2/ROD-END-GN-648.2-2-10.SLDPRT
00.ELEMENTY ZNORMALIZOWANE/Przegub kulowy_GN 648.2/ROD-END-GN-648.2-2-12.SLDPRT
00.ELEMENTY ZNORMALIZOWANE/Przegub kulowy_GN 648.2/ROD-END-GN-648.2-2-14.SLDPRT
00.ELEMENTY ZNORMALIZOWANE/Przegub kulowy_GN 648.2/ROD-END-GN-648.2-2-16.SLDPRT
00.ELEMENTY ZNORMALIZOWANE/Przegub kulowy_GN 648.2/ROD-END-GN-648.2-2-5.SLDPRT
00.ELEMENTY ZNORMALIZOWANE/Przegub kulowy_GN 648.2/ROD-END-GN-648.2-2-6.SLDPRT
00.ELEMENTY ZNORMALIZOWANE/Przegub kulowy_GN 648.2/ROD-END-GN-648.2-2-8.SLDPRT
00.ELEMENTY ZNORMALIZOWANE/Przegub kulowy_GN 648.2/ROD-END-GN-648.2-3-10.SLDPRT
00.ELEMENTY ZNORMALIZOWANE/Przegub kulowy_GN 648.2/ROD-END-GN-648.2-3-12.SLDPRT
00.ELEMENTY ZNORMALIZOWANE/Przegub kulowy_GN 648.2/ROD-END-GN-648.2-3-14.SLDPRT
00.ELEMENTY ZNORMALIZOWANE/Przegub kulowy_GN 648.2/ROD-END-GN-648.2-3-16.SLDPRT
00.ELEMENTY ZNORMALIZOWANE/Przegub kulowy_GN 648.2/ROD-END-GN-648.2-3-5.SLDPRT
00.ELEMENTY ZNORMALIZOWANE/Przegub kulowy_GN 648.2/ROD-END-GN-648.2-3-6.SLDPRT
00.ELEMENTY ZNORMALIZOWANE/Przegub kulowy_GN 648.2/ROD-END-GN-648.2-3-8.SLDPRT
00.ELEMENTY ZNORMALIZOWANE/Spoiny/Spoiny czołowe I/Spoina czołowa I.SLDPRT
00.ELEMENTY ZNORMALIZOWANE/Spoiny/Spoiny pachwinowe/Spoina pachwinowa a3.SLDPRT
00.ELEMENTY ZNORMALIZOWANE/Spoiny/spoiny 1_2Y/Spoina1_2- a3.SLDPRT
00.ELEMENTY ZNORMALIZOWANE/Sworzeń pod zawleczkę_K1456/Sworzeń pod zawleczkę_K1456_10.SLDPRT
00.ELEMENTY ZNORMALIZOWANE/Sworzeń pod zawleczkę_K1456/Sworzeń pod zawleczkę_K1456_12.SLDPRT
00.ELEMENTY ZNORMALIZOWANE/Sworzeń pod zawleczkę_K1456/Sworzeń pod zawleczkę_K1456_14.SLDPRT
00.ELEMENTY ZNORMALIZOWANE/Sworzeń pod zawleczkę_K1456/Sworzeń pod zawleczkę_K1456_16.SLDPRT
00.ELEMENTY ZNORMALIZOWANE/Sworzeń pod zawleczkę_K1456/Sworzeń pod zawleczkę_K1456_4.SLDPRT
00.ELEMENTY ZNORMALIZOWANE/Sworzeń pod zawleczkę_K1456/Sworzeń pod zawleczkę_K1456_5.SLDPRT
00.ELEMENTY ZNORMALIZOWANE/Sworzeń pod zawleczkę_K1456/Sworzeń pod zawleczkę_K1456_6.SLDPRT
00.ELEMENTY ZNORMALIZOWANE/Sworzeń pod zawleczkę_K1456/Sworzeń pod zawleczkę_K1456_8.SLDPRT
00.ELEMENTY ZNORMALIZOWANE/Zawleczka prosta_ISO 1234/Zawlecza prosta_ISO 1234_1.6-12.SLDPRT
00.ELEMENTY ZNORMALIZOWANE/Śruba pasowana_ISO 7379_12-M10/Śruba pasowana_ISO 7379_12-M10-16.SLDPRT
00.ELEMENTY ZNORMALIZOWANE/Śruba pasowana_ISO 7379_12-M10/Śruba pasowana_ISO 7379_12-M10-20.SLDPRT
00.ELEMENTY ZNORMALIZOWANE/Śruba pasowana_ISO 7379_12-M10/Śruba pasowana_ISO 7379_12-M10-25.SLDPRT
00.ELEMENTY ZNORMALIZOWANE/Śruba pasowana_ISO 7379_12-M10/Śruba pasowana_ISO 7379_12-M10-30.SLDPRT
00.ELEMENTY ZNORMALIZOWANE/Śruba pasowana_ISO 7379_12-M10/Śruba pasowana_ISO 7379_12-M10-35.SLDPRT
00.ELEMENTY ZNORMALIZOWANE/Śruba pasowana_ISO 7379_12-M10/Śruba pasowana_ISO 7379_12-M10-40.SLDPRT
00.ELEMENTY ZNORMALIZOWANE/Śruba pasowana_ISO 7379_12-M10/Śruba pasowana_ISO 7379_12-M10-45.SLDPRT
00.ELEMENTY ZNORMALIZOWANE/Śruba pasowana_ISO 7379_12-M10/Śruba pasowana_ISO 7379_12-M10-50.SLDPRT
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
