Zykbyk/VACLAV/10. Zgredek/2. Klatka Bezpieczeństwa/Rysunki i STEP/PUT_SD_KB_01_merged.pdf

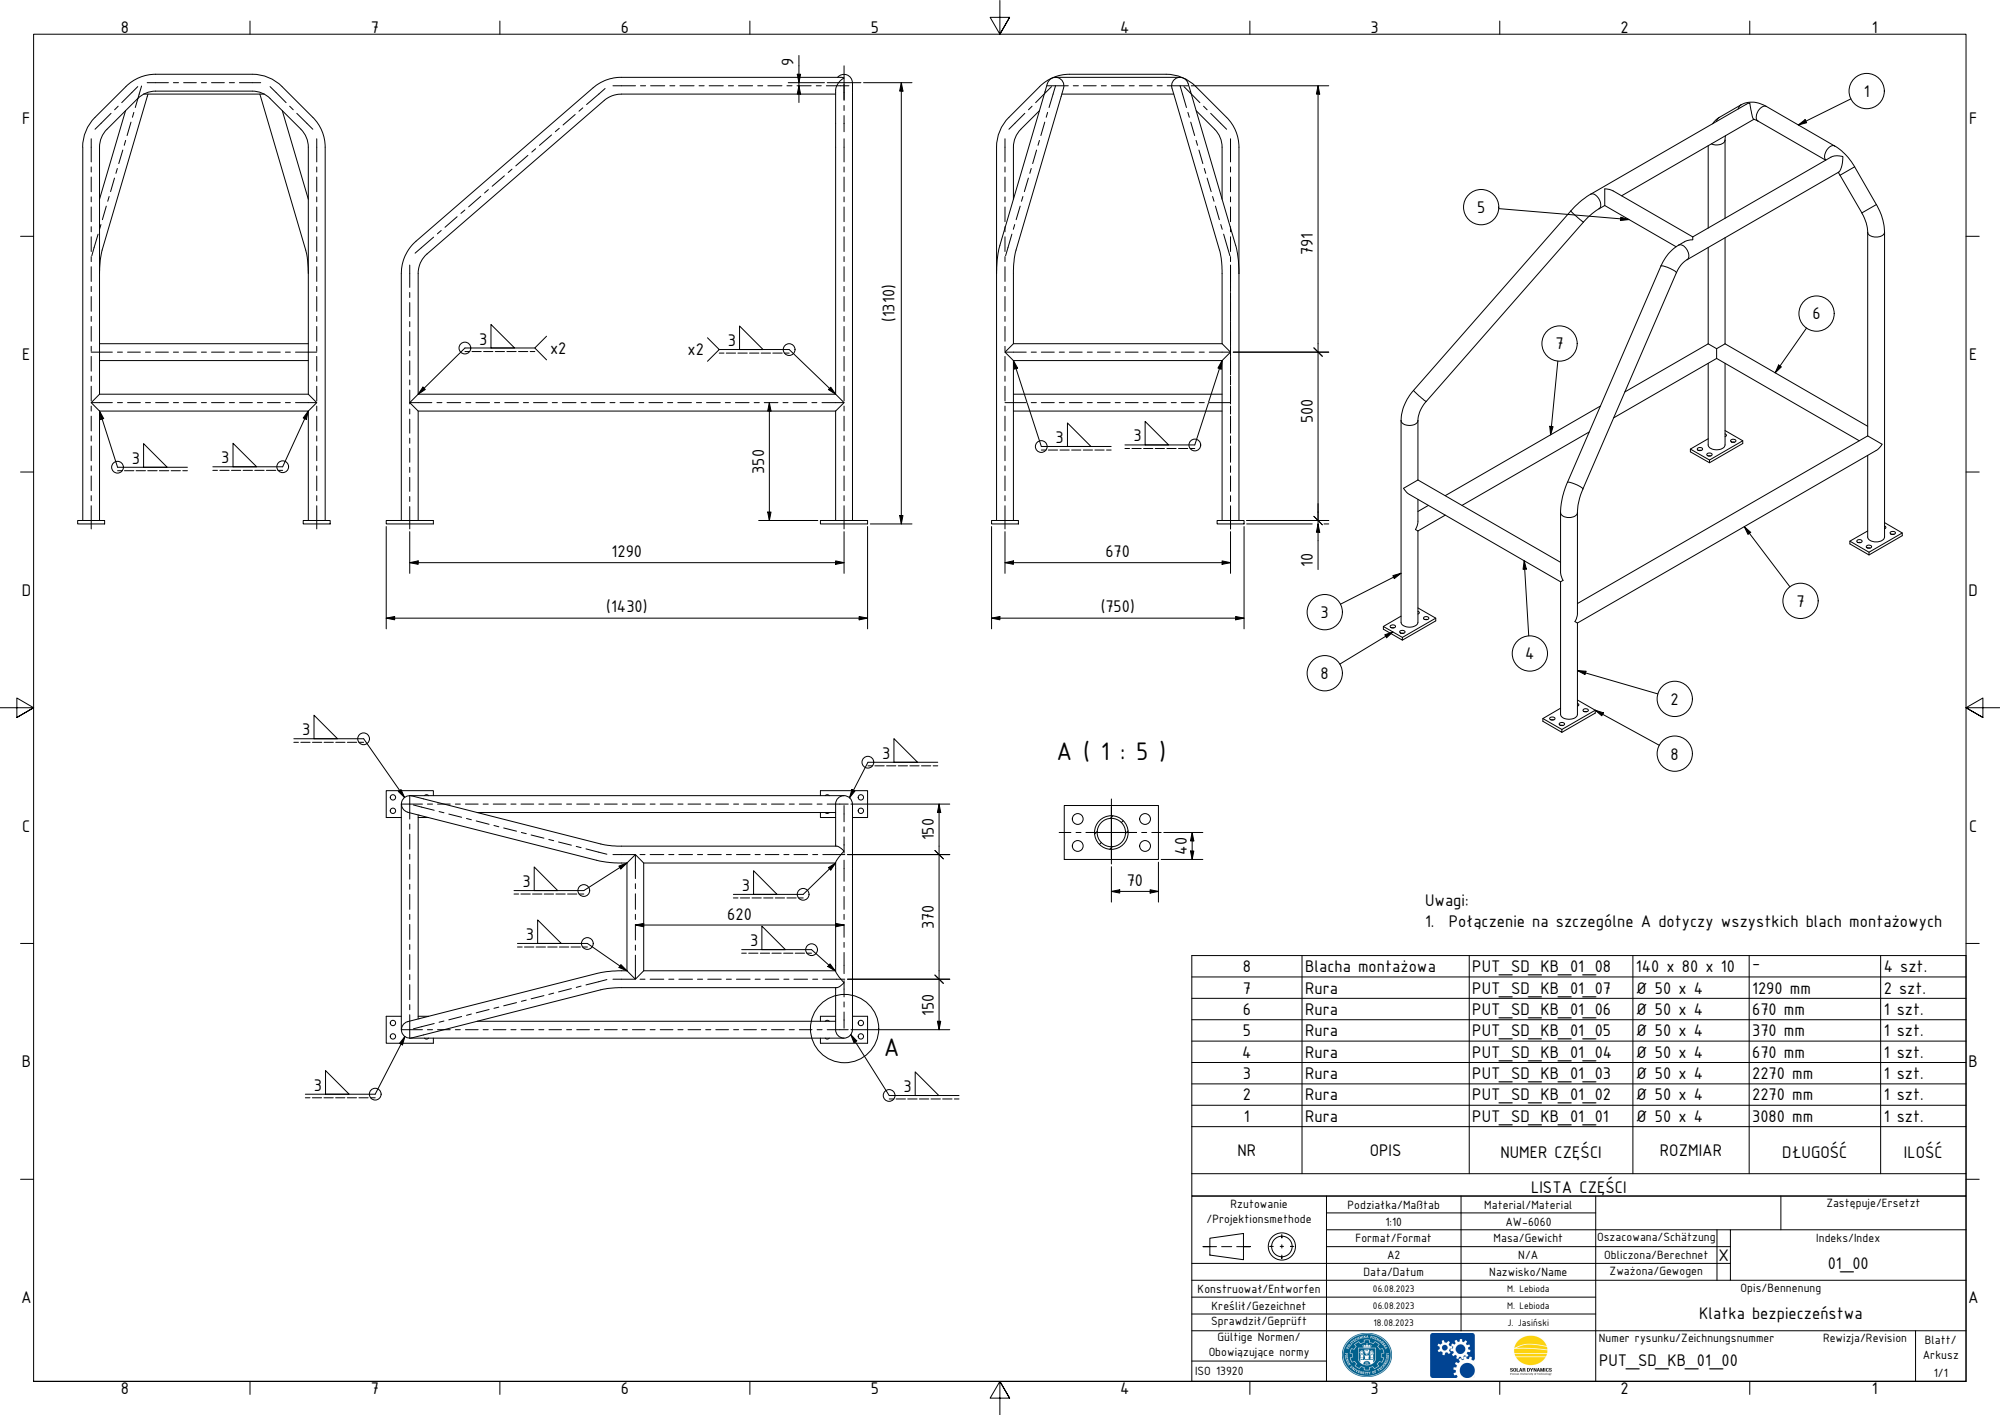
[picture p201: page 1]
Rura; PUT_SD_KB_01_01; 1 szt.; OPIS; NUMER CZĘŚCI; ROZMIAR; DŁUGOŚĆ; ILOŚĆ; Rzutowanie /Projektionsmethode; Podziałka/Maßtab; Material/Material; Konstruował/Entworfen; Kreślił/Gezeichnet Sprawdził/Geprüft; Gültige Normen/ Obowiązujące normy; Oszacowana/Schätzung; Obliczona/Berechnet Zważona/Gewogen; Zastępuje/Ersetzt; Indeks/Index; Opis/Bennenung; Numer rysunku/Zeichnungsnummer; Rewizja/Revision; Blatt/; Arkusz; PUT_SD_KB_01_00; M. Lebioda; Klatka bezpieczeństwa; ISO 13920; J. Jasiński

Uwagi:
1. Połączenie na szczególne A dotyczy wszystkich blach montażowych

8 | Blacha montażowa | PUT_SD_KB_01_08 | 140 x 80 x 10 | - | 4 szt.
7 | Rura | PUT_SD_KB_01_07 | Ø 50 x 4 | 1290 mm | 2 szt.
6 | Rura | PUT_SD_KB_01_06 | Ø 50 x 4 | 670 mm | 1 szt.
5 | Rura | PUT_SD_KB_01_05 | Ø 50 x 4 | 370 mm | 1 szt.
4 | Rura | PUT_SD_KB_01_04 | Ø 50 x 4 | 670 mm | 1 szt.
3 | Rura | PUT_SD_KB_01_03 | Ø 50 x 4 | 2270 mm | 1 szt.
2 | Rura | PUT_SD_KB_01_02 | Ø 50 x 4 | 2270 mm | 1 szt.

LISTA CZĘŚCI

1:10 | AW-6060
Format/Format A2 Data/Datum | Masa/Gewicht Nazwisko/Name

370

E | E

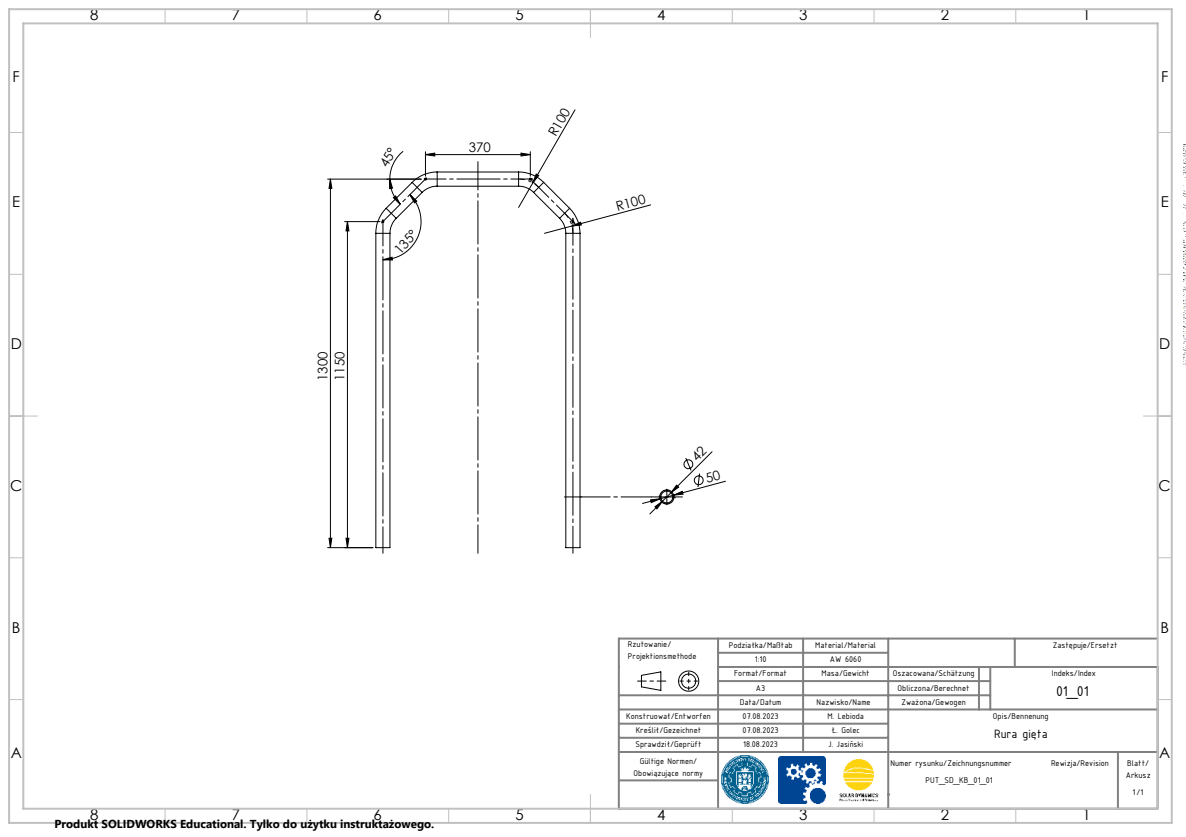
[picture p202: page 2]

Rzutowanie/ Projektionsmethode | Podziałka/Maßtab | Material/Material | | Zastępuje/Ersetzt

1:10 | AW 6060
Format/Format | Masa/Gewicht | Oszacowana/Schätzung | | Indeks/Index 01_01
A3 | | Obliczona/Berechnet
Data/Datum | Nazwisko/Name | Zważona/Gewogen

Konstruował/Entworfen | 07.08.2023 | M. Lebioda | Opis/Bennenung Rura gięta
Kreślił/Gezeichnet | 07.08.2023 | Ł. Golec
Sprawdził/Geprüft | 18.08.2023 | J. Jasiński
Gültige Normen/ | | Numer rysunku/Zeichnungsnummer Rewizja/Revision | Blatt/

Produkt SOLIDWORKS Educational. Tylko do użytku instruktażowego.

## UWAGA nr 1

E | E

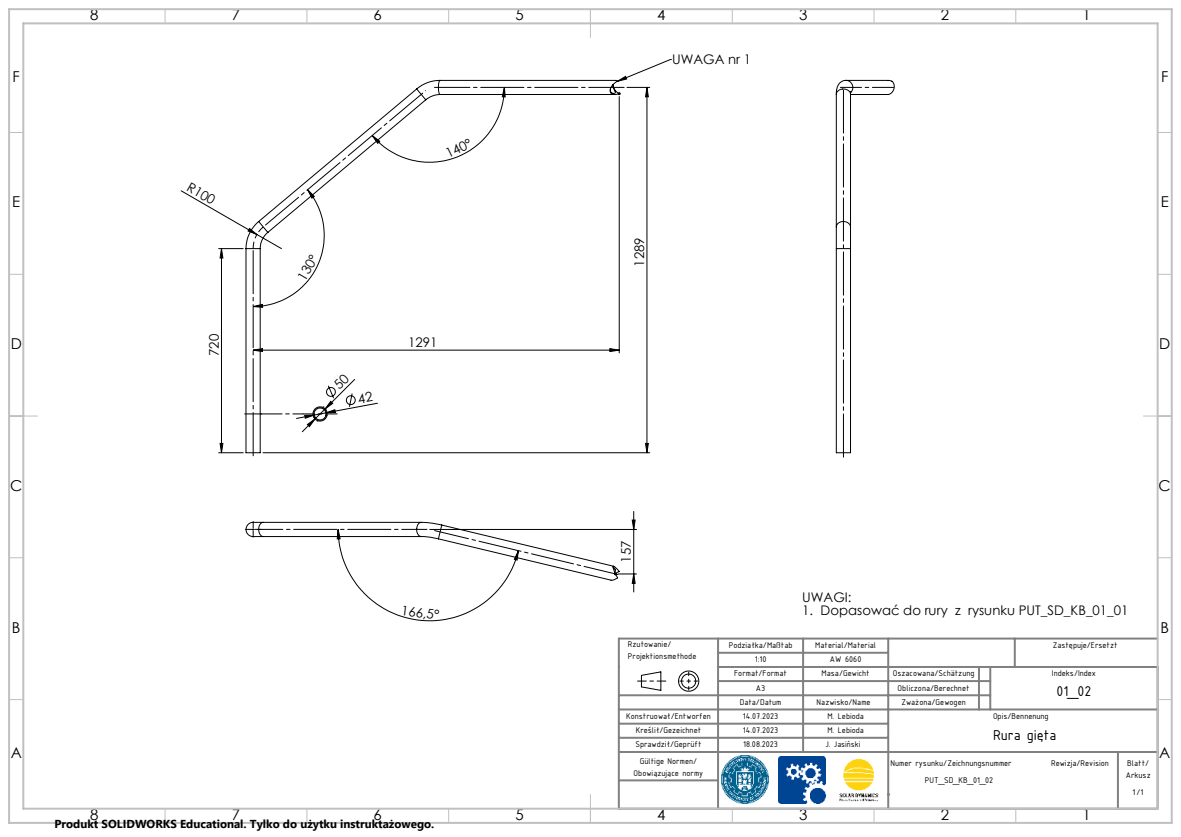
[picture p203: page 3]

UWAGI:
1. Dopasować do rury z rysunku PUT_SD_KB_01_01

Rzutowanie/ Projektionsmethode | Podziałka/Maßtab | Material/Material | | Zastępuje/Ersetzt

1:10 | AW 6060
Format/Format | Masa/Gewicht | Oszacowana/Schätzung | | Indeks/Index 01_02
A3 | | Obliczona/Berechnet
Data/Datum | Nazwisko/Name | Zważona/Gewogen

Konstruował/Entworfen | 14.07.2023 | M. Lebioda | Opis/Bennenung Rura gięta J. Jasiński
Kreślił/Gezeichnet | 14.07.2023 | M. Lebioda
Sprawdził/Geprüft | 18.08.2023
Gültige Normen/ | | Numer rysunku/Zeichnungsnummer Rewizja/Revision | Blatt/

## UWAGA nr 1

E | E

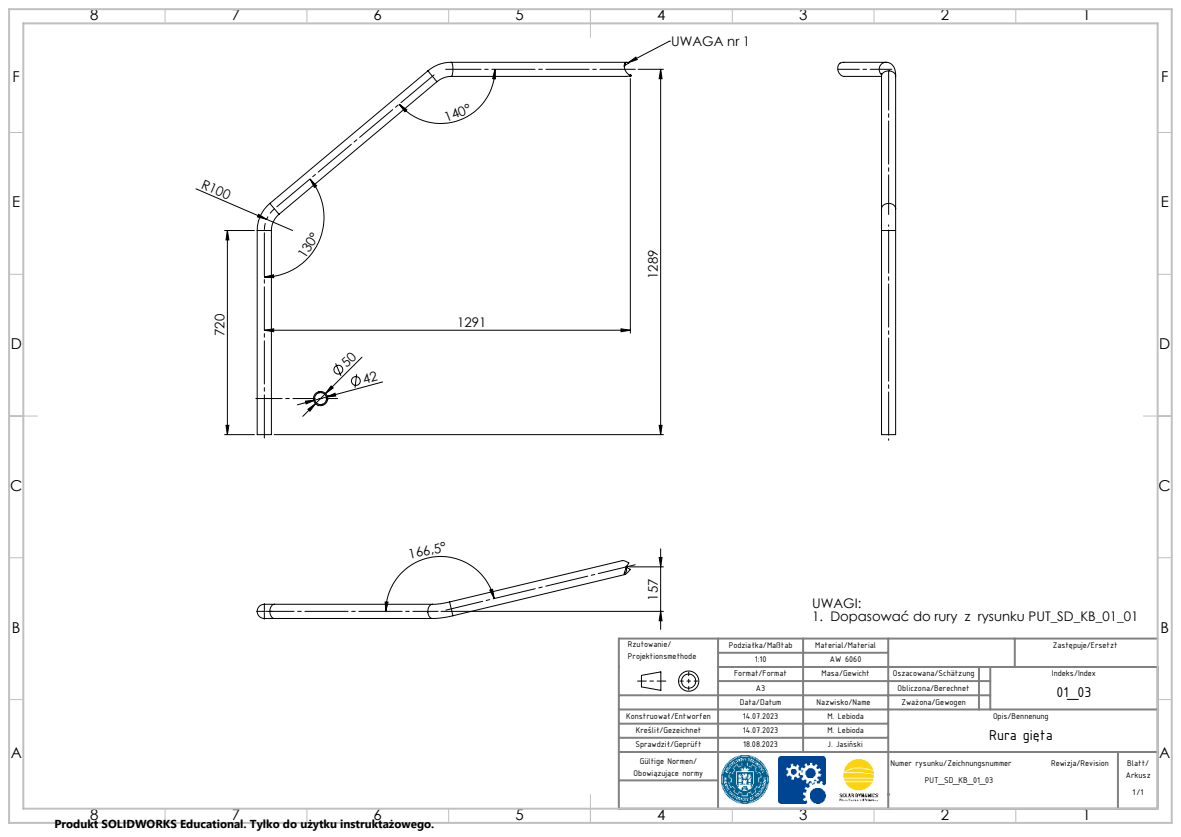
[picture p204: page 4]

UWAGI:
1. Dopasować do rury z rysunku PUT_SD_KB_01_01

Rzutowanie/ Projektionsmethode | Podziałka/Maßtab | Material/Material | | Zastępuje/Ersetzt

1:10 | AW 6060
Format/Format | Masa/Gewicht | Oszacowana/Schätzung | | Indeks/Index 01_03
A3 | | Obliczona/Berechnet
Data/Datum | Nazwisko/Name | Zważona/Gewogen

Konstruował/Entworfen | 14.07.2023 | M. Lebioda | Opis/Bennenung Rura gięta J. Jasiński
Kreślił/Gezeichnet | 14.07.2023 | M. Lebioda
Sprawdził/Geprüft | 18.08.2023
Gültige Normen/ | | Numer rysunku/Zeichnungsnummer Rewizja/Revision | Blatt/

E | E
F | F

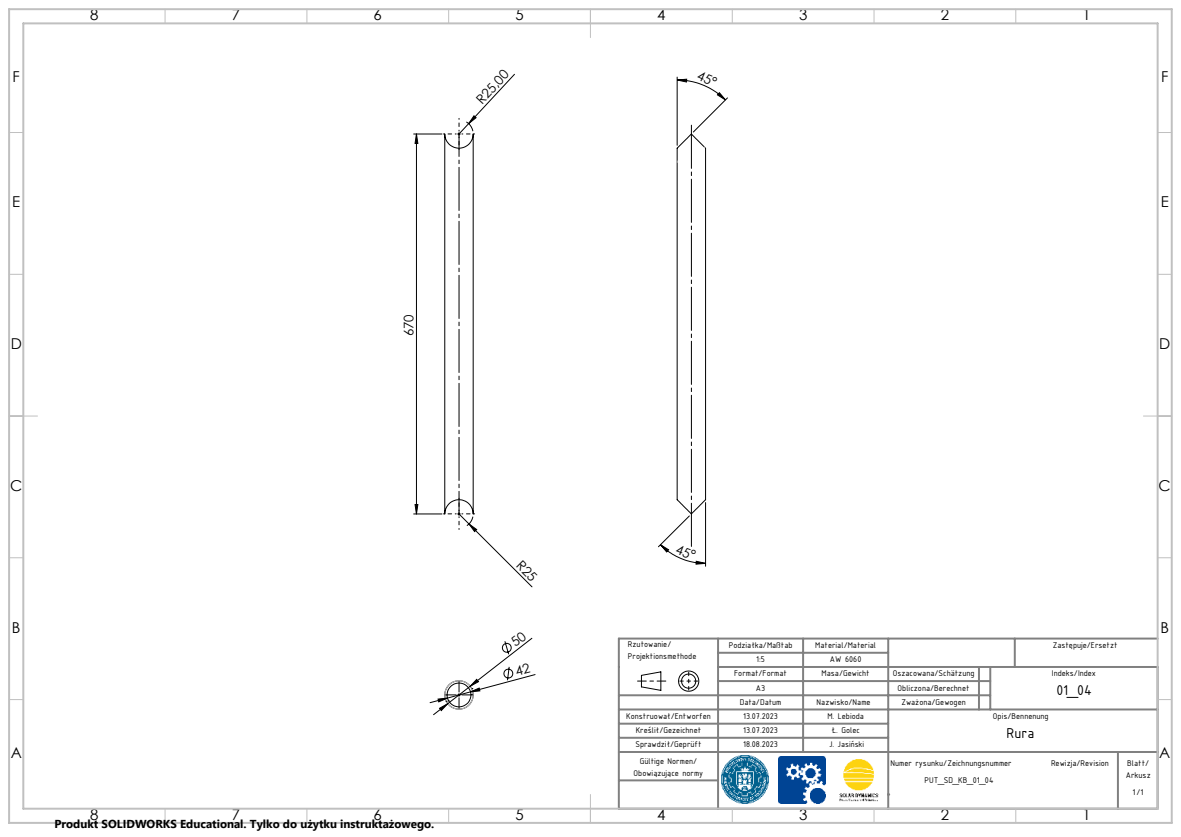
[picture p205: page 5]

Rzutowanie/ Projektionsmethode | Podziałka/Maßtab | Material/Material | | Zastępuje/Ersetzt

1:5 | AW 6060
Format/Format | Masa/Gewicht | Oszacowana/Schätzung | | Indeks/Index 01_04
A3 | | Obliczona/Berechnet
Data/Datum | Nazwisko/Name | Zważona/Gewogen

Konstruował/Entworfen | 13.07.2023 | M. Lebioda | Opis/Bennenung Rura
Kreślił/Gezeichnet | 13.07.2023 | Ł. Golec
Sprawdził/Geprüft | 18.08.2023 | J. Jasiński
Gültige Normen/ | | Numer rysunku/Zeichnungsnummer Rewizja/Revision | Blatt/

E | E
F | F

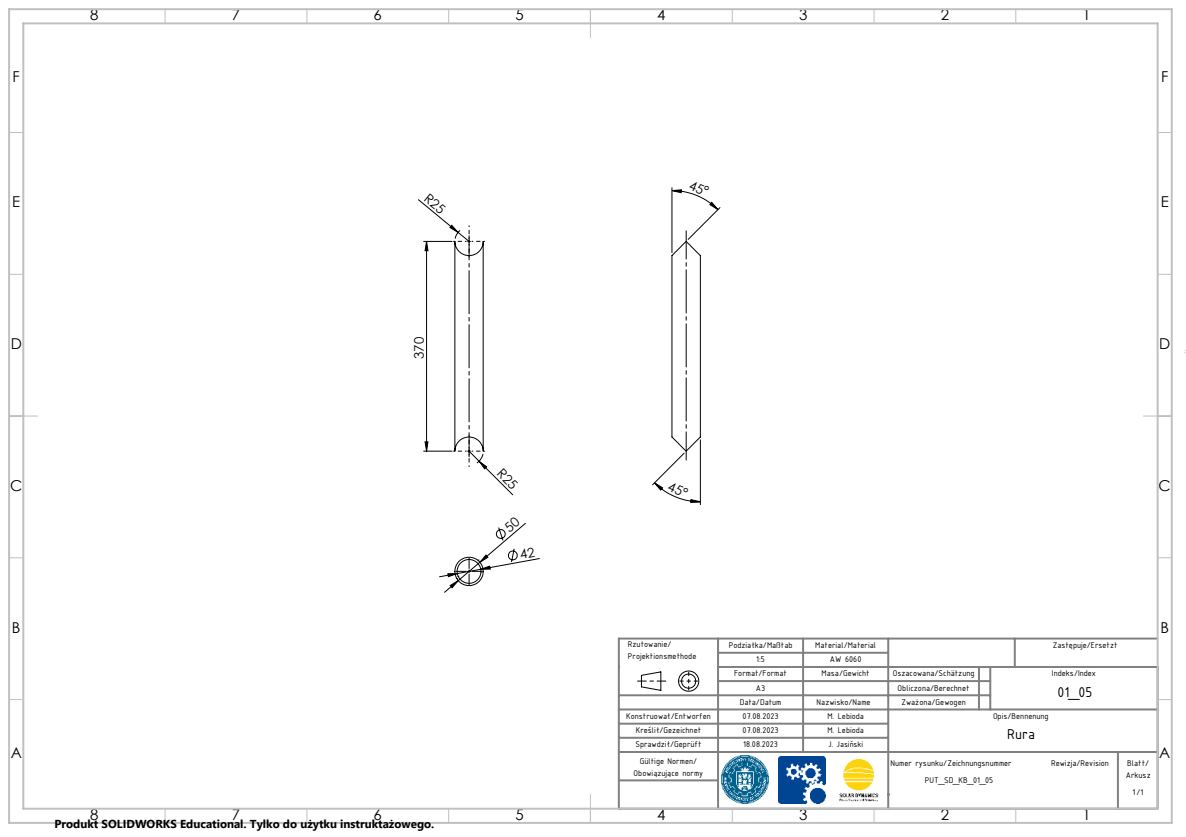
[picture p206: page 6]

Rzutowanie/ Projektionsmethode | Podziałka/Maßtab | Material/Material | | Zastępuje/Ersetzt

1:5 | AW 6060
Format/Format | Masa/Gewicht | Oszacowana/Schätzung | | Indeks/Index 01_05
A3 | | Obliczona/Berechnet
Data/Datum | Nazwisko/Name | Zważona/Gewogen

Konstruował/Entworfen | 07.08.2023 | M. Lebioda | Opis/Bennenung Rura
Kreślił/Gezeichnet | 07.08.2023 | M. Lebioda
Sprawdził/Geprüft | 18.08.2023 | J. Jasiński
Gültige Normen/ | | Numer rysunku/Zeichnungsnummer Rewizja/Revision | Blatt/

E | E
F | F

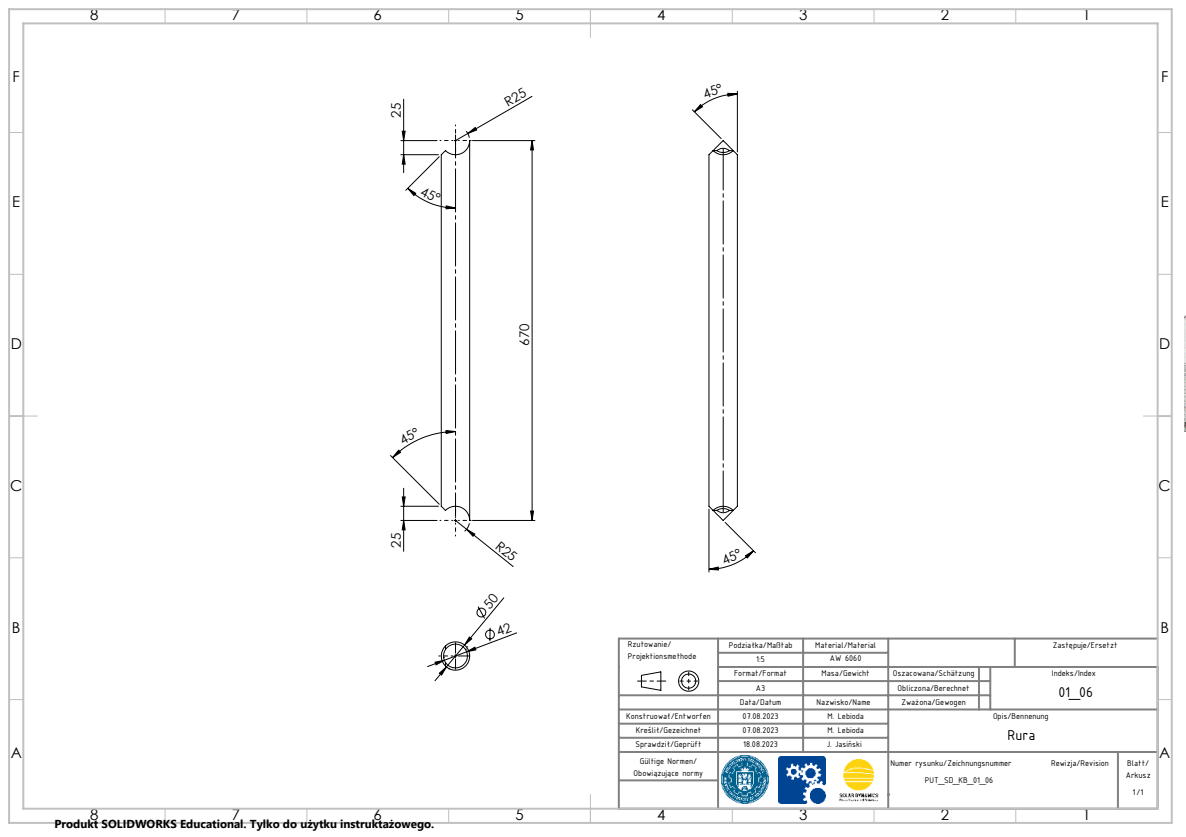
[picture p207: page 7]

Rzutowanie/ Projektionsmethode | Podziałka/Maßtab | Material/Material | | Zastępuje/Ersetzt

1:5 | AW 6060
Format/Format | Masa/Gewicht | Oszacowana/Schätzung | | Indeks/Index 01_06
A3 | | Obliczona/Berechnet
Data/Datum | Nazwisko/Name | Zważona/Gewogen

Konstruował/Entworfen | 07.08.2023 | M. Lebioda | Opis/Bennenung Rura
Kreślił/Gezeichnet | 07.08.2023 | M. Lebioda
Sprawdził/Geprüft | 18.08.2023 | J. Jasiński
Gültige Normen/ | | Numer rysunku/Zeichnungsnummer Rewizja/Revision | Blatt/

E | E
F | F

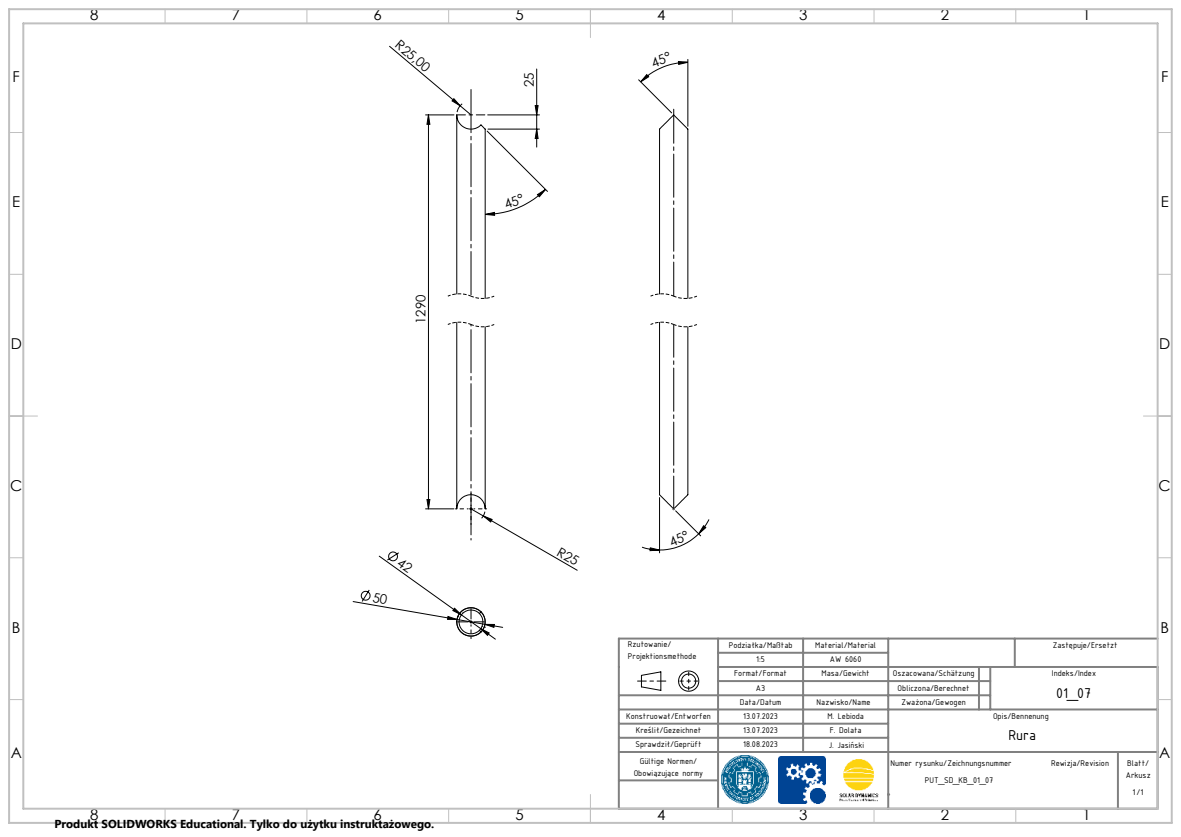
[picture p208: page 8]

Rzutowanie/ Projektionsmethode | Podziałka/Maßtab | Material/Material | | Zastępuje/Ersetzt

1:5 | AW 6060
Format/Format | Masa/Gewicht | Oszacowana/Schätzung | | Indeks/Index 01_07
A3 | | Obliczona/Berechnet
Data/Datum | Nazwisko/Name | Zważona/Gewogen

Konstruował/Entworfen | 13.07.2023 | M. Lebioda | Opis/Bennenung Rura
Kreślił/Gezeichnet | 13.07.2023 | F. Dolata
Sprawdził/Geprüft | 18.08.2023 | J. Jasiński
Gültige Normen/ | | Numer rysunku/Zeichnungsnummer Rewizja/Revision | Blatt/

E | E
F | F

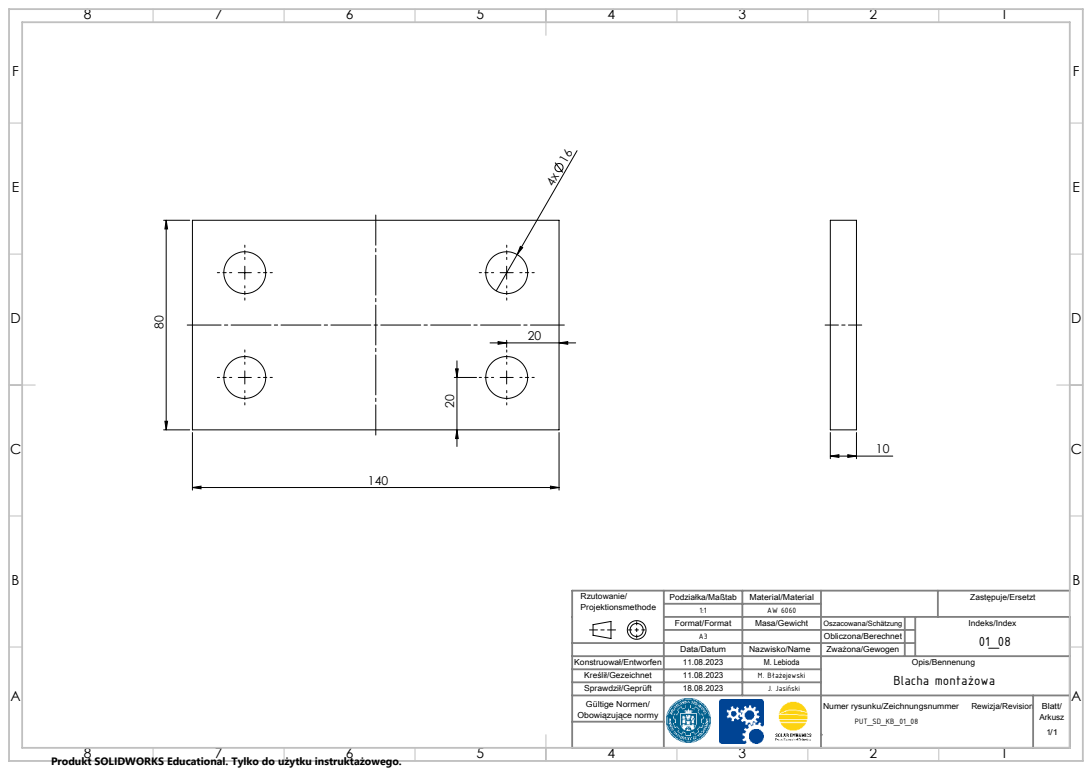
[picture p209: page 9]

Rzutowanie/ Projektionsmethode | Podziałka/Maßtab | Material/Material | | Zastępuje/Ersetzt

1:1 | AW 6060
Format/Format | Masa/Gewicht | Oszacowana/Schätzung | | Indeks/Index 01_08
A3 | | Obliczona/Berechnet
Data/Datum | Nazwisko/Name | Zważona/Gewogen

Konstruował/Entworfen | 11.08.2023 | M. Lebioda | Opis/Bennenung Blacha montażowa
Kreślił/Gezeichnet | 11.08.2023 | M. Błażejewski
Sprawdził/Geprüft | 18.08.2023 | J. Jasiński
Gültige Normen/ | | Numer rysunku/Zeichnungsnummer Rewizja/Revision | Blatt/ 1/1
