Zykbyk/VACLAV/0. Instrukcje i inne ważne pliki/Dokumentacja KLARA/Assembly.pdf

# SCALE 1:10 SCALE 1:10

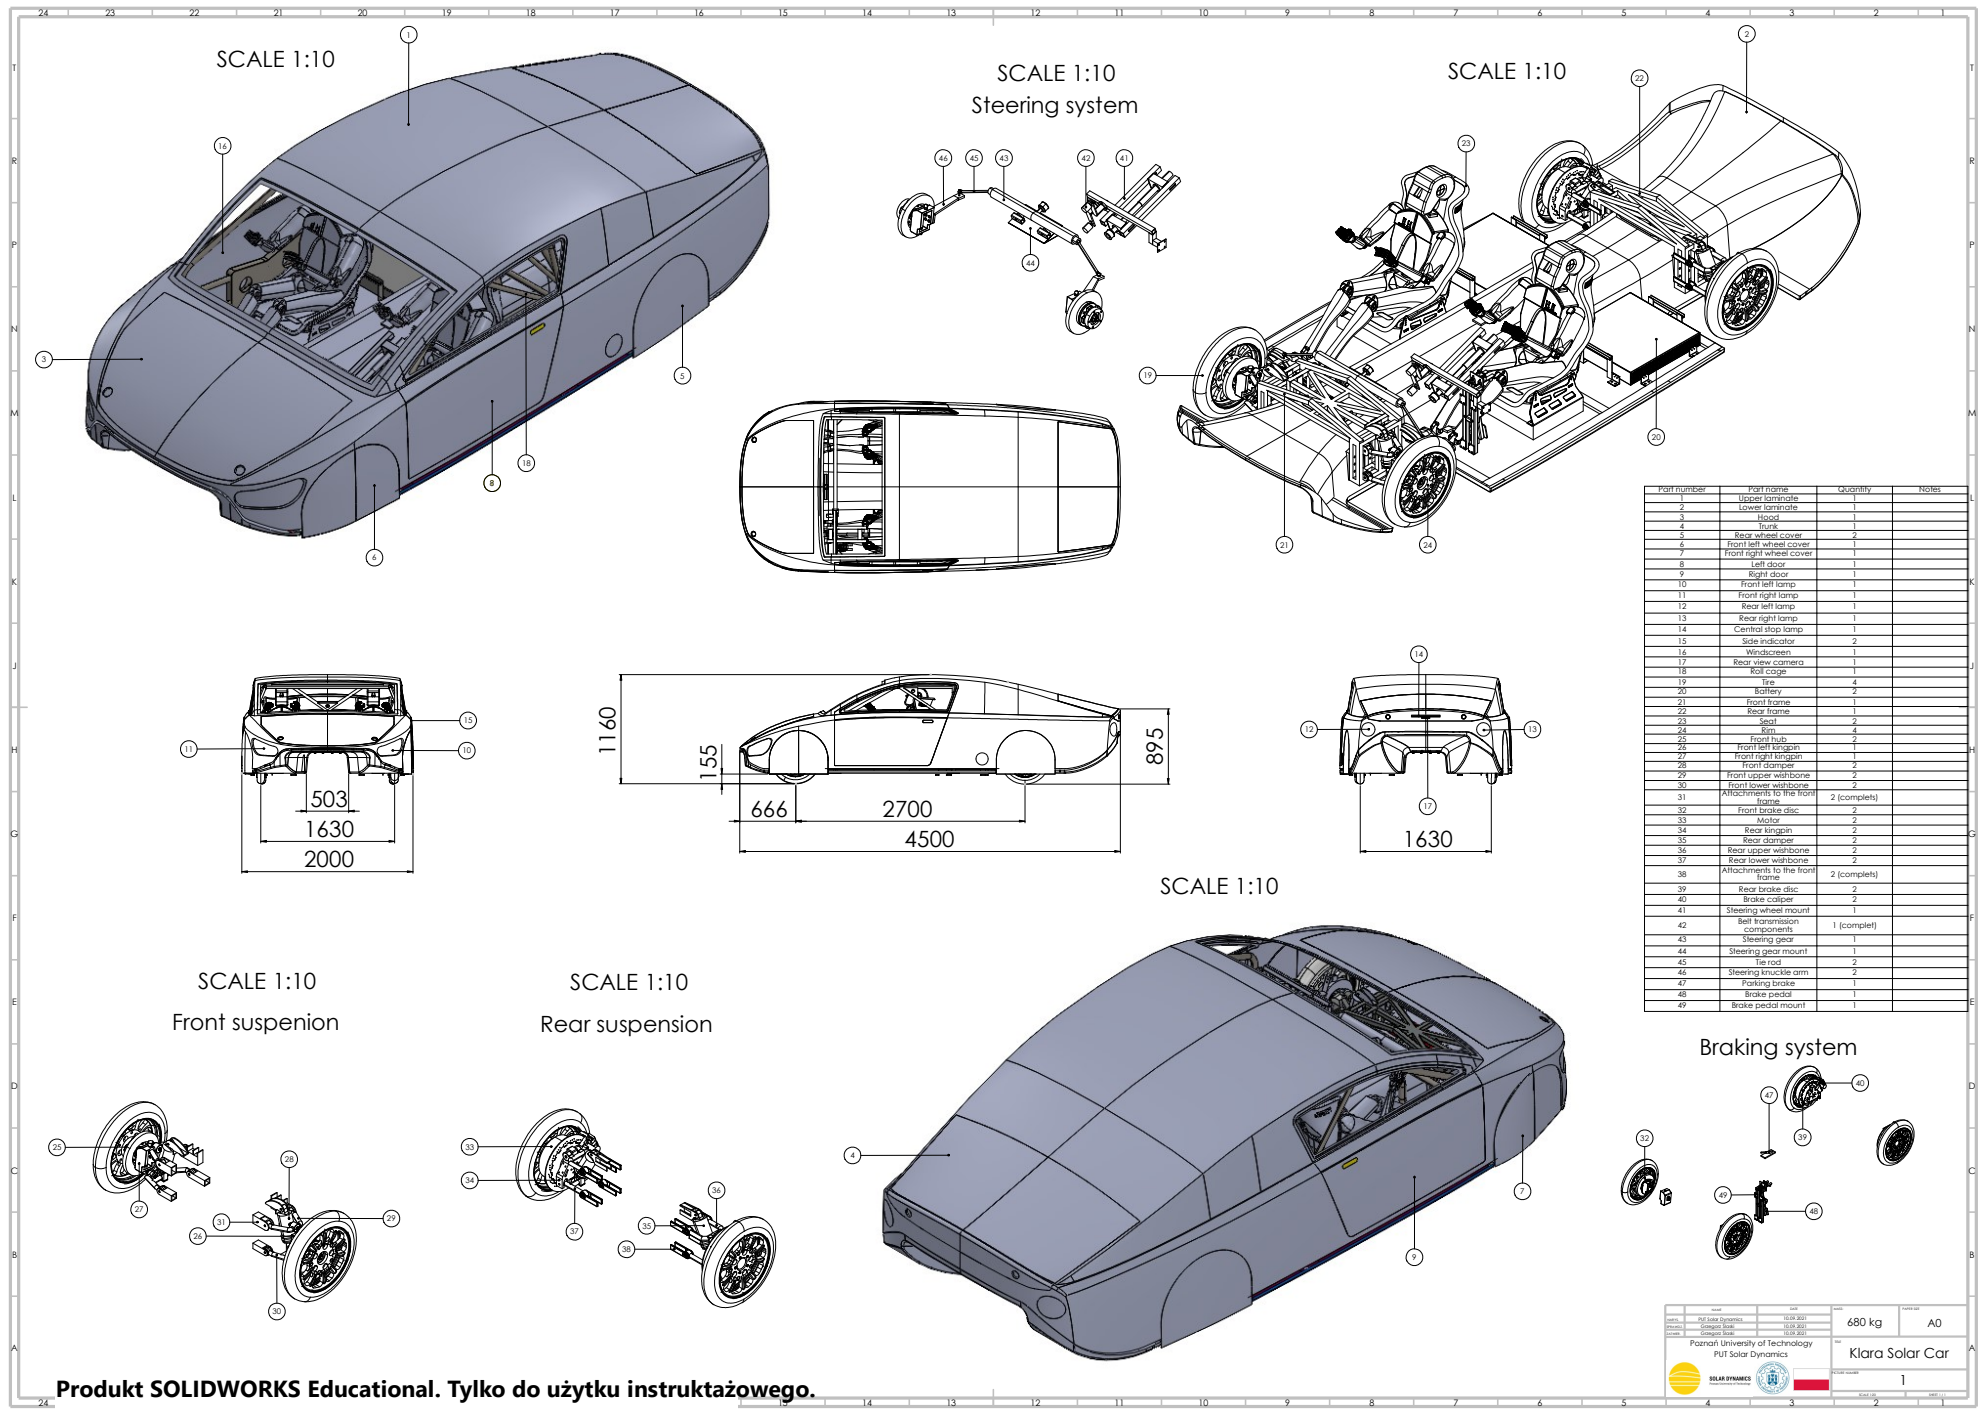
[picture p210: page 1]
PICTURE NUMBER; SCALE 1:20; SHEET 1 / 1; Part number; Part name; Quantity; Notes; Upper laminate; Lower laminate; Hood; Trunk; Rear wheel cover; Front left wheel cover; Front right wheel cover; Left door; Right door; Front left lamp; Front right lamp; Rear left lamp; Rear right lamp; Central stop lamp; Side indicator; Windscreen; Rear view camera; Roll cage; Tire; Battery; Front frame; Rear frame; Seat; Rim; Front hub; Front left kingpin; Front right kingpin; Front damper; Front upper wishbone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

31 Attachments to the front
38 Attachments to the front

NAME | DATE | MASS: 680 kg | PAPER SIZE A0

NARYS. | PUT Solar Dynamics | 10.09.2021
SPRAWDZ. | Grzegorz Ślaski | 10.09.2021
ZATWIER. | Grzegorz Ślaski | 10.09.2021

Produkt SOLIDWORKS Educational. Tylko do użytku instruktażowego.

Poznań University of Technology PUT Solar Dynamics | | | TITLE Klara Solar Car
