Zykbyk/VACLAV/10. Zgredek/2. Klatka Bezpieczeństwa/Rysunki i STEP/PUT_SD_KB_01_00.pdf

LISTA CZĘŚCI; ISO 13920

Uwagi:
1. Połączenie na szczególne A dotyczy wszystkich blach montażowych

8 | Blacha montażowa | PUT_SD_KB_01_08 | 140 x 80 x 10 | - | 4 szt.
7 | Rura | PUT_SD_KB_01_07 | Ø 50 x 4 | 1290 mm | 2 szt.
6 | Rura | PUT_SD_KB_01_06 | Ø 50 x 4 | 670 mm | 1 szt.
5 | Rura | PUT_SD_KB_01_05 | Ø 50 x 4 | 370 mm | 1 szt.
4 | Rura | PUT_SD_KB_01_04 | Ø 50 x 4 | 670 mm | 1 szt.
3 | Rura | PUT_SD_KB_01_03 | Ø 50 x 4 | 2270 mm | 1 szt.
2 | Rura | PUT_SD_KB_01_02 | Ø 50 x 4 | 2270 mm | 1 szt.
1 | Rura | PUT_SD_KB_01_01 | Ø 50 x 4 | 3080 mm | 1 szt.

NR | OPIS | NUMER CZĘŚCI | ROZMIAR | DŁUGOŚĆ | ILOŚĆ

Rzutowanie /Projektionsmethode | Podziałka/Maßtab | Material/Material | | Zastępuje/Ersetzt

1:10 | AW-6060
Format/Format | Masa/Gewicht | Oszacowana/Schätzung | | Indeks/Index 01_00
A2 | N/A | Obliczona/Berechnet | X
Data/Datum | Nazwisko/Name | Zważona/Gewogen

Konstruował/Entworfen | 06.08.2023 | M. Lebioda | Opis/Bennenung Klatka bezpieczeństwa

Kreślił/Gezeichnet | 06.08.2023 | M. Lebioda
Sprawdził/Geprüft | 18.08.2023 | J. Jasiński
Gültige Normen/ Obowiązujące normy | | Numer rysunku/Zeichnungsnummer Rewizja/Revision PUT_SD_KB_01_00 | Blatt/ Arkusz 1/1
