Zykbyk/VACLAV/10. Zgredek/0. Podwozie-rama/Rysunki/00-07-00- Blacha 10mm KT.pdf

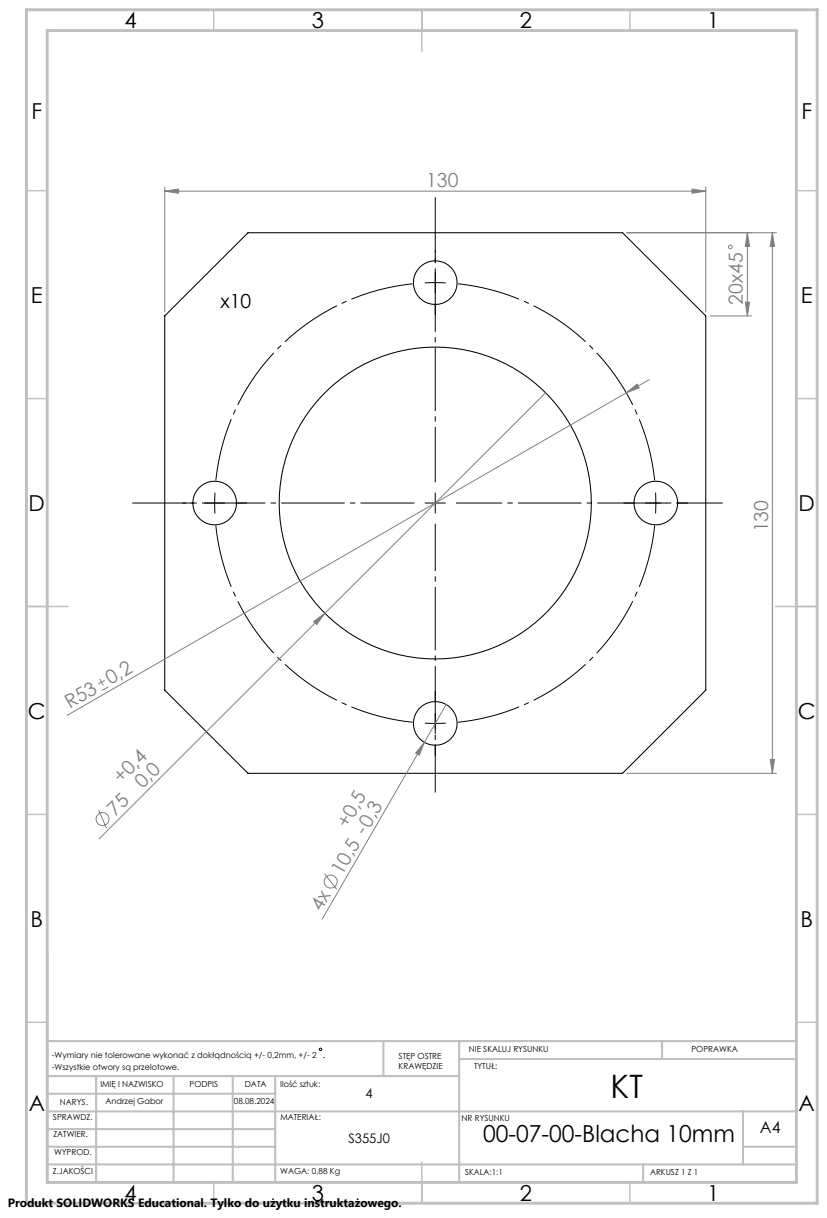
[picture p212: page 1]
NIE SKALUJ RYSUNKU; POPRAWKA; STĘP OSTRE

-Wymiary nie tolerowane wykonać z dokłądnością +/- 0,2mm, +/- 2 . -Wszystkie otwory są przelotowe.

IMIĘ I NAZWISKO | PODPIS | DATA | Ilość sztuk: 4
SPRAWDZ. | | | | MATERIAŁ: S355J0 | NR RYSUNKU 00-07-00-Blacha 10mm | A4
ZATWIER.
WYPROD.
Z.JAKOŚCI | | | | WAGA: 0,88 Kg | | SKALA:1:1 | ARKUSZ 1 Z 1

NARYS. | Andrzej Gabor | | 08.08.2024

Produkt SOLIDWORKS Educational. Tylko do użytku instruktażowego.
