Zykbyk/VACLAV/10. Zgredek/0. Podwozie-rama/Rysunki/00-07-00- Blacha 10mm WT.pdf

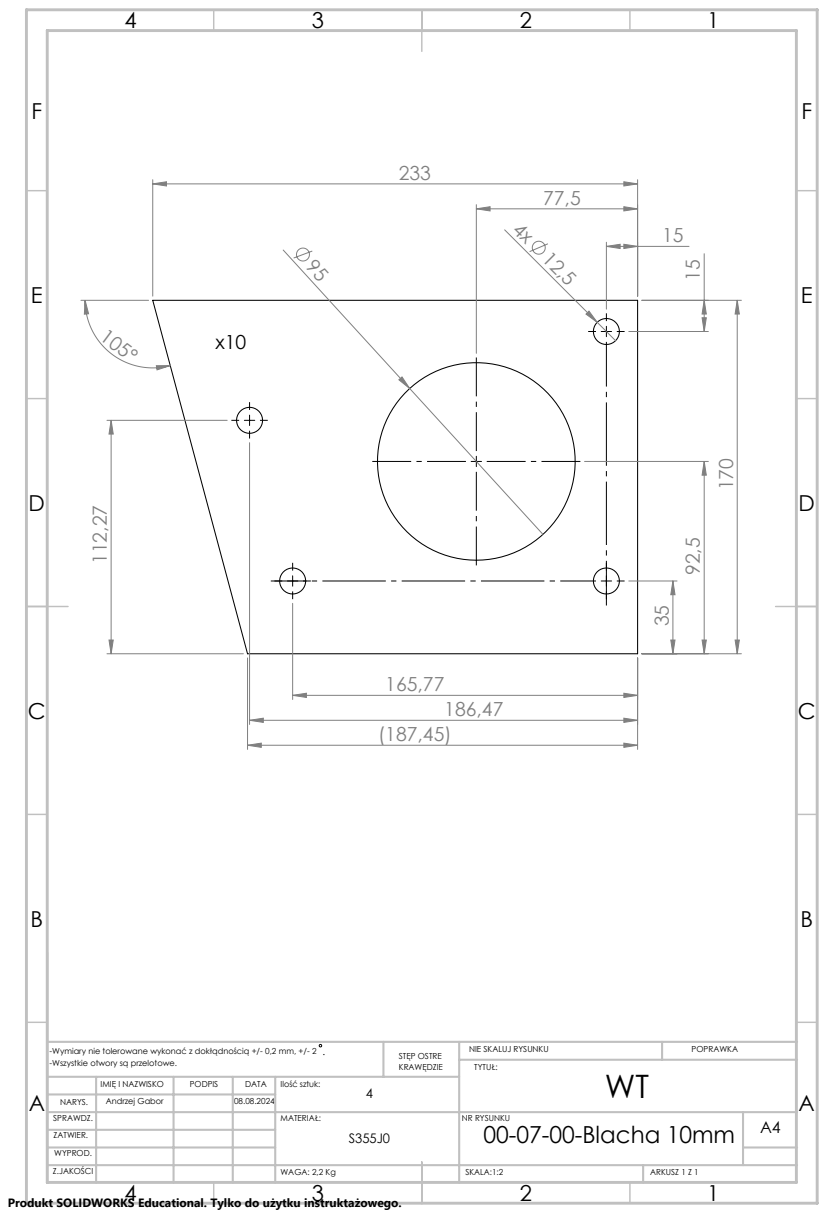
[picture p213: page 1]
STĘP OSTRE; NIE SKALUJ RYSUNKU; POPRAWKA

-Wymiary nie tolerowane wykonać z dokłądnością +/- 0,2 mm, +/- 2 . -Wszystkie otwory są przelotowe.

IMIĘ I NAZWISKO | PODPIS | DATA | Ilość sztuk: 4

NARYS. | Andrzej Gabor | | 08.08.2024
SPRAWDZ. | | | | MATERIAŁ: S355J0 | NR RYSUNKU 00-07-00-Blacha 10mm | A4
ZATWIER.
WYPROD.
Z.JAKOŚCI | | | | WAGA: 2,2 Kg | | SKALA:1:2 | ARKUSZ 1 Z 1

Produkt SOLIDWORKS Educational. Tylko do użytku instruktażowego.
