Zykbyk/VACLAV/0. Instrukcje i inne ważne pliki/Dokumentacja KLARA/Załączniki/Attachment_6.PDF

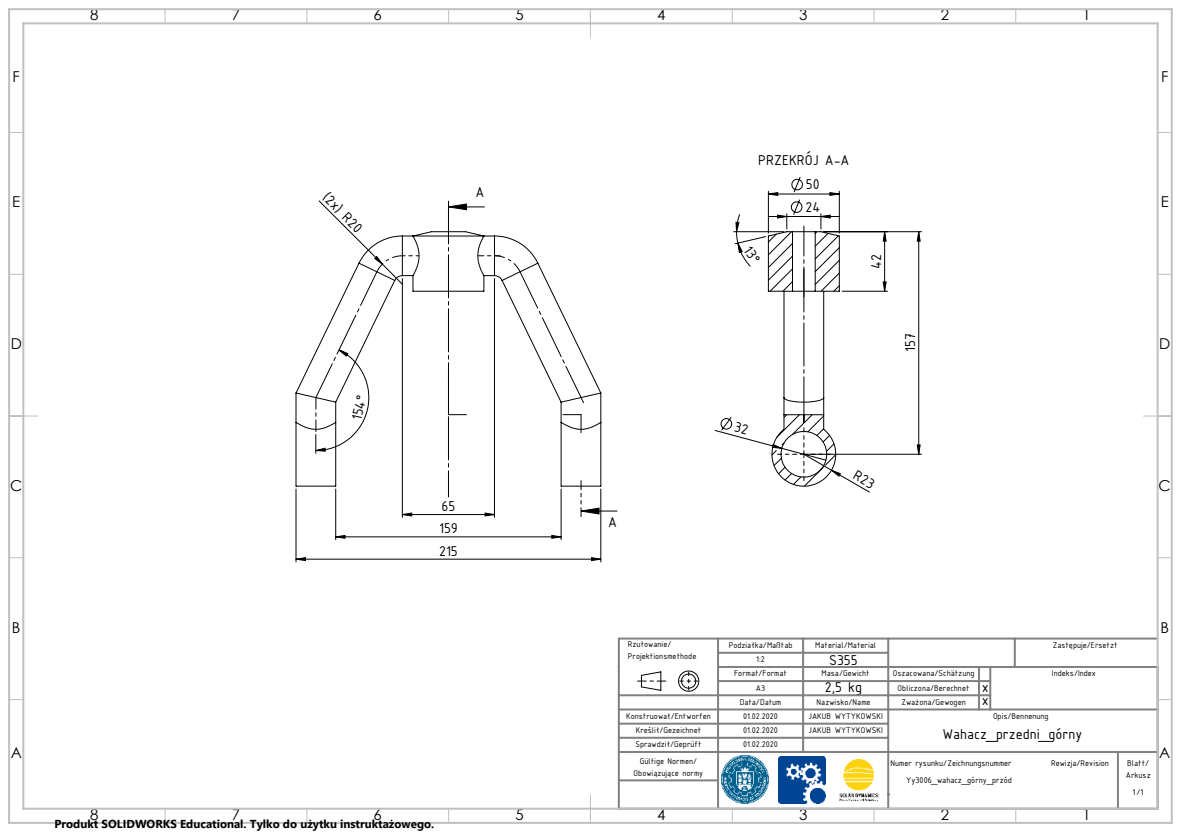
[picture p214: page 1]
PRZEKRÓJ A-A

Rzutowanie/ Projektionsmethode | Podziałka/Maßtab | Material/Material | | Zastępuje/Ersetzt

1:2 | S355
Format/Format | Masa/Gewicht | Oszacowana/Schätzung | | Indeks/Index
A3 | 2,5 kg | Obliczona/Berechnet | x
Data/Datum | Nazwisko/Name | Zważona/Gewogen | x

Konstruował/Entworfen | 01.02.2020 | JAKUB WYTYKOWSKI | Opis/Bennenung Wahacz_przedni_górny
Kreślił/Gezeichnet | 01.02.2020 | JAKUB WYTYKOWSKI
Sprawdził/Geprüft | 01.02.2020
Gültige Normen/ Obowiązujące normy | | Numer rysunku/Zeichnungsnummer Rewizja/Revision Yy3006_wahacz_górny_przód | Blatt/ Arkusz 1 /1

Produkt SOLIDWORKS Educational. Tylko do użytku instruktażowego.
