Zykbyk/VACLAV/0. Instrukcje i inne ważne pliki/Dokumentacja KLARA/Załączniki/Attachment_7.PDF

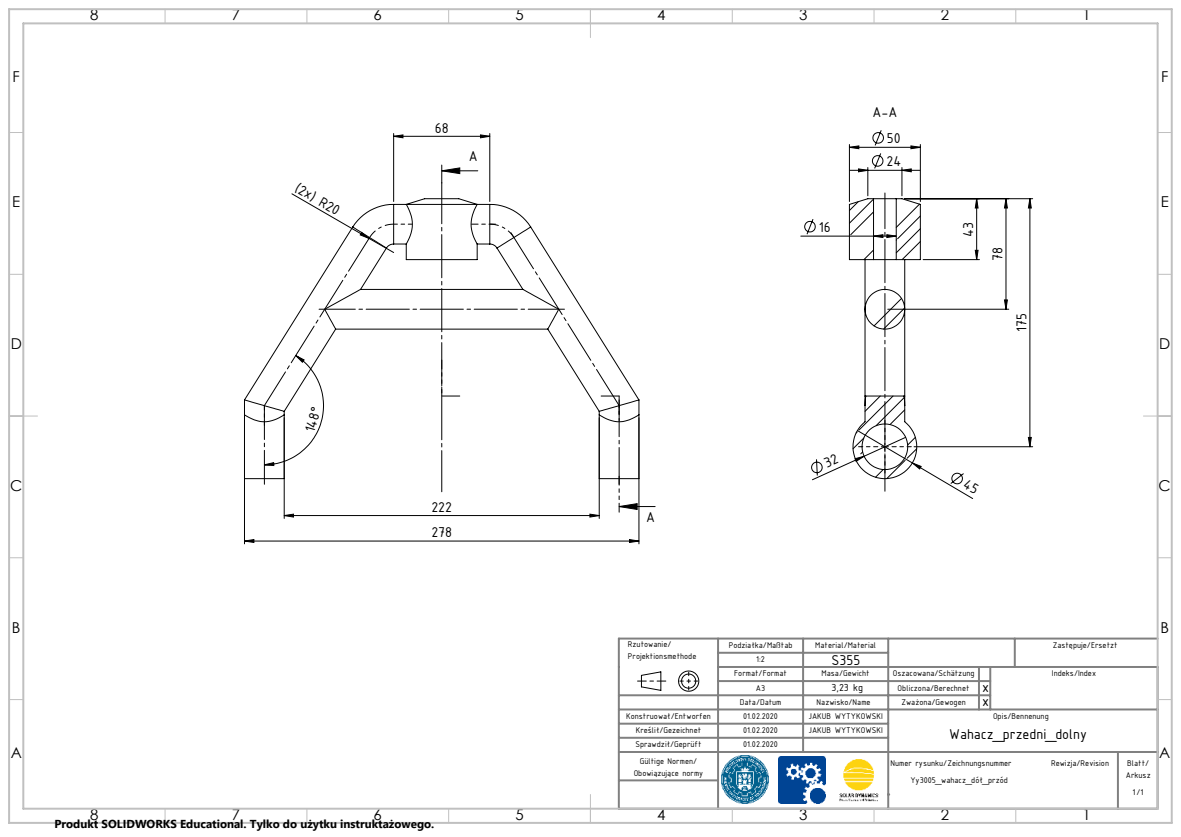
[picture p215: page 1]

Rzutowanie/ Projektionsmethode | Podziałka/Maßtab | Material/Material | | Zastępuje/Ersetzt

1:2 | S355
Format/Format | Masa/Gewicht | Oszacowana/Schätzung | | Indeks/Index
A3 | 3,23 kg | Obliczona/Berechnet | x
Data/Datum | Nazwisko/Name | Zważona/Gewogen | x

Konstruował/Entworfen | 01.02.2020 | JAKUB WYTYKOWSKI | Opis/Bennenung Wahacz_przedni_dolny
Kreślił/Gezeichnet | 01.02.2020 | JAKUB WYTYKOWSKI
Sprawdził/Geprüft | 01.02.2020
Gültige Normen/ Obowiązujące normy | | Numer rysunku/Zeichnungsnummer Rewizja/Revision Yy3005_wahacz_dół_przód | Blatt/ Arkusz 1 /1

Produkt SOLIDWORKS Educational. Tylko do użytku instruktażowego.
