Zykbyk/VACLAV/0. Instrukcje i inne ważne pliki/Dokumentacja KLARA/Załączniki/Attachment_8.PDF

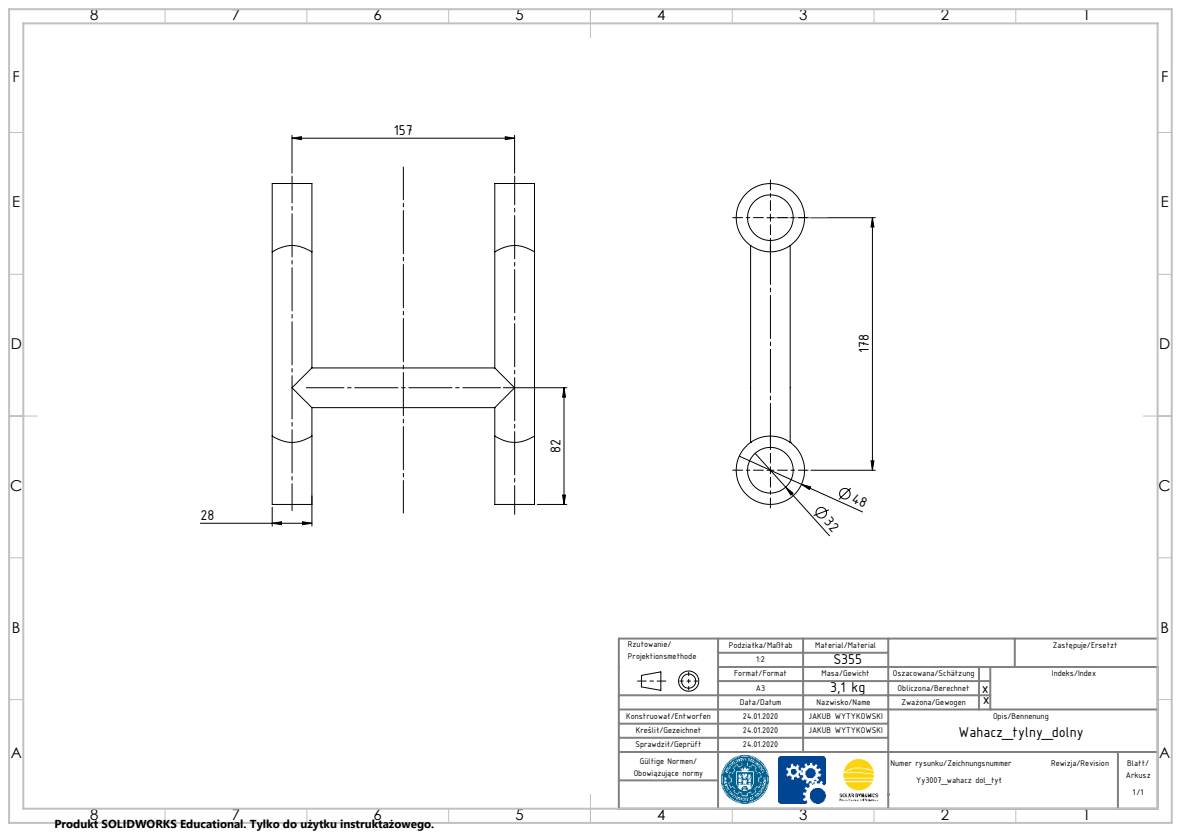
[picture p216: page 1]

Rzutowanie/ Projektionsmethode | Podziałka/Maßtab | Material/Material | | Zastępuje/Ersetzt

1:2 | S355
Format/Format | Masa/Gewicht | Oszacowana/Schätzung | | Indeks/Index
A3 | 3,1 kg | Obliczona/Berechnet | x
Data/Datum | Nazwisko/Name | Zważona/Gewogen | x

Konstruował/Entworfen | 24.01.2020 | JAKUB WYTYKOWSKI | Opis/Bennenung Wahacz_tylny_dolny
Kreślił/Gezeichnet | 24.01.2020 | JAKUB WYTYKOWSKI
Sprawdził/Geprüft | 24.01.2020
Gültige Normen/ Obowiązujące normy | | Numer rysunku/Zeichnungsnummer Rewizja/Revision Yy3007_wahacz dol_tył | Blatt/ Arkusz 1 /1

Produkt SOLIDWORKS Educational. Tylko do użytku instruktażowego.
