Zykbyk/VACLAV/0. Instrukcje i inne ważne pliki/Dokumentacja KLARA/Załączniki/Attachment_9.PDF

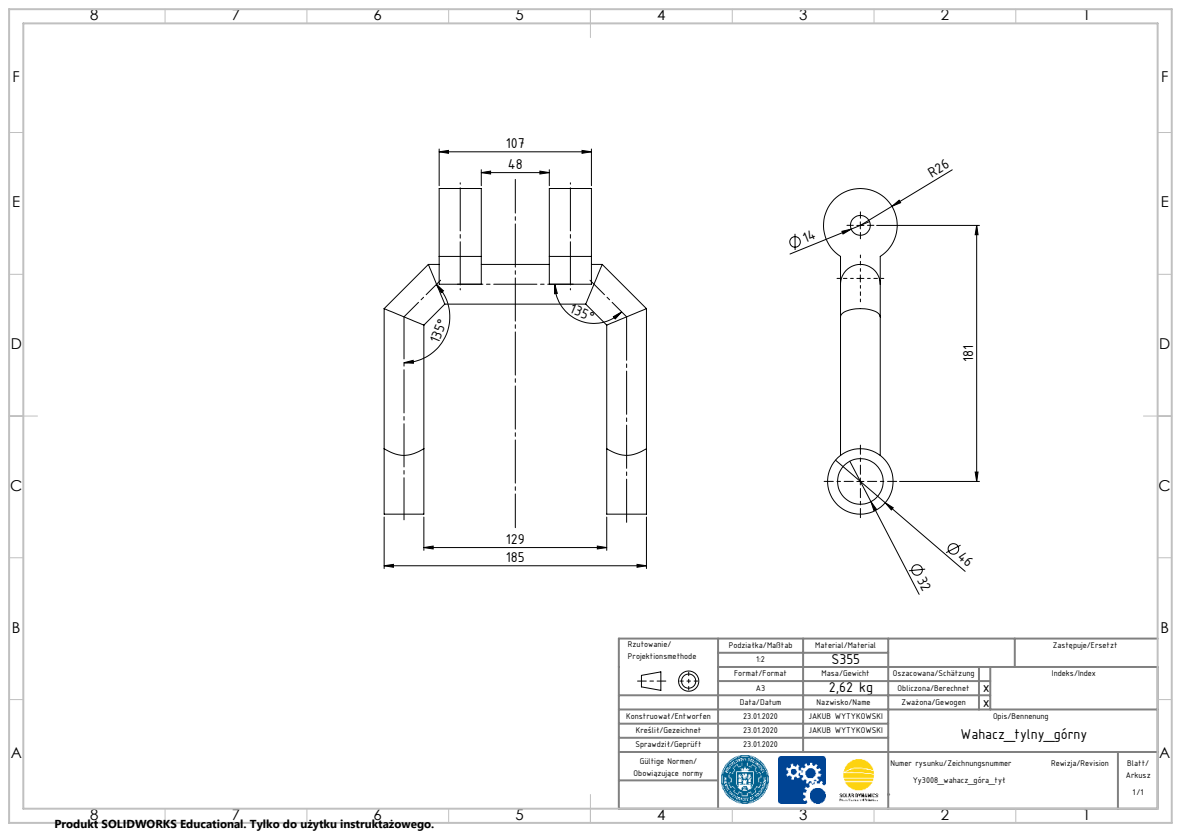
[picture p217: page 1]

Rzutowanie/ Projektionsmethode | Podziałka/Maßtab | Material/Material | | Zastępuje/Ersetzt

1:2 | S355
Format/Format | Masa/Gewicht | Oszacowana/Schätzung | | Indeks/Index
A3 | 2,62 kg | Obliczona/Berechnet | x
Data/Datum | Nazwisko/Name | Zważona/Gewogen | x

Konstruował/Entworfen | 23.01.2020 | JAKUB WYTYKOWSKI | Opis/Bennenung Wahacz_tylny_górny
Kreślił/Gezeichnet | 23.01.2020 | JAKUB WYTYKOWSKI
Sprawdził/Geprüft | 23.01.2020
Gültige Normen/ Obowiązujące normy | | Numer rysunku/Zeichnungsnummer Rewizja/Revision Yy3008_wahacz_góra_tył | Blatt/ Arkusz 1 /1

Produkt SOLIDWORKS Educational. Tylko do użytku instruktażowego.
