Zykbyk/VACLAV/0. Instrukcje i inne ważne pliki/Dokumentacja KLARA/Załączniki/Technical drawing of the motor.pdf

## enkoder

A-A

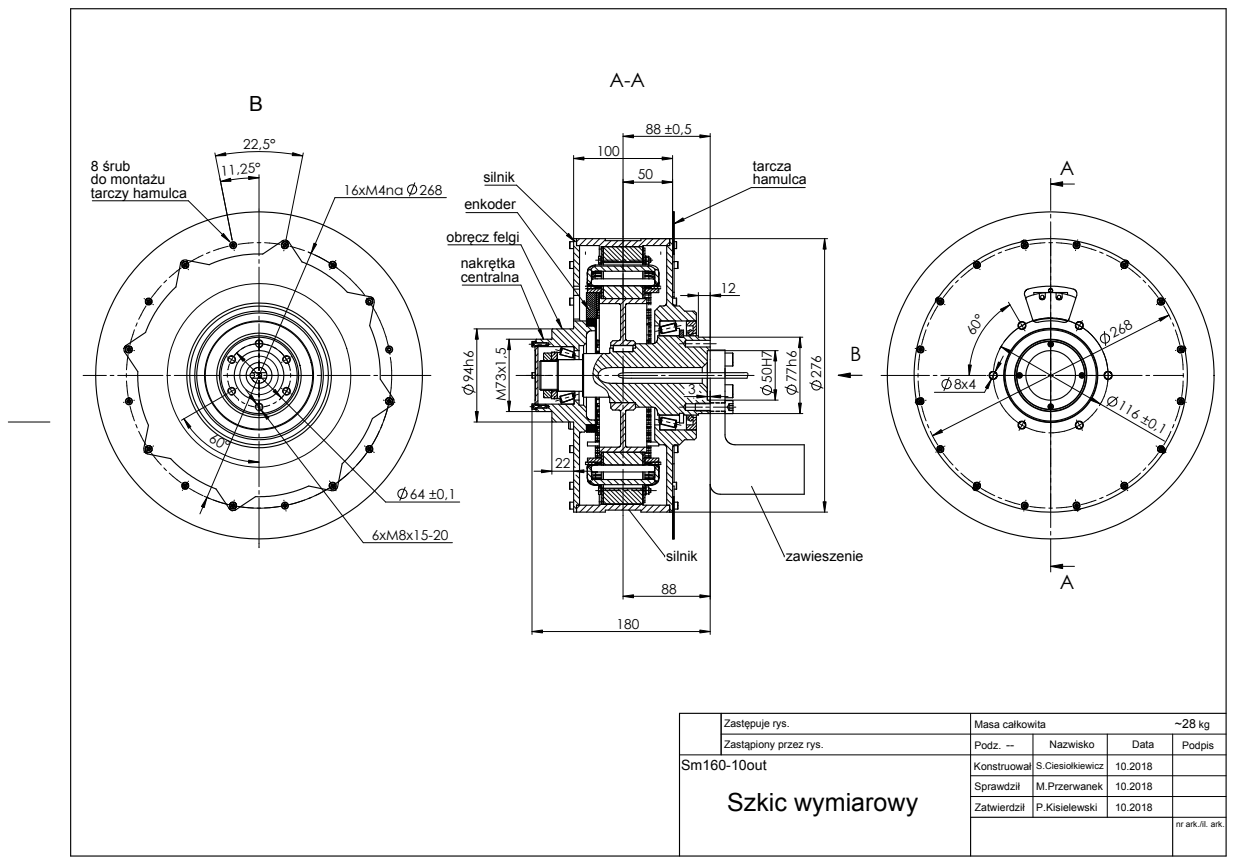
[picture p218: page 1]
obręcz felgi; silnik; centralna; hamulca; zawieszenie; nakrętka; tarcza; 8 śrub do montażu tarczy hamulca

Zastępuje rys. | ~28 kg Masa całkowita

-- | S.Ciesiołkiewicz M.Przerwanek P.Kisielewski Nazwisko | 10.2018 Konstruował Sprawdził Zatwierdził Podz. 10.2018 Szkic wymiarowy Data | nr ark./il. ark. Sm160-10out Podpis

Zastąpiony przez rys.
