Zykbyk/VACLAV/10. Zgredek/0. Podwozie-rama/Rysunki/00-00-01 (rama podwozia v2) POGLĄDOWA ZŁOŻENIÓWKA.pdf

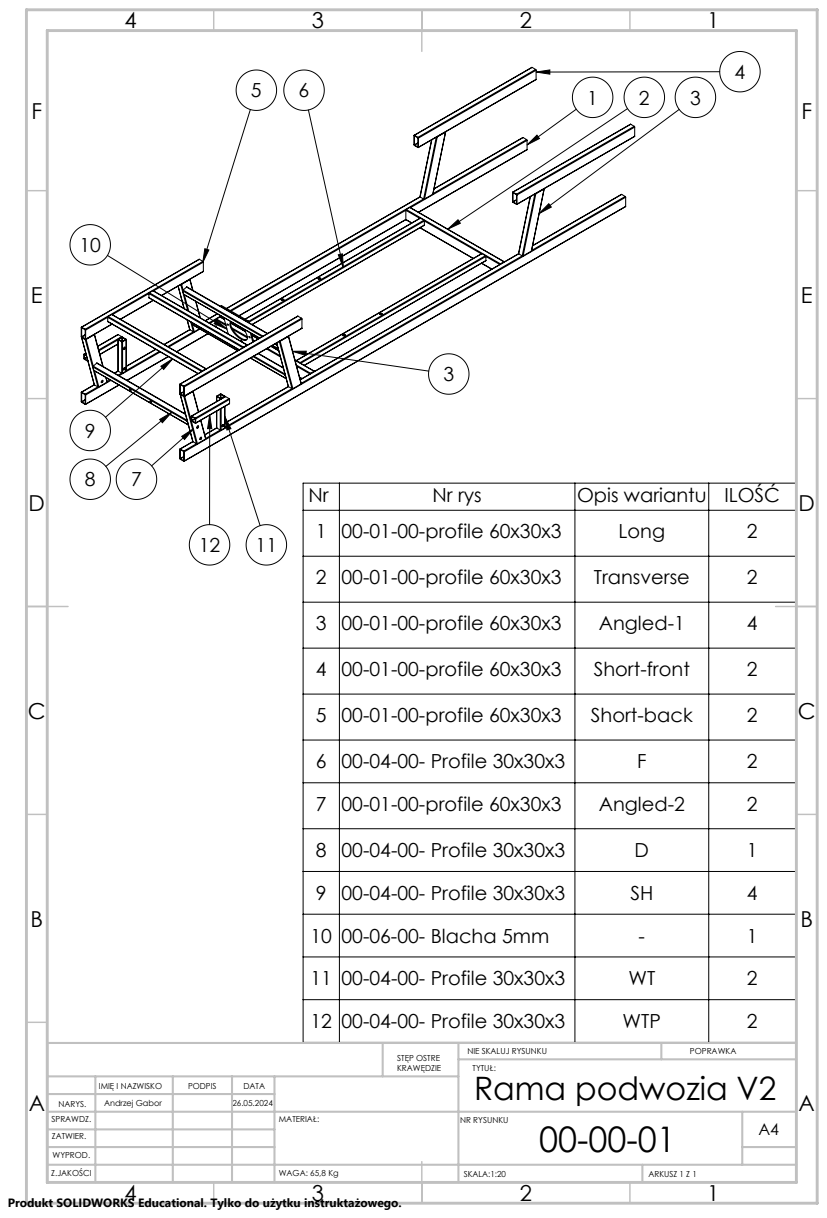
[picture p219: page 1]
Rama podwozia V2

Nr | Nr rys | Opis wariantu | ILOŚĆ
1 | 00-01-00-profile 60x30x3 | Long | 2
2 | 00-01-00-profile 60x30x3 | Transverse | 2
3 | 00-01-00-profile 60x30x3 | Angled-1 | 4
4 | 00-01-00-profile 60x30x3 | Short-front | 2
5 | 00-01-00-profile 60x30x3 | Short-back | 2
6 | 00-04-00- Profile 30x30x3 | F | 2
7 | 00-01-00-profile 60x30x3 | Angled-2 | 2
8 | 00-04-00- Profile 30x30x3 | D | 1
9 | 00-04-00- Profile 30x30x3 | SH | 4
10 | 00-06-00- Blacha 5mm | - | 1
11 | 00-04-00- Profile 30x30x3 | WT | 2
12 | 00-04-00- Profile 30x30x3 | WTP | 2

STĘP OSTRE KRAWĘDZIE | NIE SKALUJ RYSUNKU | POPRAWKA

IMIĘ I NAZWISKO | PODPIS | DATA

NARYS. | Andrzej Gabor | | 26.05.2024
SPRAWDZ. | | | | MATERIAŁ: | NR RYSUNKU 00-00-01 | A4
ZATWIER.
WYPROD.
Z.JAKOŚCI | | | | WAGA: 65,8 Kg | | SKALA:1:20 | ARKUSZ 1 Z 1

Produkt SOLIDWORKS Educational. Tylko do użytku instruktażowego.
