Zykbyk/VACLAV/10. Zgredek/0. Podwozie-rama/Rysunki/00-00-01 (rama podwozia v2) wymiary do spawania.pdf

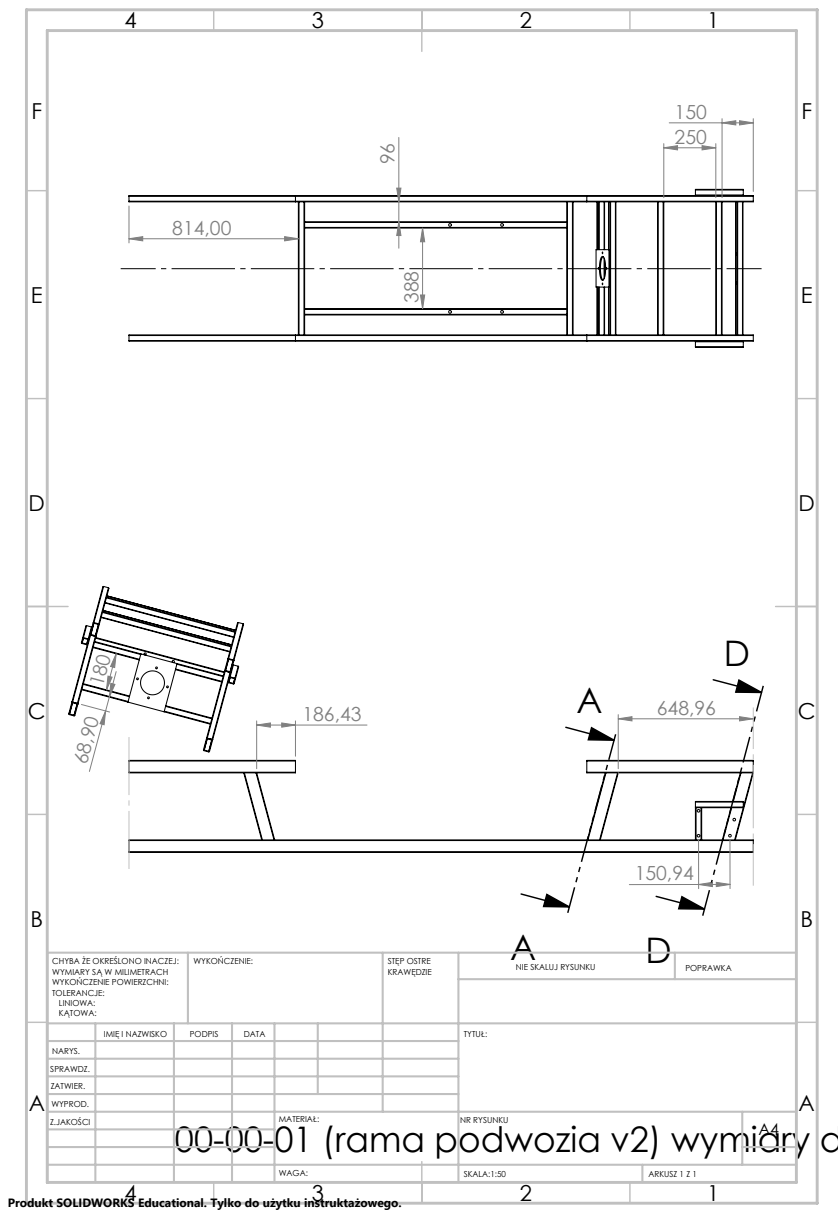
[picture p220: page 1]
WYKOŃCZENIE:; STĘP OSTRE; NIE SKALUJ RYSUNKU; POPRAWKA; SKALA:1:50; ARKUSZ 1 Z 1

CHYBA ŻE OKREŚLONO INACZEJ:
WYMIARY SĄ W MILIMETRACH
WYKOŃCZENIE POWIERZCHNI:
TOLERANCJE:
LINIOWA:
KĄTOWA:

IMIĘ I NAZWISKO | PODPIS | DATA | | | | TYTUŁ:

NARYS.
SPRAWDZ.
ZATWIER.
WYPROD.
Z.JAKOŚCI | | | | MATERIAŁ: | NR RYSUNKU | A4

00-00-01 (rama podwozia v2) wymiary do spawania

Produkt SOLIDWORKS Educational. Tylko do użytku instruktażowego.
