Zykbyk/VACLAV/10. Zgredek/0. Podwozie-rama/Rysunki/00-01-00-profile 60x30x3 Angled-1.pdf

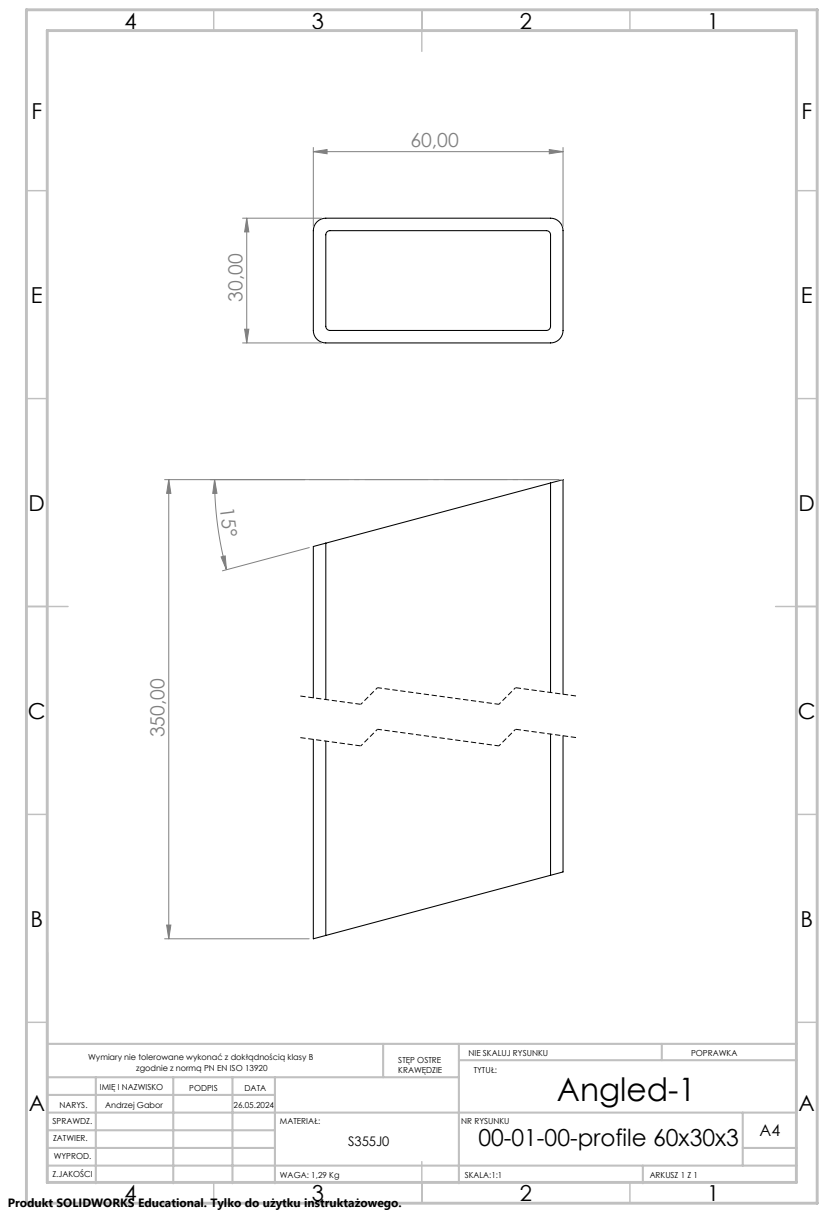
[picture p221: page 1]
STĘP OSTRE; NIE SKALUJ RYSUNKU; POPRAWKA

Wymiary nie tolerowane wykonać z dokłądnością klasy B

zgodnie z normą PN EN ISO 13920

IMIĘ I NAZWISKO | PODPIS | DATA

NARYS. | Andrzej Gabor | | 26.05.2024
SPRAWDZ. | | | | MATERIAŁ: S355J0 | NR RYSUNKU 00-01-00-profile 60x30x3 | A4
ZATWIER.
WYPROD.
Z.JAKOŚCI | | | | WAGA: 1,29 Kg | | SKALA:1:1 | ARKUSZ 1 Z 1

Produkt SOLIDWORKS Educational. Tylko do użytku instruktażowego.
