Zykbyk/VACLAV/10. Zgredek/0. Podwozie-rama/Rysunki/00-01-00-profile 60x30x3 long.pdf

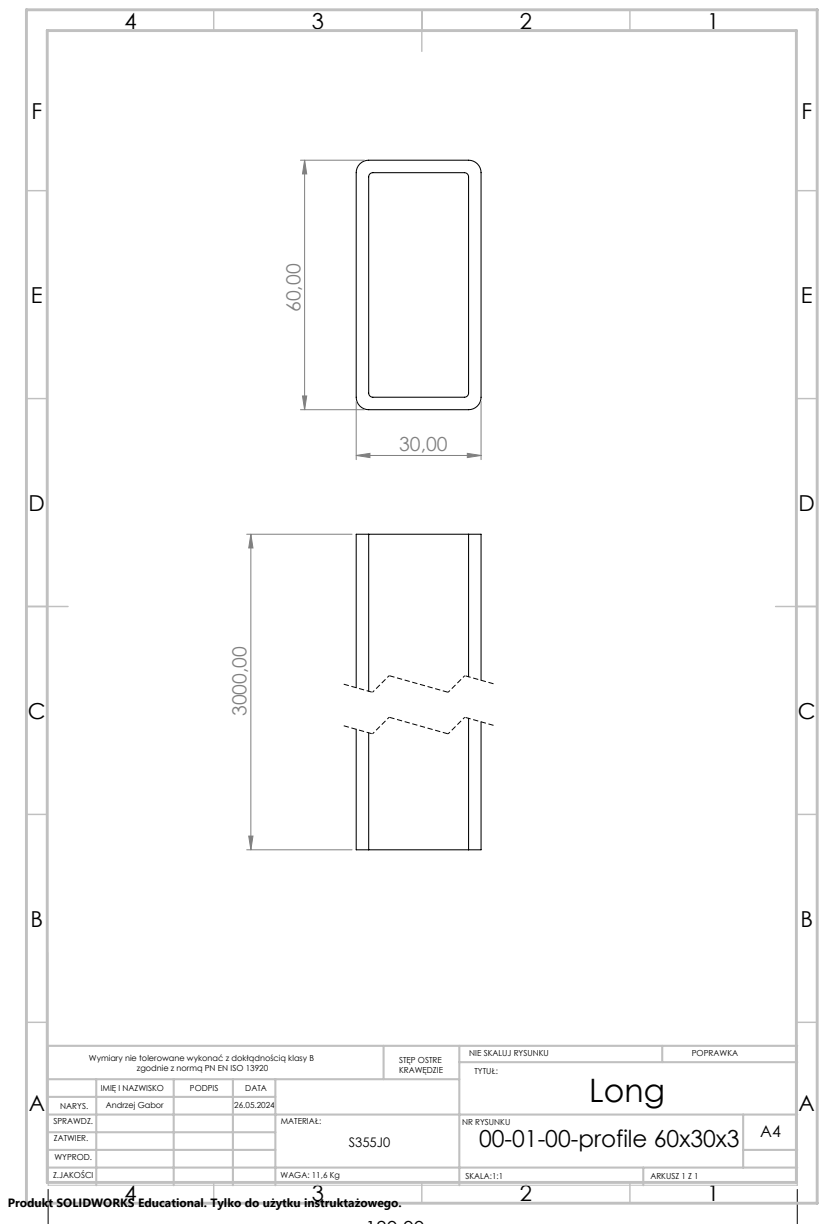
[picture p222: page 1]
NIE SKALUJ RYSUNKU; POPRAWKA; STĘP OSTRE

Wymiary nie tolerowane wykonać z dokłądnością klasy B

zgodnie z normą PN EN ISO 13920

IMIĘ I NAZWISKO | PODPIS | DATA
SPRAWDZ. | | | | MATERIAŁ: S355J0 | NR RYSUNKU 00-01-00-profile 60x30x3 | A4
ZATWIER.
WYPROD.
Z.JAKOŚCI | | | | WAGA: 11,6 Kg | SKALA:1:1 | ARKUSZ 1 Z 1

NARYS. | Andrzej Gabor | | 26.05.2024

Produkt SOLIDWORKS Educational. Tylko do użytku instruktażowego.
