Zykbyk/VACLAV/10. Zgredek/0. Podwozie-rama/Rysunki/00-04-00- Profile 30x30x3 D.pdf

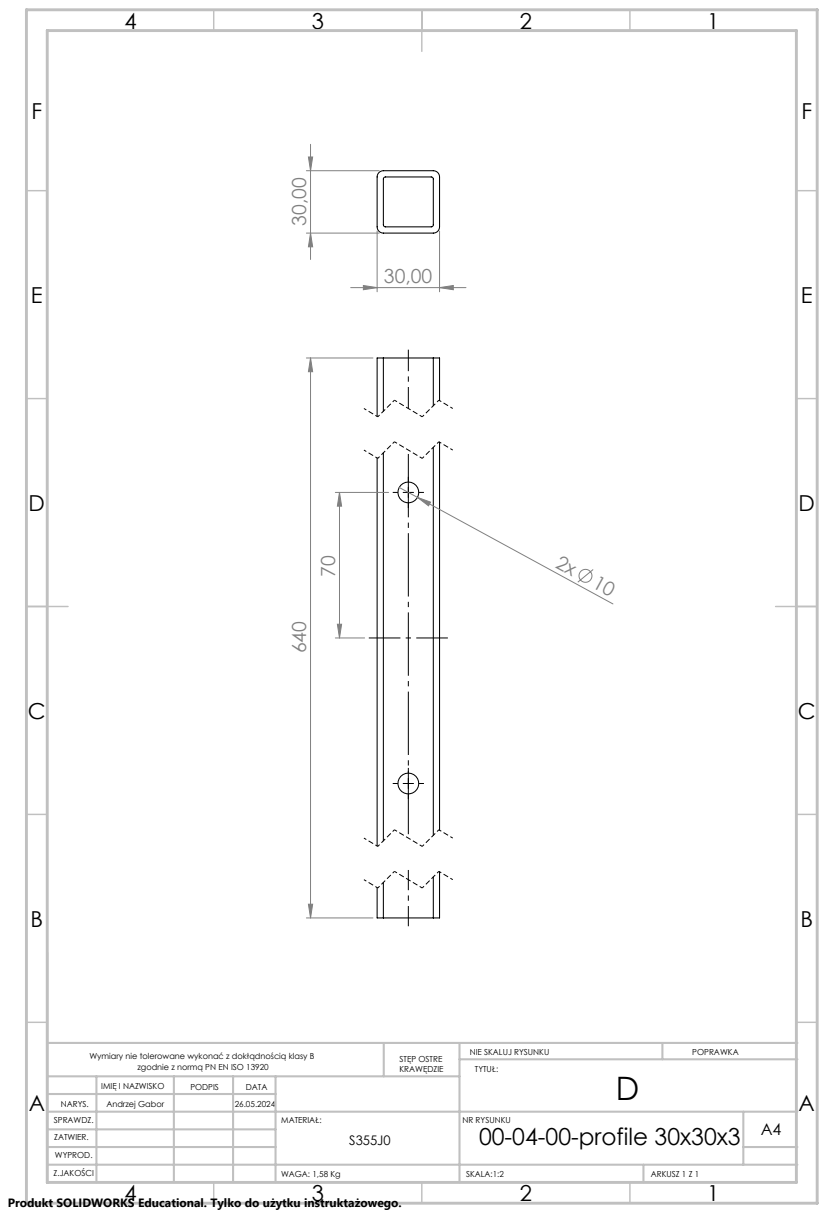
[picture p223: page 1]
NIE SKALUJ RYSUNKU; POPRAWKA; STĘP OSTRE

Wymiary nie tolerowane wykonać z dokłądnością klasy B

zgodnie z normą PN EN ISO 13920

IMIĘ I NAZWISKO | PODPIS | DATA
SPRAWDZ. | | | | MATERIAŁ: S355J0 | NR RYSUNKU 00-04-00-profile 30x30x3 | A4
ZATWIER.
WYPROD.
Z.JAKOŚCI | | | | WAGA: 1,58 Kg | SKALA:1:2 | ARKUSZ 1 Z 1

NARYS. | Andrzej Gabor | | 26.05.2024

Produkt SOLIDWORKS Educational. Tylko do użytku instruktażowego.
