Zykbyk/VACLAV/0. Instrukcje i inne ważne pliki/Dokumentacja KLARA/Załączniki/Attachment_1.PDF

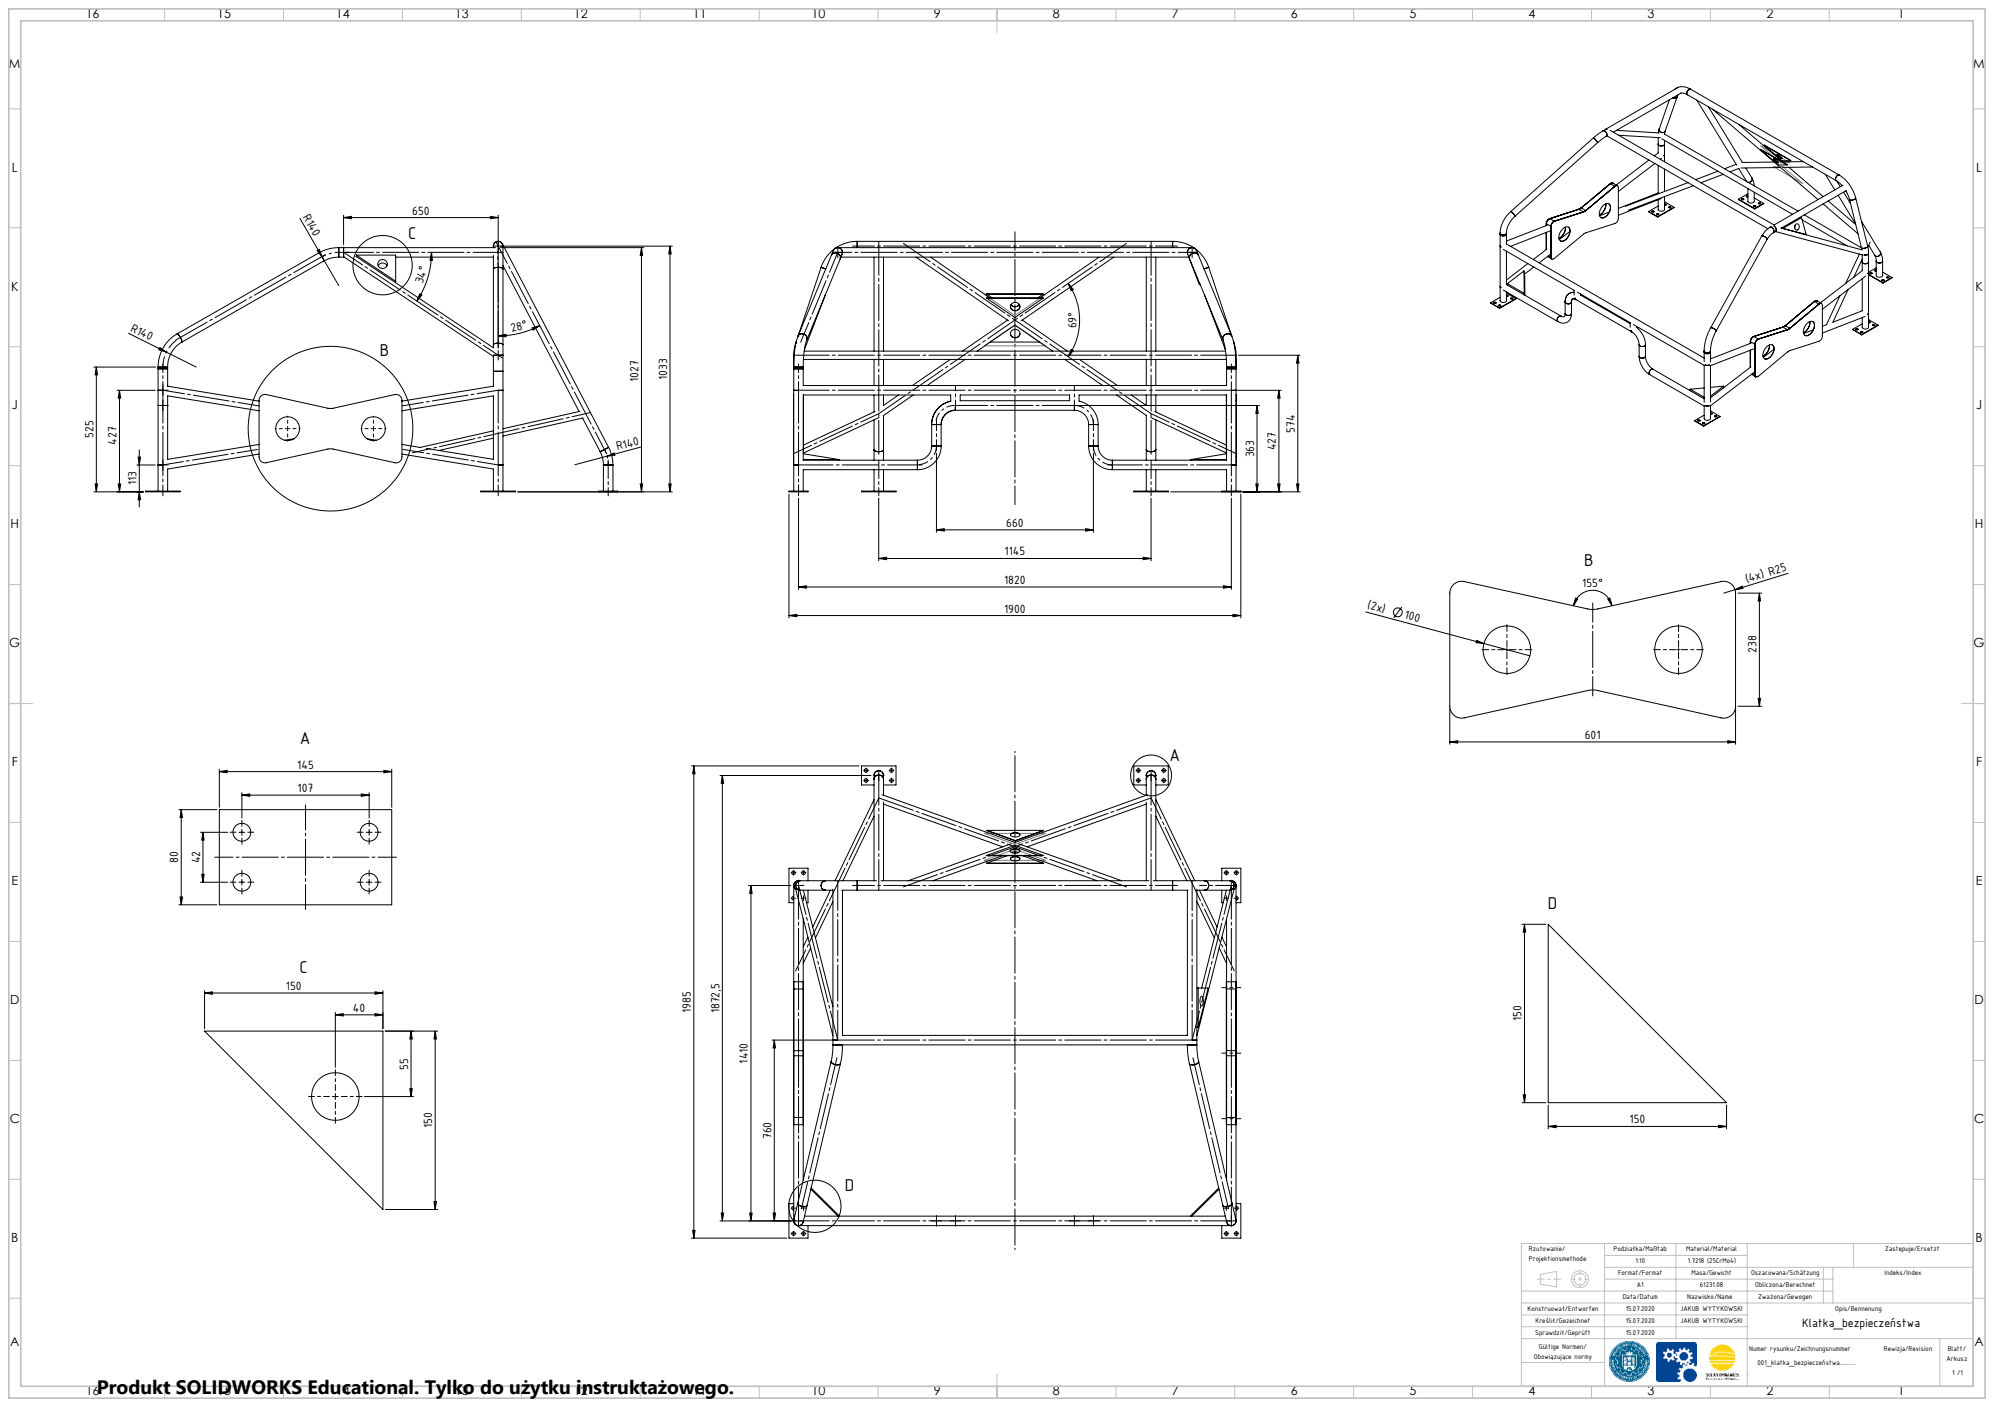
[picture p224: page 1]
1.7218 (25CrMo4); JAKUB WYTYKOWSKI; Numer rysunku/Zeichnungsnummer; Rewizja/Revision; Gültige Normen/ Obowiązujące normy

Produkt SOLIDWORKS Educational. Tylko do użytku instruktażowego.
