Zykbyk/VACLAV/0. Instrukcje i inne ważne pliki/Dokumentacja KLARA/Załączniki/Attachment_2.PDF

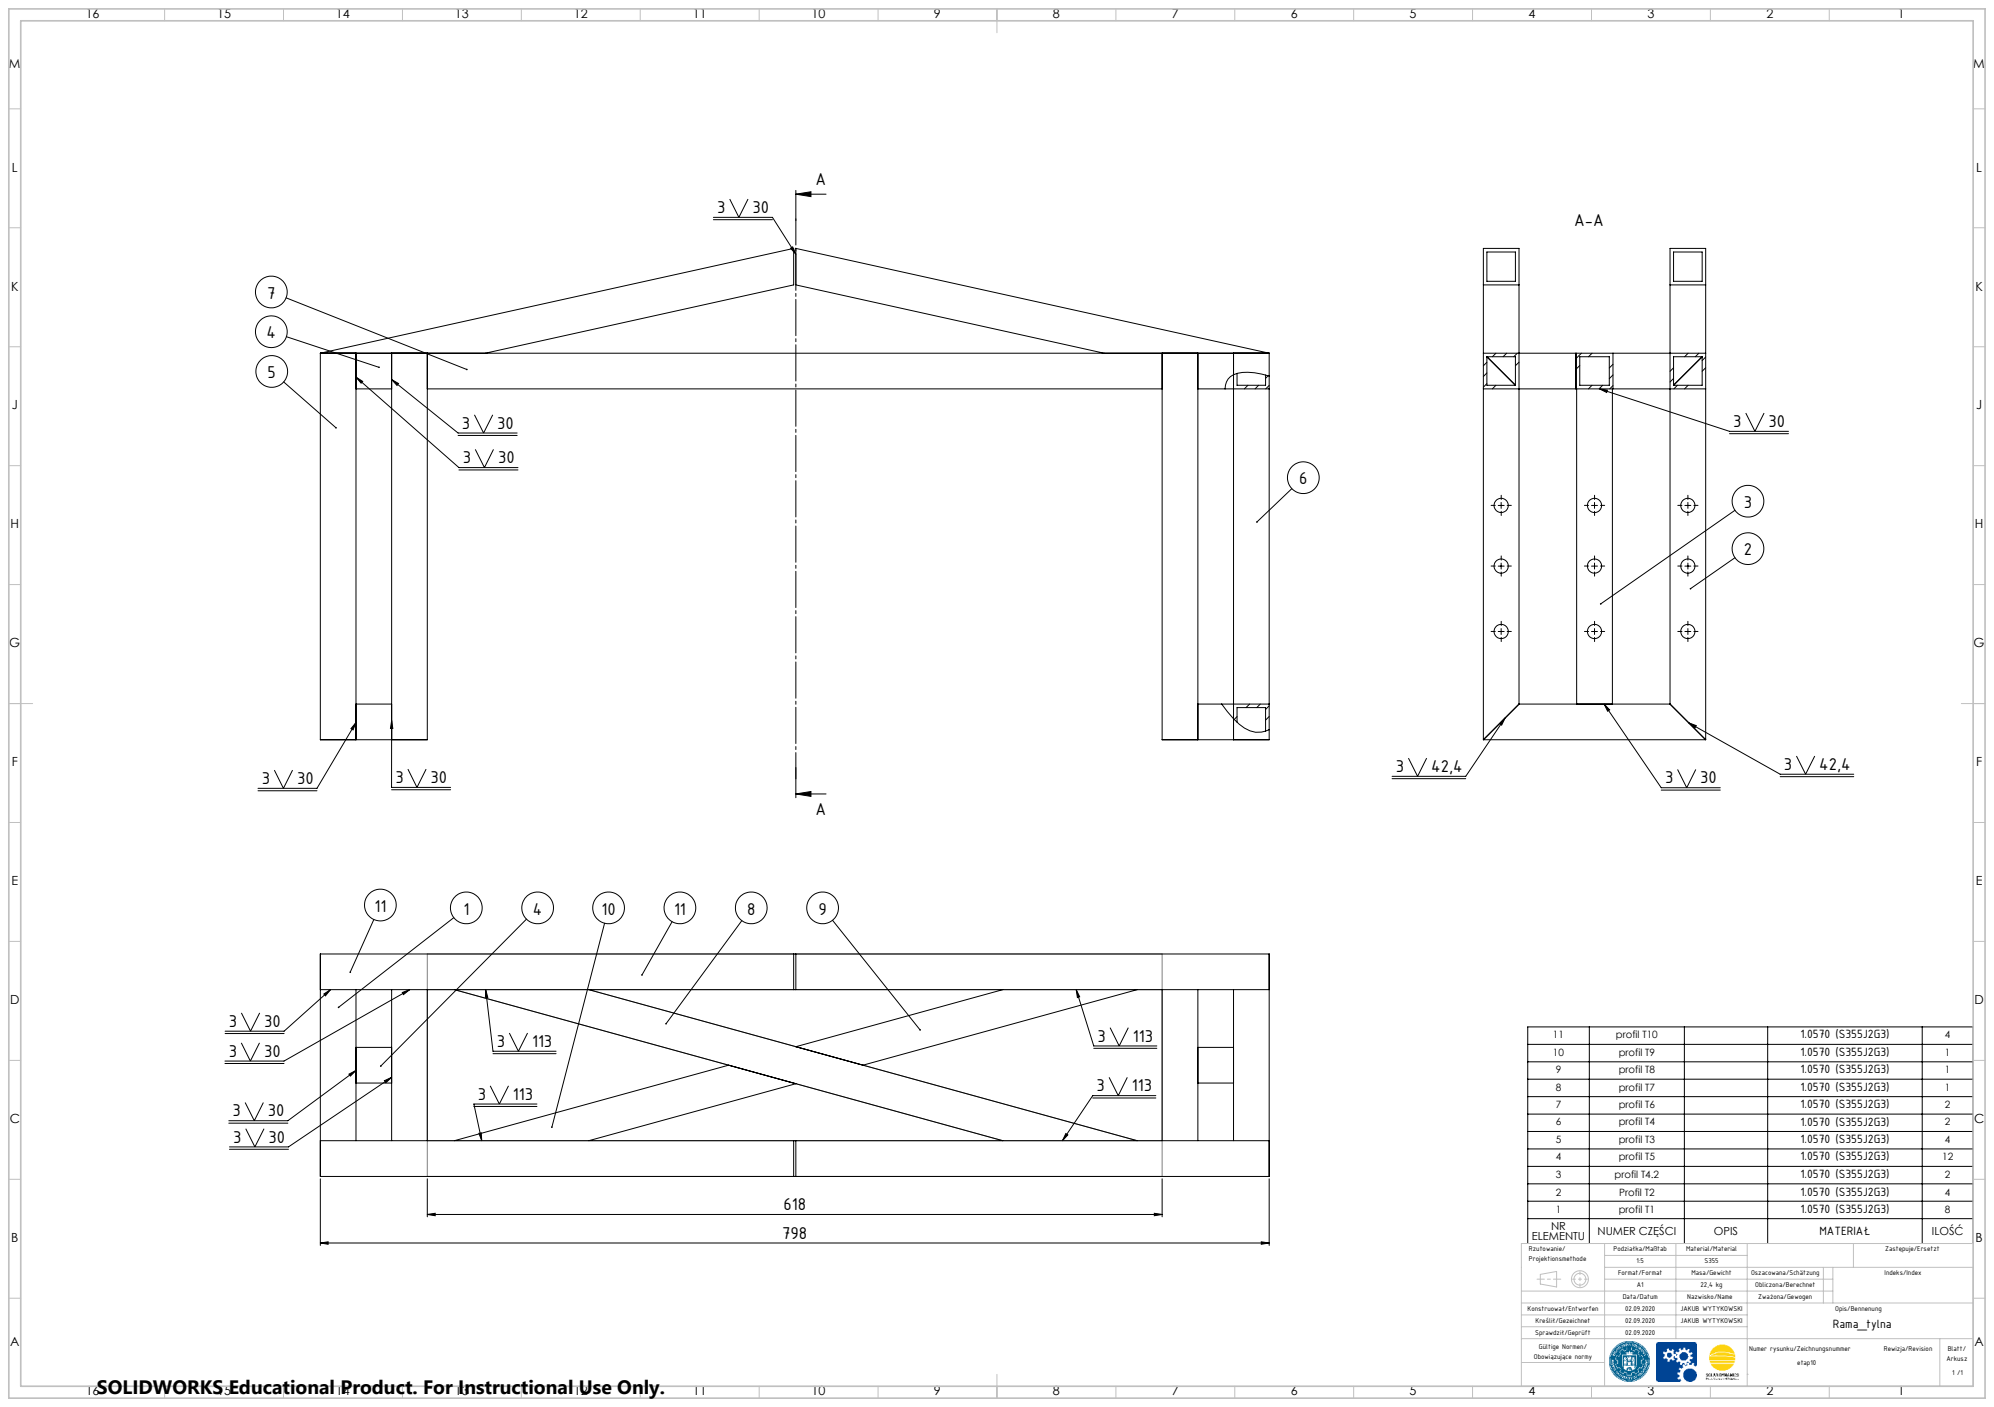
[picture p225: page 1]
profil T8; JAKUB WYTYKOWSKI; Numer rysunku/Zeichnungsnummer; Rewizja/Revision; Gültige Normen/ Obowiązujące normy

11 | profil T10 | 1.0570 (S355J2G3) | 4
10 | profil T9 | 1.0570 (S355J2G3) | 1

8 | profil T7 | | 1.0570 (S355J2G3) | 1
7 | profil T6 | | 1.0570 (S355J2G3) | 2
6 | profil T4 | | 1.0570 (S355J2G3) | 2
5 | profil T3 | | 1.0570 (S355J2G3) | 4
4 | profil T5 | | 1.0570 (S355J2G3) | 12
3 | profil T4.2 | | 1.0570 (S355J2G3) | 2
2 | Profil T2 | | 1.0570 (S355J2G3) | 4
1 | profil T1 | | 1.0570 (S355J2G3) | 8
NR ELEMENTU | NUMER CZĘŚCI | OPIS | MATERIAŁ | ILOŚĆ

SOLIDWORKS Educational Product. For Instructional Use Only.
