Zykbyk/VACLAV/0. Instrukcje i inne ważne pliki/Dokumentacja KLARA/Załączniki/Attachment_3.PDF

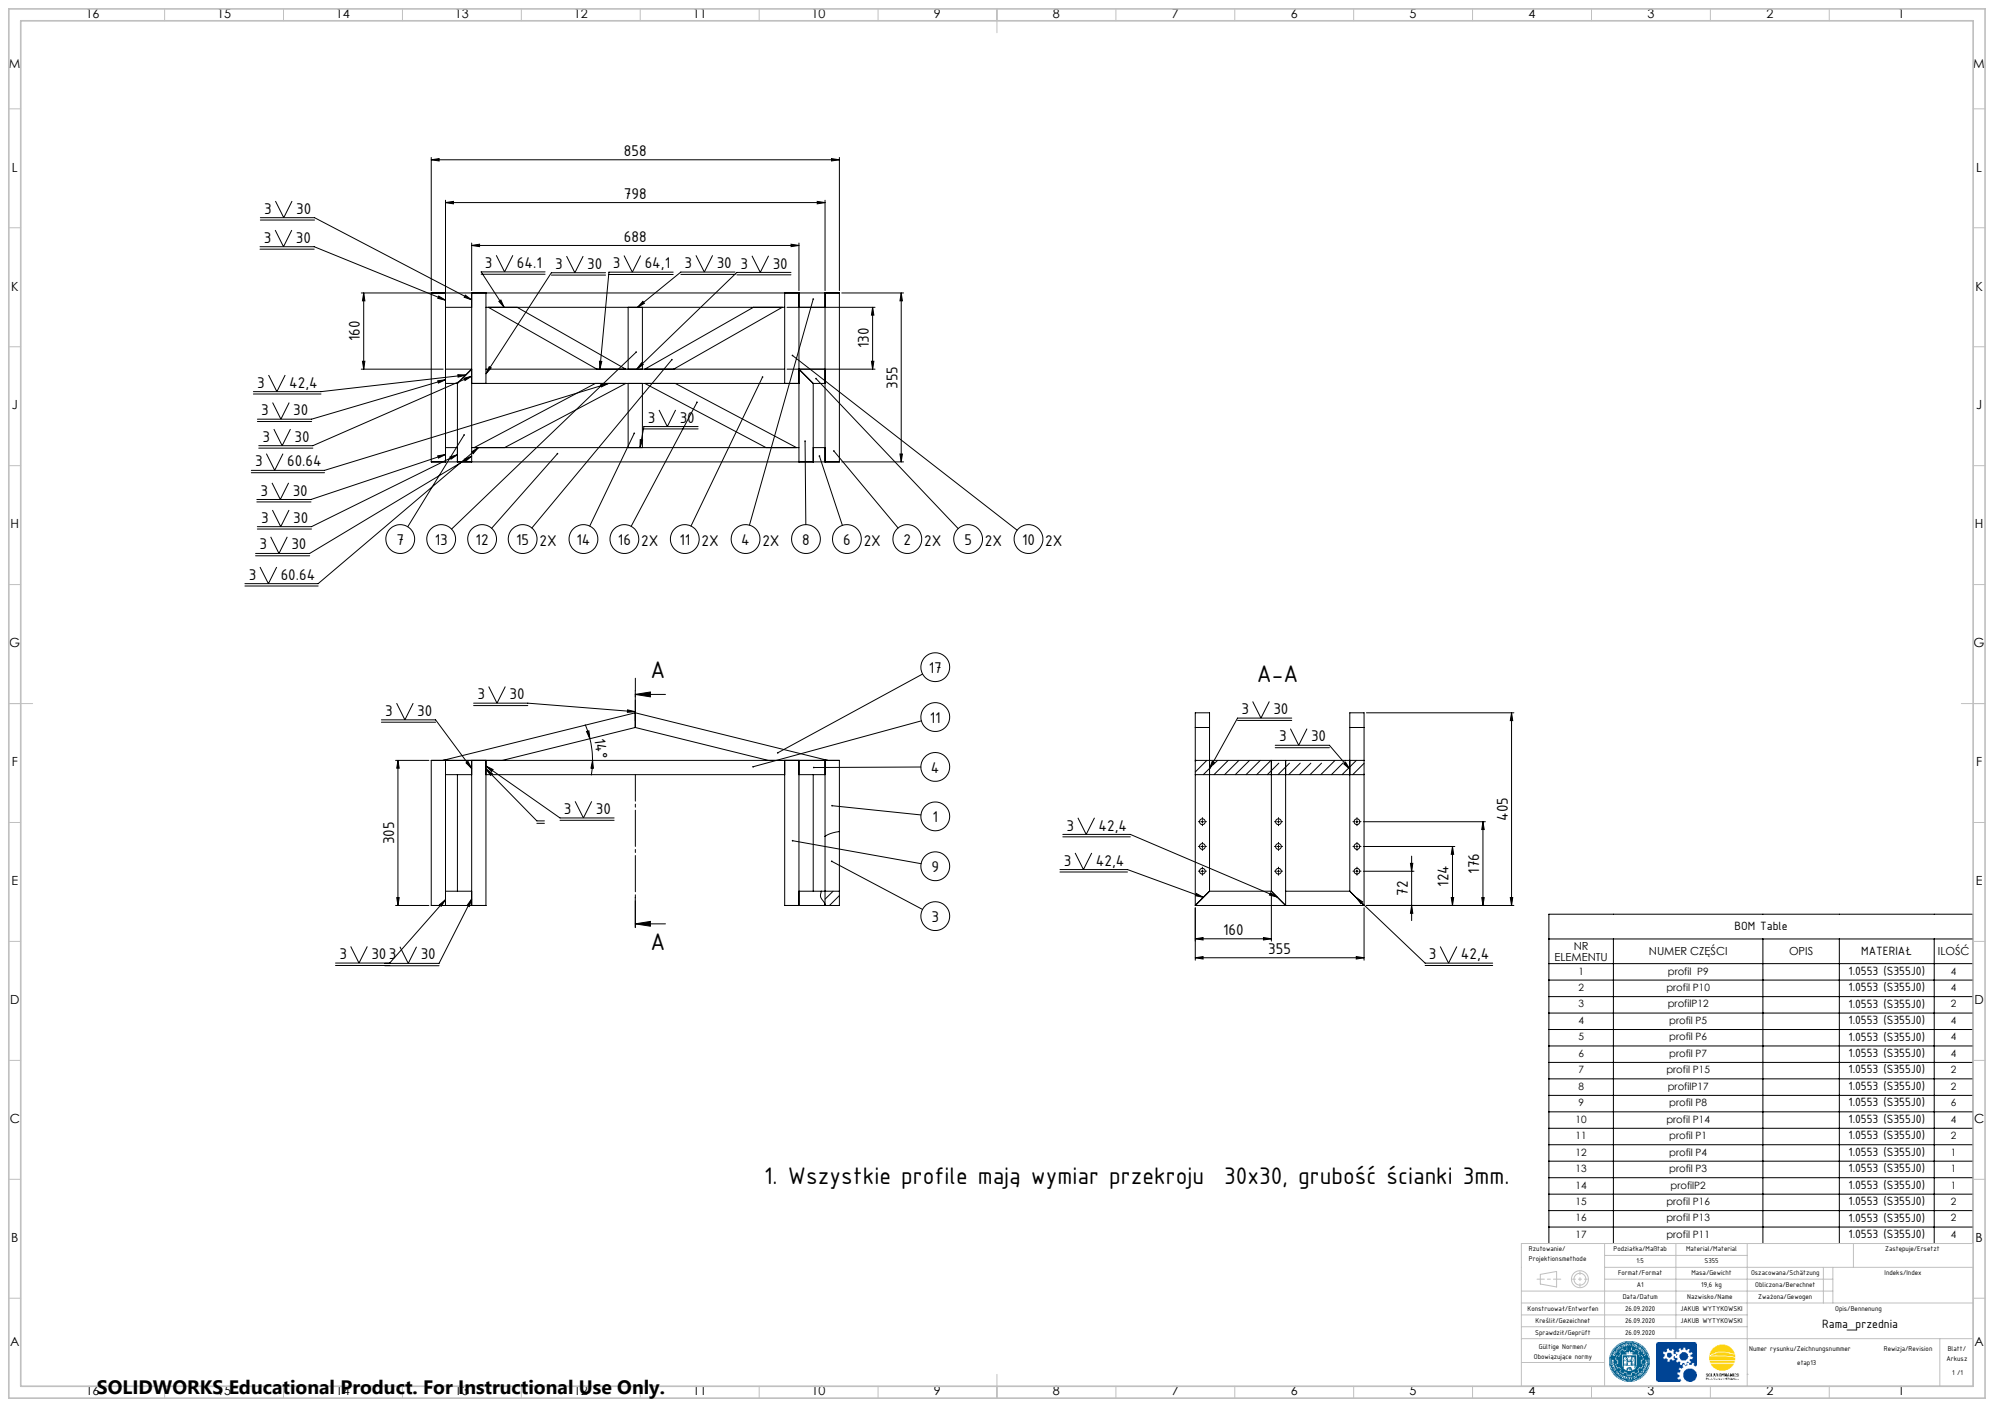
[picture p226: page 1]

NR ELEMENTU | NUMER CZĘŚCI | OPIS | MATERIAŁ | ILOŚĆ
1 | profil P9 | | 1.0553 (S355J0) | 4
2 | profil P10 | | 1.0553 (S355J0) | 4
3 | profilP12 | | 1.0553 (S355J0) | 2
4 | profil P5 | | 1.0553 (S355J0) | 4
5 | profil P6 | | 1.0553 (S355J0) | 4
6 | profil P7 | | 1.0553 (S355J0) | 4
7 | profil P15 | | 1.0553 (S355J0) | 2
8 | profilP17 | | 1.0553 (S355J0) | 2
9 | profil P8 | | 1.0553 (S355J0) | 6
10 | profil P14 | | 1.0553 (S355J0) | 4
11 | profil P1 | | 1.0553 (S355J0) | 2
12 | profil P4 | | 1.0553 (S355J0) | 1
13 | profil P3 | | 1.0553 (S355J0) | 1
14 | profilP2 | | 1.0553 (S355J0) | 1
15 | profil P16 | | 1.0553 (S355J0) | 2
16 | profil P13 | | 1.0553 (S355J0) | 2
17 | profil P11 | | 1.0553 (S355J0) | 4

1. Wszystkie profile mają wymiar przekroju 30x30, grubość ścianki 3mm.

SOLIDWORKS Educational Product. For Instructional Use Only.
