Zykbyk/VACLAV/0. Instrukcje i inne ważne pliki/Dokumentacja KLARA/Załączniki/Attachment_4.PDF

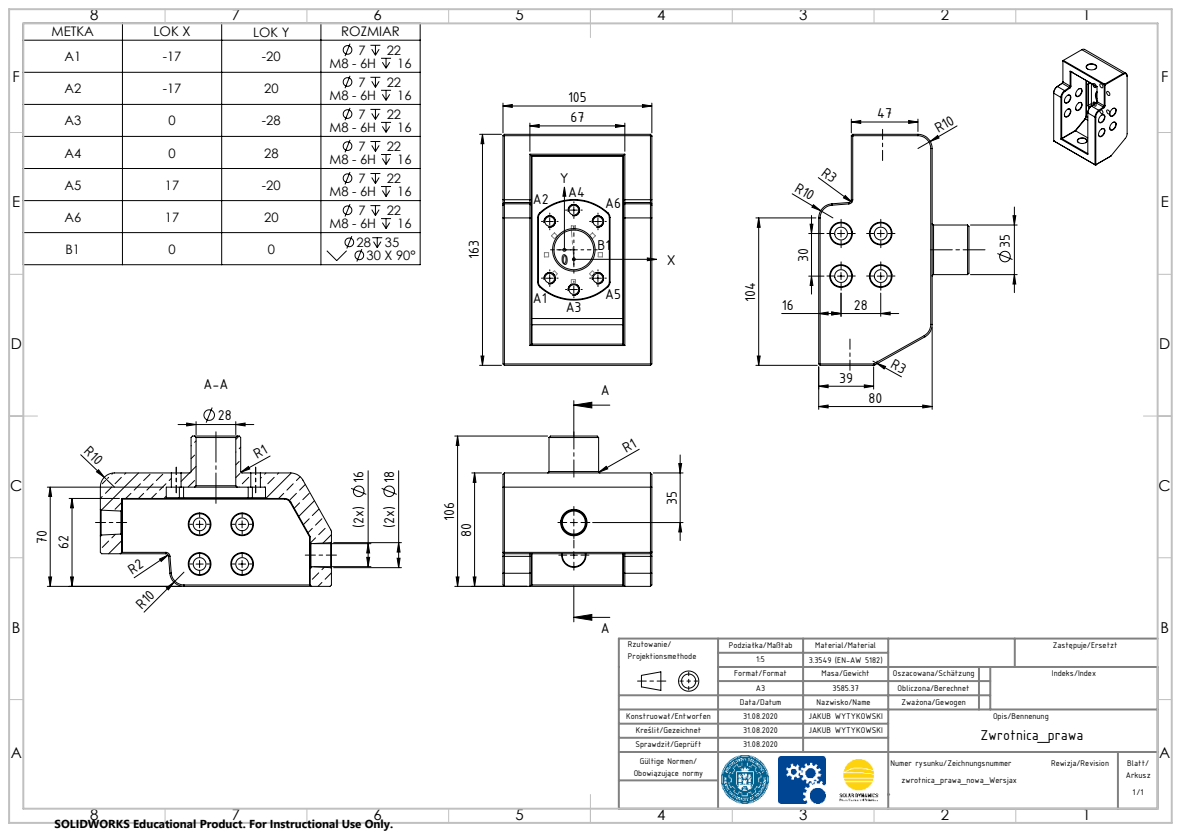
[picture p227: page 1]

METKA | LOK X | LOK Y | ROZMIAR | 105
A1 | -17 | -20 | 7 22 M8 - 6H 16
A2 | -17 | 20 | 7 22 M8 - 6H 16

A4 | 0 | 28 | 7 22 M8 - 6H 16
A5 | 17 | -20 | 7 22 M8 - 6H 16
A6 | 17 | 20 | 7 22 M8 - 6H 16
B1 | 0 | 0 | 28 35 30 X 90°

Rzutowanie/ Projektionsmethode | Podziałka/Maßtab | Material/Material | | Zastępuje/Ersetzt

1:5 | 3.3549 (EN-AW 5182)
Format/Format | Masa/Gewicht | Oszacowana/Schätzung | | Indeks/Index
A3 | 3585.37 | Obliczona/Berechnet
Data/Datum | Nazwisko/Name | Zważona/Gewogen

Konstruował/Entworfen | 31.08.2020 | JAKUB WYTYKOWSKI | Opis/Bennenung Zwrotnica_prawa
Kreślił/Gezeichnet | 31.08.2020 | JAKUB WYTYKOWSKI
Sprawdził/Geprüft | 31.08.2020
Gültige Normen/ Obowiązujące normy | | Numer rysunku/Zeichnungsnummer Rewizja/Revision zwrotnica_prawa_nowa_Wersjax | Blatt/ Arkusz 1 /1

SOLIDWORKS Educational Product. For Instructional Use Only.
