Zykbyk/VACLAV/0. Instrukcje i inne ważne pliki/Dokumentacja KLARA/Załączniki/Attachment_5.PDF

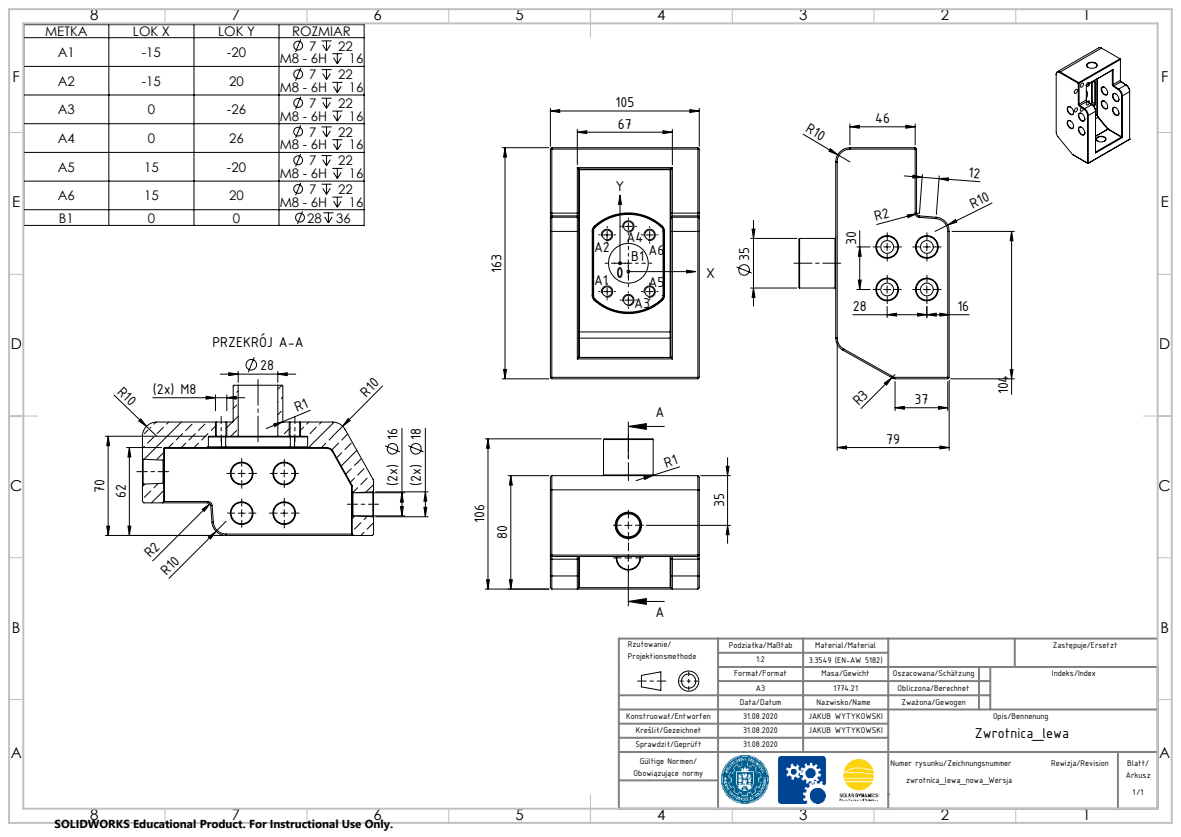
[picture p228: page 1]
PRZEKRÓJ A-A

METKA | LOK X | LOK Y | ROZMIAR | | 105
A1 | -15 | -20 | 7 22 M8 - 6H 16
A2 | -15 | 20 | 7 22 M8 - 6H 16
A3 | 0 | -26 | 7 22 M8 - 6H 16
A4 | 0 | 26 | 7 22 M8 - 6H 16
A5 | 15 | -20 | 7 22 M8 - 6H 16
A6 | 15 | 20 | 7 22 M8 - 6H 16
B1 | 0 | 0 | 28 36

Rzutowanie/ Projektionsmethode | Podziałka/Maßtab | Material/Material | | Zastępuje/Ersetzt

1:2 | 3.3549 (EN-AW 5182)
Format/Format | Masa/Gewicht | Oszacowana/Schätzung | | Indeks/Index
A3 | 1774.21 | Obliczona/Berechnet
Data/Datum | Nazwisko/Name | Zważona/Gewogen

Konstruował/Entworfen | 31.08.2020 | JAKUB WYTYKOWSKI | Opis/Bennenung Zwrotnica_lewa
Kreślił/Gezeichnet | 31.08.2020 | JAKUB WYTYKOWSKI
Sprawdził/Geprüft | 31.08.2020
Gültige Normen/ Obowiązujące normy | | Numer rysunku/Zeichnungsnummer Rewizja/Revision zwrotnica_lewa_nowa_Wersja | Blatt/ Arkusz 1 /1

SOLIDWORKS Educational Product. For Instructional Use Only.
