Zykbyk/VACLAV/(commit log)

2021-10-10 Dodanie plików
    pierwsze dodanie, stara wersja
    [01051100-1-00 ASSEMBLY GRANDE 0.5.SLDASM, 01051100-1-01 rocker.SLDPRT, 01051100-1-02 podkładka stożkowa (oś obrotu).SLDPRT, 01051100-1-03 podkładka stożkowa.SLDPRT, 01051110-1-00 łącznik.SLDASM, 01051110-1-02 dystans do rockerów.SLDPRT, 01051110-1-03 dystans do łożysk.SLDPRT, 01051130-1-00 pushrod-wheel ASSEMBLY.SLDASM]
2021-10-12 Kinematyka - obliczenia
    Stan obliczeń kinematyki na 12.10.2021
    [Kinematyka - obliczenia 30.xlsx]
2021-10-12 Maglownica
    Dodanie projektu maglownicy
    [Złożenie Magla.SLDASM, korpus maglownicy.SLDPRT, wał zębaty magla.SLDPRT]
2021-10-12 tworzenie gałęzi
    no ten tego ten
    [kierowniczy -schem prot.SLDPRT]
2021-10-13 Dodanie wahaczy
    [01011000-1-00 wahacze.SLDASM, 01011100-1-00 wahacze przód.SLDASM, 01011110-1-00 wahacz przód góra.SLDASM, 01011110-1-01.SLDPRT, 01011110-1-02.SLDPRT, 01011110-1-03.SLDPRT, 01011110-1-04.SLDPRT, 01011120-1-00 wahacz przód dół.SLDASM]
2021-10-13 Dynamika Excel 13.10.2021
    Poprawa układu hamulcowego oraz wyprowadzenie potrzebnej mocy silnika zależnie od różnych warunków
    [D_17_Obliczenia_10.10.2021.xlsx]
2021-10-13 Nowszy przód
    Poprzednio wrzuciłem pierwsze lepsze złożenie, teraz znalazłem najnowsze
    [01051100-1-00 ASSEMBLY GRANDE 0.5.SLDASM, 01051110-1-00 łącznik.SLDASM, 01051130-1-00 pushrod-wheel ASSEMBLY.SLDASM, 01051140-1-00 pushrod-anti-roll bar ASSEMBLY.SLDASM, ROD-END-GN-648.2-10.SLDASM]
2021-10-14 testy
    dodanie rysuneczków projektowych
    [kierowniczy - schem 1.SLDPRT]
2021-10-14 Revert "Merge branch 'master' of https://github.com/jacentyTheReaper/Zawieszenie"
    This reverts commit d733da01675ceee9148e1b495340c0ba44220ea7, reversing
    changes made to 1885e5941d1e754428b6b1c7185cb0de01c2c6bb.
    [01051100-1-00 ASSEMBLY GRANDE 0.5.SLDASM, 01051110-1-00 łącznik.SLDASM, 01051130-1-00 pushrod-wheel ASSEMBLY.SLDASM, 01051140-1-00 pushrod-anti-roll bar ASSEMBLY.SLDASM, D_17_Obliczenia_10.10.2021.xlsx, ROD-END-GN-648.2-10.SLDASM]
2021-10-14 Dodanie stabilizatorów
    Pierwsze dodanie
    [01101000-1-00.SLDASM, 01101100-1-00.SLDASM, 01101110-1-00.SLDPRT, 01101120-1-00.SLDPRT, 01101130-1-00.SLDPRT, 01101160-1-01.SLDPRT, 01101160-1-02.SLDPRT, 01101170-1-01.SLDPRT]
2021-10-14 Próbna zwrotnica
    Dodanie próbnej zwrotnicy
    [próbna_zwrotnica.SLDPRT]
2021-10-17 Zwrotnica_lewa
    Dodanie zwrotnicy
    [01031100-1-02.SLDPRT, 01031100-1-03.SLDPRT, 01031100-1-04.SLDPRT, 01031100-1-06.SLDPRT, 01031100-1-07.SLDPRT, 01031100-1-08.SLDPRT, 01031100-2-07.SLDPRT, 01031100-5-01.SLDPRT]
2021-10-17 Złożenie Zwrotnica lewa
    [Złożenie.SLDASM]
2021-10-17 Złożenie
    Wstępniaczek
    [01081000-1-00.SLDASM, 01081100-1-00.SLDASM, 01081130-1-00.SLDASM, 01081130-1-01.SLDPRT, 01081130-1-02.SLDPRT, 01081130-1-03.SLDPRT, 01081200-1-00.SLDASM, 01081230-1-00.SLDASM]
2021-10-17 Revert "Złożenie"
    This reverts commit 4def07f1e015c217937d698256fe6d9c6ea53142.
    [01081000-1-00.SLDASM, 01081100-1-00.SLDASM, 01081130-1-00.SLDASM, 01081130-1-01.SLDPRT, 01081130-1-02.SLDPRT, 01081130-1-03.SLDPRT, 01081200-1-00.SLDASM, 01081230-1-00.SLDASM]
2021-10-17 Poprawione złożenie
    Złożenie z pompą
    [01081000-1-00.SLDASM, 01081100-1-00.SLDASM, 01081130-1-00.SLDASM, 01081200-1-00.SLDASM, 01081230-1-00.SLDASM, 01081300-1-00.SLDASM, 01081330-1-00.SLDPRT, 01081340-1-00.SLDPRT]
2021-10-18 Adding motorsport assembly
    Adding motorsport assembly
    [1.SLDPRT]
2021-10-18 Złożenie klatki z elementami
    Jacek nie denerwuj się
    [01021000-2-00 12.07.2021.SLDPRT, 01021500-1-01.SLDPRT, 01021500-1-02.SLDPRT, złożenie klatki 13.07.2021.SLDASM]
2021-10-20 Poprawione opisy części
    Dobrze robię?
    [01081000-1-00.SLDASM, 01081130-1-00.SLDASM, 01081130-1-01 Dzwon przód.SLDPRT, 01081130-1-02 Tarcza cierna przód.SLDPRT, 01081130-1-03 Pierścień przód.SLDPRT, 01081200-1-00.SLDASM, 01081230-1-00.SLDASM, 01081230-1-01 Dzwon tył.SLDPRT]
2021-10-20 Usunięcie zbędnych plików
    Nie zaśmiecamy, sprzątamy
    [01081130-1-01.SLDPRT, 01081130-1-02.SLDPRT, 01081130-1-03.SLDPRT, 01081230-1-01.SLDPRT, 01081230-1-02.SLDPRT, 01081230-1-03.SLDPRT, Tłok.SLDPRT, Uszczelka tłoka 2.SLDPRT]
2021-10-22 Złożenie całego przodu
    Złożenie blisko gotowego, trzeba będzie dograć jeszcze trochę ropzłożeniw w przestrzeni
    [01051000-1-00 Wymuszenia przód.SLDASM]
2021-10-22 Złożenie matka
    Pierwsze wrzucenie, masa płaszczyzn i nazw plików do poprawy
    [01001000-0-00.SLDASM]
2021-10-23 Aktualne obliczenia
    Wprowadzenie nowych danych odnośnie rear roll centre. Stworzenie nowego arkusza dla obliczeń układu hamulcowego. Przeniosłem tam obliczenia wykonane przez Marcela i trochę je rozszerzyłem.
    [Kinematyka - obliczenia 31.xlsx]
2021-10-24 Prot 2
    Utworzenie drugiego, poprawionego prorotypu układu kierowniczego
    [kierowniczy - Schem prot 2.SLDPRT]
2021-10-24 prot 2
    poprawa prototypu 2
    [kierowniczy - Schem prot 2.SLDPRT]
2021-10-24 test
    test1
    [00000000001.SLDPRT]
2021-10-24 Aktualizacja klatki, Złożenie auta
    Nowsza klatka, pełne złożenie wraz z wszystkimi elementami
    [01011000-1-00 wahacze.SLDASM, 01011100-1-00 wahacze przód.SLDASM, 01011110-1-00 wahacz przód góra.SLDASM, 01011110-1-01.SLDPRT, 01011110-1-02.SLDPRT, 01011110-1-03.SLDPRT, 01011110-1-04.SLDPRT, 01011120-1-00 wahacz przód dół.SLDASM]
2021-10-24 Próbna piasta
    Dodanie próbnej piasty
    [piasta.SLDPRT]
2021-10-25 deleting
    deleting testing files
    [00000000001.SLDPRT, 1.SLDPRT]
2021-10-25 Motorsport
    Bolid evarta 2020 - złożenie
    [BMS Body.SLDPRT, BMS Insert.SLDPRT, BMS Key.SLDPRT, Body Prototype V4.0.SLDPRT, CFXL12_3_2.stp, Część2.sldprt, Część3.sldprt, ISO 4035 M10 thin nut.SLDPRT]
2021-10-25 Poprawienie płaszczyzn wahaczy, dodanie opon i felg
    [01011000-1-00 wahacze.SLDASM, 01011100-1-00 wahacze przód.SLDASM, 01011110-1-00 wahacz przód góra.SLDASM, 01011110-1-01.SLDPRT, 01011110-1-02.SLDPRT, 01011110-1-03.SLDPRT, 01011110-1-04.SLDPRT, 01011120-1-00 wahacz przód dół.SLDASM]
2021-10-28 Poprawa złożeń i mały test
    Poprawiłem płaszczyzny w pushrodach i unieruchomiłem wiązaniem złożenie półgłówne (a więc główne też), podmieniłem łożyska na Toolbox'owe (dajcie znać czy działają), skopiowałem folder z normaliami na listę główną żeby każdy miał do nich szybki dostęp.
    [01051100-1-00 ASSEMBLY GRANDE 0.5.SLDASM, 01051110-1-00 łącznik.SLDASM, 01051110-1-03 dystans do łożysk.SLDPRT, 01051130-1-00 pushrod-wheel ASSEMBLY.SLDASM, 01051140-1-00 pushrod-anti-roll bar ASSEMBLY.SLDASM, BALL-JOINT-GN-648.8-1-10.SLDPRT, BALL-JOINT-GN-648.8-1-12.SLDPRT, BALL-JOINT-GN-648.8-1-14.SLDPRT]
2021-11-02 Podkładka_do_zwrotnicy_1
    Dodanie pierwszej części podkładki
    [podkladka2.SLDPRT]
2021-11-02 Podkładka2
    Poprawiona podkładka zwrotnicy
    [podkladka2.SLDPRT]
2021-11-02 Podkładka3
    Podkładka do zwrotnicy druga
    [pokładka3.SLDPRT]
2021-11-02 Zmiana nazwy
    Zmiana na poprawną nazwę z nazewnictwem (excel)
    [01031100-1-00.SLDASM, Złożenie.SLDASM]
2021-11-02 Złożenie główne
    Przebudowane od nowa złożenie główne
    [01051000-1-00 Wymuszenia przód.SLDASM, 01051100-1-00 ASSEMBLY GRANDE 0.5.SLDASM, 01051110-1-00 łącznik.SLDASM]
2021-11-03 Złożenie zwrotnic przód
    Dodanie zwrotnicy prawej, umieszczenie zespołu w odległości 700mm od środka (do sprawdzenia)
    [01031000-1-00.SLDASM, 01031100-1-00.SLDASM, Lustro01031100-1-00.SLDASM, Lustro01031100-1-02.SLDPRT, Lustro01031100-1-03.SLDPRT, Lustro01031100-1-04.SLDPRT, Lustro01031100-1-06.SLDPRT, Lustro01031100-1-08.SLDPRT]
2021-11-07 Poprawa płaszczyzn złożenia
    Poprawa płaszczyzn
    [01081000-1-00.SLDASM, 01081100-1-00.SLDASM]
2021-11-09 Mała poprawka w łączniku między rockerplate'ami
    Zamiast jednego otworu na śruby utrzymujące łożyska, wstawiłem 3
    [01051110-1-02 dystans do rockerów.SLDPRT]
2021-11-14 Dodanie złożenia, poprawienie nazw
    Złożenie tylko z prawą zwrotnicą, napotkałam pewne problemy ;D
    [01041110-1-00 Złożenie_tył_zwrotnica_prawa.SLDASM, 01041110-1-00 próbna_zwrotnica_prawa.SLDPRT, próbna_zwrotnica.SLDPRT]
2021-11-14 Poprawa odległości od środka
    Dopasowanie do układu hamulcowego
    [01031000-1-00.SLDASM, Lustro01031100-1-00.SLDASM, Lustro01031100-1-02.SLDPRT]
2021-11-14 Zwrotnica lewa
    Dodanie próbnej zwrotnicy lewej
    [01043120-1-01 próbna_zwrotnica_lewa.SLDPRT]
2021-11-14 Złożenie i poprawki zwrotnica
    Poprawienie nazw, dodanie złożenia lewej zwrotnicy
    [01041100-1-01 próbna_zwrotnica_prawa.SLDPRT, 01041100-1-05 próbna_zwrotnica_lewa.SLDPRT, 01041120-1-00 Złożenie_tył_zwrotnica_lewa.SLDASM]
2021-11-15 Porządki
    usunęłam niepotrzebne
    [01041110-1-00 próbna_zwrotnica_prawa.SLDPRT, 01043120-1-01 próbna_zwrotnica_lewa.SLDPRT, próbna_zwrotnica.SLDPRT]
2021-11-16 Porządki w folderze
    [01011000-1-00 wahacze.SLDASM]
2021-11-17 tylko klatka
    [01011000-1-00 wahacze.SLDASM, 01011100-1-00 wahacze przód.SLDASM, 01011110-1-00 wahacz przód góra.SLDASM, 01011110-1-01.SLDPRT, 01011110-1-02.SLDPRT, 01011110-1-03.SLDPRT, 01011110-1-04.SLDPRT, 01011120-1-00 wahacz przód dół.SLDASM]
2021-11-25 Poprawki i dodanie złożenia
    Złożenie zwrotnicy i piasty
    [01041000-1-00.SLDASM, 010411100-1-00 Złożenie_tył_zwrotnica_prawa.SLDASM, 010411200-1-00 Złożenie_tył_zwrotnica_lewa.SLDASM]
2021-11-26 Złożenie
    zrobienie wstępnego złożenia kierowniczego
    [00000000000000000000000000000000.SLDASM, 01072000-1-00 umiejscowienie.SLDASM, 01072000-1-00 złożenie maglownicy.SLDASM, 01072000-1-01 korpus maglownicy.SLDPRT, 01072000-1-02 nakrętka ramienia maglownicy.SLDPRT, 01072000-1-03 wał zębaty maglownicy.SLDPRT, 01072000-1-04 przedłużka maglownicy.SLDPRT, 01072000-1-11 uchwyt maglownicy.SLDPRT]
2021-12-05 Update
    Poprawa układu odniesienia zwrotnicy, dodanie pochyłu 3 stopni mocowania górnego
    [01031100-5-02.SLDPRT]
2021-12-08 Poprawy w złożeniach
    Płaszczyzny w łączniku nie przechodziły przez oś oborotu (co utrudniłoby znacznie umiejscowienie zespołu w aucie)
    Podkładki stożkowe w osi obrotu zostały przeniesione do złożenia łącznika i usunięte z Assembly Grande 0.5
    [01051000-1-00 Wymuszenia przód.SLDASM, 01051100-1-00 ASSEMBLY GRANDE 0.5.SLDASM, 01051110-1-00 łącznik.SLDASM]
2021-12-12 Wszelkie poprawki i zamiany
    Usunięcie wszystkich plików i wrzucenie na nowo poprawionych, gotowe złożenia i raczej odpowiednie nazwy
    [01041000-1-00.SLDASM, 01041100-1-01 próbna_zwrotnica_prawa.SLDPRT, 01041100-1-01 zwrotnica_prawa.SLDPRT, 01041100-1-02 pokładka1.SLDPRT, 01041100-1-03 podkładka2.SLDPRT, 01041100-1-05 próbna_zwrotnica_lewa.SLDPRT, 01041100-1-05 zwrotnica_lewa.SLDPRT, 01041110-1-00 Złożenie_tył_zwrotnica_prawa.SLDASM]
2021-12-12 podmiana w złożeniu
    piasty
    [01041000-1-00.SLDASM]
2021-12-12 Najnowsza klatka z elementami złożenia
    W folderze "elementy klatki" są wszystkie części złożenia
    [Accelerator pedal.SLDASM, Accelerator.SLDPRT, ArmLeftFore.STEP.SLDPRT, ArmLeftHand.STEP.SLDPRT, ArmLeftUpper.STEP.SLDPRT, ArmRightFore.STEP.SLDPRT, ArmRightHand.STEP.SLDPRT, ArmRightUpper.STEP.SLDPRT]
2021-12-14 Nowe złożenie
    Dodane nowe złożenie zawierające zwrotnice z dodanymi kątami pochyłu mocowania dolnego oraz górnego. Poprawiony układ współrzędnych.
    [01031000-1-00.SLDASM, 01031000-2-00.SLDASM, 01031100-1-00.SLDASM, 01031100-1-03.SLDPRT, 01031100-2-00.SLDASM, 01031100-2-07.SLDPRT, 01031100-6-01.SLDPRT, Lustro01031100-1-00.SLDASM]
2021-12-18 Klatka
    Nowe nazwy, nowe złożenie zrobione od zera z plików w tym folderze, jak nadal nie działa to hgw
    [01021100-10-01-Podłoga.SLDPRT, 01021100-10-02-klatka.SLDPRT, 01021400-10-01-wspornik_podłużnic.SLDPRT, 01021400-10-01.SLDPRT, Accelerator pedal.SLDASM, Accelerator.SLDPRT, ArmLeftFore.STEP.SLDPRT, ArmLeftHand.STEP.SLDPRT]
2021-12-19 Mocowania wachaczy
    Poprawa kierunku mocowania wachaczy
    [01031000-2-00.SLDASM, 01031100-2-00.SLDASM, 01031100-2-07.SLDPRT, Lustro01031100-1-02.SLDPRT, Lustro01031100-1-03.SLDPRT, Lustro01031100-1-04.SLDPRT, Lustro01031100-1-06.SLDPRT, Lustro01031100-1-08.SLDPRT]
2022-01-30 Przegub zwrotnicy
    Model przegubu zwrotnicy tył (fiat seiceto 1.1 i 0.9)
    [Przegub.SLDPRT]
2022-03-01 REWOLUCJA
    Nadwozie dołączy do nas na GitHubie, żebyśmy mieli wszystkie pliki CADowskie w jednym miejscu, oznacza to pewne zmieny w strukturze folderów jaką mamy. W tym tygodniu nie mergujcie do mastera. Więcej informacji na zebraniu.
    [00000000000000000000000000000000.SLDASM, 01001000-0-00.SLDASM, 01011000-1-00 wahacze.SLDASM, 01011100-1-00 wahacze przód.SLDASM, 01011110-1-00 wahacz przód góra.SLDASM, 01011110-1-01.SLDPRT, 01011110-1-02.SLDPRT, 01011110-1-03.SLDPRT]
2022-03-09 Propozycja klapy bagażnika
    Dodanie klapy i wstępny podział
    [0204100-1-01 LAMINAT-KLAPA-BAG.SLDPRT, HELLA_3D_data_LED_rear_lamp_Strip_Lamp_2BA-980-88.SLDPRT]
2022-03-29 Koncepcja zawiasów
    Koncepcja zawiasów i badanie kinematyki
    [Koncepcja Zawias 2.SLDPRT, Koncepcja Zawias.SLDPRT, Koncepcja zawias 4.SLDPRT, Koncepcja zawias 5.SLDPRT, Zawias Koncepcja Złożenie.SLDASM]
2022-04-02 Dynamika
    Excel z obliczeniami
    [D_18_Obliczenia_2.11.2021.xlsx]
2022-04-04 Dodanie Klary
    Złożenie całej Klary (z kilkoma błędami) które dostałem od emerytów jakiś czas temu. Na potrzeby szybkiego sprawdzania co ważniejszych wymiarów powinno wystarczyć
    [1aYy3uchwyt amor przod gora.SLDPRT, 1adapter tyl pod felge.SLDPRT, 4205 ATN9.stp, Klatkazdodatkami.SLDASM, NL22-Nord-Lock.step, NLWN-M22x1_5-Nord-Lock.step, Napinaczsprężynowy.SLDPRT, Obudowa-lepsza-v15 (1).step]
2022-04-07 Klatka
    Dodanie klatki
    [01021000-1-00 klatka bezpieczenstwa.SLDPRT]
2022-04-26 Model fotela
    Poglądowy i przykładowe strony z fotelami + homologacja
    [podstawa.SLDPRT]
2022-05-12 Podłoga klatki
    Przerobienie klatki, rozdzielenie na górę i dół
    [01021000-1-00 klatka bezpieczenstwa.SLDPRT]
2022-06-05 Zmiana klatki bezpieczeństwa
    Zmiana płaszczyzn i wrzucenie klatki do głównego złożenia
    [01021000-1-00 klatka bezpieczenstwa.SLDPRT]
2022-07-17 Aktualizacja złożenia wahaczy
    Zmiana kątów oraz dodanie caster angle
    [01011100-1-00 wahacze przód.SLDASM, 01011200-1-00 wahacze tył.SLDASM]
2022-07-24 Mocowanie klatki z wachaczami
    Poprawa klatki i dodanie łączenia z wachaczami
    [01021000-1-00 klatka bezpieczenstwa.SLDPRT, 01021400-10-01.SLDPRT, Laczenie.SLDPRT, Złożenie1.SLDASM]
2022-08-16 Poprawa łączenia dołu klatki
    Łączenie klatki z wachaczami za pomocą ceowników
    [01021000-1-00 klatka bezpieczenstwa.SLDPRT, Ceownik.SLDPRT, Złożenie1.SLDASM]
2022-08-16 Zmiana nazwy pliku
    Zmiana nazwy pliku na poprawną
    [01021000-1-00 klatka bezpieczenstwa - stare.SLDPRT, 01021000-1-00 klatka bezpieczenstwa.SLDASM]
2022-08-16 Zmiana nazw plików
    Zmiana nazw plików
    [01021000-1-00 klatka bezpieczenstwa.SLDPRT, 01021000-1-00.SLDASM]
2022-09-02 Zmiana wymiarów rurek
    Zmiana średnizy zewnętrznej z 13 na 14 [mm] - łatwiej będzie znaleźć handlowy towar oraz rurki będą mocniejsze
    [01051130-1-01 pushrod-wheel PART.SLDPRT, 01051140-1-01 pushrod-anti-roll bar PART.SLDPRT]
2022-09-20 Usunięcie pliku
    ccccc
    [Kinematyka - obliczenia 30.xlsx]
2022-10-10 Zmiana ceownikow
    Zmiana ceownikow z C50 na C65 do mocowania wachaczy
    [01021000-1-00.SLDASM, Ceownik.SLDPRT]
2022-11-09 Nowy koncept uchwytu na zacisk hamulcowy
    Zaprojektowany na nowo ze względu na złe zgranie nowych adapterów do silników, zacisków hamulcowych i silnika z tarczą hamulcową
    [uchwyt zacisku hamulcowego KLARA.SLDPRT]
2022-12-07 Uchwyt zacisku hamulcowego
    poprawiona wersja uchwytu zacisku hamulcowego
    [uchwyt zacisku hamulcowego KLARA.SLDPRT]
2022-12-07 Obliczenia_Stabilizator
    Obliczenia123
    [CharakterystykaPrzemieszczeniaOdDługości.xlsx]
2022-12-07 Uchwyt zacisku hamulcowego KLARA
    Poprawiona wersja uchwytu zaciusku hamulcowego
    [uchwyt zacisku hamulcowego KLARA.SLDPRT]
2022-12-07 Sprzątanie po szkoleniu
    Usunięcie plików, które członkowie dodali na serwer w ramach treningu obsługi FORKa
    [CharakterystykaPrzemieszczeniaOdDługości.xlsx, uchwyt zacisku hamulcowego KLARA.SLDPRT]
2022-12-10 Obliczenia_Stabilziator
    Obliczenia charakterystyki przemieszczenia pionowego ramienia od długości ramienia
    [dfghjdghj.xlsx]
2022-12-10 Bob Cat
    BoBCat nauka solidworks
    [Cabin cap.SLDPRT, Część1.SLDPRT, Część5.SLDPRT, Oprawka.SLDPRT, Tablica.SLDPRT, kabina.SLDPRT, Łyżka.SLDPRT, Żarówka.SLDPRT]
2022-12-10 Pierwsze części modelu ćwiczeniowego
    Pokrywy scyzoryka i zaczęty model śrubokrętu
    [Część2.SLDPRT, first cover.SLDPRT, second cover.SLDPRT, śrubokręt.SLDPRT]
2022-12-13 Hamownia silnika Kisielewski - pierwszy koncept
    Narysowałem jako tako jak widzę mocowanie silnika Kisielewskiego i rozkład stanowiska, trzeba jeszcze dokończyć stojak na mały silnik oraz naryzować sam mały silnik. Brakuje wzmocnień dla płyty nośnej silnika Kisielewski (jakieś zastrzały, może profile na kupkę pod samym adapterem). Dodatkowo trzeba wymyślić fasolki wycięte w podstawie, do naciągania pasa poprzez suwanie całego stojaka małego silnika promieniowo do osi silnika Kisielewski.
    [1. Hamownia silnika Kisielweski.SLDASM, Adapter silnika Kisielewski.SLDPRT, mocowanie adaptera dół.SLDPRT, mocowanie adaptera góra.SLDPRT, podstawa.SLDPRT, płyta nośna silnika Kisielewski.SLDPRT, silnik Kisielewski.SLDPRT, stojak MAŁY SILNICZEK.SLDPRT]
2022-12-14 Hamownia silnika Kisielewski - dodanie małego silnika
    Poprawiony mkodel stojaka pod mały silnik oraz stworzony model małego silnika.
    [1. Hamownia silnika Kisielweski.SLDASM, MAŁY SILNICZEK stojak.SLDPRT, MAŁY SILNICZEK.SLDPRT, Silnik Kisielewski adapter.SLDPRT, Silnik Kisielewski płyta nośna.SLDPRT, podstawa hamowni.SLDPRT, stojak MAŁY SILNICZEK.SLDPRT]
2022-12-20 Ćwiczenia - Solidworks
    Dalej składam scyzoryk w solidworks, nie za szybko ale dalej do przodu.
    [Część2.SLDPRT, bender point.SLDPRT, bottle opener.SLDPRT, do dokonczenia nozyczki.SLDPRT, holder.SLDPRT, knife.SLDPRT, knife2.SLDPRT, main plate.SLDPRT]
2023-01-04 Poprawienie mocowania wahaczy
    Przebudowano ramę przednią i tylną, przesunięto ceowniki mocujące
    [01021000-1-00 klatka bezpieczenstwa.SLDPRT, 01021000-1-00.SLDASM]
2023-01-09 Zakończenie modelu ćwiczeniowego SolidWorks
    Nazwa pliku zawierającego gotowy zespołu Assem1, reszta jego składowe, wszystko gotowe do wglądu
    [Assem1.SLDASM, bottle cork opener.SLDPRT, can opener.SLDPRT, do dokonczenia nozyczki.SLDPRT, first cover.SLDPRT, holder.SLDPRT, knife2.SLDPRT, main plate.SLDPRT]
2023-01-11 Modyfikacja wahaczy
    Zmiana długości rurek
    [01011000-1-00 wahacze.SLDASM, 01011100-1-00 wahacze przód.SLDASM, 01011110-1-00 wahacz przód góra.SLDASM, 01011110-1-01.SLDPRT, 01011110-1-02.SLDPRT, 01011110-1-03.SLDPRT, 01011110-1-04.SLDPRT, 01011120-1-00 wahacz przód dół.SLDASM]
2023-01-11 Zmiana długości wahaczy
    Dostsowanie długości rurek do ceowników mocujących
    [01011000-1-00 wahacze.SLDASM, 01011100-1-00 wahacze przód.SLDASM, 01011110-1-00 wahacz przód góra.SLDASM, 01011110-1-02.SLDPRT]
2023-01-11 Zmiana długości wahaczy
    Zmiana długości rurek tak, żeby pasowały do mocowania na ramie
    [01011000-1-00 wahacze.SLDASM, 01011100-1-00 wahacze przód.SLDASM, 01011110-1-00 wahacz przód góra.SLDASM, 01011110-1-02.SLDPRT, 01011120-1-00 wahacz przód dół.SLDASM, 01011120-1-02.SLDPRT]
2023-01-12 Dokumentacja KLARA
    Dokumentacja KLARY z zawodów iLumen European Solar Challenge 2021 w Belgii (Circuit Zolder) wraz z załącznikami
2023-01-14 Rower Kewina
    Zadanie, które dał Jacek w celu rozwoju moich umiejętności w programie SolidWorks
    [kierownica.SLDPRT, kołek.SLDPRT, koło.SLDPRT, koło_przednie.SLDPRT, pedaly.SLDPRT, pedał.SLDPRT, rama.SLDPRT, siodelko.SLDPRT]
2023-02-17 Złożenie roweru - zadanie solidworsk
    Części roweru wraz z jego złożeniem (rama, koła, łańcuch, siodełko, itd.)
    [Część2.SLDPRT, Część3.SLDPRT, Część4.SLDPRT, Część5.SLDPRT, Część6.SLDPRT, Część7.SLDPRT, Część8.SLDPRT, Część9.SLDPRT]
2023-03-02 wpis 1
    Wstępne założenia podwozia
    [00-00-01-rama podwozia.SLDASM, 00-01-00-podłuznice (warianty).SLDPRT, 00-02-00- blachy 2mm.SLDPRT]
2023-03-08 wpis H1
    Dodanie propozycji hamowni
    [1. Hamownia silnika Kisielweski.SLDASM, Profile 30x30x2.SLDPRT, blaha dociągacza.SLDPRT, listwa dociągacza.SLDPRT, nakrętka M8x1.25.SLDPRT, śruba M8x1.25.SLDPRT]
2023-03-08 wpis 2 - poprawa ramy
    zmiana kątów w spawaniu oraz dodanie półek
    [00-00-01-rama podwozia.SLDASM, 00-01-00-podłuznice (warianty).SLDPRT, 00-02-00- blachy 2mm.SLDPRT]
2023-03-09 Klatka bezpieczeństwa
    Wstępna wersja, klatki bezpieczeństwa
    [00-01-00 - Klatka Bezpieczenstwa (wersja wstepna).SLDPRT]
2023-03-12 Add files via upload
    Tarcze hamulcowe klara
    [tarcza1.SLDPRT, tarcza2.SLDPRT, tarcza3.SLDPRT]
2023-03-12 Tylne tarcze hamulcowe Klara
    3 Propozycje sprawdzonych mechanicznie tarczy hamulcowych
    [tarcza1.SLDPRT, tarcza2.SLDPRT, tarcza3.SLDPRT]
2023-03-16 Przeniesienie napędu
    Dodano gabaryty niektórych podzespołów układu przeniesienia napędu (wzięte z samochodu BMW E39)
    [03-00-01 przeniesienie napędu.SLDASM, 03-01-00 dyfer e39.SLDPRT, 03-02-00 półoś e39.SLDPRT]
2023-03-16 Poprawka złożenia przeniesienia napędu
    Plik odwoływał się do starych nazw, przez co nie działał
    [03-00-01 przeniesienie napędu.SLDASM]
2023-03-23 Klamka
    Klamka nowa mechaniczna
    [Klamka.SLDPRT, Mocowanie 2.SLDPRT, Mocowanie.SLDPRT, Nakładka.SLDPRT, całość.SLDASM, podkładka.SLDPRT]
2023-03-23 Klamka nowa mechaniczna
    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
    [Klamka.SLDPRT, Mocowanie 2.SLDPRT, Mocowanie.SLDPRT, Nakładka.SLDPRT, całość.SLDASM, podkładka.SLDPRT]
2023-03-23 klatka bezpieczeństwa
    Kolejna wersja klatki bezpieczeństwa (poprawiona o wstępne wymiary)
    [00-01-00 - Klatka Bezpieczenstwa (wersja wstepna).SLDPRT, 02-00-01 - Klatka Bezpieczenstwa.SLDASM, 02-01-00 - Klatka Bezpieczenstwa (wersja wstepna).SLDPRT, 02-02-00 - Element montazowy.SLDPRT]
2023-03-24 Dyferencjał poprawki
    Dodanie ucha bocznego do dyferu
    [03-00-01 przeniesienie napędu.SLDASM, 03-01-00 dyfer e39.SLDPRT]
2023-03-25 Dyferencjał i półosie zmiana otworów na M10
    Wcześniej było M8, powinno być M10 lub M12
    [03-00-01 przeniesienie napędu.SLDASM, 03-01-00 dyfer e39.SLDPRT, 03-02-00 półoś e39.SLDPRT]
2023-03-25 Przeniesienie napędu - dodanie wału, sprzęgła kardana i silnika
    Uaktualnienie złożenia i dodanie nowych elementów: wału napędowego, kardanu na wał silnika, krzyżaka na kardan, silnika elektrycznego i wpustu na wałek silnika
    [03-00-01 przeniesienie napędu.SLDASM, 03-01-00 dyfer e39.SLDPRT, 03-03-00 silnik ME1616.SLDPRT, 03-04-00 wał napędowy e39 1229144.SLDPRT, 03-05-00 kardan na wał silnika.SLDPRT, 03-06-00 krzyżak na kardan.SLDPRT, 03-07-00 wpust na wałek silnika.SLDPRT]
2023-03-31 Przeniesienie napędu cd
    Dodane zostało sprzęgło i wałek kardana do złożenia. Poprawiono też błędy w poprzednich rysunkach. Usunięto koncepcję kardana na wałku silnika
    [03-00-01 przeniesienie napędu.SLDASM, 03-05-00 kardan na wał silnika.SLDPRT, 03-05-00 kardan.SLDPRT, 03-07-00 wpust na wałek silnika.SLDPRT, 03-08-00 pająk.SLDPRT, 03-09-00 piasta sprzęgła.SLDPRT]
2023-03-31 Przeniesienie napędu naprawa błędu złożenia
    Poprawa błędu złożenia, którego nie zauważyłem wysyłając wcześniejszy commit
    [03-00-01 przeniesienie napędu.SLDASM]
2023-04-02 Poprawki sprzęgła
    Zastąpienie sprzęgła takim, które ma większy maks. torqe niż silnik
    [03-00-01 przeniesienie napędu.SLDASM, 03-08-00 pająk.SLDPRT, 03-09-00 piasta sprzęgła.SLDPRT]
2023-04-06 Przeniesienie napędu cd 2
    Dodanie wałku przejściowego z nakładką kardanowską, zastąpienie sprzęgła modelami od producenta i poprawki złożenia
    [03-00-01 przeniesienie napędu.SLDASM, 03-04-00 wał napędowy e39 1229144.SLDPRT, 03-05-00 kardan.SLDPRT, 03-08-00 pająk.SLDPRT, 03-09-00 piasta sprzęgła.SLDPRT, 03-10-00 wałek przejściowy.SLDPRT, 03-11-00 nakładka kardanowska.SLDPRT]
2023-04-16 Klatka bezpieczeństwa
    Aktualna wersja klatki bezpieczeństwa
    [02-00-01 - Klatka Bezpieczenstwa.SLDASM, 02-01-00 - Klatka Bezpieczenstwa (wersja wstepna).SLDPRT]
2023-04-16 złożenie gogart
    poprawa zbugowanych plików w złożęniu
    [00-00-01-rama podwozia.SLDASM, 00-01-00-podłuznice (warianty).SLDPRT, 00-02-00- blachy 2mm.SLDPRT, 02-00-01 - Klatka Bezpieczenstwa.SLDASM]
2023-04-20 Krótsze wałki + naprawa złożenia
    Zmieniłem wałki w przeniesieniu napędu na krótsze zgodnie z prośbą Andrzeja i naprawiłem błąd w złożeniu klatki.
    [02-00-01 - Klatka Bezpieczenstwa.SLDASM, 03-00-01 przeniesienie napędu.SLDASM, 03-04-00 wał napędowy e39 1229144.SLDPRT, 03-05-00 kardan.SLDPRT, 03-10-00 wałek przejściowy.SLDPRT]
2023-04-24 Model człowieka
    Model ergonomiczny człowieka w 2D z manipulowalnymi kończynami
    [ra_body.SLDPRT, ra_head.SLDPRT, ra_human body.SLDASM, ra_leg.SLDPRT, ra_lower thigh.SLDPRT, ra_lowerarm.SLDPRT, ra_neck.SLDPRT, ra_palm.SLDPRT]
2023-04-29 Przeniesienie napędu poprawki
    Dodałem otwory do silnika i zmieniłem kąt kardana
    [03-00-01 przeniesienie napędu.SLDASM, 03-03-00 silnik ME1616.SLDPRT]
2023-05-05 Przeniesienie napędu (piasta)
    Dodanie piasty z E39 do półosi i poprawki półosi
    [03-00-01 przeniesienie napędu.SLDASM, 03-02-00 półoś e39.SLDPRT, 03-12-00 piasta na koła tylne E39.SLDPRT]
2023-05-11 Dodanie człowieka
    dodanie człowieka 2d do złożenia całości
    [00-00-01-rama podwozia.SLDASM, ra_body.SLDPRT, ra_head.SLDPRT, ra_human body.SLDASM, ra_leg.SLDPRT, ra_lower thigh.SLDPRT, ra_lowerarm.SLDPRT, ra_neck.SLDPRT]
2023-05-11 Złożenie dodanie modyfikacje wymiarów
    nowe mocowania i edycja rozmiarów
    [00-00-01-rama podwozia.SLDASM, 00-02-00- blachy 5mm.SLDPRT, 02-00-01 - Klatka Bezpieczenstwa (propozycja Andrzej).SLDASM, 02-00-01 - Klatka Bezpieczenstwa.SLDASM, 02-01-00 - Klatka Bezpieczenstwa (wersja propozycja Andrzej).SLDPRT, 02-01-00 - Klatka Bezpieczenstwa (wersja wstepna).SLDPRT, 03-00-01 przeniesienie napędu.SLDASM, 03-03-00 silnik ME1616.SLDPRT]
2023-05-15 Kolejna wersja klatki bezpieczeństa
    Zmiana wysokości rury nad układem kierowniczym i delikatne poszerzenie górnej części klatki oraz analizy mes
    [02-01-00 - Klatka Bezpieczenstwa (wersja wstepna).SLDPRT, 02-01-00 - Klatka Bezpieczenstwa.SLDPRT]
2023-06-15 Aktualizacja złożenia
    Zmiana wersji klatki bezpieczeństwa w złożeniu (była o tym mowa chyba 2 tygodnie temu ale zapomniałem to zrobić)
    [00-00-01-rama podwozia.SLDASM, 02-00-01 - Klatka Bezpieczenstwa (propozycja Andrzej).SLDASM, 02-00-01 - Klatka Bezpieczenstwa.SLDASM, 02-01-00 - Klatka Bezpieczenstwa.SLDPRT]
2023-06-17 Dodanie ramy podwozia
    Złożenie ramy podwozia zostało wcześniej omyłkowo usunięte -- dodaję je ponownie
    [00-00-01-rama podwozia.SLDASM]
2023-07-26 Pierwsze części kierowniczy
    Dodanie wstępnych modeli ukłądu kierowniczego oraz niewielkie modyfikacje ramy podwozia
    [00-00-01-rama podwozia.SLDASM, 00-01-00-podłuznice (warianty).SLDPRT, 01-01-00- Kolumna kierownicza.SLDPRT, 01-02-00- korpus maglownicy.SLDPRT]
2023-07-26 zmiana nazwy folderu
    gokart->zgredek
    [00-00-01-rama podwozia.SLDASM, 00-01-00-podłuznice (warianty).SLDPRT, 00-02-00- blachy 2mm.SLDPRT, 00-02-00- blachy 5mm.SLDPRT, 01-01-00- Kolumna kierownicza.SLDPRT, 01-02-00- korpus maglownicy.SLDPRT, 02-00-01 - Klatka Bezpieczenstwa (propozycja Andrzej).SLDASM, 02-00-01 - Klatka Bezpieczenstwa.SLDASM]
2023-08-13 Dodanie silnika
    Dodanie dokładnego modelu silnika
    [silnik ME1616.STEP]
2023-08-19 Przeniesienie napędu poprawki
    Zmiana w wałach, sprzęgle i wpustach. Poprawki złożeń. Przeniesienie plików z folderu Gokart do Zdredka
    [00-02-00- blachy 5mm.SLDPRT, 03-00-01 przeniesienie napędu.SLDASM, 03-00-02 przeniesienie napędu 2.SLDASM, 03-04-00 wał napędowy e39 1229144.SLDPRT, 03-05-00 kardan.SLDPRT, 03-07-00 wpust na wałek silnika.SLDPRT, 03-10-00 wałek przejściowy.SLDPRT, 03-11-00 nakładka kardanowska.SLDPRT]
2023-08-22 Zawieszenie przednie
    Znajduje się tu koło( jego rozmiary) Zwrtonica. Waczacz przedni górny
    [Cz1dowahacza.sldprt, Cz2dowahacza.sldprt, Klamka.SLDPRT, Koło e39.SLDPRT, Mocowanie 2.SLDPRT, Mocowanie.SLDPRT, Nakładka.SLDPRT, Wahaczprawie.sldasm]
2023-08-28 Kardany poprawki
    Poprawa grubości przegubów i wałów kardana oraz krzyżaków. Aktualizacja złożeń
    [03-00-01 przeniesienie napędu.SLDASM, 03-00-02 przeniesienie napędu 2.SLDASM, 03-04-00 wał napędowy e39 1229144.SLDPRT, 03-05-00 kardan.SLDPRT, 03-06-00 krzyżak na kardan.SLDPRT, 03-11-00 nakładka kardanowska.SLDPRT]
2023-08-28 Naprawa błędów w lokalizacji plików
    Bartek pojebał foldery i zrobił się błąd przy ostatnim wrzucaniu
    [Cz1dowahacza.sldprt, Cz2dowahacza.sldprt, Koło e39.SLDPRT, Wahaczprawie.sldasm, zwrotnica.SLDPRT]
2023-08-30 Usunięcie folderu
    [Cz1dowahacza.sldprt, Cz2dowahacza.sldprt, Koło e39.SLDPRT, Wahaczprawie.sldasm, zwrotnica.SLDPRT]
2023-09-06 Aktualizacja złożenia
    Podmienienie na ostateczną wersje klatki bezpieczeństwa
    [02-00-01 - Klatka Bezpieczenstwa.SLDASM, 02-01-00 - Klatka Bezpieczenstwa.SLDPRT, ra_human body.SLDASM]
2023-09-06 Obniżenie przeniej rury
    Obniżenie przeniej rury
    [02-00-01 - Klatka Bezpieczenstwa.SLDASM, 02-01-00 - Klatka Bezpieczenstwa.SLDPRT]
2023-10-04 Zawieszenie przód
    Zwrotnica/wahacze/korpus/sprezyna
    [01091100-1-02.SLDPRT, 2023_08_27.SLDASM, Cz1dowahacza.sldprt, Cz2dowahacza.sldprt, Spreżyna.SLDASM, Wahacz2.sldasm, Wahaczprawie.sldasm, korpus.SLDPRT]
2023-10-11 Poprawa repozytorium
    Uporządkowanie plików łąpacza bo foldery się pomieszały
    [2023_08_27.SLDASM, Cz1dowahacza.sldprt, Cz2dowahacza.sldprt, Spreżyna.SLDASM, Wahacz2.sldasm, Wahaczprawie.sldasm, korpus.SLDPRT, wahaczgornycz1.sldprt]
2023-10-11 Orientacyjne położenia
    Dodanie orientacyjnie ram łapacza do złożenia w celu oszacowania poprawek ewentualnych
    [2023_08_27.SLDASM, Cz1dowahacza.sldprt, Cz2dowahacza.sldprt, Spreżyna.SLDASM, Wahacz2.sldasm, Wahaczprawie.sldasm, korpus.SLDPRT, ra_human body.SLDASM]
2023-10-26 Zwrotnice E39
    Dodanie gabarytowych zwrotnic z BMW E39 i usunięcie błędów złożenia
    [04-01-00-zwrotnica prawa.SLDPRT, 04-02-00-zwrotnica lewa.SLDPRT, 2023_08_27.SLDASM]
2023-10-26 Zmiany w fotelu
    Dodanie nowego modelu 3D fotela
    [ASS Siège conducteur.SLDASM, Base siège conducteur.SLDPRT, Boucle d ceinture.SLDPRT, Dossier siège conducteur.SLDPRT, Pivot G.SLDPRT, Pivot.SLDPRT, Verrouillage.SLDPRT]
2023-10-27 Zwrotnice montaż
    Przeniesienie starej koncepcji do archiwum. Dodanie zwrotnic do złożenia
    [04-03-00-Koło e39.SLDPRT, 2023_08_27.SLDASM, Cz1dowahacza.sldprt, Cz2dowahacza.sldprt, Koło e39.SLDPRT, Spreżyna.SLDASM, Wahacz2.sldasm, Wahaczprawie.sldasm]
2023-10-27 .
    .
    [ra_human body.SLDASM]
2023-10-27 Revert "."
    This reverts commit 57c6565cb1d15379657ec6bb06c1816f83c45c89.
    [ra_human body.SLDASM]
2023-10-27 Revert "Zwrotnice montaż"
    This reverts commit e3ef51620be68127be59b381190362daf832c38a.
    [2023_08_27.SLDASM, Cz1dowahacza.sldprt, Cz2dowahacza.sldprt, Koło e39.SLDPRT, Spreżyna.SLDASM, Wahacz2.sldasm, Wahaczprawie.sldasm, korpus.SLDPRT]
2023-10-27 Zwrotnice montaż
    Dodanie zwrotnic do złożenia głównego i przeniesienie starej koncepcji z wahaczami do archiwum
    [04-03-00-Koło e39.SLDPRT, 2023_08_27.SLDASM, Cz1dowahacza.sldprt, Cz2dowahacza.sldprt, Koło e39.SLDPRT, Spreżyna.SLDASM, Wahacz2.sldasm, Wahaczprawie.sldasm]
2023-11-15 Zawieszenie przód
    Nowe zawieszenie do przodu
    [Cz1dowahacza.sldprt, Cz2dowahacza.sldprt, Część1.SLDPRT, Część2.SLDPRT, Koło e39v2.SLDPRT, Wahaczprawie3.sldasm, Zawieszenie3.SLDASM, korpus1.SLDPRT]
2023-11-22 Zawieszenie tył
    Zawieszenie tylne
    [Baza.SLDPRT, Tylzloz.SLDASM, mocowanie.SLDPRT, rear_wheel_bearing.SLDPRT]
2023-11-22 Pedał gazu
    Dodanie pedału gazu do złożenia
    [03-00-03-Pedal_gazu.SLDASM, 03-14-00-Pedal_gazu_01.SLDPRT, 03-14-00-Pedal_gazu_02.SLDPRT, 03-14-00-Pedal_gazu_03.SLDPRT]
2023-11-25 Zawieszenie przod poprawa
    Poprawa plików
    [Cz1dowahacza.sldprt, Cz2dowahacza.sldprt, Część1.SLDPRT, Część2.SLDPRT, Koło e39v2.SLDPRT, Wahaczprawie.sldasm, Wahaczprawie3.sldasm, Zawieszenie3.SLDASM]
2023-11-29 dziwne złorzenie
    orientacyjne złożenie tymczasowe
    [01-01-00- Kolumna kierownicza.SLDPRT, Zawieszenie3.SLDASM, ra_human body.SLDASM]
2023-12-07 Przód zawieszenie
    Poprawiony przód
    [04-01-03_Złożenie.SLDASM, Cz1dowahacza.sldprt, Cz2dowahacza.sldprt, Część1.SLDPRT, Część2.SLDPRT, Koło e39v2.SLDPRT, Wahaczprawie.sldasm, Wahaczprawie3.sldasm]
2023-12-13 Rower Sebastiana
    Zadanie od Jacka
    [Kierownica.SLDPRT, Koło przód.SLDPRT, Koło tył.SLDPRT, Pedał Pedał.SLDPRT, Pedał.SLDPRT, Pin.SLDPRT, Rama.SLDPRT, Siodełko.SLDPRT]
2023-12-13 Rower Seba
    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
    [Kierownica.SLDPRT, Koło przód.SLDPRT, Koło tył.SLDPRT, Pedał Pedał.SLDPRT, Pedał.SLDPRT, Pin.SLDPRT, Rama.SLDPRT, Siodełko.SLDPRT]
2023-12-20 BobcatProjektKarol
    Wykonanie projektu
    [Arm pin.SLDPRT, Assem3.SLDASM, Assem4.SLDASM, Axle.SLDPRT, Back Cover.SLDPRT, Back Support.SLDPRT, Back.SLDPRT, Bucket.SLDPRT]
2023-12-20 Dodanie rysunków KLATKI BEZPIECZEŃSTWA
    Wszystkie rysunki klatek, wykorzystać w raporcie.
    [PUT_SD_KB_01_00.stp]
2023-12-20 Stanowisko pomiarowe (work- in progress)
    Stanowisko pomiarowe
    [31100-01.sldasm, 31100_gelenk_41.sldprt, 31100_gelenk_81.sldprt, 31100_stativ_1.sldprt, 31100_verbindung_1.sldprt, 831100_fuss.sldprt, C-H-032-0100.SLDASM, C-H-050-0100.stp]
2024-01-10 wahacze prototyp
    Prototyp
    [Cz1dowahacza.sldprt, Cz2dowahacza.sldprt, Część1.SLDPRT, Część2.SLDPRT, Koło e39v2.SLDPRT, Sworzeń.SLDPRT, Wahacz.SLDPRT, Wahaczprawie.sldasm]
2024-01-10 Wprowadzenie zmian
    dużo dziwnych rzeczy
    [00-00-01 (rama podwozia v2).SLDASM, 00-00-01-rama podwozia.SLDASM, 00-00-02- Wachacz lewy.SLDASM, 00-00-02- Wachacz prawy.SLDASM, 00-01-00-podłuznice (warianty).SLDPRT, 00-01-00-profile 60x30x3.SLDPRT, 00-02-00- blachy 2mm.SLDPRT, 00-02-00- blachy 5mm.SLDPRT]
2024-01-11 Przeniesienie plików stanowiska pomiarowego
    Stanowisko pomiarowe znajdowało się w folderze klatki pojazdu VACLAV. Zostało przeniesione do Folderu ZGREDEK'a z własnym podfolderem. Usunięto
    [02-00-01 - Klatka Bezpieczenstwa (propozycja Andrzej).SLDASM, 02-01-00 - Klatka Bezpieczenstwa (wersja propozycja Andrzej).SLDPRT, 31100-01.sldasm, 31100_gelenk_41.sldprt, 31100_gelenk_81.sldprt, 31100_stativ_1.sldprt, 31100_verbindung_1.sldprt, 831100_fuss.sldprt]
2024-01-11 Zamiana klatki w złożeniu
    Poprawki stylistyczne i inne w struktorze folderów
    [02-00-01 - Klatka Bezpieczenstwa.SLDASM]
2024-02-19 Zawieszenie + Piasta lożyskowana
    Zawieszenie. 2 warianty. Piasta łożyskowana
    [00-01-00-profil.SLDPRT, 00-01-00-wahacz.SLDASM, 00-01-01-.SLDPRT, 00-01-02-wahacz.SLDASM, 00_04_00_Piasta łożyskowana.SLDPRT, 00_04_00_Piasta łożyskowana.STEP]
2024-02-27 Piasta tylna e39
    Piasta tylna łożyskowana e39
    [00-01-01_Piasta Łożyskowana tył.SLDPRT]
2024-02-29 trochę lepsza klara
    Dodanie modelu klary z inzynierki z poprawionymi niektórymi rzeczami. Jacku zadecyduyj co z tym zrobić.
    [01072000-1-00 umiejscowienie.SLDASM, 01072000-1-00 złożenie maglownicy do rysunku.SLDASM, 01072000-1-00 złożenie maglownicy.SLDASM, 01072000-1-01 korpus maglownicy.SLDPRT, 01072000-1-02 nakrętka ramienia maglownicy.SLDPRT, 01072000-1-03 wał zębaty maglownicy.SLDPRT, 01072000-1-04 przedłużka maglownicy.SLDPRT, 01072000-1-11 uchwyt maglownicy.SLDPRT]
2024-03-12 Części wypalane
    Dodanie modeli części wypalanych
    [Belka.SLDPRT, Mocowanie_silownik.SLDPRT, Plyta_do_laczenia.SLDPRT, Plytka_pod_klatke.SLDPRT, Plytka_pod_wspornik.SLDPRT, Plytka_pod_wspornik_v2.SLDPRT, Płyta_wspornik.SLDPRT, Rura_dluga.SLDPRT]
2024-03-12 Kratownica
    Dodanie partów i złożenia kratownicy
    [98.00.01 - Kratownica(bez płytek).SLDASM, 98.01.00-profil(1749.2mm).SLDPRT, 98.02.00-profil(2150.8mm).SLDPRT, 98.03.00-profil(434.2mm).SLDPRT, 98.04.00-profil(354.2mm).SLDPRT, 98.05.00-profil(1239.2mm).SLDPRT, 98.06.00-profil(790.2mm).SLDPRT, 98.07.00-profil(223.2mm).SLDPRT]
2024-03-13 Uzupełnienie dokumentacji kratownicy
    Dodanie rysunków wykonawczych do: Profili, blaszek które składają kratownice, dodanie spoin do folderu elementów znormalizowanych.
    [98.00.01- Kratownica (nie dokonczone).SLDDRW, 98.00.01- Kratownica.SLDASM, 98.01.00-profil(1749.2mm).SLDDRW, 98.02.00-profil(2150.8mm).SLDDRW, 98.03.00-profil(434.2mm).SLDDRW, 98.04.00-profil(354.2mm).SLDDRW, 98.05.00-profil(1239.2mm).SLDDRW, 98.06.00-profil(790.2mm).SLDDRW]
2024-03-20 Ostatnia część dokumentacji kratownicy (do weryfikacji)
    Finalna wersja rysunków do pierwszej weryfikacji
    [98.00.01- Kratownica (nie dokonczone).SLDDRW, 98.00.01- Kratownica.SLDASM, Spoina czołowa I.SLDPRT]
2024-03-22 Wspornik - rysunki
    Rysunki wykonawcze i spawalnicze do wspornika
    [PUT_SD_SP_011_00a.SLDDRW, PUT_SD_SP_011_00b.SLDDRW, PUT_SD_SP_011_01.SLDDRW, PUT_SD_SP_011_02.SLDDRW, PUT_SD_SP_011_03.SLDDRW]
2024-05-02 Poprawa klatki bezpieczeństwa
    Zmiana wymiarów rurek na takie jakie faktycznie wykorzystano przy produkcji klatek
    [02-00-01 - Klatka Bezpieczenstwa test.SLDASM, 02-01-00 - Klatka Bezpieczenstwa test.SLDPRT]
2024-05-25 Poprawa ramy podwozia
    dodanie otworów, profili i wiązań w złóżeniu i ogólne małe poprawki
    [00-00-01 (rama podwozia v2).SLDASM, 00-00-02- Wachacz lewy.SLDASM, 00-00-02- Wachacz prawy.SLDASM, 00-01-00-profile 60x30x3.SLDPRT, 00-04-00- Profile 30x30x3.SLDPRT, 00-05-00- laminowane płyty mdf.SLDPRT, 00-06-00- Blacha 5mm.SLDPRT, 00-07-00- Blacha 10mm.SLDPRT]
2024-05-26 Rysunki profili
    Rysunki profili do cięcia na ramę podwozia v2
    [00-00-01 (rama podwozia v2) POGLĄDOWA ZŁOŻENIÓWKA.SLDDRW, 00-00-01 (rama podwozia v2).SLDASM, 00-01-00-profile 60x30x3 Angled-1.SLDDRW, 00-01-00-profile 60x30x3 Angled-2.SLDDRW, 00-01-00-profile 60x30x3 Short-back.SLDDRW, 00-01-00-profile 60x30x3 Short-front.SLDDRW, 00-01-00-profile 60x30x3 long.SLDDRW, 00-01-00-profile 60x30x3 transverse.SLDDRW]
2024-08-08 Rysunki blach
    Dodanie rysunków blach dla jacka
    [00-00-01 (rama podwozia v2) POGLĄDOWA ZŁOŻENIÓWKA.SLDDRW, 00-00-01 (rama podwozia v2) wymiary do spawania.SLDDRW, 00-01-00-profile 60x30x3 Angled-1.SLDDRW, 00-06-00- Blacha 5mm S.SLDDRW, 00-07-00- Blacha 10mm KT.SLDDRW, 00-07-00- Blacha 10mm WT.SLDDRW]
2025-03-05 Usunięcie plików
    Rower Sebastian z Mastera
    [Kierownica.SLDPRT, Koło przód.SLDPRT, Koło tył.SLDPRT, Pedał Pedał.SLDPRT, Pedał.SLDPRT, Pin.SLDPRT, Rama.SLDPRT, Siodełko.SLDPRT]
2025-05-25 aktualizacja rama zwrotnice
    piasta rama zwrotnice
    [ESM_Rama_04.SLDPRT, Os_Przod_Ceownik.SLDPRT, Zwrotnica.SLDPRT, Zwrotnica_Os.SLDPRT, Zwrotnica_Zlozenie.SLDASM, piasta koła_esm.SLDPRT]
